Genturi/NewAlphaElectrical/README.md

# Alpha-Electrical
 Electronic hardware related files for the Alpha instrument
