Genturi/NewAlphaElectrical/NotesOnRev_1.docx

1. The package chosen for U1 on the layout is incorrect
2. The silkscreen for D1 is backward
