Genturi/NewAlphaElectrical/Notes/Jukka2_Notes.docx

Power supply: Mean Well: PSC-100B-C; Digi-key: 1866-3902-ND ($44.11)

This will set the
