Genturi/NewAlphaElectrical/EmppuInterface(Moondance 30-0006)/NotesOnRev_1.docx

Notes on Rev 1 of 30-0006

J4 uses the wrong pinout! Harwin connectors are pinned out sequentially on each side. The layout has them pinned out with odd numbers on one side and even numbers on the other side.
