Genturi/NewAlphaElectrical/SystemDesign/AlphaSubSystemEmppu_R1p2p0_101819.pdf

https://thestepperboardstore.com/products/ar-bc6d25eu-series-usb-six-motor-0-15-to-2-5-amp-current-regulating-stepper-motor-controllerhttps://thestepperboardstore.co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

https://www.digikey.com/product-detail/en/amphenol-icc-fci/LD09P13A4GX00LF/609-5183-ND/4997285https://www.digikey.com/product-detail/en/amphenol-icc-fci/LD09P13A4GX0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

https://www.digikey.com/product-detail/en/mean-well-usa-inc/IRM-60-24/1866-3067-ND/7704690

https://www.digikey.com/product-detail/en/mean-well-usa-inc/IRM-60-24/1866-3067-ND/7704690https://www.digikey.com/product-detail/en/mean-well-usa-inc/IRM-60-24/1866-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

https://www.digikey.com/product-detail/en/amphenol-icc-fci/LD09S13A4GX00LF/609-5189-ND/4997291

https://www.digikey.com/product-detail/en/amphenol-icc-fci/LD09S13A4GX00LF/609-5189-ND/4997291https://www.digikey.com/product-detail/en/amphenol-icc-fci/LD09S13A4GX0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

https://www.digikey.com/product-detail/en/amphenol-icc-fci/D15S33E4GX00LF/609-1499-ND/1001813https://www.digikey.com/product-detail/en/amphenol-icc-fci/D15S33E4GX00L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

https://www.digikey.com/product-detail/en/te-connectivity-amp-connectors/5-103635-4/A33864-ND/1122428https://www.digikey.com/product-detail/en/te-connectivity-amp-co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 8
https://www.digikey.com/product-detail/en/te-connectivity-amp-connectors/5-103635-4/A33864-ND/1122428https://www.digikey.com/product-detail/en/te-connectivity-amp-co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

https://www.mccdaq.com/usb-data-acquisition/USB-DIO24-Series.aspxhttps://www.mccdaq.com/usb-data-acquisition/USB-DIO24-Series.aspxhttps://www.mccdaq.com/usb-data-acq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

https://www.digikey.com/product-detail/en/sensata-crydom/DC60S3/CC1126-ND/221844https://www.digikey.com/product-detail/en/sensata-crydom/DC60S3/CC1126-ND/221844https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

http://www.l-com.com/usb-flanged-panel-mounted-usb-20-coupler-shielded-type-b-a-connectorshttp://www.l-com.com/usb-flanged-panel-mounted-usb-20-coupler-shielded-type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

http://www.l-com.com/usb-flanged-panel-mounted-usb-20-coupler-shielded-type-b-a-connectorshttps://www.digikey.com/product-detail/en/orion-fans/OA60EC-UR-1WB/1053-180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

https://www.digikey.com/product-detail/en/te-connectivity-amp-connectors/5-1814400-1/A97593-ND/1755981 81
https://www.digikey.com/product-detail/en/te-connectivity-amp-connectors/5-1814400-1/A97593-ND/1755981https://www.digikey.com/product-detail/en/te-connectivity-amp-c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

https://www.digikey.com/product-detail/en/amphenol-icc-fci/ICD15S13E4GX00LF/609-5181-ND/1536501https://www.digikey.com/product-detail/en/amphenol-icc-fci/ICD15S13E4G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

# Roll

# Pitch

# Yaw

X

Y

# Home

# Home

# Home

# Home

# Home

# 6 Axis Motor Controller Board

BC6D25 (https://thestepperboardstore.com/products/ar-bc6d25eu-series-usb-six-motor-0-15-to-2-5-amp-current-regulating-stepper-motor-controller)

Power Supply (https://www.digikey.com/product-detail/en/tdk-lambda-americas-inc/LS150-15/285-1812-ND/1918823)

# +15VDC @ 10A

D9 (https://www.digikey.com/product-detail/en/amphenol-icc-fci/LD09P13A4GX00LF/609-5183-ND/4997285)

# Conn

AC

# Power Input Module (https://www.digikey.com/products/en?keywords=708-2406-ND)

Power Supply (https://www.digikey.com/product-detail/en/mean-well-usa-inc/IRM-60-24/1866-3067-ND/7704690)

# +24 VDC @ 2A

USB-B (http://www.l-com.com/usb-flanged-panel-mounted-usb-20-coupler-shielded-type-b-a-connectors)

D-9 (https://www.digikey.com/product-detail/en/amphenol-icc-fci/LD09S13A4GX00LF/609-5189-ND/4997291)
RS-232

Nano-Positioning (https://www.digikey.com/product-detail/en/amphenol-icc-fci/LD09P13A4GX00LF/609-5183-ND/4997285)
Stage (DOF-5) (https://dovermotion.com/products/linear-stages/microscope-stages/objective-focusing-stage-dof-5/)

# Solenoid valve for cover lifter

# Cover Limit 1

# Cover Limit 2

# Cartridge Present

D15 (https://www.digikey.com/product-detail/en/amphenol-icc-fci/D15S33E4GX00LF/609-1499-ND/1001813)

# Conn

Power Supply (https://www.digikey.com/product-detail/en/mean-well-usa-inc/IRM-05-5/1866-3027-ND/7704652)

# +5 VDC @ 1A

# Ampmodu

MTE (https://www.digikey.com/product-detail/en/te-connectivity-amp-connectors/5-103635-4/A33864-ND/1122428) | Polygon Index (https://www.digikey.com/product-detail/en/te-connectivity-amp-connectors/5-103635-4/A33864-ND/1122428)

# USB-DIO24 (https://www.mccdaq.com/usb-data-acquisition/USB-DIO24-Series.aspx) Digital I/O

# Temperature Controller CN8DPt-224 (https://www.omega.com/en-us/search/?text=CN8DPT-224-C24-DC)

Power Supply (https://www.digikey.com/product-detail/en/tdk-lambda-americas-inc/LS50-24/285-1820-ND/1918831)

# 24 VDC

@ 2A

# Solid-State Relay (https://www.digikey.com/product-detail/en/sensata-crydom/DC60S3/CC1126-ND/221844)

# Panel mount Connector

# Panel mount Connector

USB-B (http://www.l-com.com/usb-flanged-panel-mounted-usb-20-coupler-shielded-type-b-a-connectors)

# Genturi Scanner Alpha

# Subsystem Emppu

# Rev 1.2.0

# Eric J. Schultz 10/18/2019

# Cartridge Heater

# Thermistor

Fan (https://www.digikey.com/product-detail/en/orion-fans/OA60EC-UR-1WB/1053-1809-ND/9380228)

SMA (https://www.digikey.com/product-detail/en/te-connectivity-amp-connectors/5-1814400-1/A97593-ND/1755981)

# Conn Polygon Index

D15m (https://www.digikey.com/product-detail/en/amphenol-icc-fci/ICD15S13E4GX00LF/609-5181-ND/1536501)

# Conn Ctrl Status

# To Troy

# 3-Stage Line

Filter (https://www.digikey.com/product-detail/en/schurter-inc/5500.2048/486-6367-ND/642780)

D-50 (https://www.digikey.com/product-detail/en/amphenol-icc-commercial-products/L77SDD50SC309/L77SDD50SC309-ND/4888745)
Connector (https://thestepperboardstore.com/products/ar-bc6d25eu-series-usb-six-motor-0-15-to-2-5-amp-current-regulating-stepper-motor-controller)

Motor (https://www.digikey.com/product-detail/en/amphenol-icc-commercial-products/L77SDD50SC309/L77SDD50SC309-ND/4888745)

# Interface Board

# Precision High-speed Comparator

# Drive & Interface
