Genturi/NewAlphaElectrical/SystemDesign/AlphaSubSystemEmppu_R1p5p0_110119.pdf

https://thestepperboardstore.com/products/ar-bc6d25eu-series-usb-six-motor-0-15-to-2-5-amp-current-regulating-stepper-motor-controllerhttps://thestepperboardstore.co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

https://www.digikey.com/products/en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

https://www.digikey.com/product-detail/en/mean-well-usa-inc/IRM-60-24/1866-3067-ND/7704690https://www.digikey.com/product-detail/en/mean-well-usa-inc/IRM-60-24/1866-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

https://www.digikey.com/product-detail/en/amphenol-icc-fci/D15S33E4GX00LF/609-1499-ND/1001813https://www.digikey.com/product-detail/en/amphenol-icc-fci/D15S33E4GX00L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

https://www.digikey.com/product-detail/en/te-connectivity-amp-connectors/5-103635-4/A33864-ND/1122428https://www.digikey.com/product-detail/en/te-connectivity-amp-co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

https://www.digikey.com/product-detail/en/sensata-crydom/DC60S3/CC1126-ND/221844https://www.digikey.com/product-detail/en/sensata-crydom/DC60S3/CC1126-ND/221844https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

https://www.digikey.com/product-detail/en/norcomp-inc/171-009-203L001/209FE-ND/858108https://www.digikey.com/product-detail/en/norcomp-inc/171-009-203L001/209FE-ND/8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

https://www.digikey.com/product-detail/en/te-connectivity-amp-connectors/5-1814400-1/A97593-ND/1755981https://www.digikey.com/product-detail/en/te-connectivity-amp-c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

https://www.digikey.com/product-detail/en/amphenol-icc-fci/ICD15S13E4GX00LF/609-5181-ND/1536501https://www.digikey.com/product-detail/en/amphenol-icc-fci/ICD15S13E4G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

https://www.digikey.com/product-detail/en/b-b-smartworx-inc/BB-USBHUB4OEM/1165-1059-ND/3045945https://www.digikey.com/product-detail/en/b-b-smartworx-inc/BB-USBHUB4O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

https://www.digikey.com/products/en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

https://www.digikey.com/products/en?keywords=DB9-USB-D5-F (https://www.digikey.com/product-detail/en/mean-well-usa-inc/IRM-05-5/1866-3027-ND/7704652) https://www.digikey.com/products/en?keywords=DB9-USB-D5-F (https://www.digikey.com/product-detail/en/mean-well-usa-inc/IRM-05-5/1866-3027-ND/7704652) https://www.digikey.com/products/en?keywords=DB9-USB-D5-F (https://www.digikey.com/product-detail/en/mean-well-usa-inc/IRM-05-5/1866-3027-ND/7704652) https://www.digikey.com/products/en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 (https://www.digikey.com/product-detail/en/mean-well-usa-inc/IRM-05-5/1866-3027-ND/7704652) https://www.digikey.com/products/en?keywords=DB9-USB-D5-F (https://www.digikey.com/product-detail/en/mean-well-usa-inc/IRM-05-5/1866-3027-ND/7704652) https://www.digikey.com/products/en?keywords=DB9-USB-D5-F (https://www.digikey.com/product-detail/en/mean-well-usa-inc/IRM-05-5/1866-3027-ND/7704652) https://www.digikey.com/products/en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

https://www.digikey.com/product-detail/en/norcomp-inc/173-E50-213R141/173-150FEA-ND/955555https://www.digikey.com/product-detail/en/norcomp-inc/173-E50-213R141/173-1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

# Roll

# Pitch

# Yaw

X

Y

# Home

# Home

# Home

# Home

# Home

# 6 Axis Motor Controller Board

BC6D25 (https://thestepperboardstore.com/products/ar-bc6d25eu-series-usb-six-motor-0-15-to-2-5-amp-current-regulating-stepper-motor-controller)

Power Supply (https://www.digikey.com/product-detail/en/tdk-lambda-americas-inc/LS150-15/285-1812-ND/1918823)

# +15VDC @ 10A

# 16pin (https://www.digikey.com/products/en?keywords=G125-MH11605L7P) Conn

AC

# Power Input Module (https://www.digikey.com/products/en?keywords=708-2406-ND)

Power Supply (https://www.digikey.com/product-detail/en/mean-well-usa-inc/IRM-60-24/1866-3067-ND/7704690)

# +24 VDC @ 2A

# Nano-Positioning (https://www.digikey.com/products/en?keywords=G125-MH11605L7P)

Stage (DOF-5) (https://dovermotion.com/products/linear-stages/microscope-stages/objective-focusing-stage-dof-5/) | Solenoid
valve | for

# cover lifter

Cylinder (https://www.digikey.com/product-detail/en/amphenol-icc-fci/D15S33E4GX00LF/609-1499-ND/1001813) Limit 1

# Cylinder Limit 2

# Cartridge Present

D15 (https://www.digikey.com/product-detail/en/amphenol-icc-fci/D15S33E4GX00LF/609-1499-ND/1001813)

# Conn

Power Supply (https://www.digikey.com/product-detail/en/mean-well-usa-inc/IRM-05-5/1866-3027-ND/7704652)

# +5 VDC @ 1A

# Ampmodu

MTE (https://www.digikey.com/product-detail/en/te-connectivity-amp-connectors/5-103635-4/A33864-ND/1122428) | Polygon Index (https://www.digikey.com/product-detail/en/te-connectivity-amp-connectors/5-103635-4/A33864-ND/1122428)

# USB-DIO24 (https://www.mccdaq.com/usb-data-acquisition/USB-DIO24-Series.aspx) Digital I/O

# Temperature Controller CN8DPt-224 (https://www.omega.com/en-us/search/?text=CN8DPT-224-C24-DC)

Power Supply (https://www.digikey.com/product-detail/en/tdk-lambda-americas-inc/LS50-24/285-1820-ND/1918831)

# 24 VDC

@ 2A

# Solid-State Relay (https://www.digikey.com/product-detail/en/sensata-crydom/DC60S3/CC1126-ND/221844)

D-9 (https://www.digikey.com/product-detail/en/norcomp-inc/171-009-203L001/209FE-ND/858108)

# Connector

J2

Genturi | Scanner | Alpha

# Subsystem Emppu

| Rev 1.5.0
Eric J. Schultz | 11/01/2019

# Thermistor

Fan (https://www.digikey.com/product-detail/en/orion-fans/OA60EC-UR-1WB/1053-1809-ND/9380228)

SMA (https://www.digikey.com/product-detail/en/te-connectivity-amp-connectors/5-1814400-1/A97593-ND/1755981)

# Conn Polygon Index

D15m (https://www.digikey.com/product-detail/en/amphenol-icc-fci/ICD15S13E4GX00LF/609-5181-ND/1536501)

# Conn Ctrl Status

# To Troy

# 3-Stage Line

Filter (https://www.digikey.com/product-detail/en/schurter-inc/5500.2048/486-6367-ND/642780)

D-37 (https://www.digikey.com/product-detail/en/norcomp-inc/171-037-203L001/237FE-ND/858162)

# Connector

J1

# Motor Interface Board

# Precision High-speed Comparator

# Drive & Interface

# USB Bulkhead

Hub (https://www.digikey.com/product-detail/en/b-b-smartworx-inc/BB-USBHUB4OEM/1165-1059-ND/3045945)

# USB to RS-232 (https://www.digikey.com/products/en?keywords=DB9-USB-D5-F)

# Cartridge Heater Assy

# Heater

# Air Cylinder Limit Sensors

# Solenoid drive

# Cartridge Present Sensor

D-50
Connector (https://www.digikey.com/product-detail/en/norcomp-inc/173-E50-213R141/173-150FEA-ND/955555)

USB-B (http://www.l-com.com/usb-flanged-panel-mounted-usb-20-coupler-shielded-type-b-a-connectors)
