Genturi/NewAlphaElectrical/SystemDesign/AlphaSubsystemJukka_R1p0p0_092719.pdf

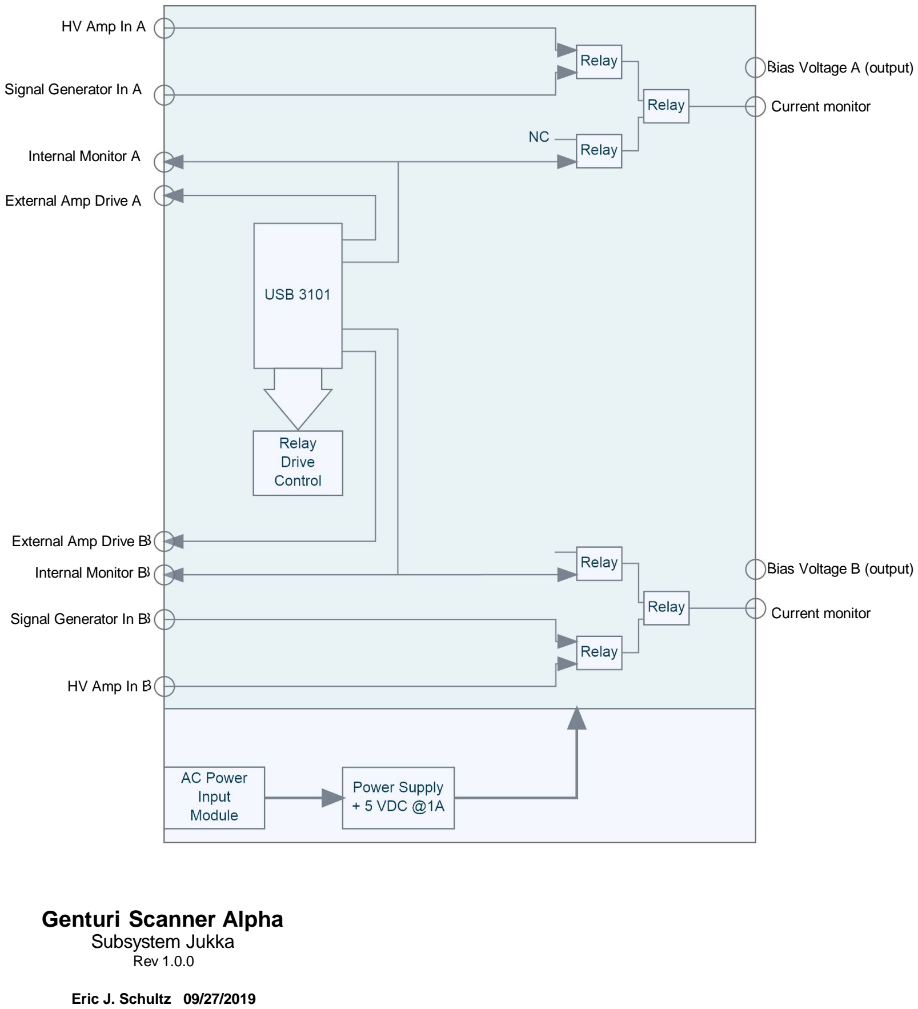
[picture p2: page 1]

USB 3101

Relay

Relay

Relay

Current monitor

Bias Voltage A (output)

Relay

Relay

Relay

Current monitor

Bias Voltage B (output)

Relay
Drive
Control

Power Supply
+ 5 VDC @1A

AC Power
Input
Module

External Amp Drive A

Internal Monitor A

Signal Generator In A

HV Amp In A

NC

External Amp Drive B

Internal Monitor B

Signal Generator In B

HV Amp In B

## Genturi Scanner Alpha

### Subsystem Jukka

Rev 1.0.0

Eric J. Schultz 09/27/2019
