Genturi/NewAlphaElectrical/SystemDesign/AlphaSubsystemJukka_R1p2p0_192219.pdf

https://www.mccdaq.com/usb-data-acquisition/USB-3100-Series.aspxhttps://www.mccdaq.com/usb-data-acquisition/USB-3100-Series.aspxhttps://www.mccdaq.com/usb-data-acqui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 5979 5979 5979 5979 5979 5979 5979 5979 5979 5979 5979 5979 5979 5979 5979 5979 5979 5979 5979 5979 5979 5979 5979 5979 5979 5979 5979 5979 5979 5979 5979 5979 5979 5979 5979 5979 5979 5979 5979 5979 5979 5979

https://www.digikey.com/product-detail/en/omron-electronics-inc-emc-div/G6E-134P-US-DC5/Z3668-ND/181 5979 5979 5979 5979 5979 5979 5979 5979 5979 5979 5979 5979 5979 5979 5979 5979 5979 5979 5979 5979 5979 5979 5979 5979 5979 5979 5979 5979 5979 5979 5979 5979 5979 5979 5979 5979 5979 5979 5979 5979 5979 5979 https://www.digikey.com/product-detail/en/omron-electronics-inc-emc-div/G6E-134P-US-DC5/Z3668-ND/181 5979 5979 5979 5979 5979 5979 5979 5979 5979 5979 5979 5979 5979 5979 5979 5979 5979 5979 5979 5979 5979 5979 5979 5979 5979 5979 5979 5979 5979 5979 5979 5979 5979 5979 5979 5979 5979 5979 5979 5979 5979 5979

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

https://www.digikey.com/product-detail/en/omron-electronics-inc-emc-div/G6E-134P-US-DC5/Z3668-ND/181 5979 5979 5979 5979 5979 5979 5979 5979 5979 5979 5979 5979 5979 5979 5979 5979 5979 5979 5979 5979 5979 5979 5979 5979 5979 5979 5979 5979 5979 5979 5979 5979 5979 5979 5979 5979 5979 5979 5979 5979 5979 5979

https://www.digikey.com/product-detail/en/omron-electronics-inc-emc-div/G6E-134P-US-DC5/Z3668-ND/181 5979 5979 5979 5979 5979 5979 5979 5979 5979 5979 5979 5979 5979 5979 5979 5979 5979 5979 5979 5979 5979 5979 5979 5979 5979 5979 5979 5979 5979 5979 5979 5979 5979 5979 5979 5979 5979 5979 5979 5979 5979 5979 https://www.digikey.com/product-detail/en/omron-electronics-inc-emc-div/G6E-134P-US-DC5/Z3668-ND/181 5979 5979 5979 5979 5979 5979 5979 5979 5979 5979 5979 5979 5979 5979 5979 5979 5979 5979 5979 5979 5979 5979 5979 5979 5979 5979 5979 5979 5979 5979 5979 5979 5979 5979 5979 5979 5979 5979 5979 5979 5979 5979

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

https://www.digikey.com/product-detail/en/cui-inc/PSK-S5B-5-T/102-5182-ND/9817114https://www.digikey.com/product-detail/en/cui-inc/PSK-S5B-5-T/102-5182-ND/9817114htt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

# USB 3101 (https://www.mccdaq.com/usb-data-acquisition/USB-3100-Series.aspx)

# Relay

# Relay

Relay (https://www.digikey.com/product-detail/en/omron-electronics-inc-emc-div/G6E-134P-US-DC5/Z3668-ND/1815979)

# Current monitor

Bias Voltage A (output) (https://www.digikey.com/product-detail/en/te-connectivity-amp-connectors/5-1814400-1/A97593-ND/1755981)

# Relay

# Relay

Relay (https://www.digikey.com/product-detail/en/omron-electronics-inc-emc-div/G6E-134P-US-DC5/Z3668-ND/1815979)

# Current monitor

Bias Voltage B (output) (https://www.digikey.com/product-detail/en/te-connectivity-amp-connectors/5-1814400-1/A97593-ND/1755981)

# Relay Drive Control

# Power Supply + 5 VDC @1A

# AC Power Input Module

# External Amp Drive A

# Internal Monitor A

# Signal Generator In A

# HV Amp In A

NC

# External Amp Drive B

# Internal Monitor B

# Signal Generator In B

# HV Amp In B

# Genturi Scanner Alpha

# Subsystem Jukka

# Rev 1.2.0

# Eric J. Schultz 10/22/2019

# USB Conn
