Genturi/NewAlphaElectrical/SystemDesign/AlphaSubsystemJukka_R1p4p0_112019.pdf

https://www.mccdaq.com/usb-data-acquisition/USB-3100-Series.aspxhttps://www.mccdaq.com/usb-data-acquisition/USB-3100-Series.aspxhttps://www.mccdaq.com/usb-data-acqui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 5979 5979 5979 5979 5979 5979 5979 5979 5979 5979 5979 5979 5979 5979 5979 5979 5979 5979 5979 5979 5979 5979 5979 5979 5979 5979 5979 5979 5979 5979 5979 5979 5979 5979 5979 5979 5979 5979 5979 5979 5979 5979

https://www.digikey.com/product-detail/en/omron-electronics-inc-emc-div/G6E-134P-US-DC5/Z3668-ND/181 5979 5979 5979 5979 5979 5979 5979 5979 5979 5979 5979 5979 5979 5979 5979 5979 5979 5979 5979 5979 5979 5979 5979 5979 5979 5979 5979 5979 5979 5979 5979 5979 5979 5979 5979 5979 5979 5979 5979 5979 5979 5979 Relay

| https://www.digikey.com/product-detail/en/omron-electronics-inc-emc-div/G6E-134P-US-DC5/Z3668-ND/181 5979 5979 5979 5979 5979 5979 5979 5979 5979 5979 5979 5979 5979 5979 5979 5979 5979 5979 5979 5979 5979 5979 5979 5979 5979 5979 5979 5979 5979 5979 5979 5979 5979 5979 5979 5979 5979 5979 5979 5979 5979 5979 Relay (https://www.digikey.com/product-detail/en/omron-electronics-inc-emc-div/G6E-134P-US-DC5/Z3668-ND/1815979)

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
| h t t p s : / / w w w . d i g i k | e | y | . | c | o | m / | p | r o d u c t - d e t a i l / e n / | m o | l | e | x | / | 0 | 0 | 2 2 0 5 3 0 4 1 / W M 4 3 0 2 - N | D | / | 2 | 6 | 6 | 9 | 3
| h t t p s : / / w w w . d i g i k | e | y | . | c | o | m / | p | r o d u c t - d e t a i l / e n / | m o | l | e | x | / | 0 | 0 | 2 2 0 5 3 0 4 1 / W M 4 3 0 2 - N | D | / | 2 | 6 | 6 | 9 | 3
| h t t p s : / / w w w . d i g i k | e | y | . | c | o | m / | p | r o d u c t - d e t a i l / e n / | m o | l | e | x | / | 0 | 0 | 2 2 0 5 3 0 4 1 / W M 4 3 0 2 - N | D | / | 2 | 6 | 6 | 9 | 3
| h t t p s : / / w w w . d i g i k | e | y | . | c | o | m / | p | r o d u c t - d e t a i l / e n / | m o | l | e | x | / | 0 | 0 | 2 2 0 5 3 0 4 1 / W M 4 3 0 2 - N | D | / | 2 | 6 | 6 | 9 | 3
| h t t p s : / / w w w . d i g i k | e | y | . | c | o | m / | p | r o d u c t - d e t a i l / e n / | m o | l | e | x | / | 0 | 0 | 2 2 0 5 3 0 4 1 / W M 4 3 0 2 - N | D | / | 2 | 6 | 6 | 9 | 3
| h t t p s : / / w w w . d i g i k | e | y | . | c | o | m / | p | r o d u c t - d e t a i l / e n / | m o | l | e | x | / | 0 | 0 | 2 2 0 5 3 0 4 1 / W M 4 3 0 2 - N | D | / | 2 | 6 | 6 | 9 | 3
| h t t p s : / / w w w . d i g i k | e | y | . | c | o | m / | p | r o d u c t - d e t a i l / e n / | m o | l | e | x | / | 0 | 0 | 2 2 0 5 3 0 4 1 / W M 4 3 0 2 - N | D | / | 2 | 6 | 6 | 9 | 3
| h t t p s : / / w w w . d i g i k | e | y | . | c | o | m / | p | r o d u c t - d e t a i l / e n / | m o | l | e | x | / | 0 | 0 | 2 2 0 5 3 0 4 1 / W M 4 3 0 2 - N | D | / | 2 | 6 | 6 | 9 | 3
| h t t p s : / / w w w . d i g i k | e | y | . | c | o | m / | p | r o d u c t - d e t a i l / e n / | m o | l | e | x | / | 0 | 0 | 2 2 0 5 3 0 4 1 / W M 4 3 0 2 - N | D | / | 2 | 6 | 6 | 9 | 3

# USB 3101 (https://www.mccdaq.com/usb-data-acquisition/USB-3100-Series.aspx)

# Relay

Relay (https://www.digikey.com/product-detail/en/omron-electronics-inc-emc-div/G6E-134P-US-DC5/Z3668-ND/1815979)

# Current monitor

Bias Voltage A (output) (https://www.digikey.com/product-detail/en/te-connectivity-amp-connectors/5-1814400-1/A97593-ND/1755981)

# Relay Current monitor

Bias Voltage B (output) (https://www.digikey.com/product-detail/en/te-connectivity-amp-connectors/5-1814400-1/A97593-ND/1755981)

# Relay Drive Control

# Power Supply + 5 VDC @1A

# AC Power Input Module

# External Amp Drive A

# Internal Monitor A

# Signal Generator In A

# HV Amp In A

NC

# External Amp Drive B

# Internal Monitor B

# Signal Generator In B

# HV Amp In B

Genturi | Scanner Alpha
Subsystem | Jukka

# Rev 1.4.0

# Eric J. Schultz 11/20/2019

# USB Conn

Micro-fit 3.0 | 4-Pos KK
