Genturi/NewAlphaElectrical/SystemDesign/AlphaSubsystemMarco_R1p1p0_102119.pdf

https://www.mccdaq.com/usb-data-acquisition/USB-3100-Series.aspx

https://www.mccdaq.com/usb-data-acquisition/USB-3100-Series.aspxhttps://www.mccdaq.com/usb-data-acquisition/USB-3100-Series.aspxhttps://www.mccdaq.com/usb-data-acqui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

https://www.digikey.com/product-detail/en/sl-power-electronics-manufacture-of-condor-ault-brands/HBB15-1.5-A-G/271-2280-ND/1035138https://www.digikey.com/product-det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 15-1.5 (https://www.digikey.com/product-detail/en/sl-power-electronics-manufacture-of-condor-ault-brands/HBB15-1.5-A-G/271-2280-ND/1035138)-A-G/271-2280-ND/1035138 https://www.digikey.com/product-detail/en/sl-power-electronics-manufacture-of-condor-ault-brands/HBB15-1.5-A-G/271-2280-ND/1035138https://www.digikey.com/product-det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

https://www.digikey.com/products/en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

https://www.digikey.com/products/en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

https://www.digikey.com/products/en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

https://www.digikey.com/products/en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

https://www.digikey.com/product-detail/en/amphenol-icc-fci/LD09S33E4GX00LF/609-5193-ND/4997295

https://www.digikey.com/product-detail/en/amphenol-icc-fci/LD09S33E4GX00LF/609-5193-ND/4997295https://www.digikey.com/product-detail/en/amphenol-icc-fci/LD09S33E4GX0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

https://www.digikey.com/product-detail/en/amphenol-icc-fci/LD09S33E4GX00LF/609-5193-ND/4997295https://www.digikey.com/product-detail/en/amphenol-icc-fci/LD09S33E4GX0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

https://www.digikey.com/product-detail/en/amphenol-icc-fci/LD09S33E4GX00LF/609-5193-ND/4997295

https://www.digikey.com/product-detail/en/amphenol-icc-fci/LD09S33E4GX00LF/609-5193-ND/4997295https://www.digikey.com/product-detail/en/amphenol-icc-fci/LD09S33E4GX0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

https://www.digikey.com/product-detail/en/amphenol-icc-fci/LD09S33E4GX00LF/609-5193-ND/4997295https://www.digikey.com/product-detail/en/amphenol-icc-fci/LD09S33E4GX0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 https://www.digikey.com/product-detail/en/amphenol-rf-division/132170/ACX1244-ND/1011921https://www.digikey.com/product-detail/en/amphenol-rf-division/132170/ACX1244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

https://www.digikey.com/product-detail/en/amphenol-rf-division/132170/ACX1244-ND/1011921
https://www.digikey.com/product-detail/en/amphenol-rf-division/132170/ACX1244-ND/1011921
https://www.digikey.com/product-detail/en/amphenol-rf-division/132170/ACX1244-ND/1011921

https://www.femto.de/en/products/current-amplifiers/fixed-gain-up-to-400-mhz-hca.html

https://www.femto.de/en/products/current-amplifiers/fixed-gain-up-to-400-mhz-hca.htmlhttps://www.femto.de/en/products/current-amplifiers/fixed-gain-up-to-400-mhz-hca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

https://www.femto.de/en/products/current-amplifiers/fixed-gain-up-to-400-mhz-hca.htmlhttps://www.femto.de/en/products/current-amplifiers/fixed-gain-up-to-400-mhz-hca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

https://www.femto.de/en/products/current-amplifiers/fixed-gain-up-to-400-mhz-hca.htmlhttps://www.femto.de/en/products/current-amplifiers/fixed-gain-up-to-400-mhz-hca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

https://www.digikey.com/product-detail/en/amphenol-rf-division/132170/ACX1244-ND/1011921https://www.digikey.com/product-detail/en/amphenol-rf-division/132170/ACX1244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 https://www.digikey.com/product-detail/en/amphenol-rf-division/132170/ACX1244-ND/1011921https://www.digikey.com/product-detail/en/amphenol-rf-division/132170/ACX1244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
https://www.digikey.com/product-detail/en/amphenol-rf-division/132170/ACX1244-ND/1011921

https://www.digikey.com/product-detail/en/amphenol-rf-division/132170/ACX1244-ND/1011921
https://www.digikey.com/product-detail/en/amphenol-rf-division/132170/ACX1244-ND/1011921

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

https://www.femto.de/en/products/current-amplifiers/fixed-gain-up-to-400-mhz-hca.htmlhttps://www.femto.de/en/products/current-amplifiers/fixed-gain-up-to-400-mhz-hca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

https://www.digikey.com/product-detail/en/amphenol-rf-division/132170/ACX1244-ND/1011921https://www.digikey.com/product-detail/en/amphenol-rf-division/132170/ACX1244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

http://krfilters.com/filter-docs/3070-SMA.pdfhttps://www.digikey.com/product-detail/en/amphenol-rf-division/132170/ACX1244-ND/1011921https://www.digikey.com/product-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

https://www.femto.de/en/products/current-amplifiers/fixed-gain-up-to-400-mhz-hca.htmlhttps://www.digikey.com/product-detail/en/amphenol-rf-division/132170/ACX1244-ND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

https://www.digikey.com/product-detail/en/amphenol-icc-fci/ICD15S13E4GX00LF/609-5181-ND/1536501https://www.digikey.com/product-detail/en/amphenol-icc-fci/ICD15S13E4G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 tf4lob%252Bxoo8%3D
https://www.mouser.com/ProductDetail/Hirose-Connector/ST60-24P30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

https://www.digikey.com/product-detail/en/te-connectivity-amp-connectors/5-1814400-1/A97593-ND/1755981https://www.digikey.com/product-detail/en/te-connectivity-amp-c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 81
https://www.digikey.com/product-detail/en/te-connectivity-amp-connectors/5-1814400-1/A97593-ND/1755981

https://www.digikey.com/products/en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

https://www.digikey.com/products/en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

http://www.l-com.com/usb-flanged-panel-mounted-usb-20-coupler-shielded-type-b-a-connectorshttp://www.l-com.com/usb-flanged-panel-mounted-usb-20-coupler-shielded-type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

https://www.digikey.com/product-detail/en/schurter-inc/5500.2048/486-6367-ND/642780https://www.digikey.com/product-detail/en/schurter-inc/5500.2048/486-6367-ND/64278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

https://www.digikey.com/product-detail/en/schurter-inc/5500.2048/486-6367-ND/642780https://www.digikey.com/product-detail/en/schurter-inc/5500.2048/486-6367-ND/64278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

# USB-3101 (https://www.mccdaq.com/usb-data-acquisition/USB-3100-Series.aspx) Analog & Digital I/O

# Linear Power Supply 15 VDC @ 1.5A Condor

HBB15-1.5-A+ (https://www.digikey.com/product-detail/en/sl-power-electronics-manufacture-of-condor-ault-brands/HBB15-1.5-A-G/271-2280-ND/1035138)G (https://www.digikey.com/product-detail/en/sl-power-electronics-manufacture-of-condor-ault-brands/HBB15-1.5-A-G/271-2280-ND/1035138)

# Linear Power Supply +5 VDC @ 3A Condor

HB5-3- (https://www.digikey.com/products/en?keywords=HB5-3-OV-A%2BG)O (https://www.digikey.com/products/en?keywords=HB5-3-OV-A%2BG)V-A+ (https://www.digikey.com/products/en?keywords=HB5-3-OV-A%2BG)G (https://www.digikey.com/products/en?keywords=HB5-3-OV-A%2BG)

# 400 MHz Amplifier Femto

H (https://www.femto.de/en/products/current-amplifiers/fixed-gain-up-to-400-mhz-hca.html)C (https://www.femto.de/en/products/current-amplifiers/fixed-gain-up-to-400-mhz-hca.html)A-400M-5K- (https://www.femto.de/en/products/current-amplifiers/fixed-gain-up-to-400-mhz-hca.html)C (https://www.femto.de/en/products/current-amplifiers/fixed-gain-up-to-400-mhz-hca.html)

D9 (https://www.digikey.com/product-detail/en/amphenol-icc-fci/LD09S33E4GX00LF/609-5193-ND/4997295)

# Conn

+5 VD (https://www.digikey.com/product-detail/en/amphenol-icc-fci/LD09S33E4GX00LF/609-5193-ND/4997295)C (https://www.digikey.com/product-detail/en/amphenol-icc-fci/LD09S33E4GX00LF/609-5193-ND/4997295)

# PMT Ctrl

D9 (https://www.digikey.com/product-detail/en/amphenol-icc-fci/LD09S33E4GX00LF/609-5193-ND/4997295)

# Conn

+5 VD (https://www.digikey.com/product-detail/en/amphenol-icc-fci/LD09S33E4GX00LF/609-5193-ND/4997295)C (https://www.digikey.com/product-detail/en/amphenol-icc-fci/LD09S33E4GX00LF/609-5193-ND/4997295)

# PMT Ctrl

D9 (https://www.digikey.com/product-detail/en/amphenol-icc-fci/LD09S33E4GX00LF/609-5193-ND/4997295)

# Conn

+5 VDC (https://www.digikey.com/product-detail/en/amphenol-icc-fci/LD09S33E4GX00LF/609-5193-ND/4997295)

# PMT Ctrl

D9 (https://www.digikey.com/product-detail/en/amphenol-icc-fci/LD09S33E4GX00LF/609-5193-ND/4997295)

# Conn

+5 VD (https://www.digikey.com/product-detail/en/amphenol-icc-fci/LD09S33E4GX00LF/609-5193-ND/4997295)C (https://www.digikey.com/product-detail/en/amphenol-icc-fci/LD09S33E4GX00LF/609-5193-ND/4997295)

# PMT Ctrl

# SMA

Bulkhead (https://www.digikey.com/product-detail/en/amphenol-rf-division/132170/ACX1244-ND/1011921)

# to RG174

SMA to BNC | RG174 to BNC

# 200 MHz (http://krfilters.com/filter-docs/3070-SMA.pdf) Filter

# SMA

Bulkhead (https://www.digikey.com/product-detail/en/amphenol-rf-division/132170/ACX1244-ND/1011921)

# to RG174

SMA to RG174 (https://www.digikey.com/product-detail/en/amphenol-rf-division/132170/ACX1244-ND/1011921) | PMT Ch A (https://www.digikey.com/product-detail/en/amphenol-rf-division/132170/ACX1244-ND/1011921)

# 15 VDC

# 400 MHz Amplifier Femto

H (https://www.femto.de/en/products/current-amplifiers/fixed-gain-up-to-400-mhz-hca.html)C (https://www.femto.de/en/products/current-amplifiers/fixed-gain-up-to-400-mhz-hca.html)A-400M-5K- (https://www.femto.de/en/products/current-amplifiers/fixed-gain-up-to-400-mhz-hca.html)C (https://www.femto.de/en/products/current-amplifiers/fixed-gain-up-to-400-mhz-hca.html)

# SMA

Bulkhead (https://www.digikey.com/product-detail/en/amphenol-rf-division/132170/ACX1244-ND/1011921)

# to RG174

SMA to BNC | RG174 to BNC

# 200 MHz (http://krfilters.com/filter-docs/3070-SMA.pdf) Filter

# SMA

Bulkhead (https://www.digikey.com/product-detail/en/amphenol-rf-division/132170/ACX1244-ND/1011921)

# to RG174

SMA to RG174 (https://www.digikey.com/product-detail/en/amphenol-rf-division/132170/ACX1244-ND/1011921) | PMT Ch B (https://www.digikey.com/product-detail/en/amphenol-rf-division/132170/ACX1244-ND/1011921)

# 15 VDC

# 400 MHz Amplifier Femto

HCA-400M-5K-C (https://www.femto.de/en/products/current-amplifiers/fixed-gain-up-to-400-mhz-hca.html)

# SMA

Bulkhead (https://www.digikey.com/product-detail/en/amphenol-rf-division/132170/ACX1244-ND/1011921)

# to RG174

SMA to BNC | RG174 to BNC

# 200 MHz (http://krfilters.com/filter-docs/3070-SMA.pdf) Filter

# SMA

Bulkhead (https://www.digikey.com/product-detail/en/amphenol-rf-division/132170/ACX1244-ND/1011921)

# to RG174

S (https://www.digikey.com/product-detail/en/amphenol-rf-division/132170/ACX1244-ND/1011921)MA to RG174 (https://www.digikey.com/product-detail/en/amphenol-rf-division/132170/ACX1244-ND/1011921) | PMT Ch C (https://www.digikey.com/product-detail/en/amphenol-rf-division/132170/ACX1244-ND/1011921)

# 15 VDC

# 400 MHz Amplifier Femto

H (https://www.femto.de/en/products/current-amplifiers/fixed-gain-up-to-400-mhz-hca.html)C (https://www.femto.de/en/products/current-amplifiers/fixed-gain-up-to-400-mhz-hca.html)A-400M-5K- (https://www.femto.de/en/products/current-amplifiers/fixed-gain-up-to-400-mhz-hca.html)C (https://www.femto.de/en/products/current-amplifiers/fixed-gain-up-to-400-mhz-hca.html)

# SMA

Bulkhead (https://www.digikey.com/product-detail/en/amphenol-rf-division/132170/ACX1244-ND/1011921)

# to RG174

SMA to BNC | RG174 to BNC 200 MHz

# Filter

# SMA

Bulkhead (https://www.digikey.com/product-detail/en/amphenol-rf-division/132170/ACX1244-ND/1011921)

# to RG174

SMA to RG174 (https://www.digikey.com/product-detail/en/amphenol-rf-division/132170/ACX1244-ND/1011921) | PMT Ch D (https://www.digikey.com/product-detail/en/amphenol-rf-division/132170/ACX1244-ND/1011921)

# 15 VDC

# Hybrid Bulkhead Conn

# 200 MHz

Filter? | SOS

# Hybrid Bulkhead Conn

# 200 MHz

Filter? | Ronchi Rule

D15 (https://www.digikey.com/product-detail/en/amphenol-icc-fci/ICD15S13E4GX00LF/609-5181-ND/1536501)

# Con

# HiRose

S (https://www.mouser.com/ProductDetail/Hirose-Connector/ST60-24P30)T-60-24 (https://www.mouser.com/ProductDetail/Hirose-Connector/ST60-24P30)

# Polygon Clock

# FPGA Trigger

# SOS

# Ronchi Rule

# Precision high-speed comparators

Level (https://www.digikey.com/product-detail/en/amphenol-icc-fci/ICD15S13E4GX00LF/609-5181-ND/1536501)

# shifter & Driver

# Polygon Index

Scanner Sync.

S (https://www.digikey.com/product-detail/en/te-connectivity-amp-connectors/5-1814400-1/A97593-ND/1755981)MA (https://www.digikey.com/product-detail/en/te-connectivity-amp-connectors/5-1814400-1/A97593-ND/1755981)

# Con Polygon Index

AC

# Power Input Module

# USB-B

# Voltage limit

&

# filter

# Filtering

# 15 VDC Amp Power

# Genturi Scanner Alpha

# Subsystem Marco

# Rev 1.1.0

# Eric J. Schultz 10/21/2019

2.5V

# Power

# 3-Stage Line Filter
