Genturi/NewAlphaElectrical/SystemDesign/AlphaSubsystemMarco_R1p3p0_112119.pdf

https://www.mccdaq.com/usb-data-acquisition/USB-3100-Series.aspxhttps://www.mccdaq.com/usb-data-acquisition/USB-3100-Series.aspxhttps://www.mccdaq.com/usb-data-acqui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

https://www.digikey.com/product-detail/en/amphenol-icc-fci/LD09S33E4GX00LF/609-5193-ND/4997295https://www.digikey.com/product-detail/en/amphenol-icc-fci/LD09S33E4GX0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

https://www.digikey.com/product-detail/en/amphenol-icc-fci/LD09S33E4GX00LF/609-5193-ND/4997295https://www.digikey.com/product-detail/en/amphenol-icc-fci/LD09S33E4GX0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

https://www.digikey.com/product-detail/en/amphenol-icc-fci/LD09S33E4GX00LF/609-5193-ND/4997295https://www.digikey.com/product-detail/en/amphenol-icc-fci/LD09S33E4GX0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

https://www.femto.de/en/products/current-amplifiers/fixed-gain-up-to-400-mhz-hca.htmlhttps://www.femto.de/en/products/current-amplifiers/fixed-gain-up-to-400-mhz-hca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
https://www.digikey.com/product-detail/en/amphenol-rf-division/132170/ACX1244-ND/1011921 | http://krfilters.com/filter-docs/3070-SMA.pdf
https://www.digikey.com/product-detail/en/amphenol-rf-division/132170/ACX1244-ND/1011921https://www.digikey.com/product-detail/en/amphenol-rf-division/132170/ACX1244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

https://www.digikey.com/products/en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

https://www.digikey.com/products/en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

https://www.digikey.com/product-detail/en/te-connectivity-amp-connectors/5-1814400-1/A97593-ND/1755981https://www.digikey.com/product-detail/en/te-connectivity-amp-c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

https://www.digikey.com/products/en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

# USB-3101 (https://www.mccdaq.com/usb-data-acquisition/USB-3100-Series.aspx) Analog & Digital I/O

# Linear

Power | Supply
15 VDC | @ 1.5A

# Condor

HBB15-1.5-A+G (https://www.digikey.com/product-detail/en/sl-power-electronics-manufacture-of-condor-ault-brands/HBB15-1.5-A-G/271-2280-ND/1035138)

# Linear

Power | Supply
+5 | VDC | @ 3A

# Condor HB5-3-OV-A+G (https://www.digikey.com/products/en?keywords=HB5-3-OV-A%2BG)

# 400 MHz Amplifier Femto

HCA-400M-5K-C (https://www.femto.de/en/products/current-amplifiers/fixed-gain-up-to-400-mhz-hca.html)

D9 (https://www.digikey.com/product-detail/en/amphenol-icc-fci/LD09S33E4GX00LF/609-5193-ND/4997295)

# Conn

+5 VDC (https://www.digikey.com/product-detail/en/amphenol-icc-fci/LD09S33E4GX00LF/609-5193-ND/4997295)

# PMT Ctrl

D9 (https://www.digikey.com/product-detail/en/amphenol-icc-fci/LD09S33E4GX00LF/609-5193-ND/4997295)

# Conn

+5 VDC (https://www.digikey.com/product-detail/en/amphenol-icc-fci/LD09S33E4GX00LF/609-5193-ND/4997295)

# PMT Ctrl

D9 (https://www.digikey.com/product-detail/en/amphenol-icc-fci/LD09S33E4GX00LF/609-5193-ND/4997295)

# Conn

+5 VDC (https://www.digikey.com/product-detail/en/amphenol-icc-fci/LD09S33E4GX00LF/609-5193-ND/4997295)

# PMT Ctrl

D9 (https://www.digikey.com/product-detail/en/amphenol-icc-fci/LD09S33E4GX00LF/609-5193-ND/4997295)

# Conn

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

# PMT Ctrl

# SMA

Bulkhead (https://www.digikey.com/product-detail/en/amphenol-rf-division/132170/ACX1244-ND/1011921)

# to RG174

SMA to | BNC | RG174 | to BNC
200 | MHz (http://krfilters.com/filter-docs/3070-SMA.pdf)

# Filter

# SMA

Bulkhead (https://www.digikey.com/product-detail/en/amphenol-rf-division/132170/ACX1244-ND/1011921)

# to RG174

SMA to | RG174 (https://www.digikey.com/product-detail/en/amphenol-rf-division/132170/ACX1244-ND/1011921) | PMT Ch A (https://www.digikey.com/product-detail/en/amphenol-rf-division/132170/ACX1244-ND/1011921)

# 15 VDC

# 400 MHz Amplifier Femto

HCA-400M-5K-C (https://www.femto.de/en/products/current-amplifiers/fixed-gain-up-to-400-mhz-hca.html)

# SMA

Bulkhead (https://www.digikey.com/product-detail/en/amphenol-rf-division/132170/ACX1244-ND/1011921)

# to RG174

SMA to | BNC | RG174 | to BNC
200 | MHz (http://krfilters.com/filter-docs/3070-SMA.pdf)

# Filter

# SMA

Bulkhead (https://www.digikey.com/product-detail/en/amphenol-rf-division/132170/ACX1244-ND/1011921)
to | RG174
SMA to | RG174 (https://www.digikey.com/product-detail/en/amphenol-rf-division/132170/ACX1244-ND/1011921) | PMT Ch B (https://www.digikey.com/product-detail/en/amphenol-rf-division/132170/ACX1244-ND/1011921)

# 15 VDC

# 400 MHz Amplifier Femto

HCA-400M-5K-C (https://www.femto.de/en/products/current-amplifiers/fixed-gain-up-to-400-mhz-hca.html)

# SMA

Bulkhead (https://www.digikey.com/product-detail/en/amphenol-rf-division/132170/ACX1244-ND/1011921)
to | RG174
SMA to | BNC | RG174 | to BNC
200 | MHz (http://krfilters.com/filter-docs/3070-SMA.pdf)

# Filter

# SMA

Bulkhead (https://www.digikey.com/product-detail/en/amphenol-rf-division/132170/ACX1244-ND/1011921)

# to RG174

SMA to | RG174 (https://www.digikey.com/product-detail/en/amphenol-rf-division/132170/ACX1244-ND/1011921) | PMT Ch C (https://www.digikey.com/product-detail/en/amphenol-rf-division/132170/ACX1244-ND/1011921)

# 15 VDC

# 400 MHz Amplifier Femto

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

# SMA

Bulkhead (https://www.digikey.com/product-detail/en/amphenol-rf-division/132170/ACX1244-ND/1011921)
to | RG174
SMA to | BNC | RG174 | to BNC 200 | MHz

# Filter

# SMA

Bulkhead (https://www.digikey.com/product-detail/en/amphenol-rf-division/132170/ACX1244-ND/1011921)

# to RG174

SMA to | RG174 (https://www.digikey.com/product-detail/en/amphenol-rf-division/132170/ACX1244-ND/1011921) | PMT Ch D (https://www.digikey.com/product-detail/en/amphenol-rf-division/132170/ACX1244-ND/1011921)

# 15 VDC

# USB Micro B (https://www.digikey.com/products/en?keywords=609-4613-1-ND) Female

# SOS (https://www.digikey.com/products/en?keywords=609-4613-1-ND)

# USB Micro B (https://www.digikey.com/products/en?keywords=609-4613-1-ND) Female

# Ronchi (https://www.digikey.com/products/en?keywords=609-4613-1-ND) Rule

D15 (https://www.digikey.com/product-detail/en/amphenol-icc-fci/ICD15S13E4GX00LF/609-5181-ND/1536501)

# Con

# HiRose ST-60-24 (https://www.mouser.com/ProductDetail/Hirose-Connector/ST60-24P30)

# Polygon Clock

# FPGA Trigger

# SOS

# Ronchi Rule

Level (https://www.digikey.com/product-detail/en/amphenol-icc-fci/ICD15S13E4GX00LF/609-5181-ND/1536501)

# shifter & Driver

# Polygon Index

Scanner Sync.

SMA (https://www.digikey.com/product-detail/en/te-connectivity-amp-connectors/5-1814400-1/A97593-ND/1755981)

# Con Polygon Index

AC

# Power Input Module (https://www.digikey.com/products/en?keywords=701W-X2%2F02)

USB-B (http://www.l-com.com/usb-flanged-panel-mounted-usb-20-coupler-shielded-type-b-a-connectors)

# Voltage limit

&

# filter

# Filtering

15 VDC | Amp Power
Genturi | Scanner | Alpha

# Subsystem Marco

# Rev 1.3.0

Eric | J. | Schultz | 11/21/2019

Micro-fit 3.0 (https://www.digikey.com/product-detail/en/molex/0430450800/WM1816-ND/252529)
2x4

Mini-fit jr (https://www.digikey.com/product-detail/en/molex/0026013115/WM13112-ND/4119889)
2x2
