Genturi/NewAlphaElectrical/SystemDesign/AlphaSubsystemTarja_R1p0p0_092719.pdf

https://www.coherent.com/lasers/laser/obis-single-laser-remotehttps://www.coherent.com/lasers/laser/obis-single-laser-remotehttps://www.coherent.com/lasers/laser/obi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

https://www.coherent.com/lasers/main/cw-solid-state-lasers/obis-lasers https://www.coherent.com/lasers/main/cw-solid-state-lasers/obis-lasers https://www.coherent.com/lasers/main/cw-solid-state-lasers/obis-lasers https://www.coherent.com/lasers/main/cw-solid-state-lasers/obis-lasers https://www.coherent.com/lasers/main/cw-solid-state-lasers/obis-lasers https://www.coherent.com/lasers/main/cw-solid-state-lasers/obis-lasers https://www.coherent.com/lasers/main/cw-solid-state-lasers/obis-lasers https://www.coherent.com/lasers/main/cw-solid-state-lasers/obis-lasers https://www.coherent.com/lasers/main/cw-solid-state-lasers/obis-lasers https://www.coherent.com/lasers/main/cw-solid-state-lasers/obis-lasers

https://www.digikey.com/product-detail/en/tdk-lambda-americas-inc/ZPSA6012/285-1841-ND/1963689https://www.digikey.com/product-detail/en/tdk-lambda-americas-inc/ZPSA6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
h t t p s : / / w w w . | d | i | g | i | k | e | y . c o m / p r o d u c t - d e t a | i | l | / | e | n | / | o | r i o n - f a n s / O A 6 0 E C - U | R | - | 1 | W B | / | 1 | 0 5 3 - 1 8 0 9 - N D / 9 3 8 0 2 2 | 8
h t t p s : / / w w w . | d | i | g | i | k | e | y . c o m / p r o d u c t - d e t a | i | l | / | e | n | / | o | r i o n - f a n s / O A 6 0 E C - U | R | - | 1 | W B | / | 1 | 0 5 3 - 1 8 0 9 - N D / 9 3 8 0 2 2 | 8
h t t p s : / / w w w . | d | i | g | i | k | e | y . c o m / p r o d u c t - d e t a | i | l | / | e | n | / | o | r i o n - f a n s / O A 6 0 E C - U | R | - | 1 | W B | / | 1 | 0 5 3 - 1 8 0 9 - N D / 9 3 8 0 2 2 | 8
h t t p s : / / w w w . | d | i | g | i | k | e | y . c o m / p r o d u c t - d e t a | i | l | / | e | n | / | o | r i o n - f a n s / O A 6 0 E C - U | R | - | 1 | W B | / | 1 | 0 5 3 - 1 8 0 9 - N D / 9 3 8 0 2 2 | 8 (https://www.digikey.com/product-detail/en/orion-fans/OA60EC-UR-1WB/1053-1809-ND/9380228)

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

# OBIS LX/LS Laser Remote (https://www.coherent.com/lasers/laser/obis-single-laser-remote)

# OBIS LX/LS (https://www.coherent.com/lasers/main/cw-solid-state-lasers/obis-lasers) Laser

Power Supply (https://www.digikey.com/product-detail/en/tdk-lambda-americas-inc/ZPSA6012/285-1841-ND/1963689)

# + 12 VDC @ 5A

# OBIS LX/LS (https://www.coherent.com/lasers/main/cw-solid-state-lasers/obis-lasers) Laser

# Power Entry Switch Module (https://www.digikey.com/products/en?keywords=708-2406-ND)

# 3-Stage

Line Filter (https://www.digikey.com/product-detail/en/schurter-inc/5500.2048/486-6367-ND/642780)

# Fan

Fan (https://www.digikey.com/product-detail/en/orion-fans/OA60EC-UR-1WB/1053-1809-ND/9380228)

# OBIS LX/LS Laser Remote (https://www.coherent.com/lasers/laser/obis-single-laser-remote)

# USB-B

Bulkhead (http://www.l-com.com/usb-flanged-panel-mounted-usb-20-coupler-shielded-type-b-a-connectors)

# Interface

# USB-B

Bulkhead (http://www.l-com.com/usb-flanged-panel-mounted-usb-20-coupler-shielded-type-b-a-connectors)

# Interface

# Inter-Lock Bulkhead Interface

# AC Line

# USB

# USB

# Interlock

# Fiber Optic

# Fiber Optic

# Genturi Scanner Alpha

# Subsystem Tarja

# Rev 1.0.0

# Eric J. Schultz 10/16/2019
