Genturi/NewAlphaElectrical/SystemDesign/MarcoRoughLayout.pdf

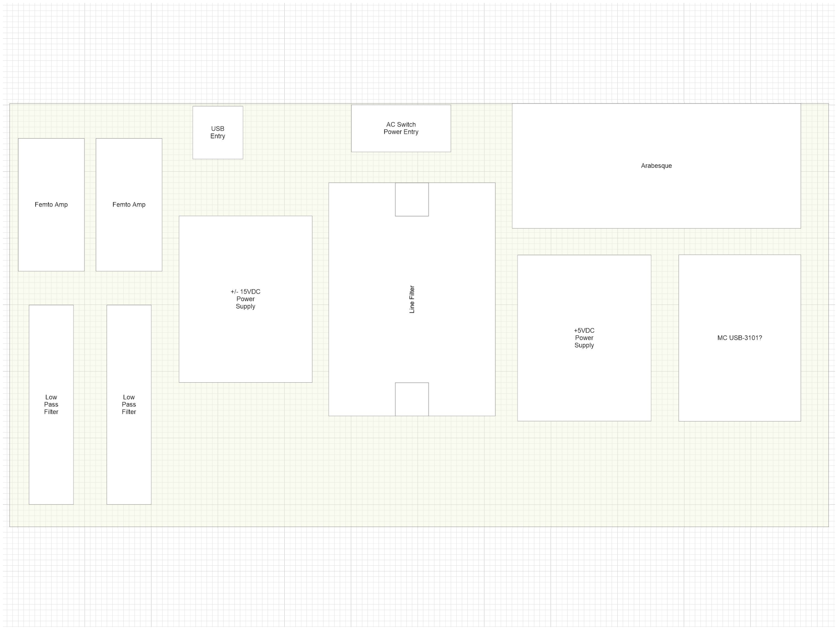
[picture p3: page 1]

Femto Amp

AC Switch
Power Entry USB
Entry

MC USB-3101?

+/- 15VDC
Power
Supply

+5VDC
Power
Supply

Arabesque

Femto Amp

Low
Pass
Filter

Low
Pass
Filter
