Genturi/NewAlphaElectrical/EmppuInterface(Moondance 30-0006)/MoondanceLayout(VeryCloseTo_1to1).docx

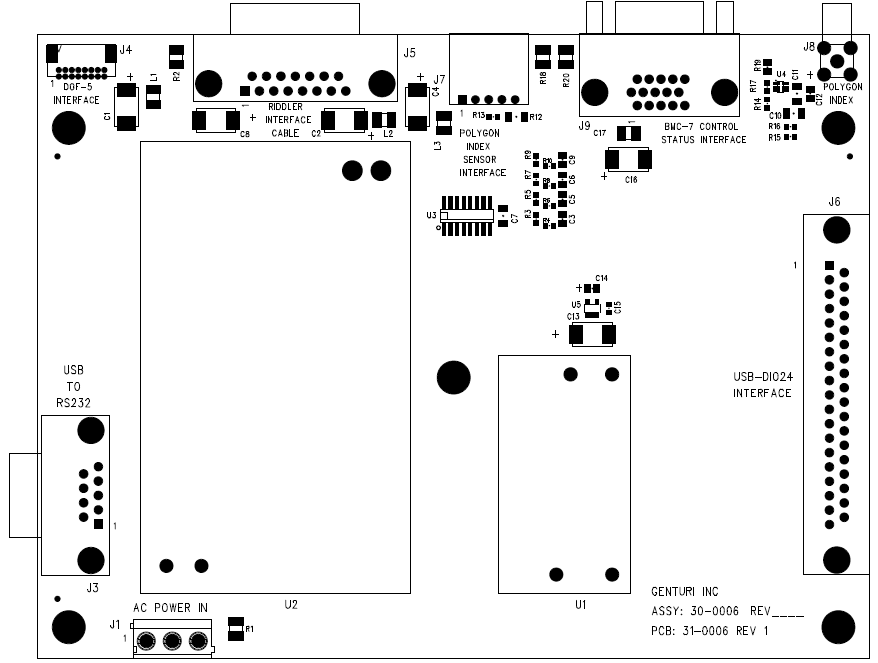
[picture p4: figure]
