Genturi/NewAlphaElectrical/SystemDesign/AlphaSubSystemTroy_R1p0p0_101619.pdf

https://www.digikey.com/products/en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

https://www.digikey.com/product-detail/en/te-connectivity-corcom-filters/10VN1/CCM1649-ND/361444 | https://www.digikey.com/products/en/power-supplies-external-internal-off-board/ac-dc-converters/133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

https://www.ti.com/store/ti/en/p/product/?p=ISO7761QDBQQ1 https://www.ti.com/store/ti/en/p/product/?p=ISO7761QDBQQ1 https://www.ti.com/store/ti/en/p/product/?p=ISO7761QDBQQ1 https://www.ti.com/store/ti/en/p/product/?p=ISO7761QDBQQ1 https://www.ti.com/store/ti/en/p/product/?p=ISO7761QDBQQ1 https://www.ti.com/store/ti/en/p/product/?p=ISO7761QDBQQ1 https://www.ti.com/store/ti/en/p/product/?p=ISO7761QDBQQ1

# https://www.ti.com/store/ti/en/p/product/?p=ISO7761QDBQQ1

https://www.digikey.com/product-detail/en/amphenol-icc-commercial-products/L717HDE15PD1CH4R/L717HDE15PD1CH4R-ND/4886540 https://www.digikey.com/product-detail/en/amphenol-icc-commercial-products/L717HDE15PD1CH4R/L717HDE15PD1CH4R-ND/4886540 https://www.digikey.com/product-detail/en/amphenol-icc-commercial-products/L717HDE15PD1CH4R/L717HDE15PD1CH4R-ND/4886540 https://www.digikey.com/product-detail/en/amphenol-icc-commercial-products/L717HDE15PD1CH4R/L717HDE15PD1CH4R-ND/4886540 https://www.digikey.com/product-detail/en/amphenol-icc-commercial-products/L717HDE15PD1CH4R/L717HDE15PD1CH4R-ND/4886540 https://www.digikey.com/product-detail/en/amphenol-icc-commercial-products/L717HDE15PD1CH4R/L717HDE15PD1CH4R-ND/4886540 https://www.digikey.com/product-detail/en/amphenol-icc-commercial-products/L717HDE15PD1CH4R/L717HDE15PD1CH4R-ND/4886540 https://www.digikey.com/product-detail/en/amphenol-icc-commercial-products/L717HDE15PD1CH4R/L717HDE15PD1CH4R-ND/4886540 https://www.digikey.com/product-detail/en/amphenol-icc-commercial-products/L717HDE15PD1CH4R/L717HDE15PD1CH4R-ND/4886540 https://www.digikey.com/product-detail/en/amphenol-icc-commercial-products/L717HDE15PD1CH4R/L717HDE15PD1CH4R-ND/4886540 https://www.digikey.com/product-detail/en/amphenol-icc-commercial-products/L717HDE15PD1CH4R/L717HDE15PD1CH4R-ND/4886540 https://www.digikey.com/product-detail/en/amphenol-icc-commercial-products/L717HDE15PD1CH4R/L717HDE15PD1CH4R-ND/4886540 https://www.digikey.com/product-detail/en/amphenol-icc-commercial-products/L717HDE15PD1CH4R/L717HDE15PD1CH4R-ND/4886540 https://www.digikey.com/product-detail/en/amphenol-icc-commercial-products/L717HDE15PD1CH4R/L717HDE15PD1CH4R-ND/4886540 https://www.digikey.com/product-detail/en/amphenol-icc-commercial-products/L717HDE15PD1CH4R/L717HDE15PD1CH4R-ND/4886540 https://www.digikey.com/product-detail/en/amphenol-icc-commercial-products/L717HDE15PD1CH4R/L717HDE15PD1CH4R-ND/4886540 https://www.digikey.com/product-detail/en/amphenol-icc-commercial-products/L717HDE15PD1CH4R/L717HDE15PD1CH4R-ND/4886540 https://www.digikey.com/product-detail/en/amphenol-icc-commercial-products/L717HDE15PD1CH4R/L717HDE15PD1CH4R-ND/4886540 https://www.digikey.com/product-detail/en/amphenol-icc-commercial-products/L717HDE15PD1CH4R/L717HDE15PD1CH4R-ND/4886540 https://www.digikey.com/product-detail/en/amphenol-icc-commercial-products/L717HDE15PD1CH4R/L717HDE15PD1CH4R-ND/4886540 https://www.digikey.com/product-detail/en/amphenol-icc-commercial-products/L717HDE15PD1CH4R/L717HDE15PD1CH4R-ND/4886540

h t t p s : / / w w w . d i g i k e y . c o m / p r o d u c t - d e t a i l / e n / a m p h e n o l - i c c - f c i / I C D 1 5 S 1 3 E 4 G X 0 0 L F / 6 0 9 - 5 1 8 1 - N D / 1 5 3 6 5 0 1 h t t p s : / / w w w . d i g i k e y . c o m / p r o d u c t - d e t a i l / e n / a m p h e n o l - i c c - f c i / I C D 1 5 S 1 3 E 4 G X 0 0 L F / 6 0 9 - 5 1 8 1 - N D / 1 5 3 6 5 0 1 h t t p s : / / w w w . d i g i k e y . c o m / p r o d u c t - d e t a i l / e n / a m p h e n o l - i c c - f c i / I C D 1 5 S 1 3 E 4 G X 0 0 L F / 6 0 9 - 5 1 8 1 - N D / 1 5 3 6 5 0 1 h t t p s : / / w w w . d i g i k e y . c o m / p r o d u c t - d e t a i l / e n / a m p h e n o l - i c c - f c i / I C D 1 5 S 1 3 E 4 G X 0 0 L F / 6 0 9 - 5 1 8 1 - N D / 1 5 3 6 5 0 1 h t t p s : / / w w w . d i g i k e y . c o m / p r o d u c t - d e t a i l / e n / a m p h e n o l - i c c - f c i / I C D 1 5 S 1 3 E 4 G X 0 0 L F / 6 0 9 - 5 1 8 1 - N D / 1 5 3 6 5 0 1 h t t p s : / / w w w . d i g i k e y . c o m / p r o d u c t - d e t a i l / e n / a m p h e n o l - i c c - f c i / I C D 1 5 S 1 3 E 4 G X 0 0 L F / 6 0 9 - 5 1 8 1 - N D / 1 5 3 6 5 0 1 h t t p s : / / w w w . d i g i k e y . c o m / p r o d u c t - d e t a i l / e n / a m p h e n o l - i c c - f c i / I C D 1 5 S 1 3 E 4 G X 0 0 L F / 6 0 9 - 5 1 8 1 - N D / 1 5 3 6 5 0 1 h t t p s : / / w w w . d i g i k e y . c o m / p r o d u c t - d e t a i l / e n / a m p h e n o l - i c c - f c i / I C D 1 5 S 1 3 E 4 G X 0 0 L F / 6 0 9 - 5 1 8 1 - N D / 1 5 3 6 5 0 1 h t t p s : / / w w w . d i g i k e y . c o m / p r o d u c t - d e t a i l / e n / a m p h e n o l - i c c - f c i / I C D 1 5 S 1 3 E 4 G X 0 0 L F / 6 0 9 - 5 1 8 1 - N D / 1 5 3 6 5 0 1 h t t p s : / / w w w . d i g i k e y . c o m / p r o d u c t - d e t a i l / e n / a m p h e n o l - i c c - f c i / I C D 1 5 S 1 3 E 4 G X 0 0 L F / 6 0 9 - 5 1 8 1 - N D / 1 5 3 6 5 0 1 h t t p s : / / w w w . d i g i k e y . c o m / p r o d u c t - d e t a i l / e n / a m p h e n o l - i c c - f c i / I C D 1 5 S 1 3 E 4 G X 0 0 L F / 6 0 9 - 5 1 8 1 - N D / 1 5 3 6 5 0 1 h t t p s : / / w w w . d i g i k e y . c o m / p r o d u c t - d e t a i l / e n / a m p h e n o l - i c c - f c i / I C D 1 5 S 1 3 E 4 G X 0 0 L F / 6 0 9 - 5 1 8 1 - N D / 1 5 3 6 5 0 1 h t t p s : / / w w w . d i g i k e y . c o m / p r o d u c t - d e t a i l / e n / a m p h e n o l - i c c - f c i / I C D 1 5 S 1 3 E 4 G X 0 0 L F / 6 0 9 - 5 1 8 1 - N D / 1 5 3 6 5 0 1 h t t p s : / / w w w . d i g i k e y . c o m / p r o d u c t - d e t a i l / e n / a m p h e n o l - i c c - f c i / I C D 1 5 S 1 3 E 4 G X 0 0 L F / 6 0 9 - 5 1 8 1 - N D / 1 5 3 6 5 0 1 (https://www.digikey.com/product-detail/en/amphenol-icc-fci/ICD15S13E4GX00LF/609-5181-ND/1536501)

# Power Entry Module (https://www.digikey.com/products/en?keywords=708-2406-ND)

# 3 Stage Line

Filter (https://www.digikey.com/product-detail/en/te-connectivity-corcom-filters/10VN1/CCM1649-ND/361444)

# 57 VDC Switching

Power Supply (https://www.digikey.com/products/en/power-supplies-external-internal-off-board/ac-dc-converters/133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)

# Polygon Drive & Control

# Digital Isolator (https://www.ti.com/store/ti/en/p/product/?p=ISO7761QDBQQ1)

# J5 (Sts/Ctrl)

# (+5V & Gnd)

# #Enable

# Mode

# Line in 1 Line in 2

2 X 5
Mini-fit Jr.

# Digital Isolator (https://www.ti.com/store/ti/en/p/product/?p=ISO7761QDBQQ1)

# (+5V & Gnd)

# Reference Clock

# AC In

# To Emppu

# To Marco

# Genturi Scanner Alpha

# Subsystem Troy

# Rev 1.0.0

# Eric J. Schultz 10/16/2019
