Genturi/NewAlphaElectrical/AlphaOrder.xlsx

Order Item | Description | Genturi P/N | Manufacturer | Mfg P/N | Vendor | Vendor P/N | Emppu | Marco | Jukka | Tarja | Troy | Misc | Total for 1 | Total for 4 | DK | Mouser | L-Com
1 | Fan Tubeaxial 95 ~ 264VAC Square - 60mm L x 60mm H Ball 19.5 CFM (0.546m³/min) 2 Wire Leads | 74-0010 | Orion Fans | OA60EC-UR-1WB | Digi-Key | 1053-1809-ND (https://www.digikey.com/product-detail/en/orion-fans/OA60EC-UR-1WB/1053-1809-ND/9380228) | 1 |  |  | 2 | 2 |  | 5 | 20
2 | Power Entry Connector Receptacle, Male Blades - Module IEC 320-C14 Panel Mount, Snap-In | 06-0025 | Bulgin | BZH01/Z0000/11 | Digi-Key | 708-2406-ND (https://www.digikey.com/products/en?keywords=708-2406-ND) | 1 |  |  | 1 | 1 |  | 3 | 12
3 | Single Phase EMC/EMI Line Filter 4A 125V, 250VAC 50/60Hz Three Stage Terminal Block | 06-0026 | Schurter Inc. | 5500.2048 | Digi-Key | 486-6367-ND (https://www.digikey.com/product-detail/en/schurter-inc/5500.2048/486-6367-ND/642780) | 1 |  |  | 1 |  |  | 2 | 8 | 2 | 3
4 | Enclosed AC DC Converter 1 Output 15V 10A 88 ~ 264 VAC Input | 06-0034 | TDK-Lambda Americas Inc. | LS150-15 | Digi-Key | 285-1812-ND (https://www.digikey.com/product-detail/en/tdk-lambda-americas-inc/LS150-15/285-1812-ND/1918823) | 1 |  |  |  |  |  | 1 | 4
5 | Enclosed AC DC Converter 1 Output 24V 2.2A 88 ~ 264 VAC Input | 06-0035 | TDK-Lambda Americas Inc. | LS50-24 | Digi-Key | 285-1820-ND (https://www.digikey.com/product-detail/en/tdk-lambda-americas-inc/LS50-24/285-1820-ND/1918831) | 1 |  |  |  |  |  | 1 | 4
6 | BC6D25 Current Regulating Six Motor Controller | 06-0022 | Peter Norberg Consulting | BC6D25 (https://www.stepperboard.com/prod-bc6d25.htm) | Peter Norberg Consulting |  |  |  |  |  |  |  | 0 | 250
7 | 37 Position D-Sub Receptacle, Female Sockets Connector | 05-0005 | NorComp Inc. | 171-037-203L001 | Digi-Key | 237FE-ND (https://www.digikey.com/product-detail/en/norcomp-inc/171-037-203L001/237FE-ND/858162) | 1 |  | 1 |  |  |  | 2 | 15
8 | Solid State SPST-NO (1 Form A) Hockey Puck | 06-0037 | Sensata-Crydom | DC60S3 | Digi-Key | CC1126-ND (https://www.digikey.com/product-detail/en/sensata-crydom/DC60S3/CC1126-ND/221844) | 1 |  |  |  |  |  | 1 | 4
9 | Network Hub, USB Ports | 06-0023 | B&B SmartWorx, Inc. | BB-USBHUB4OEM | Digi-Key | 1165-1059-ND (https://www.digikey.com/product-detail/en/b-b-smartworx-inc/BB-USBHUB4OEM/1165-1059-ND/3045945) |  |  |  | 1 |  |  | 1 | 4
10 | 24-Channel Digital I/O USB Device | 06-0018 | Measurement Computing | USB-DIO24/37 (https://www.mccdaq.com/usb-data-acquisition/USB-DIO24-Series.aspx) | Measurement Computing |  |  |  |  |  |  |  | 0 | 0
11 | 25 Position D-Sub Receptacle, Female Sockets Connector | 06-0039 | NorComp Inc. | 171-025-203L001 | Digi-Key | 225FE-ND (https://www.digikey.com/product-detail/en/norcomp-inc/171-025-203L001/225FE-ND/858144) | 1 |  |  |  |  |  | 1 | 4
12 | Premium USB Cable Type A - B Cable, 0.5m | 60-0005 | L-Com | CSMUAB-05M (http://www.l-com.com/usb-premium-usb-cable-type-a-b-cable-05m) | L-Com | CSMUAB-05M (http://www.l-com.com/usb-premium-usb-cable-type-a-b-cable-05m) | 2 | 1 |  |  |  |  | 3 | 12 | 0 |  | 12
13 | USB A to USB micro B cable, 0.5m | 60-0006 | L-Com | CSMUSMICB-05M (http://www.l-com.com/usb-premium-usb-cable-type-a-micro-b-5-position-05m) | L-Com | CSMUSMICB-05M (http://www.l-com.com/usb-premium-usb-cable-type-a-micro-b-5-position-05m) | 1 |  |  |  |  |  | 1 | 4 | 0 |  | 4
14 | USB A to USB mini B cable, 0.5m | 60-0007 | L-Com | CSMUAMB5-05M (http://www.l-com.com/usb-premium-usb-cable-type-a-mini-b-5-position-05m) | L-Com | CSMUAMB5-05M (http://www.l-com.com/usb-premium-usb-cable-type-a-mini-b-5-position-05m) | 1 |  |  | 2 |  |  | 3 | 12 | 0 |  | 12
15 | 6 Position Rectangular Housing Connector Receptacle White 0.100" (2.54mm) | 05-0006 | Molex | 22013067 | Digi-Key | WM2004-ND (https://www.digikey.com/products/en?keywords=WM2004-ND) | 2 |  |  |  |  |  | 2 | 8
16 | 9 Position Rectangular Housing Connector Receptacle White 0.100" (2.54mm) | 05-0007 | Molex | 22013097 | Digi-Key | WM2007-ND (https://www.digikey.com/products/en?keywords=wm2007-nd) | 3 |  |  |  |  |  | 3 | 12
17 | 4 Position Rectangular Housing Connector Receptacle White 0.100" (2.54mm) | 05-0008 | Molex | 22013047 | Digi-Key | WM2002-ND (https://www.digikey.com/products/en?keywords=wm2002-nd) | 5 |  |  |  |  |  | 5 | 20
18 | Non-Gendered Contact Tin 22-30 AWG Crimp | 05-0009 | Molex | 0008500032 | Digi-Key | WM2623-ND (https://www.digikey.com/products/en?keywords=08-50-0032) | Lots |  |  |  |  |  | 0 | 250
19 | Power Entry Connector Receptacle, Male Blades IEC 320-C14 Panel Mount, Snap-In | 06-0040 | Qualtek | 701W-X2/02 | Digi-Key | Q207-ND (https://www.digikey.com/products/en?keywords=701W-X2%2F02) |  | 1 | 1 |  |  |  | 2 | 8
20 | Enclosed AC DC Converter 1 Output 5V 1A 85 ~ 264 VAC, 100 ~ 370 VDC Input | 06-0042 | CUI Inc. | PSK-S5B-5-T | Digi-Key | 102-5182-ND (https://www.digikey.com/product-detail/en/cui-inc/PSK-S5B-5-T/102-5182-ND/9817114) |  |  | 1 |  |  |  | 1 | 4
21 | Flanged Panel Mounted USB 2.0 Coupler - Shielded, Type B/A Connectors | 06-0041 | L-Com | ECF504-BA (http://www.l-com.com/usb-flanged-panel-mounted-usb-20-coupler-shielded-type-b-a-connectors) | L-Com | ECF504-BA (http://www.l-com.com/usb-flanged-panel-mounted-usb-20-coupler-shielded-type-b-a-connectors) |  | 1 | 1 |  |  |  | 2 | 8 | 0 |  | 8
22 | USB-based 4-channel, 16-bit analog voltage output device, 8 digital I/O, with one counter | 06-0019 | Measurement Computing | USB-3101 (https://www.mccdaq.com/usb-data-acquisition/USB-3100-Series.aspx) | Measurement Computing | USB-3101 (https://www.mccdaq.com/usb-data-acquisition/USB-3100-Series.aspx) |  | 1 | 1 |  |  |  | 2 | 8
23 | 20 Position Rectangular Housing Connector Receptacle Black 0.118" (3.00mm) | 05-0020 | Molex | 0430252000 | Digi-Key | WM2492-ND (https://www.digikey.com/product-detail/en/molex/0430252000/WM2492-ND/531408) |  |  | 1 |  |  |  | 1 | 4
24 | Socket Contact Tin 20-24 AWG Crimp Power | 05-0012 | Molex | 0430300007 | Digi-Key | WM1837-ND (https://www.digikey.com/products/en?keywords=wm1837-nd) |  |  | Lots |  |  |  | 0 | 250
25 | Linear AC DC Converter 2 Output 15V -15V 1.5A, 1.5A 100 ~ 240 VAC Input | 06-0027 | SL Power Electronics Manufacture of Condor/Ault Brands | HBB15-1.5-A+G | Digi-Key | 271-2280-ND (https://www.digikey.com/product-detail/en/sl-power-electronics-manufacture-of-condor-ault-brands/HBB15-1.5-A-G/271-2280-ND/1035138) |  | 1 |  |  |  |  | 1 | 4
26 | Linear AC DC Converter 1 Output 5V 3A 100 ~ 240 VAC Input | 06-0028 | SL Power Electronics Manufacture of Condor/Ault Brands | HB5-3-OV-A+G | Digi-Key | 271-2253-ND |  | 1 |  |  |  |  | 1 | 4
27 | Adapter Coaxial Connector SMA Jack, Female Socket To SMA Jack, Female Socket 50Ohm | 06-0029 | Amphenol RF Division | 132170 | Digi-Key | ACX1244-ND (https://www.digikey.com/product-detail/en/amphenol-rf-division/132170/ACX1244-ND/1011921) |  | 8 |  |  |  |  | 8 | 32
28 | 3 Position Circular Connector Plug, Female Sockets and Male Pins Solder Cup | 05-0010 | LEMO | FFA.1S.303.CLAC52 | Digi-Key | FFA.1S.303.CLAC52-ND (https://www.digikey.com/product-detail/en/lemo/FFA.1S.303.CLAC52/FFA.1S.303.CLAC52-ND/3688991) |  | 1 |  |  |  |  | 1 | 4 | 0 | 4
29 | 8 Position Rectangular Housing Connector Receptacle Black 0.118" (3.00mm) | 05-0011 | Molex | 0430250800 | Digi-Key | WM1786-ND (https://www.digikey.com/products/en?keywords=0430250800) |  |  | 1 |  |  |  | 1 | 4
30 | 4 Position Rectangular Housing Connector Receptacle Natural 0.165" (4.20mm) | 05-0013 | Molex | 0039012040 | Digi-Key | WM3701-ND (https://www.digikey.com/products/en?keywords=WM3701-ND) |  |  | 1 |  |  |  | 1 | 4
31 | Socket Contact Tin 18-24 AWG Crimp Power | 05-0014 | Molex | 39000039 | Digi-Key | WM2501-ND (https://www.digikey.com/products/en?keywords=WM2501-ND) |  |  | Lots |  |  |  | 0 | 250
32 | Open Frame AC DC Converter 1 Output 12V 5A 90 ~ 264 VAC Input | 06-0024 | TDK-Lambda Americas Inc. | ZPSA6012 | Digi-Key | 285-1841-ND (https://www.digikey.com/product-detail/en/tdk-lambda-americas-inc/ZPSA6012/285-1841-ND/1963689) |  |  |  | 1 |  |  | 1 | 4
33 | 9 Position D-Sub Receptacle, Female Sockets Connector | 05-0004 | NorComp Inc. | 171-009-203L001 | Digi-Key | 209FE-ND (https://www.digikey.com/product-detail/en/norcomp-inc/171-009-203L001/209FE-ND/858108) |  |  |  | 1 |  |  | 1 | 4
34 | Power Entry Connector Receptacle, Female Sockets IEC 320-2-2/F (C14 Variant) Panel Mount, Snap-In | 05-0015 | Qualtek | 742W-15/04 | Digi-Key | Q848-ND (https://www.digikey.com/product-detail/en/qualtek/742W-15-04/Q848-ND/1466709) |  |  |  | 1 |  |  | 1 | 4
35 | Single Phase EMC/EMI Line Filter 10A 250VAC 50/60Hz Three Stage Quick Connect | 06-0031 | TE Connectivity Corcom Filters | 10VN1 | Digi-Key | CCM1649-ND (https://www.digikey.com/product-detail/en/te-connectivity-corcom-filters/10VN1/CCM1649-ND/361444) |  |  |  | 1 |  |  | 1 | 4
36 | Enclosed AC DC Converter 1 Output 57V 10.6A 85 ~ 265 VAC Input | 06-0030 | TDK-Lambda Americas Inc. | EVS57-10R6 | Digi-Key | 285-2551-ND (https://www.digikey.com/product-detail/en/tdk-lambda-americas-inc/EVS57-10R6/285-2551-ND/6052047) |  |  |  | 1 |  |  | 1 | 4 | 1 | 3
37 | 10 Position Rectangular Housing Connector Receptacle Black 0.100" (2.54mm) | 05-0019 | TE Connectivity AMP Connectors | 104257-9 | Digi-Key | A28425-ND (https://www.digikey.com/products/en?keywords=A28425-ND) |  |  |  | 2 |  |  | 2 | 8
38 | 8 Position Rectangular Housing Connector Receptacle Black 0.100" (2.54mm) | 05-0018 | TE Connectivity AMP Connectors | 102241-6 | Digi-Key | A26987-ND (https://www.digikey.com/products/en?keywords=A26987-ND) |  |  |  | 2 |  |  | 2 | 8
39 | Socket Contact Gold 22-26 AWG Crimp | 05-0017 | TE Connectivity AMP Connectors | 1-104480-6 | Digi-Key | A32513-ND (https://www.digikey.com/products/en?keywords=A32513-ND) |  |  |  | Lots |  |  | 0 | 0
40 |  |  |  |  |  |  |  |  |  |  |  |  | 0 | 0
41 | CONNECTOR, RECTANGULAR, 1.25MM, 2X8, FEMALE | 05-0029 | Harwin | G125-FV21605L0P | Digi-Key | 952-2777-ND (https://www.digikey.com/products/en?keywords=G125-FV21605L0P) | 2 |  |  |  |  |  | 2 | 8
42 | CONNECTOR, D-SUB-HD, 15-PIN, FEMALE, PANEL MNT | 05-0030 | NorComp Inc. | 180-015-203L001 | Digi-Key | T815FE-ND (https://www.digikey.com/product-detail/en/amphenol-icc-commercial-products/17EHD-015-S-AA-0-00/17EHD-015-S-AA-0-00-ND/1242555) | 2 |  |  |  |  |  | 2 | 8
43 | CONNECTOR, D-SUB-HD, 15-PIN, MALE, PANEL MNT | 05-0031 | NorComp Inc. | 180-015-103L001 | Digi-Key | T815ME-ND (https://www.digikey.com/product-detail/en/norcomp-inc/180-015-103L001/T815ME-ND/858220) | 1 | 2 |  |  |  |  | 3 | 20
44 | CONNECTOR SHELL, D-SUB-HD, 15-PIN | 05-0032 | NorComp Inc. | 970-009-030R121 | Digi-Key | 970-09NE-ND (https://www.digikey.com/product-detail/en/norcomp-inc/970-009-030R121/970-09NE-ND/858447) | 2 | 2 |  |  |  |  | 4 | 16
45 | CONNECTOR, HOUSING, 5-PIN, WIRE-TO-BRD, SINGLE ROW, AMPMODU MTE | 05-0033 | TE Connectivity AMP Connectors | 104257-4 | Digi-Key | A28405-ND (https://www.digikey.com/product-detail/en/te-connectivity-amp-connectors/104257-4/A28405-ND/289305) | 1 |  |  |  |  |  | 1 | 4
46 | CORD, LINE, 16-AWG, NEMA 5-15P TO IEC 320-C13, 8' | 60-0062 | Tripp Lite | P006-008-13A | Digi-Key | TL870-ND (https://www.digikey.com/products/en/cable-assemblies/power-line-cables-and-extension-cords/452?k=LINE+CORD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) | 1 |  |  |  |  |  | 1 | 4
47 | CABLE, USB A TO USB B, 2M | 60-0061 | L-Com | CSMUAB-2M (http://www.l-com.com/usb-premium-usb-cable-type-a-b-cable-20m) | L-Com | CSMUAB-2M (http://www.l-com.com/usb-premium-usb-cable-type-a-b-cable-20m) | 1 |  | 1 |  |  |  | 2 | 8 |  |  | 8
48 | CORD, LINE, 16-AWG, IEC 320-C14 TO IEC 320-C13, 4' | 60-0060 | Tripp Lite | P004-004-13A | Digi-Key | TL858-ND (https://www.digikey.com/products/en?keywords=TL858-ND) |  | 1 | 1 |  |  |  | 2 | 8
49 | CORD, LINE, 16-AWG, IEC 320-C14 TO IEC 320-C13, 5' | 60-0059 | Tripp Lite | P004-005-13A | Digi-Key | TL860-ND (https://www.digikey.com/products/en?keywords=TL860-ND) |  | 1 | 1 |  |  |  | 2 | 8
50 | CORD, LINE, 16-AWG, IEC 320-C14 TO IEC 320-C13, 3' | 60-0058 | Tripp Lite | P004-003-13A | Digi-Key | TL856-ND (https://www.digikey.com/products/en?keywords=TL856-ND) |  | 1 | 1 |  |  |  | 2 | 8
51 | CORD, LINE, 16-AWG, IEC 320-C14 TO IEC 320-C13, 2' | 60-0057 | Tripp Lite | P004-002-13A | Digi-Key | TL853-ND (https://www.digikey.com/products/en?keywords=TL853-ND) |  | 1 | 1 |  |  |  | 2 | 8
52 | CABLE, USB A TO USB B MICRO, 0.5M | 60-0075 | Assmann WSW Components | AK67401-0.5 | Digi-Key | AE10422-ND (https://www.digikey.com/products/en?keywords=AE10422-ND) |  | 1 |  |  |  |  | 1 | 4
53 | CABLE, USB A TO USB B MICRO, 1M | 60-0074 | Assmann WSW Components | AK67401-1 | Digi-Key | AE10423-ND (https://www.digikey.com/products/en?keywords=AE10423-ND) |  | 1 |  |  |  |  | 1 | 4
54 | CABLE, USB A TO USB B MICRO, 2M | 60-0073 | Assmann WSW Components | AK67401-2 | Digi-Key | AE10348-ND (https://www.digikey.com/products/en?keywords=AE10348-ND) |  | 1 |  |  |  |  | 1 | 4
55 | CABLE, COAXIAL, RG174, SMA-MALE, SMA-MALE, 12" | 60-0011 | L-Com | CC174S-1 | L-Com | CC174S-1 (http://www.l-com.com/coaxial-rg174-coaxial-cable-sma-male-male-10ft) |  | 1 |  |  |  |  | 1 | 4 |  |  | 4
56 | CABLE, COAXIAL, RG174, SMA-MALE, SMA-MALE, 18" | 60-0012 | L-Com | CC174S-1.5 | L-Com | CC174S-1.5 |  | 1 |  |  |  |  | 1 | 4 |  |  | 4
57 | CABLE, COAXIAL, RG174, SMA-MALE, SMA-MALE, 24" | 60-0072 | L-Com | CC174S-2 (http://www.l-com.com/coaxial-rg174-coaxial-cable-sma-male-male-20-ft) | L-Com | CC174S-2 (http://www.l-com.com/coaxial-rg174-coaxial-cable-sma-male-male-20-ft) |  | 1 |  |  |  |  | 1 | 4 |  |  | 4
58 | CABLE, COAXIAL, RG174, SMA-MALE, SMA-MALE, 30" | 60-0071 | L-Com | CC174S-2.5 (http://www.l-com.com/coaxial-rg174-coaxial-cable-sma-male-male-25-ft) | L-Com | CC174S-2.5 (http://www.l-com.com/coaxial-rg174-coaxial-cable-sma-male-male-25-ft) |  | 1 |  |  |  |  | 1 | 4 |  |  | 4
59 | CABLE, COAXIAL, RG174, SMA-MALE, SMA-MALE, 36" | 60-0070 | L-Com | CC174S-3 (http://www.l-com.com/coaxial-rg174-coaxial-cable-sma-male-male-30-ft) | L-Com | CC174S-3 (http://www.l-com.com/coaxial-rg174-coaxial-cable-sma-male-male-30-ft) |  | 1 |  |  |  |  | 1 | 4 |  |  | 4
60 | CABLE, COAXIAL, RG174, SMA-MALE, SMA-MALE, 48" | 60-0069 | L-Com | CC174S-4 (http://www.l-com.com/coaxial-rg174-coaxial-cable-sma-male-male-40ft) | L-Com | CC174S-4 (http://www.l-com.com/coaxial-rg174-coaxial-cable-sma-male-male-40ft) |  | 1 |  |  |  |  | 1 | 4 |  |  | 4
61 | CABLE, COAXIAL, RG174, SMA-MALE, SMA-MALE, 60" | 60-0068 | L-Com | CC174S-5 (http://www.l-com.com/coaxial-rg174-coaxial-cable-sma-male-male-50-ft) | L-Com | CC174S-5 (http://www.l-com.com/coaxial-rg174-coaxial-cable-sma-male-male-50-ft) |  | 1 |  |  |  |  | 1 | 4 |  |  | 4
62 | CABLE, COAXIAL, RG174, SMA-MALE, SMA-MALE, 78" | 60-0067 | L-Com | CC174S-7.5 (http://www.l-com.com/coaxial-rg174-coaxial-cable-sma-male-male-75-ft) | L-Com | CC174S-7.5 (http://www.l-com.com/coaxial-rg174-coaxial-cable-sma-male-male-75-ft) |  | 1 |  |  |  |  | 1 | 4 |  |  | 4
63 | CORD, LINE, 14-AWG, NEMA 5-15P TO IEC 320-C13, 8' | 60-0066 | Assmann WSW Components | A-PC2302-030026-1 | Digi-Key | AE10727-ND |  |  |  |  | 1 |  | 1 | 4
64 | CONNECTOR, COAX, SMA, MALE, TERNINATION KIT | 05-0034 | Amphenol RF | 132114 | Digi-Key | ACX1202-ND (https://www.digikey.com/product-detail/en/amphenol-rf/132114/ACX1202-ND/1011879) |  |  |  |  |  | 2 | 2 | 8
65 | CONNECTOR, D-SUB, 9-PIN, MALE, PANEL MNT | 05-0035 | NorComp Inc. | 171-009-103L001 | Digi-Key | 209ME-ND (https://www.digikey.com/products/en?keywords=171-009-103L001) |  |  |  |  |  | 2 | 2 | 8
66 | CONNECTOR SHELL, D-SUB, 9-PIN | 05-0036 | NorComp Inc. | 970-009-030R121 | Digi-Key | 970-09NE-ND (https://www.digikey.com/products/en?keywords=970-09NE-ND) |  |  |  |  |  | 2 | 2 | 8
67 | CABLE, USB A TO USB B, 0.5M |  | L-Com | ECUSBAB-05M |  |  |  | 1 |  |  |  |  |  | 4 |  |  | 4
