Genturi/NewAlphaElectrical/PartsRequest112219.xlsx

Description | Genturi Description | Genturi P/N Prefix | Manufacturer | Mfg P/N | Digi-Key P/N | Cost
37 Position D-Sub Receptacle, Female Sockets Connector | CONNECTOR, D-SUB, 37-PIN, FEMALE, PANEL MOUNT | 06 | NorComp Inc. | 171-037-203L001 | 237FE-ND (https://www.digikey.com/product-detail/en/norcomp-inc/171-037-203L001/237FE-ND/858162) | $2.63
USB A to USB micro B cable, 0.5m | CABLE, USB A TO USB B MICRO, 0.5M | 60 | L-Com | CSMUSMICB-05M (http://www.l-com.com/usb-premium-usb-cable-type-a-micro-b-5-position-05m) |  | $9.53
USB A to USB mini B cable, 0.5m | CABLE, USB A TO USB B MINI, 0.5M | 60 | L-Com | CSMUAMB5-05M (http://www.l-com.com/usb-premium-usb-cable-type-a-mini-b-5-position-05m) |  | $9.47
6 Position Rectangular Housing Connector Receptacle White 0.100" (2.54mm) | CONNECTOR, HOUSING, 8-PIN, WIRE-TO-BOARD, 0.1", SINGLE-ROW, KK2695 | 06 | Molex | 22013067 | WM2004-ND (https://www.digikey.com/products/en?keywords=WM2004-ND) | $0.29
9 Position Rectangular Housing Connector Receptacle White 0.100" (2.54mm) | CONNECTOR, HOUSING, 9-PIN, WIRE-TO-BOARD, 0.1", SINGLE-ROW, KK2695 | 06 | Molex | 22013097 | WM2007-ND (https://www.digikey.com/products/en?keywords=wm2007-nd) | $0.43
4 Position Rectangular Housing Connector Receptacle White 0.100" (2.54mm) | CONNECTOR, HOUSING, 4-PIN, WIRE-TO-BOARD, 0.1", SINGLE-ROW, KK2695 | 06 | Molex | 22013047 | WM2002-ND (https://www.digikey.com/products/en?keywords=wm2002-nd) | $0.20
Non-Gendered Contact Tin 22-30 AWG Crimp | CONTACT, CONNECTOR, KK2695 | 06 | Molex | 0008500032 | WM2623-ND (https://www.digikey.com/products/en?keywords=08-50-0032) | $0.09
Adapter Coaxial Connector BNC Plug, Male Pin To SMA Plug, Male Pin 50Ohm | ADAPTER, COAXIAL, SMA-MALE, BNC-MALE | 60 | Molex | 0733860013 | WM15609-ND (https://www.digikey.com/products/en?keywords=WM15609-ND) | 11.19
RG174 Coaxial Cable, SMA Male / BNC Male, 0.5 ft | CABLE, COAXIAL, RG174, SMA-MALE, BNC-MALE, 6" | 60 | L-Com | CC174SB-05 (http://www.l-com.com/coaxial-rg174-coaxial-cable-sma-male-bnc-male-05-ft) |  | 18.2
RG174 Coaxial Cable, SMA Male / BNC Male, 1.0 ft | CABLE, COAXIAL, RG174, SMA-MALE, BNC-MALE, 12" | 60 | L-Com | CC174SB-1 (http://www.l-com.com/coaxial-rg174-coaxial-cable-sma-male-bnc-male-10-ft) |  | 18.37
RG174 Coaxial Cable, SMA Male / Male, 1.0ft | CABLE, COAXIAL, RG174, SMA-MALE, SMA-MALE, 12" | 60 | L-Com | CC174S-1 (http://www.l-com.com/coaxial-rg174-coaxial-cable-sma-male-male-10ft) |  | 23.15
RG174 Coaxial Cable, SMA Male / Male, 1.5 ft | CABLE, COAXIAL, RG174, SMA-MALE, SMA-MALE, 18" | 60 | L-Com | CC174S-1.5 (http://www.l-com.com/coaxial-rg174-coaxial-cable-sma-male-male-15-ft) |  | 23.55
3 Position Circular Connector Plug, Female Sockets and Male Pins Solder Cup | PLUG, CIRCULAR, LEMO, 3-PIN, SOLDER-CUP, 10A | 06 | LEMO | FFA.1S.303.CLAC52 | FFA.1S.303.CLAC52-ND (https://www.digikey.com/product-detail/en/lemo/FFA.1S.303.CLAC52/FFA.1S.303.CLAC52-ND/3688991) | $39.42
8 Position Rectangular Housing Connector Receptacle Black 0.118" (3.00mm) | CONNECTOR, HOUSING, 8-PIN, WIRE-TO-BOARD, 3MM, DUAL-ROW, MICRO-FIT3.0 | 06 | Molex | 0430250800 | WM1786-ND (https://www.digikey.com/product-detail/en/molex/0430250800/WM1786-ND/252499) | $0.51
Socket Contact Tin 20-24 AWG Crimp Power | CONTACT, CONNECTOR, FEMALE, MICRO-FIT3.0 | 06 | Molex | 0430300007 | WM1837-ND (https://www.digikey.com/products/en?keywords=wm1837-nd) | $0.19
4 Position Rectangular Housing Connector Receptacle Natural 0.165" (4.20mm) | CONNECTOR, HOUSING, 4-PIN, WIRE-TO-BOARD, 4.2MM, DUAL-ROW, MINI-FIT-JR | 06 | Molex | 0039012040 | WM3701-ND (https://www.digikey.com/products/en?keywords=WM3701-ND) | $0.31
Socket Contact Tin 18-24 AWG Crimp Power | CONTACT, CONNECTOR, FEMALE, MINI-FIT-JR | 06 | Molex | 39000039 | WM2501-ND (https://www.digikey.com/products/en?keywords=WM2501-ND) | $0.18
OBIS Laser Cable (0.3 meter) | CABLE, OBIS-LASER, 0.3M | 60 | Coherent | 1197523 (https://www.coherent.com/lasers/laser/obis-laser-cable-0-3-meter)
Power Entry Connector Receptacle, Female Sockets IEC 320-2-2/F (C14 Variant) Panel Mount, Snap-In | CONNECTOR, POWER-ENTRY, RECEPTICAL, DUAL, C14 | 06 | Qualtek | 742W-15/04 | Q848-ND (https://www.digikey.com/product-detail/en/qualtek/742W-15-04/Q848-ND/1466709) | $2.05
2 Position Rectangular Housing Connector Receptacle Black 0.118" (3.00mm) | CONNECTOR, HOUSING, 2-PIN, WIRE-TO-BOARD, 3MM, SINGLE-ROW, MICRO-FIT3.0 | 06 | Molex | 0430250200 | WM1783-ND (https://www.digikey.com/products/en?keywords=WM1783-ND) | $0.32
Emppu | ASSY, MOTOR I/O ELECTRONICS BOX | 50 | Genturi
Jukka | ASSY, CARTRIDGE BIAS ELECTRONICS BOX | 50 | Genturi
Marco | ASSY, ELECTRO-OPTICS CONTROL BOX | 50 | Genturi
Tarja | ASSY, LASER ELECTRONICS BOX | 50 | Genturi
Troy | ASSY, POLYGON ELECTRONICS BOX | 50 | Genturi
16 AWG Hook-Up Wire 26/30 Green 600V 100.0' (30.5m) | WIRE, HOOK-UP, GREEN, 16GA, 600V, PVC, 26-STRAND, 100' | 60 | Alpha Wire | 3077 GR005 | A2104G-100-ND (https://www.digikey.com/products/en?keywords=A2104G-100-ND) | $100.04
16 AWG Hook-Up Wire 26/30 Black 600V 100.0' (30.5m) | WIRE, HOOK-UP, BLACK, 16GA, 600V, PVC, 26-STRAND, 100' | 60 | Alpha Wire | 3077 BK005 | A2104B-100-ND (https://www.digikey.com/products/en?keywords=A2104B-100-ND) | $100.04
16 AWG Hook-Up Wire 26/30 White 600V 100.0' (30.5m) | WIRE, HOOK-UP, WHITE, 16GA, 600V, PVC, 26-STRAND, 100' | 60 | Alpha Wire | 3077 WH005 | A2104W-100-ND (https://www.digikey.com/products/en?keywords=A2104W-100-ND) | $100.04
HOOK-UP STRND 22AWG RED 100' | WIRE, HOOK-UP, RED, 22GA, 300V, PVC, 17-STRAND, 100' | 60 | CNC Tech | 1569-22-1-0500-004-1-TS | CN531R-100-ND (https://www.digikey.com/products/en?keywords=CN531R-100-ND) | $16.93
HOOK-UP STRND 22AWG BLACK 100' | WIRE, HOOK-UP, BLACK, 22GA, 300V, PVC, 17-STRAND, 100' | 60 | CNC Tech | 1569-22-1-0500-001-1-TS | CN528B-100-ND (https://www.digikey.com/products/en?keywords=CN528B-100-ND) | $16.93
HOOK-UP STRND 22AWG ORANGE 100' | WIRE, HOOK-UP, ORANGE, 22GA, 300V, PVC, 17-STRAND, 100' | 60 | CNC Tech | 1569-22-1-0500-008-1-TS | CN535A-100-ND (https://www.digikey.com/products/en?keywords=CN535A-100-ND) | $16.93
HOOK-UP STRND 22AWG WHITE 100' | WIRE, HOOK-UP, WHITE, 22GA, 300V, PVC, 17-STRAND, 100' | 60 | CNC Tech | 1569-22-1-0500-002-1-TS | CN529W-100-ND (https://www.digikey.com/products/en?keywords=CN529W-100-ND) | $16.93
HOOK-UP STRND 22AWG GREEN 100' | WIRE, HOOK-UP, GREEN, 22GA, 300V, PVC, 17-STRAND, 100' | 60 | CNC Tech | 1569-22-1-0500-007-1-TS | CN534G-100-ND (https://www.digikey.com/products/en?keywords=CN534G-100-ND) | $16.93
HOOK-UP STRND 22AWG BLUE 100' | WIRE, HOOK-UP, BLUE, 22GA, 300V, PVC, 17-STRAND, 100' | 60 | CNC Tech | 1569-22-1-0500-005-1-TS | CN532L-100-ND (https://www.digikey.com/products/en?keywords=CN532L-100-ND) | $16.93
HOOK-UP STRND 22AWG YELLOW 100' | WIRE, HOOK-UP, YELLOW, 22GA, 300V, PVC, 17-STRAND, 100' | 60 | CNC Tech | 1569-22-1-0500-003-1-TS | CN530Y-100-ND (https://www.digikey.com/products/en?keywords=CN530Y-100-ND) | $16.93
HOOK-UP STRND 22AWG VIOLET 100' | WIRE, HOOK-UP, VIOLET, 22GA, 300V, PVC, 17-STRAND, 100' | 60 | CNC Tech | 1569-22-1-0500-010-1-TS | CN536V-100-ND (https://www.digikey.com/products/en?keywords=CN536V-100-ND) | $16.93
HOOK-UP STRND 22AWG BROWN 100' | WIRE, HOOK-UP, BROWN, 22GA, 300V, PVC, 17-STRAND, 100' | 60 | CNC Tech | 1569-22-1-0500-006-1-TS | CN533N-100-ND (https://www.digikey.com/products/en?keywords=CN533N-100-ND) | $16.93
HOOK-UP STRND 24AWG BLUE 100' | WIRE, HOOK-UP, BLUE, 24GA, 300V, PVC, 11-STRAND, 100' | 60 | CNC Tech | 1569-24-1-0500-005-1-TS | CN522L-100-ND (https://www.digikey.com/products/en?keywords=CN522L-100-ND) | $18.45
HOOK-UP STRND 24AWG BROWN 100' | WIRE, HOOK-UP, BROWN, 24GA, 300V, PVC, 11-STRAND, 100' | 60 | CNC Tech | 1569-24-1-0500-006-1-TS | CN523N-100-ND (https://www.digikey.com/products/en?keywords=CN523N-100-ND) | $18.45
HOOK-UP STRND 24AWG GREEN 100' | WIRE, HOOK-UP, GREEN, 24GA, 300V, PVC, 11-STRAND, 100' | 60 | CNC Tech | 1569-24-1-0500-007-1-TS | CN524G-100-ND (https://www.digikey.com/products/en?keywords=CN524G-100-ND) | $18.45
HOOK-UP STRND 24AWG ORANGE 100' | WIRE, HOOK-UP, ORANGE, 24GA, 300V, PVC, 11-STRAND, 100' | 60 | CNC Tech | 1569-24-1-0500-008-1-TS | CN525A-100-ND (https://www.digikey.com/products/en?keywords=CN525A-100-ND) | $18.45
HOOK-UP STRND 24AWG YELLOW 100' | WIRE, HOOK-UP, YELLOW, 24GA, 300V, PVC, 11-STRAND, 100' | 60 | CNC Tech | 1569-24-1-0500-003-1-TS | CN520Y-100-ND (https://www.digikey.com/products/en?keywords=CN520Y-100-ND) | $18.45
HOOK-UP STRND 24AWG VIOLET 100' | WIRE, HOOK-UP, VIOLET, 24GA, 300V, PVC, 11-STRAND, 100' | 60 | CNC Tech | 1569-24-1-0500-010-1-TS | CN526V-100-ND (https://www.digikey.com/products/en?keywords=CN526V-100-ND) | $18.45
HOOK-UP STRND 24AWG WHITE 100' | WIRE, HOOK-UP, WHITE, 24GA, 300V, PVC, 11-STRAND, 100' | 60 | CNC Tech | 1569-24-1-0500-002-1-TS | CN519W-100-ND (https://www.digikey.com/products/en?keywords=CN519W-100-ND) | $18.45
HOOK-UP STRND 24AWG RED 100' | WIRE, HOOK-UP, RED, 24GA, 300V, PVC, 11-STRAND, 100' | 60 | CNC Tech | 1569-24-1-0500-004-1-TS | CN521R-100-ND (https://www.digikey.com/products/en?keywords=CN521R-100-ND) | $18.45
HOOK-UP STRND 24AWG BLACK 100' | WIRE, HOOK-UP, BLACK, 24GA, 300V, PVC, 11-STRAND, 100' | 60 | CNC Tech | 1569-24-1-0500-001-1-TS | CN518B-100-ND (https://www.digikey.com/products/en?keywords=CN518B-100-ND) | $18.45
 | ASSY, HARNESS, POWER-INPUT, IO ELECTRONICS BOX | 50 | GENTURI
 | ASSY, HARNESS, LINE-FILTER TO POWER SUPPLIES, IO ELECTRONICS BOX | 50 | GENTURI
 | ASSY, HARNESS, PS TO MTR CTRL, IO ELECTRONICS BOX | 50 | GENTURI
 | ASSY, HARNESS, PS TO TEMP CTRL, IO ELECTRIONICS BOX | 50 | GENTURI
 | ASSY, HARNESS, MTR CTRL TO D37, IO ELECTRONICS BOX | 50 | GENTURI
 | ASSY, HARNESS, DAQ TO PCB, CARTRIDGE BIAS ELECTRONICS BOX | 60 | Genturi
 | ASSY, HARNESS, PS TO PCB, CARTRIDGE BIAS ELECTRONICS BOX | 60 | Genturi
 | ASSY, HARNESS, PS TO AMPLIFIERS, ELECTRO-OPTICS CTRL BOX | 60 | Genturi
 | ASSY, HARNESS, DAQ TO PCB, ELECTRO-OPTICS CTRL BOX | 60 | Genturi
 | ASSY, HARNESS, PS TO PCB, ELECTRO-OPTICS CTRL BOX | 60 | Genturi
 | ASSY, HARNESS, POWER-INPUT TO LINE FILTER, LASER ELECTRONICS BOX | 60 | Genturi
 | ASSY, HARNESS, LINE-FILTER TO POWER SUPPLY, LASER ELECTRONICS BOX | 60 | Genturi
 | ASSY, HARNESS, POWER-SUPPLY TO LASER CONTROL, LASER ELECTRONICS BOX | 60 | Genturi
 | ASSY, HARNES, POWER-INPUT TO POWER SUPPLY, POLYGON ELECTRONICS BOX | 60 | Genturi
 | ASSY, HARNESS, LINE-FILTER TO POWER SUPPLY, POLYGON ELECTRONICS BOX | 60 | Genturi
 | ASSY, POLYGON CTRL BRD TO INTERFACE PCB, POLYGON ELECTRONICS BOX | 60 | Genturi
 | CONNECTOR, HOUSING, 20-PIN, WIRE-TO-BOARD, 3MM, DUAL-ROW, MICRO-FIT3.0 | 05 | Molex | 0430252000 | WM2492-ND (https://www.digikey.com/product-detail/en/molex/0430252000/WM2492-ND/531408) | $1.09
 | CONNECTOR, HOUSING, 10 PIN, WIRE TO BOARD, 0.1", SINGLE ROW, AMPMODU MTE | 05 | TE Connectivity AMP Connectors | 104257-9 | A28425-ND (https://www.digikey.com/products/en?keywords=A28425-ND) | $1.32
 | CONNECTOR, HOUSING, 8 PIN, WIRE TO BOARD, 0.1", SINGLE ROW, AMPMODU MTE | 05 | TE Connectivity AMP Connectors | 102241-6 | A26987-ND (https://www.digikey.com/products/en?keywords=A26987-ND) | $0.81
 | CONTACT, CONNECTOR, AMPMODU, 22-26GA | 05 | TE Connectivity AMP Connectors | 1-104480-6 | A32513-ND (https://www.digikey.com/products/en?keywords=A32513-ND) | $0.24
