Genturi/NewAlphaElectrical/PartsRequests_121019.xlsx

Genturi P/N | Genturi Description | General Description | Manufacturer | Manufacturer P/N | Vendor | Vendor P/N | Unit Cost
05-0067 | CONNECTOR, HOUSING, 4-PIN, WIRE-TO-BOARD, 3MM, DUAL-ROW | 4 Position Rectangular Housing Connector Receptacle Black 0.118" (3.00mm) | Molex | 430250400 | Digi-Key | WM1784-ND (https://www.digikey.com/products/en?keywords=430250400) | 0.42
05-0066 | CONNECTOR, HOUSING, 3-PIN, WIRE-TO-BOARD, 3MM, SINGLE-ROW | 3 Position Rectangular Housing Connector Receptacle Black 0.118" (3.00mm) | Molex | 436450300 | Digi-Key | WM1846-ND (https://www.digikey.com/product-detail/en/molex/0436450300/WM1846-ND/268975) | 0.38
60-0118 | CABLE, SHIELDED, 6 COND, #28 AWG | 6 Conductor Multi-Conductor Cable Slate 28 AWG Foil, Braid 100.0' (30.5m) | Alpha Wire | M2406 SL005 | Digi-Key | M2406SL005-ND (https://www.digikey.com/product-detail/en/alpha-wire/M2406-SL005/M2406SL005-ND/3839696) | 144.66
60-0117 | CABLE, SHIELDED, 5 COND, #28 AWG | 5 Conductor Multi-Conductor Cable Slate 28 AWG Foil, Braid 100.0' (30.5m) | Alpha Wire | M2405 SL005 | Digi-Key | M2405 SL005 (https://www.digikey.com/product-detail/en/alpha-wire/M2405-SL005/M2405SL005-ND/3839692) | 139.95
60-0116 | CABLE, SHIELDED, 20 COND, #22 AWG | 20 Conductor Multi-Conductor Cable Slate 22 AWG Foil, Braid 100.0' (30.5m) | Alpha Wire | M5344 SL005 | Digi-Key | M5344SL005-ND (https://www.digikey.com/product-detail/en/alpha-wire/M5344-SL005/M5344SL005-ND/3842350) | 182.09
60-0115 | CABLE, SHIELDED 10 COND, #24 AWG | 10 Conductor Multi-Conductor Cable Slate 24 AWG Foil 100.0' (30.5m) | Alpha Wire | M4608 SL005 | Digi-Key | M4608SL005-ND (https://www.digikey.com/product-detail/en/alpha-wire/M4608-SL005/M4608SL005-ND/3841946) | 187.47
60-0114 | CABLE, SHIELDED, 3 COND, #28 AWG | 3 Conductor Multi-Conductor Cable Slate 28 AWG Foil, Braid 100.0' (30.5m) | Alpha Wire | M2403 SL005 | Digi-Key | M2403SL005-ND (https://www.digikey.com/product-detail/en/alpha-wire/M2403-SL005/M2403SL005-ND/3839684) | 113.91
60-0113 | CABLE, SHIELDED, 7 COND, #28 AWG | 7 Conductor Multi-Conductor Cable Slate 28 AWG Foil, Braid 100.0' (30.5m) | Alpha Wire | 86007CY SL005 | Digi-Key | 86007CYSL005-ND (https://www.digikey.com/product-detail/en/alpha-wire/86007CY-SL005/86007CYSL005-ND/3716829) | 315.79
60-0112 | CABLE, SHIELDED, 2 COND, #24 AWG | 2 (1 Pair Twisted) Conductor Multi-Conductor Cable Chrome 24 AWG Foil 100.0' (30.5m) | Belden Inc. | 9501 060100 | Digi-Key | BEL1387-100-ND (https://www.digikey.com/products/en?keywords=BEL1387-100-ND) | 61.92
60-0111 | CABLE, SHIELDED, 4 COND, #22 AWG | 4 Conductor Multi-Conductor Cable Slate 22 AWG Foil 100.0' (30.5m) | Alpha Wire | M4635 SL005 | Digi-Key | M4635SL005-ND (https://www.digikey.com/product-detail/en/alpha-wire/M4635-SL005/M4635SL005-ND/3841982) | 101.51
 | Drain wire confirmed
 |  | 8 (4 Pair Twisted) Conductor Multi-Pair, Cat5e Cable Gray 26 AWG Foil 1000.0' (304.8m) | IO Audio Technologies | IO-E4261S-5ECMR-1000B | Digi-Key | 1937-1042-ND (https://www.digikey.com/products/en/cables-wires/multiple-conductor-cables/473?k=wire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) | 209.47
