Genturi/NewAlphaElectrical/(30-0002)_GhostRiver_BOM.xlsx

Ref Des | Description | Manufacturer | Value | Mfg. P/N | Digi-Key P/N | Cost | Package | Qty | Ext Cost
C1,C4 | CAP CER 0.22UF 25V C0G/NP0 1210 | KEMET | .22uF | C1210X224J3GACAUTO | 399-20368-1-ND (https://www.digikey.com/product-detail/en/kemet/C1210X224J3GACAUTO/399-20368-1-ND/9925810) | 2.1 | 1210i-3225m | 2 | $4.20
C2,C3 | CAP TANT 220UF 10% 10V 2917 | AVX Corporation | 220uF | TPSD227K010R0040 | 478-9181-1-ND (https://www.digikey.com/product-detail/en/avx-corporation/TPSD227K010R0040/478-9181-1-ND/4562046) | 2.66 | 2917i-7343m | 2 | $5.32
C5 | Place holder cap |  | ? 2pF ? |  |  | 0 | 0402i-1005m | 1 | $0.00
C6,C9,C10,C12 | CAP TANT POLY 1UF 63V 1411 | KEMET | 1uF | T521B105M063ATE200 | 399-14249-1-ND (https://www.digikey.com/product-detail/en/kemet/T521B105M063ATE200/399-14249-1-ND/6826934) | 1.47 | 1411i-3528m | 4 | $5.88
C7,C8,C11,C13 | CAP CER 0.1UF 50V C0G 1206 | TDK Corporation | 0.1uF | C3216C0G1H104J160AA | 445-7694-1-ND (https://www.digikey.com/products/en?keywords=445-7694-1-ND) | 0.67 | 1206i-3216m | 4 | $2.68
D1 | Photodiode | Hamamatsu |  | S1336-18BK | N/A | 10.8 | TO-18 | 1 | $10.80
J1 | CONN RCPT USB2.0 MICRO B SMD R/A | Amphenol ICC (FCI) |  | 10118192-0001LF | 609-4613-1-ND (https://www.digikey.com/products/en?keywords=609-4613-1-ND) | 0.43 | AMPHENOL_10118192-0001LF | 1 | $0.43
L1 | FIXED IND 100UH 340MA 1.82 OHM | Taiyo Yuden | 100uH | CBC3225T101MR | 587-1628-6-ND (https://www.digikey.com/products/en?keywords=587-1628-6-ND) | 0.26 | 1210i-3225m | 1 | $0.26
R1,R2 | RES SMD 0 OHM JUMPER 1/2W 1210 | Vishay Dale | 0 Ohm | CRCW12100000Z0EA | 541-0.0VCT-ND (https://www.digikey.com/product-detail/en/vishay-dale/CRCW12100000Z0EA/541-0.0VCT-ND/1182217) | 0.24 | 1210i-3225m | 2 | $0.48
R3 | RES SMD 49.9K OHM 1% 1/10W 0402 | Panasonic Electronic Components | 49.9K | ERJ-2RKF4992X | P49.9KLCT-ND (https://www.digikey.com/product-detail/en/panasonic-electronic-components/ERJ-2RKF4992X/P49.9KLCT-ND/194427) | 0.1 | 0402i-1005m | 1 | $0.10
R4 | RES SMD 165K OHM 1% 1/10W 0603 | Panasonic Electronic Components | 165K | ERJ-3EKF1653V | P165KHCT-ND (https://www.digikey.com/product-detail/en/panasonic-electronic-components/ERJ-3EKF1653V/P165KHCT-ND/198192) | 0.1 | 0603i-1608m | 1 | $0.10
R5 | RES SMD 71.5K OHM 1% 1/10W 0603 | Panasonic Electronic Components | 71.5K | ERJ-3EKF7152V | P71.5KHCT-ND (https://www.digikey.com/product-detail/en/panasonic-electronic-components/ERJ-3EKF7152V/P71.5KHCT-ND/198494) | 0.1 | 0603i-1608m | 1 | $0.10
R6,R7 | RES SMD 10K OHM 1% 1/10W 0603 | Panasonic Electronic Components | 10.0K | ERJ-3EKF1002V | P10.0KHCT-ND (https://www.digikey.com/product-detail/en/panasonic-electronic-components/ERJ-3EKF1002V/P10.0KHCT-ND/198102) | 0.1 | 0603i-1608m | 2 | $0.20
R8 | RES SMD 261K OHM 1% 1/10W 0603 | Panasonic Electronic Components | 261K | ERJ-3EKF2613V | P261KHCT-ND (https://www.digikey.com/product-detail/en/panasonic-electronic-components/ERJ-3EKF2613V/P261KHCT-ND/198286) | 0.1 | 0603i-1608m | 1 | $0.10
R9 | RES SMD 17.4K OHM 1% 1/10W 0603 | Panasonic Electronic Components | 17.4K | ERJ-3EKF1742V | P17.4KHCT-ND (https://www.digikey.com/product-detail/en/panasonic-electronic-components/ERJ-3EKF1742V/P17.4KHCT-ND/198196) | 0.1 | 0603i-1608m | 1 | $0.10
R10 | RES SMD 75 OHM 1% 1/10W 0603 | Panasonic Electronic Components | 75 Ohm | ERJ-3EKF75R0V | P75.0HCT-ND (https://www.digikey.com/product-detail/en/panasonic-electronic-components/ERJ-3EKF75R0V/P75.0HCT-ND/198502) | 0.1 | 0603i-1608m | 1 | $0.10
U1 | IC OPAMP GP 1 CIRCUIT 8WSON | Texas Instruments |  | OPA855IDSGR | 296-53158-1-ND (https://www.digikey.com/products/en?keywords=296-53158-1-ND) | 6.61 | WSON-8 | 1 | $6.61
U2 | IC COMP 4.5NS R-R HS SOT23-6 | Texas Instruments |  | TLV3501AIDBVR | 296-35977-1-ND (https://www.digikey.com/products/en?keywords=296-35977-1-ND) | 2.78 | SOT23-6 | 1 | $2.78
 |  |  |  |  |  |  |  |  | $40.24 | Total
