Genturi/NewAlphaElectrical/SubSystems/AdditionalParts&CableAssys(120619).xlsx

Sheet: New Parts
Description | Genturi P/N | Manufacturer | Mfg P/N | Vendor | Vendor P/N | Price
0.250" (6.35mm) Quick Connect Female 14-16 AWG Crimp Connector Fully Insulated | 05-???? | TE Connectivity AMP Connectors | 3-350820-2 | Digi-Key | A27824-ND (https://www.digikey.com/products/en?keywords=A27824-ND) | 0.35
0.250" (6.35mm) Quick Connect Female 10-12 AWG Crimp Connector Fully Insulated | 05-???? | TE Connectivity AMP Connectors | 4-520448-2 | Digi-Key | A27831-ND (https://www.digikey.com/products/en?keywords=A27831-ND) | 0.37
Terminal Butt Splice, Inline, Individual Openings Connector Crimp 18-22 AWG Red | 05-???? | Molex | 191640013 | Digi-Key | WM18425-ND (https://www.digikey.com/products/en?keywords=WM18425-ND) | 0.89
Wire Pin Terminal Connector 8 AWG Solistrand Crimp | 05-???? | TE Connectivity AMP Connectors | 180599 | Digi-Key | A124400-ND (https://www.digikey.com/products/en?keywords=A124400-ND) | 1.6
Wire Pin Terminal Connector 10-12 AWG Plasti-Grip Crimp | 05-???? | TE Connectivity AMP Connectors | 165085 | Digi-Key | A99255-ND (https://www.digikey.com/products/en?keywords=A99255-ND) | 0.45
Wire Pin Terminal Connector 14-16 AWG Plasti-Grip Crimp | 05-???? | TE Connectivity AMP Connectors | 165171 | Digi-Key | A145081-ND (https://www.digikey.com/products/en?keywords=A145081-ND) | 0.46
Terminal Butt Splice, Closed End, Single Opening Connector Crimp 14-16 AWG Blue | 05-???? | TE Connectivity AMP Connectors | 328308 | Digi-Key | A27482-ND (https://www.digikey.com/products/en?keywords=A27482-ND) | 0.71
Terminal Butt Splice, Closed End, Single Opening Connector Crimp 10-12 AWG Yellow | 05-???? | TE Connectivity AMP Connectors | 328309 | Digi-Key | A27483-ND (https://www.digikey.com/product-detail/en/328309/A27483-ND/297958/?itemSeq=311418615) | 0.78
Terminal Butt Splice, Inline, Individual Openings Connector Crimp 10-12 AWG Yellow | 05-???? | TE Connectivity AMP Connectors | 34945 | Digi-Key | A27467-ND (https://www.digikey.com/product-detail/en/34945/A27467-ND/292948/?itemSeq=311420018) | 0.65
Terminal Butt Splice, Inline, Individual Openings Connector Crimp 14-16 AWG Blue | 05-???? | TE Connectivity AMP Connectors | 34071 | Digi-Key | A0998-ND (https://www.digikey.com/product-detail/en/34071/A0998-ND/172748/?itemSeq=311420264) | 0.24
Wire Pin Terminal Connector 18-22 AWG Avikrimp Crimp | 05-???? | Molex | 0192130009 | Digi-Key | WM18380-ND (https://www.digikey.com/product-detail/en/0192130009/WM18380-ND/279181/?itemSeq=311494906) | 0.51
Wire Pin Terminal Connector 22-26 AWG (0.1~0.4mm²) PIDG Crimp | 05-???? | TE Connectivity AMP Connectors | 165514-1 | Digi-Key | 165514-1-ND (https://www.digikey.com/product-detail/en/165514-1/165514-1-ND/1136542/?itemSeq=311538633) | 0.88
3 Position Rectangular Housing Connector Receptacle Natural 0.156" (3.96mm) | 05-???? | Molex | 9503031 | Digi-Key | WM2101-ND (https://www.digikey.com/product-detail/en/0009503031/WM2101-ND/26455/?itemSeq=311556126) | 0.19
4 Position Rectangular Housing Connector Receptacle Natural 0.156" (3.96mm) | 05-???? | Molex | 9503041 | Digi-Key | WM2102-ND (https://www.digikey.com/product-detail/en/0009503041/WM2102-ND/26457/?itemSeq=311556295) | 0.22
6.3A 250V AC DC Fuse Cartridge, Glass Holder 5mm x 20mm | 05-???? | Littelfuse Inc. | 021806.3HXP | Digi-Key | F2428-ND (https://www.digikey.com/product-detail/en/021806.3HXP/F2428-ND/777144/?itemSeq=311632756) | 1.02
8A 250V AC DC Fuse Cartridge, Glass Holder 5mm x 20mm | 05-???? | Littelfuse Inc. | 0218008.HXP | Digi-Key | F2423-ND (https://www.digikey.com/product-detail/en/0218008.HXP/F2423-ND/777139/?itemSeq=311632827) | 1.59
5A 250V AC DC Fuse Cartridge, Glass Holder 5mm x 20mm | 05-???? | Littelfuse Inc. | 0218005.HXP | Digi-Key | F2422-ND (https://www.digikey.com/product-detail/en/0218005.HXP/F2422-ND/777138/?itemSeq=311632678) | 1.02
10A 250V AC DC Fuse Cartridge, Glass Holder 5mm x 20mm | 05-???? | Littelfuse Inc. | 0218010.HXP | Digi-Key | F2425-ND (https://www.digikey.com/product-detail/en/0218010.HXP/F2425-ND/777141/?itemSeq=311632937) | 1.59
5 Position Rectangular Housing Connector Receptacle Natural 0.165" (4.20mm) | 05-???? | Molex | 39014051 | Digi-Key | WM23610-ND (https://www.digikey.com/product-detail/en/0039014051/WM23610-ND/930292/?itemSeq=311646884) | 0.61
Ring Terminal Connector 6 Stud Circular 18-22 AWG Crimp | 05-???? | Molex | 190730038 | Digi-Key | WM18295-ND (https://www.digikey.com/product-detail/en/molex/0190730038/WM18295-ND/279096) | 0.38
Ring Terminal Connector 6 Stud Circular 14-16 AWG Crimp | 05-???? | Molex | 190730067 | Digi-Key | WM18302-ND (https://www.digikey.com/product-detail/en/molex/0190730067/WM18302-ND/279103) | 0.42
Ring Terminal Connector 6 Stud Circular 10-12 AWG Crimp | 05-???? | Molex | 190730216 | Digi-Key | WM18308-ND (https://www.digikey.com/product-detail/en/molex/0190730216/WM18308-ND/279109) | 0.6
Ring Terminal Connector 8 Stud Circular 18-22 AWG Crimp | 05-???? | Molex | 190730013 | Digi-Key | WM18296-ND (https://www.digikey.com/product-detail/en/molex/0190730013/WM18296-ND/279097) | 0.4
Ring Terminal Connector 8 Stud Circular 14-16 AWG Crimp | 05-???? | Molex | 190730085 | Digi-Key | 23-0190730085-ND (https://www.digikey.com/product-detail/en/molex/0190730085/23-0190730085-ND/279104) | 0.35
Ring Terminal Connector 8 Stud Circular 10-12 AWG Crimp | 05-???? | Molex | 190730165 | Digi-Key | 23-0190730165-ND (https://www.digikey.com/product-detail/en/molex/0190730165/23-0190730165-ND/1952764) | 0.48
Ring Terminal Connector 10 Stud Circular 18-22 AWG Crimp | 05-???? | Molex | 190730017 | Digi-Key | WM18297-ND (https://www.digikey.com/product-detail/en/molex/0190730017/WM18297-ND/279098) | 0.4
Ring Terminal Connector 10 Stud Circular 14-16 AWG Crimp | 05-???? | Molex | 190730087 | Digi-Key | WM18304-ND (https://www.digikey.com/product-detail/en/molex/0190730087/WM18304-ND/279105) | 0.42
Ring Terminal Connector 10 Stud Circular 10-12 AWG Crimp | 05-???? | Molex | 190730170 | Digi-Key | WM18310-ND (https://www.digikey.com/product-detail/en/molex/0190730170/WM18310-ND/279111) | 0.58
18 AWG Hook-Up Wire 34/0.0071" Black 300V 100.0' (30.5m) | 60-???? | CNC Tech | 1569-18-1-0500-001-1-TS | Digi-Key | CN548B-100-ND (https://www.digikey.com/product-detail/en/cnc-tech/1569-18-1-0500-001-1-TS/CN548B-100-ND/7065766)
18 AWG Hook-Up Wire 34/0.0071" White 300V 100.0' (30.5m) | 60-???? | CNC Tech | 1569-18-1-0500-002-1-TS | Digi-Key | CN549W-100-ND (https://www.digikey.com/product-detail/en/cnc-tech/1569-18-1-0500-002-1-TS/CN549W-100-ND/7065767)
12 AWG Hook-Up Wire 65/30 Green 600V 100.0' (30.5m) | 60-???? | Alpha Wire | 3080 GR005 | Digi-Key | A3080G-100-ND (https://www.digikey.com/product-detail/en/alpha-wire/3080-GR005/A3080G-100-ND/281628)
HOOK-UP STRND 28AWG GREEN 100' | 60-???? | Alpha Wire | 3048 GR005 | Digi-Key | A3048G-100-ND (https://www.digikey.com/product-detail/en/alpha-wire/3048-GR005/A3048G-100-ND/266564)
HOOK-UP STRND 28AWG BLACK 100' | 60-???? | Alpha Wire | 3048 BK005 | Digi-Key | A3048B-100-ND (https://www.digikey.com/products/en?keywords=A3048B-100-ND)
HOOK-UP STRND 28AWG ORANGE 100' | 60-???? | Alpha Wire | 3048 OR005 | Digi-Key | A3048A-100-ND (https://www.digikey.com/products/en?keywords=A3048A-100-ND)
HOOK-UP STRND 28AWG YELLOW 100' | 60-???? | Alpha Wire | 3048 YL005 | Digi-Key | A3048Y-100-ND (https://www.digikey.com/products/en?keywords=A3048Y-100-ND)
HOOK-UP STRND 28AWG BLUE 100' | 60-???? | Alpha Wire | 3048 BL005 | Digi-Key | A3048L-100-ND (https://www.digikey.com/product-detail/en/alpha-wire/3048-BL005/A3048L-100-ND/266566)
HOOK-UP STRND 28AWG RED 100' | 60-???? | Alpha Wire | 3048 RD005 | Digi-Key | A3048R-100-ND (https://www.digikey.com/products/en?keywords=A3048R-100-ND)
HOOK-UP STRND 28AWG WHITE 100' | 60-???? | Alpha Wire | 3048 WH005 | Digi-Key | A3048W-100-ND (https://www.digikey.com/product-detail/en/alpha-wire/3048-WH005/A3048W-100-ND/266575)
HOOK-UP STRND 28AWG SLATE 100' | 60-???? | Alpha Wire | 3048 SL005 | Digi-Key | A3048S-100-ND (https://www.digikey.com/product-detail/en/alpha-wire/3048-SL005/A3048S-100-ND/266571)
HOOK-UP STRND 28AWG VIOLET 100' | 60-???? | Alpha Wire | 3048 VI005 | Digi-Key | A3048V-100-ND (https://www.digikey.com/product-detail/en/alpha-wire/3048-VI005/A3048V-100-ND/266573)
HOOK-UP STRND 28AWG BROWN 100' | 60-???? | Alpha Wire | 3048 BR005 | Digi-Key | A3048N-100-ND (https://www.digikey.com/products/en?keywords=A3048N-100-ND)
Non-Gendered Contact Tin 18-24 AWG Crimp | 05-???? | Molex | 8500106 | Digi-Key | WM2300-ND (https://www.digikey.com/products/en?keywords=08-50-0106) | 0.14
18 AWG Hook-Up Wire 16/30 White 600V 100.0' (30.5m) | 60-???? | Alpha Wire | 3075 WH005 | Digi-Key | A2103W-100-ND (https://www.digikey.com/products/en?keywords=A2103W-100-ND)
18 AWG Hook-Up Wire 16/30 Black 600V 100.0' (30.5m) | 60-???? | Alpha Wire | 3075 BK005 | Digi-Key | A2103B-100-ND (https://www.digikey.com/product-detail/en/alpha-wire/3075-BK005/A2103B-100-ND/204492)
22 AWG Hook-Up Wire 7/30 Black 600V 100.0' (30.5m) | 60-???? | Alpha Wire | 3071 BK005 | Digi-Key | A2101B-100-ND (https://www.digikey.com/product-detail/en/alpha-wire/3071-BK005/A2101B-100-ND/204452)
22 AWG Hook-Up Wire 7/30 White 600V 100.0' (30.5m) | 60-???? | Alpha Wire | 3071 WH005 | Digi-Key | A2101W-100-ND (https://www.digikey.com/product-detail/en/alpha-wire/3071-WH005/A2101W-100-ND/204453)
HOOK-UP STRND 26AWG BLACK 100' | 60-???? | Alpha Wire | 172619 BK005 | Digi-Key | A172619B-100-ND (https://www.digikey.com/products/en?keywords=A172619B-100-ND)
HOOK-UP STRND 26AWG YELLOW 100' | 60-???? | Alpha Wire | 172619 YL005 | Digi-Key | A172619Y-100-ND (https://www.digikey.com/products/en?keywords=A172619Y-100-ND)
HOOK-UP STRND 26AWG BLUE 100' | 60-???? | Alpha Wire | 172619 BL005 | Digi-Key | A172619L-100-ND (https://www.digikey.com/products/en?keywords=A172619L-100-ND)
HOOK-UP STRND 26AWG RED 100' | 60-???? | Alpha Wire | 172619 RD005 | Digi-Key | A172619R-100-ND (https://www.digikey.com/products/en?keywords=A172619R-100-ND)
HOOK-UP STRND 26AWG GREEN 100' | 60-???? | Alpha Wire | 172619 GR005 | Digi-Key | A172619G-100-ND (https://www.digikey.com/products/en?keywords=A172619G-100-ND)
HOOK-UP STRND 26AWG BROWN 100' | 60-???? | Alpha Wire | 172619 BR005 | Digi-Key | A172619N-100-ND (https://www.digikey.com/products/en?keywords=A172619N-100-ND)
HOOK-UP STRND 26AWG ORANGE 100' | 60-???? | Alpha Wire | 172619 OR005 | Digi-Key | A172619A-100-ND (https://www.digikey.com/products/en?keywords=A172619A-100-ND)
HOOK-UP STRND 26AWG WHITE 100' | 60-???? | Alpha Wire | 172619 WH005 | Digi-Key | A172619W-100-ND (https://www.digikey.com/products/en?keywords=A172619W-100-ND)
HOOK-UP STRND 26AWG VIOLET 100' | 60-???? | Alpha Wire | 172619 VI005 | Digi-Key | A172619V-100-ND (https://www.digikey.com/products/en?keywords=A172619V-100-ND)

Sheet: New Assemblies
Description | Genturi P/N | Where Used
ASSY, HARNESS, AC PWR INPUT, MOTOR I/O ELECTRONICS BOX | 60-???? | 50-0038
ASSY, HARNESS, AC PWR INPUT, ELECTRO-OPTICS CONTROL BOX | 60-???? | 50-0040
