Genturi/NewAlphaElectrical/TroyInterface(Scaretale 30-0007)/TroyInterfaceBoardBOM(Scaretale)30-0007.xlsx

Item # | Designation | Description | Manufacturer | Mfg P/N | Digi-Key P/N | Digi-Key Cost | Mouser P/N | Mouser Cost | Quantity | Extended Cost | Genturi P/N | Comment | Footprint
1 | J1 | CONN HEADER VERT 10POS 2.54MM | TE Connectivity AMP Connectors | 5-103639-9 | A33945-ND (https://www.digikey.com/products/en?keywords=5-103639-9) | $1.80 |  |  | 1 | $1.80 |  |  | TE_Conn_5-103639-9
2 | J2 | 15 Position D-Sub, High Density Receptacle, Female Sockets Connector | Würth Elektronik | 618015325223 | 732-618015325223-ND (https://www.digikey.com/products/en?keywords=618015325223) | $3.82 |  |  | 1 | $3.82 |  |  | Wurth_618015325223
3 | J3 | 15 Position D-Sub, High Density Plug, Male Pins Connector | Amphenol ICC (Commercial Products) | L717HDE15PD1CH4R | L717HDE15PD1CH4R-ND (https://www.digikey.com/product-detail/en/amphenol-icc-commercial-products/L717HDE15PD1CH4R/L717HDE15PD1CH4R-ND/4886540) | $1.81 |  |  | 1 | $1.81 |  |  | Amphenol_L717HDE15PD1CH4R
4 | J4 | Connector Header Through Hole 8 position 0.100" (2.54mm) | TE Connectivity AMP Connectors | 5-103669-7 | A33904-ND (https://www.digikey.com/products/en?keywords=5-103669-7) | $1.59 |  |  | 1 | $1.59 |  |  | TE_Conn_5-103669-7
5 | C1,C2,C3 | 100µF 16V Aluminum Polymer Capacitor Radial, Can - SMD 20mOhm 2000 Hrs @ 105°C | Würth Elektronik | 875105344010 | 732-6425-1-ND (https://www.digikey.com/products/en?keywords=732-6425-1-ND) | $0.63 |  |  | 3 | $1.89 |  |  | Wurth_875105344010
6 | R1,R2,R3,R4 | RES SMD 0 OHM JUMPER 1/2W 1210 | Vishay Dale | CRCW12100000Z0EA | 541-0.0VCT-ND (https://www.digikey.com/product-detail/en/vishay-dale/CRCW12100000Z0EA/541-0.0VCT-ND/1182217) | $0.24 |  |  | 4 | $0.96 |  |  | 1210i-3225m
7 | R5,R6 | RES SMD 100 OHM 1% 1/10W 0603 | Panasonic Electronic Components | ERJ-3EKF1000V | P100HCT-ND (https://www.digikey.com/product-detail/en/panasonic-electronic-components/ERJ-3EKF1000V/P100HCT-ND/198109) | $0.10 |  |  | 2 | $0.20 |  |  | 0603i-1608m
8 | C4,C5,C6,C7,C8 | CAP CER 0.1UF 50V C0G 1206 | TDK Corporation | C3216C0G1H104J160AA | 445-7694-1-ND (https://www.digikey.com/products/en?keywords=445-7694-1-ND) | $0.67 |  |  | 5 | $3.35 |  |  | 1206i-3216m
9 | U1,U2 | 6 channel digital isolator | Texas Instruments | ISO7761QDBQQ1 | 296-ISO7761QDBQQ1-ND (https://www.digikey.com/products/en?keywords=ISO7761QDBQQ1) | $3.92 |  |  | 2 | $7.84 |  |  | SSOP-16
