Genturi/NewAlphaElectrical/MotorInterface(Riddler 30-0004)/MotorInterfaceBoardBOM(Riddler).xlsx

Item # | Designation | Description | Manufacturer | Mfg P/N | Digi-Key P/N | Digi-Key Cost | Mouser P/N | Mouser Cost | Quantity | Extended Cost | Genturi P/N | Comment | Package
1 | J12 | CONN HEADER VERT 2POS 2.54MM | TE Connectivity AMP Connectors | 5-103669-1 | A33893-ND (https://www.digikey.com/product-detail/en/te-connectivity-amp-connectors/5-103669-1/A33893-ND/1000909) | $0.79 |  |  | 1 | $0.79 |  | Output | TE-Con_5-103669-1
2 | J3,J5,J7,J9,J11 | CONN HEADER VERT 3POS 2.54MM | TE Connectivity AMP Connectors | 5-103669-2 | A33895-ND (https://www.digikey.com/product-detail/en/te-connectivity-amp-connectors/5-103669-2/A33895-ND/1122458) | $1.15 |  |  | 5 | $5.75 |  | Output | TE-Con_5-103669-2
3 | J2,J4,J6, J8,J10 | CONN HEADER VERT 4POS 2.54MM | TE Connectivity AMP Connectors | 5-103669-3 | A33897-ND (https://www.digikey.com/product-detail/en/te-connectivity-amp-connectors/5-103669-3/A33897-ND/1122460) | $0.91 |  |  | 5 | $4.55 |  | Output | TE-Con_5-103669-3
4 | J13 | CONN HEADER VERT 5POS 2.54MM | TE Connectivity AMP Connectors | 5-103669-4 | A33899-ND (https://www.digikey.com/product-detail/en/te-connectivity-amp-connectors/5-103669-4/A33899-ND/1122462) | $1.30 |  |  | 1 | $1.30 |  | Output | TE-Con_5-103669-4
5 | J14 | CONN HEADER VERT 6POS 2.54MM | TE Connectivity AMP Connectors | 5-103669-5 | A35016-ND (https://www.digikey.com/product-detail/en/te-connectivity-amp-connectors/5-103669-5/A35016-ND/1165260) | $1.42 |  |  | 1 | $1.42 |  | Output | TE-Con_5-103669-5
6 | J1 | CONN D-SUB RCPT 50POS R/A SOLDER | NorComp Inc. | 173-E50-213R141 | 173-150FEA-ND (https://www.digikey.com/product-detail/en/norcomp-inc/173-E50-213R141/173-150FEA-ND/955555) | $21.24 |  |  | 1 | $21.24 |  | Input | NorComp_173-E50-213R141
7 | J15,J16 | CONN HEADER VERT 3POS 3MM | Molex | 0436500315 | WM1918-ND (https://www.digikey.com/product-detail/en/molex/0436500315/WM1918-ND/283462) | $1.03 |  |  | 2 | $2.06 |  | 1 In; 1 Out | Molex_0436500315
8 | J17,J18 | CONN HEADER VERT 4POS 3MM | Molex | 0430450412 | WM1790-ND (https://www.digikey.com/product-detail/en/molex/0430450412/WM1790-ND/252503) | $1.10 |  |  | 2 | $2.20 |  | 1 In; 1 Out | Molex_0430450412
9 | J19,J20,J21,J22 | CONN SMA JACK R/A 50 OHM PCB | TE Connectivity AMP Connectors | 5-1814400-1 | A97593-ND (https://www.digikey.com/product-detail/en/te-connectivity-amp-connectors/5-1814400-1/A97593-ND/1755981) | $2.61 |  |  | 4 | $10.44 |  | 2 In; 2 Out | TE-Con_5-1814400-1
10 | C1,C2,C3,C4,C5,C7 | CAP TANT 10UF 10% 16V 1411 | AVX Corporation | TPSB106K016R0500 | 478-5230-1-ND (https://www.digikey.com/product-detail/en/avx-corporation/TPSB106K016R0500/478-5230-1-ND/1913300) | $0.62 |  |  | 5 | $3.10 |  |  | 1411i-3528m
11 | C6 | CAP CHIP POLY 10UF 35V 2917 | AVX Corporation | TCQD106M035R0070 | 478-13149-1-ND (https://www.digikey.com/product-detail/en/avx-corporation/TCQD106M035R0070/478-13149-1-ND/9948664) | $1.80 |  |  | 1 | $1.80 |  |  | 2917i-7343m
