Genturi/NewAlphaElectrical/MarcoInterface(Arabesque 30-0003)/MarcoInterfaceBoardBOM(Arabesque).xlsx

Item # | Designation | Description | Manufacturer | Mfg P/N | Digi-Key P/N | Digi-Key Cost | Mouser P/N | Mouser Cost | Quantity | Extended Cost | Genturi P/N | Comment | Package
1 | J11 | CONN SMA JACK R/A 50 OHM PCB | TE Connectivity AMP Connectors | 5-1814400-1 | A97593-ND (https://www.digikey.com/product-detail/en/te-connectivity-amp-connectors/5-1814400-1/A97593-ND/1755981) | $2.61 |  |  | 1 | $2.61 |  |  | TE-Con_5-1814400-1
2 | J3,J12 | CONN RCPT USB2.0 MICRO B SMD R/A | Amphenol ICC (FCI) | 10118192-0001LF | 609-4613-1-ND (https://www.digikey.com/products/en?keywords=609-4613-1-ND) | 0.43 |  |  | 2 | $0.86 |  |  | Amphenol_10118192-0001LF
3 | J5,J6,J7,J8 | WR-DSUB FEMALE ANGLED PCB CONNEC | Würth Elektronik | 618009233821 | 732-618009233821-ND (https://www.digikey.com/products/en?keywords=618009233821) | $0.91 |  |  | 4 | $3.64 |  |  | Wurth_618009233821
4 | J1 | CONN HEADER R/A 4POS 4.2MM | Molex | 0026013115 | WM13112-ND (https://www.digikey.com/product-detail/en/molex/0026013115/WM13112-ND/4119889) | $1.12 |  |  | 1 | $1.12 |  |  | Molex_0026013115
5 | J2 | CONN HEADER R/A 8POS 3MM | Molex | 0430450800 | WM1816-ND (https://www.digikey.com/product-detail/en/molex/0430450800/WM1816-ND/252529) | $1.91 |  |  | 1 | $1.91 |  |  | Molex_0430450800
6 | J10 | WR-DSUB FEMALE HIGH DENSITY ANGL | Würth Elektronik | 618015325223 | 732-618015325223-ND (https://www.digikey.com/products/en?keywords=618015325223) | $4.02 |  |  | 1 | $4.02 |  |  | Wurth_618015325223
7 | J9 | I/O Connectors 24P SMT RECPT RA | Hirose Connector | ST60-24P(30) | H125266CT-ND (https://www.digikey.com/product-detail/en/hirose-electric-co-ltd/ST60-24P-30/H125266CT-ND/5994752) | $2.23 | 798-ST60-24P30 (https://www.mouser.com/ProductDetail/Hirose-Connector/ST60-24P30) | 2.02 | 1 | $2.02 |  |  | Hirose_ST60-24P30
8 | L1 | FIXED IND 330UH 1.7A 340 MOHM | Pulse Electronics Power | PA4320.334NLT | 553-3685-1-ND (https://www.digikey.com/product-detail/en/pulse-electronics-power/PA4320.334NLT/553-3685-1-ND/6555212) | $2.95 |  |  | 1 | $2.95 |  |  | Pulse_PA4320
9 | C1,C2,C6,C12,C16,C19,C20,C22,C30,C33 | CAP CER 0.22UF 25V C0G/NP0 1210 | KEMET | C1210X224J3GACAUTO | 399-20368-1-ND (https://www.digikey.com/product-detail/en/kemet/C1210X224J3GACAUTO/399-20368-1-ND/9925810) | $2.10 |  |  | 10 | $21.00 |  |  | 1210i-3225m
10 | C3,C4 | CAP TANT 220UF 10% 10V 2917 | AVX Corporation | TPSD227K010R0040 | 478-9181-1-ND (https://www.digikey.com/product-detail/en/avx-corporation/TPSD227K010R0040/478-9181-1-ND/4562046) | $2.66 |  |  | 2 | $5.32 |  |  | 2917i-7343m
11 | R1,R2,R3,R6,R7,R9,R10,R12,R13,R14,R15,R16,R17,R18,R19,R20,R21,R22 | RES SMD 0 OHM JUMPER 1/2W 1210 | Vishay Dale | CRCW12100000Z0EA | 541-0.0VCT-ND (https://www.digikey.com/product-detail/en/vishay-dale/CRCW12100000Z0EA/541-0.0VCT-ND/1182217) | $0.24 |  |  | 18 | $4.32 |  |  | 1210i-3225m
12 | U1,U2,U3,U4 | IC VREF SHUNT 1.225V SOT23 | Texas Instruments | LM4041C12IDBZR | 296-20916-1-ND (https://www.digikey.com/product-detail/en/texas-instruments/LM4041C12IDBZR/296-20916-1-ND/1216888) | $0.92 |  |  | 4 | $3.68 |  |  | SOT-23-3
13 | D1,D2,D3,D4 | DIODE SCHOTTKY 30V 200MA SOT23-3 | ON Semiconductor | BAT54LT1G | BAT54LT1GOSCT-ND (https://www.digikey.com/product-detail/en/on-semiconductor/BAT54LT1G/BAT54LT1GOSCT-ND/917810) | $0.15 |  |  | 4 | $0.60 |  |  | SOT-23-3
14 | C7,C13,C17,C21,C23,C31,C34 | CAP TANTALUM 47UF 35V 2917 | KEMET | T521X476M035ATE030 | 399-5937-1-ND (https://www.digikey.com/product-detail/en/kemet/T521X476M035ATE030/399-5937-1-ND/2640607) | $4.63 |  |  | 7 | $32.41 |  |  | 2917i-7343m
15 | C8,C10,C14,C18,C25 | CAP TANT POLY 1UF 25V 0805 | AVX Corporation | TCJP105M025R0500 | 478-8995-1-ND (https://www.digikey.com/product-detail/en/avx-corporation/TCJP105M025R0500/478-8995-1-ND/4561861) | $1.13 |  |  | 5 | $5.65 |  |  | 0805i-2012m
16 | R4,R5,R8,R11 | RES SMD 1K OHM 1% 1/10W 0603 | Panasonic Electronic Components | ERJ-3EKF1001V | P1.00KHCT-ND (https://www.digikey.com/product-detail/en/panasonic-electronic-components/ERJ-3EKF1001V/P1.00KHCT-ND/198071) | $0.10 |  |  | 4 | $0.40 |  |  | 0603i-1608m
17 | C9,C11,C15,C19,C27,C28,C29,C32, C35 | CAP CER 0.1UF 50V C0G 1206 | TDK Corporation | C3216C0G1H104J160AA | 445-7694-1-ND (https://www.digikey.com/products/en?keywords=445-7694-1-ND) | $0.67 |  |  | 9 | $6.03 |  |  | 1206i-3216m
18 | U6,U7,U8,U9 | IC BUF NON-INVERT 5.5V SOT23-5 | Texas Instruments | SN74LVC1G17DBVR | 296-11933-1-ND (https://www.digikey.com/product-detail/en/texas-instruments/SN74LVC1G17DBVR/296-11933-1-ND/389050) | $0.33 |  |  | 4 | $1.32 |  |  | SOT-23-5
19 | U5 | IC REG LINEAR 3.3V 100MA SOT23-5 | Microchip Technology | TC1015-3.3VCT713 | TC1015-3.3VCT713CT-ND (https://www.digikey.com/product-detail/en/microchip-technology/TC1015-3.3VCT713/TC1015-3.3VCT713CT-ND/1979796) | $0.36 |  |  | 1 | $0.36 |  |  | SOT-23-5
20 | C26 | CAP CER 470PF 50V C0G/NP0 0603 | AVX Corporation | 06035A471JAT2A | 478-1183-1-ND (https://www.digikey.com/product-detail/en/avx-corporation/06035A471JAT2A/478-1183-1-ND/564215) | $0.13 |  |  | 1 | $0.13 |  |  | 0603i-1608m
21 | C24 | CAP TANT 10UF 10% 16V 1411 | AVX Corporation | TPSB106K016R0500 | 478-5230-1-ND (https://www.digikey.com/product-detail/en/avx-corporation/TPSB106K016R0500/478-5230-1-ND/1913300) | $0.62 |  |  | 1 | $0.62 |  |  | 1411i-3528m
22 | J13 | CONN HEADER VERT 10POS 2.54MM | TE Connectivity AMP Connectors | 5-103908-9 | A33907-ND (https://www.digikey.com/product-detail/en/te-connectivity-amp-connectors/5-103908-9/A33907-ND/1122470) | $2.34 |  |  | 1 | $2.34 |  |  | TE-Con_5-103908-9
23 | R24 | RES SMD 100 OHM 1% 1/8W 0805 | Panasonic Electronic Components | ERJ-6ENF1000V | P100CCT-ND (https://www.digikey.com/product-detail/en/panasonic-electronic-components/ERJ-6ENF1000V/P100CCT-ND/118668) | $0.10 |  |  | 1 | $0.10 |  |  | 0805i-2012m
24 | R23 | RES SMD 49.9 OHM 1% 1/8W 0805 | Panasonic Electronic Components | ERJ-6ENF49R9V | P49.9CCT-ND (https://www.digikey.com/products/en/resistors/chip-resistor-surface-mount/52?k=resistor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) | $0.10 |  |  | 1 | $0.10 |  |  | 0805i-2012m
 |  |  |  |  |  |  |  |  | Total | $103.51
missing | J4
