Genturi/NewAlphaElectrical/Notes/MajorComponents.xlsx

Sheet: PCB Major Components
Designation | Description | Manufacture | Mfg P/N | Quantity | Purpose
J1 | Connector Header Through Hole 3 position 0.100" (2.54mm) | TE Connectivity AMP Connectors | 5-103669-2 | 1 | Power input from internal supply (Mean Well: PSC-100B-C)
J2 | Connector Header Through Hole 16 position 0.100" (2.54mm) | TE Connectivity AMP Connectors | 5103308-3 | 1 | Input from internal DAQ (Measurement Computing: USB-3101)
J3 | Connector Header Through Hole 16 position 0.100" (2.54mm) | TE Connectivity AMP Connectors | 5103308-3 | 1 | Input from internal DAQ (Measurement Computing: USB-1808)
J4 | 37 Position D-Sub Receptacle, Female Sockets Connector | Amphenol ICC (Commercial Products) | L77SDC37SOL2 | 1 | Input from internal DAQ (Measurement Computing: USB-DIO24/37)
J5 | 9 Position D-Sub Receptacle, Female Sockets Connector | Würth Elektronik | 618009233821 | 1 | External interface to bias the cartridge
J6 | 25 Position D-Sub Receptacle, Female Sockets Connector | Amphenol ICC (FCI) | D25S13A4GL00LF | 1 | External interface to expansion instrumentation
J7 | 15 Position D-Sub, High Density Receptacle, Female Sockets Connector | Würth Elektronik | 618015325223 | 1 | External interface for I/O expansion
K1-K24 | General Purpose Relay SPDT (1 Form C) Through Hole | TE Connectivity Potter & Brumfield Relays | V23026A1002B201 | 24 | Internal switching

Sheet: Jukka 2 Major Components
Item Number | PartNo | Revision | Description | Qty | MFR | MFRPN | Vendor | VendorNo
 | TBD |  | CARTRIDGE BIAS ELECTRONICS BOX BASE | 1 |  |  | Genturi
 | TBD |  | CARTRIDGE BIAS ELECTRONICS BOX COVER | 1 |  |  | Genturi
 | TBD |  | CONVERTER, AC/DC, 2 OUTPUT, +27.6V/2.4A & -27.2V/1.4A | 1 | MEAN WELL USA Inc. | PSC-100B-C | Digi-Key | 1866-3902-ND
 | 30-0008 | 1 | PCB ASSEMBLY, CARTRIDGE EMF BIAS (Amaranth) | 1 |  |  | Genturi
 | 06-TBD |  | DAQ MODULE, 8 CHANNEL DAC, 8 DIGITAL I/O, USB | 1 | MEASUREMENT COMPUTING | USB-3103 | MEASUREMENT COMPUTING | USB-3103
 | 06-TBD |  | DAQ MODULE, 8 CHANNEL ADC, 2 CHANNEL DAC, 4 GPIO | 1 | MEASUREMENT COMPUTING | USB-1808 | MEASUREMENT COMPUTING | USB-1808
 | 06-0018 |  | INTERFACE MODULE, 24 DIGITAL I/O, USB | 1 | MEASUREMENT COMPUTING | USB-DIO24/37 | MEASUREMENT COMPUTING | USB-DIO24/37
 | 06-TBD |  | 7 port powered USB hub | 1 | Anker | A7505112 | Amazon
 | 06-0025 |  | Power Entry Connector Receptacle, Male Blades - Module IEC 320-C14 Panel Mount, Snap-In | 1 | Bulgin | BZH01/Z0000/11 | DIGI-KEY | 708-2406-ND
 | 60-TBD |  | ASSY, HARNESS, USB-3103 TO PCB, CARTRIDGE BIAS ELECTROINICS BOX | 1 |  |  | Genturi
 | 60-TBD |  | ASSY, HARNESS, USB-1808 TO PCB, CARTRIDGE BIAS ELECTROINICS BOX | 1 |  |  | Genturi
 | 60-TBD |  | ASSY, HARNESS, POWER SUPPLY TO PCB, CARTRIDGE BIAS ELECTRONICS BOX | 1 |  |  | Genturi
 | 60-TBD |  | ASSY, HARNESS, AC INPUT TO POWER SUPPLY, CARTRDIGE BIAS ELECTRONICS BOX | 1 |  |  | Genturi
