Genturi/NewAlphaElectrical/Schematic/Amaranth_BOM_020620_0645.xlsx

Item | Quantity | Reference | Part | Manufacturer | Mfg P/N | Digi-Key P/N | Cost | Extended Cost | Spec Sheet | Gentrui Footprint
1 | 4 | C1,C2,C3,C4 | 220uF/50V | Panasonic Electronic Components | EEH-ZS1H221P | P124104CT-ND (https://www.digikey.com/product-detail/en/panasonic-electronic-components/EEH-ZS1H221P/P124104CT-ND/9696300) | $2.65 | $10.60 | Y | Panasonic_EEH-ZS1H221P
2 | 14 | C5,C9,C10,C12,C13,C15, | 10uF/50V | AVX Corporation | 12105C106K4Z2A | 478-12496-1-ND (https://www.digikey.com/product-detail/en/avx-corporation/12105C106K4Z2A/478-12496-1-ND/9748463) | $1.08 | $15.12 | Y | 1210i-3225m
 |  | C16,C18,C19,C77,C82,C87,
 |  | C88,C89
3 | 24 | C6,C7,C21,C22,C35,C36, | 1uF/50V | KEMET | C1206C105K5RACAUTO | 399-7011-1-ND (https://www.digikey.com/product-detail/en/kemet/C1206C105K5RACAUTO/399-7011-1-ND/3314519) | $0.36 | $8.64 | Y | 1206i-3216m
 |  | C37,C38,C39,C40,C65,C66,
 |  | C68,C70,C73,C74,C75,C76,
 |  | C78,C79,C83,C84,C85,C86
4 | 2 | C8,C80 | 22uF/20V | KEMET | T520V226M020ATE040 | 399-4740-1-ND (https://www.digikey.com/product-detail/en/kemet/T520V226M020ATE040/399-4740-1-ND/1001111) | $3.39 | $6.78 | Y | 2917i-7343m
5 | 1 | C11 | 0.018uF/200V | KEMET | C1206C183J2GACAUTO | 399-11575-1-ND (https://www.digikey.com/product-detail/en/kemet/C1206C183J2GACAUTO/399-11575-1-ND/4860194) | $0.56 | $0.56 | Y | 1206i-3216m
6 | 21 | C14,C23,C24,C25,C26,C32, | 0.1uF/50V | TDK Corporation | C3216C0G1H104J160AA | 445-7694-1-ND (https://www.digikey.com/products/en?keywords=445-7694-1-ND) | $0.67 | $14.07 | Y | 1206i-3216m
 |  | C34,C42,C44,C46,C48,C50,
 |  | C52,C54,C56,C58,C60,C62,
 |  | C64,C69,C72
7 | 1 | C17 | 0.068uF/50V | TDK Corporation | CGA5L2C0G1H683J160AA | 445-6983-1-ND (https://www.digikey.com/product-detail/en/tdk-corporation/CGA5L2C0G1H683J160AA/445-6983-1-ND/2673001) | $0.63 | $0.63 | Y | 1206i-3216m
8 | 1 | C20 | 0.39uF/16V | KEMET | C0603X394K4RACAUTO | 399-20487-1-ND (https://www.digikey.com/product-detail/en/kemet/C0603X394K4RACAUTO/399-20487-1-ND/9925091) | $0.61 | $0.61 | Y | 0603i-1608m
9 | 20 | C27,C28,C29,C30,C31,C33, | 10uF/35V | AVX Corporation | TCQD106M035R0070 | 478-13149-1-ND (https://www.digikey.com/product-detail/en/avx-corporation/TCQD106M035R0070/478-13149-1-ND/9948664) | $1.80 | $36.00 | Y | 2917i-7343m
 |  | C41,C43,C45,C47,C49,C51,
 |  | C53,C55,C57,C59,C61,C63,
 |  | C67,C71
10 | 1 | J1 | 5-103669-2 | TE Connectivity AMP Connectors | 5-103669-2 | A33895-ND (https://www.digikey.com/products/en?keywords=5-103669-2) | $1.18 | $1.18 | Y | TE-Con_5-103669-2
11 | 2 | J2,J3 | 5103308-3 | TE Connectivity AMP Connectors | 5103308-3 | A33163-ND (https://www.digikey.com/product-detail/en/te-connectivity-amp-connectors/5103308-3/A33163-ND/1114901) | $1.95 | $3.90 | Y | TE_Conn_5103308-3
12 | 1 | J4 | L77SDC37SOL2 | Amphenol ICC (Commercial Products) | L77SDC37SOL2 | L77SDC37SOL2-ND (https://www.digikey.com/product-detail/en/amphenol-icc-commercial-products/L77SDC37SOL2/L77SDC37SOL2-ND/4888704) | $2.43 | $2.43 | Y | Amphenol_L77SDC37SOL2
13 | 1 | J5 | 618009233821 | Würth Elektronik | 618009233821 | 732-618009233821-ND (https://www.digikey.com/products/en?keywords=618009233821) | $3.82 | $3.82 | Y | Wurth_618009233821
14 | 1 | J6 | D25S13A4GL00LF | Amphenol ICC (FCI) | D25S13A4GL00LF | 609-1506-ND (https://www.digikey.com/product-detail/en/amphenol-icc-fci/D25S13A4GL00LF/609-1506-ND/1001820) | $3.30 | $3.30 | Y | Amphenol_D25S13A4GL00LF
15 | 1 | J7 | 618015325223 | Würth Elektronik | 618015325223 | 732-618015325223-ND (https://www.digikey.com/products/en?keywords=618015325223) | $3.82 | $3.82 | Y | Wurth_618015325223
16 | 1 | J8 | TSW-105-14-L-D-LL | Samtec Inc. | TSW-105-14-L-D-LL | SAM15946-ND (https://www.digikey.com/product-detail/en/samtec-inc/TSW-105-14-L-D-LL/SAM15946-ND/2685922) | $1.05 | $1.05 | Y | Samtec_TSW-105-14-L-D-LL
17 | 24 | K1,K2,K3,K4,K5,K6,K7,K8, | V23026A1002B201 | TE Connectivity Potter & Brumfield Relays | V23026A1002B201 | PB283-ND (https://www.digikey.com/product-detail/en/te-connectivity-potter-brumfield-relays/V23026A1002B201/PB283-ND/254500) | $7.08 | $169.92 | Y | TE_Conn_V23026A1002B201
 |  | K9,K10,K11,K12,K13,K14,
 |  | K15,K16,K17,K18,K19,K20,
 |  | K21,K22,K23,K24
18 | 2 | L1,L2 | 330uH | Pulse Electronics Power | PA4320.334NLT | 553-3685-1-ND (https://www.digikey.com/product-detail/en/pulse-electronics-power/PA4320.334NLT/553-3685-1-ND/6555212) | $2.95 | $5.90 | Y | Pulse_PA4320
19 | 1 | R1 | 2.61Meg/1% | Vishay Dale | CRCW06032M61FKEA | 541-2.61MHCT-ND (https://www.digikey.com/products/en/resistors/chip-resistor-surface-mount/52?k=res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) | $0.10 | $0.10 | Y | 0603i-1608m
20 | 1 | R2 | 523K/1% | Panasonic Electronic Components | ERJ-3EKF5233V | P523KHCT-ND (https://www.digikey.com/product-detail/en/panasonic-electronic-components/ERJ-3EKF5233V/P523KHCT-ND/198430) | $0.10 | $0.10 | Y | 0603i-1608m
21 | 8 | R3,R14,R27,R34,R41,R48, | 1.4K/1% | Panasonic Electronic Components | ERJ-3EKF1401V | P1.40KHCT-ND (https://www.digikey.com/product-detail/en/panasonic-electronic-components/ERJ-3EKF1401V/P1.40KHCT-ND/198085) | $0.10 | $0.80 | Y | 0603i-1608m
 |  | R55,R62
22 | 8 | R4,R15,R28,R35,R42,R49, | 1.96K/1% | Panasonic Electronic Components | ERJ-3EKF1961V | P1.96KHCT-ND (https://www.digikey.com/product-detail/en/panasonic-electronic-components/ERJ-3EKF1961V/P1.96KHCT-ND/198099) | $0.10 | $0.80 | Y | 0603i-1608m
 |  | R56,R63
23 | 8 | R5,R18,R31,R38,R45,R52, | 10K/1% | Panasonic Electronic Components | ERJ-3EKF1002V | P10.0KHCT-ND (https://www.digikey.com/product-detail/en/panasonic-electronic-components/ERJ-3EKF1002V/P10.0KHCT-ND/198102) | $0.10 | $0.80 | Y | 0603i-1608m
 |  | R59,R66
24 | 16 | R6,R7,R17,R19,R30,R32, | 1K/1% | Panasonic Electronic Components | ERJ-3EKF1001V | P1.00KHCT-ND (https://www.digikey.com/product-detail/en/panasonic-electronic-components/ERJ-3EKF1001V/P1.00KHCT-ND/198071) | $0.10 | $1.60 | Y | 0603i-1608m
 |  | R37,R39,R44,R46,R51,R53,
 |  | R58,R60,R65,R67
25 | 16 | R8,R9,R16,R20,R29,R33, | 4.99K/1% | Panasonic Electronic Components | ERJ-3EKF4991V | P4.99KHCT-ND (https://www.digikey.com/product-detail/en/panasonic-electronic-components/ERJ-3EKF4991V/P4.99KHCT-ND/198373) | $0.10 | $1.60 | Y | 0603i-1608m
 |  | R36,R40,R43,R47,R50,R54,
 |  | R57,R61,R64,R68
26 | 1 | R10 | 133K/1% | Panasonic Electronic Components | ERJ-3EKF1333V | P133KHCT-ND (https://www.digikey.com/product-detail/en/panasonic-electronic-components/ERJ-3EKF1333V/P133KHCT-ND/198156) | $0.10 | $0.10 | Y | 0603i-1608m
27 | 1 | R11 | 665K/1% | Panasonic Electronic Components | ERJ-3EKF6653V | P665KHCT-ND (https://www.digikey.com/product-detail/en/panasonic-electronic-components/ERJ-3EKF6653V/P665KHCT-ND/198479) | $0.10 | $0.10 | Y | 0603i-1608m
28 | 16 | R12,R13,R21,R22,R23,R24, | 15.8K/1% | Panasonic Electronic Components | ERJ-3EKF1582V | P15.8KHCT-ND (https://www.digikey.com/product-detail/en/panasonic-electronic-components/ERJ-3EKF1582V/P15.8KHCT-ND/198176) | $0.10 | $1.60 | Y | 0603i-1608m
 |  | R25,R26,R69,R70,R71,R72,
 |  | R73,R74,R75,R76
29 | 1 | R77 | 0 Ohm | Vishay Dale | CRCW12100000Z0EA | 541-0.0VCT-ND (https://www.digikey.com/product-detail/en/vishay-dale/CRCW12100000Z0EA/541-0.0VCT-ND/1182217) | $0.24 | $0.24 | Y | 1210i-3225m
30 | 1 | U1 | P78E05-1000 | CUI Inc. | P78E05-1000 | 102-5018-ND (https://www.digikey.com/products/en?keywords=P78E05-1000) | $2.96 | $2.96 | Y | CUI_P78E05-1000
31 | 2 | U2,U5 | LT3080-1 | Linear Technology/Analog Devices | LT3080EDD-1#PBF | LT3080EDD-1#PBF-ND (https://www.digikey.com/product-detail/en/linear-technology-analog-devices/LT3080EDD-1-PBF/LT3080EDD-1-PBF-ND/1931064) | $4.56 | $9.12 | Y | 8-DFN
32 | 2 | U3,U6 | LT3090EDD | Linear Technology/Analog Devices | LT3090EDD#PBF | LT3090EDD#PBF-ND (https://www.digikey.com/products/en?keywords=LT3090EDD%23PBF-ND) | $5.20 | $10.40 | Y | 10-DFN
33 | 8 | U4,U8,U9,U10,U11,U12,U13, | ADA4522-4 | Linear Technology/Analog Devices | ADA4522-4ARZ | ADA4522-4ARZ-ND (https://www.digikey.com/product-detail/en/analog-devices-inc/ADA4522-4ARZ/ADA4522-4ARZ-ND/5583069) | $8.45 | $67.60 | Y | SOIC-14
 |  | U14
34 | 2 | U7,U15 | ADA4177-4 | Linear Technology/Analog Devices | ADA4177-4ARZ-R7 | ADA4177-4ARZ-R7CT-ND (https://www.digikey.com/products/en/integrated-circuits-ics/linear-amplifiers-instrumentation-op-amps-buffer-amps/687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) | $8.80 | $17.60 | Y | SOIC-14
35 | 4 | U16,U22,U23,U24 | TPL7407LA | Texas Instruments | TPL7407LADR | 296-51862-1-ND (https://www.digikey.com/product-detail/en/texas-instruments/TPL7407LADR/296-51862-1-ND/9746225) | $0.64 | $2.56 | Y | SOIC-16
36 | 1 | U17 | V7812-500 | CUI Inc. | V7812-500 | 102-1712-ND (https://www.digikey.com/product-detail/en/cui-inc/V7812-500/102-1712-ND/1828605) | $6.49 | $6.49 | Y | CUI_V7812-500
37 | 2 | U19,U20 | MC74HC08A | ON Semiconductor | MC74HC08ADR2G | MC74HC08ADR2GOSCT-ND (https://www.digikey.com/product-detail/en/on-semiconductor/MC74HC08ADR2G/MC74HC08ADR2GOSCT-ND/1139713) | $0.45 | $0.90 | Y | SOIC-14
38 | 2 | U25,U26 | MC74HC32 | ON Semiconductor | MC74HC32ADR2G | MC74HC32ADR2GOSCT-ND (https://www.digikey.com/product-detail/en/on-semiconductor/MC74HC32ADR2G/MC74HC32ADR2GOSCT-ND/1139723) | $0.44 | $0.88 | Y | SOIC-14
Total | 223 |  |  |  |  |  |  | $414.68
