Genturi/NewAlphaElectrical/JukkaInterface(Alpenglow 30-0005)/JukkaInterfaceBoardBOM(Alpenglow).xlsx

Item # | Designation | Description | Manufacturer | Mfg P/N | Digi-Key P/N | Digi-Key Cost | Mouser P/N | Mouser Cost | Quantity | Extended Cost | Genturi P/N | Comment | Foot print
1 | J3,J4,J5,J6,J7,J8,J9,J10,J11,J12,J13,J14 | CONN SMA JACK R/A 50 OHM PCB | TE Connectivity AMP Connectors | 5-1814400-1 | A97593-ND (https://www.digikey.com/product-detail/en/te-connectivity-amp-connectors/5-1814400-1/A97593-ND/1755981) | $2.61 |  |  | 12 | $31.32 |  |  | TE-Con_5-1814400-1
2 | K1,K2,K3,K4,K5,K6,K7,K8 | RELAY GEN PURPOSE SPDT 2A 5VDC | Omron Electronics Inc-EMC Div | G6E-134P-US DC5 | Z3668-ND (https://www.digikey.com/product-detail/en/omron-electronics-inc-emc-div/G6E-134P-US-DC5/Z3668-ND/1815979) | $4.73 |  |  | 6 | $28.38 |  |  | Omron_G6E-134P-US DC5
3 | U1,U2 | Power Switch/Driver 1:1 N-Channel 500mA 16-SOIC | Texas Instruments | TPL7407LADR | 296-51862-1-ND (https://www.digikey.com/product-detail/en/texas-instruments/TPL7407LADR/296-51862-1-ND/9746225) | $0.64 |  |  | 2 | $1.28 |  |  | SOIC-16
4 | J2 | CONN HEADER R/A 20POS 3MM | Molex | 0430452021 | WM20137-ND (https://www.digikey.com/product-detail/en/molex/0430452021/WM20137-ND/3310286) | $5.68 |  |  | 1 | $5.68 |  |  | Molex_430452021
5 | J1 | CONN HEADER R/A 4POS 2.54MM | Molex | 0022053041 | WM4302-ND (https://www.digikey.com/product-detail/en/molex/0022053041/WM4302-ND/26693) | $0.51 |  |  | 1 | $0.51 |  |  | Molex_022053041
6 | R1 | RES SMD 0 OHM JUMPER 1/2W 1210 | Vishay Dale | CRCW12100000Z0EA | 541-0.0VCT-ND (https://www.digikey.com/product-detail/en/vishay-dale/CRCW12100000Z0EA/541-0.0VCT-ND/1182217) | $0.24 |  |  | 1 | $0.24 |  |  | 1210i-3225m
7 | C1 | 100µF 16V Aluminum Polymer Capacitor Radial, Can - SMD 20mOhm 2000 Hrs @ 105°C | Würth Elektronik | 875105344010 | 732-6425-1-ND | $0.63 |  |  |  |  |  |  | Wurth_875105344010
8 | C2,C4 | CAP TANT POLY 1UF 25V 0805 | AVX Corporation | TCJP105M025R0500 | 478-8995-1-ND (https://www.digikey.com/product-detail/en/avx-corporation/TCJP105M025R0500/478-8995-1-ND/4561861) | $1.13 |  |  | 2 | $2.26 |  |  | 0805i-2012m
9 | C3,C5,C6,C7,C8 | CAP CER 0.1UF 50V C0G 1206 | TDK Corporation | C3216C0G1H104J160AA | 445-7694-1-ND (https://www.digikey.com/products/en?keywords=445-7694-1-ND) | $0.67 |  |  | 5 | $3.35 |  |  | 1206i-3216m
10 | U3 | IC GATE AND 4CH 2-INP 14SOIC | Texas Instruments | SN74HC08DRG4 | 296-31777-1-ND (https://www.digikey.com/product-detail/en/texas-instruments/SN74HC08DRG4/296-31777-1-ND/3506030) | $0.48 |  |  | 1 | $0.48 |  |  | SOIC-14
11 | U5 | XOR (Exclusive OR) IC 2 Channel SM8 (SSOP) | Texas Instruments | SN74LVC2G86DCTR | 296-13274-1-ND (https://www.digikey.com/products/en/integrated-circuits-ics/logic-gates-and-inverters/705?k=logic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) | $0.67 |  |  | 1 | $0.67 |  |  | SM08
12 | U4 | IC INVERTER 2CH 2-INP SOT23-6 | Texas Instruments | SN74LVC2G04DBVR | 296-13261-1-ND (https://www.digikey.com/product-detail/en/texas-instruments/SN74LVC2G04DBVR/296-13261-1-ND/484564) | $0.55 |  |  | 1 | $0.55 |  |  | SOT-23-6
13 | J15 | Connector Header Through Hole 10 position 0.100" (2.54mm) | Samtec Inc. | TSW-105-14-L-D-LL | SAM15946-ND | $1.05 |  |  | 1 | $1.05 |  |  | Samtec_TSW-105-14-L-D-LL
