Genturi/NewAlphaElectrical/SubSystems/Emppu/50-0038_FullBOM_(Emppu).xlsx

Item # | PartNo | Revision | Description | Qty | MFR | MFRPN | Vendor | VendorNo | Material | Finish | File Name
1 | 30-0006 |  | PCB ASSEMBLY, MULTI I/O | 1 | Genturi | 30-0006 |  |  |  |  | 30-0006.SLDASM
2 | 10-0157 | 1 | MOTOR I/O ELECTRONICS BOX PCB BRACKET | 1 | Genturi |  |  |  | AL 5052-H32 | CLEAR IRRIDITE | 10-0157.SLDASM
3 | 06-0035 |  | CONVERTER, AC/DC, 1 OUTPUT, 24V 2.2A | 1 | TDK LAMBDA | LS50-24 | DIGI-KEY | 285-1820-ND |  |  | 06-0035.SLDPRT
4 | 06-0039 |  | CONNECTOR, D-SUB, 25 POSITION, FEMALE SOCKET | 1 | NORCOMP INC. | 171-025-203L001 | DIGI-KEY | 225FE-ND |  |  | 06-0039.SLDPRT
5 | 06-0022 |  | CONTROLLER, SIX MOTOR | 1 | PETER NORBERG CONSULTING INC | BC6D25 |  |  |  |  | 06-0022.SLDPRT
6 | 10-0158 | 1 | MOTOR I/O ELECTRONICS BOX COVER | 1 | Genturi |  |  |  | AL 5052-H32 | CLEAR IRRIDITE | 10-0158.SLDPRT
7 | 06-0026 |  | LINE FILTER, 125/250VAC,4A, 50/60HZ, 3 STAGE | 1 | SCHURTER INC | 5500.2048 | DIGI-KEY | 486-6367-ND |  |  | 06-0026.SLDPRT
8 | 06-0036 |  | CONNECTOR, D-SUB, 50 POSITION, FEMALE SOCKET | 1 | AMPHENOL | L77SDD50SC309 |  |  |  |  | 06-0036.SLDPRT
9 | 06-0018 |  | INTERFACE MODULE, 24 DIGITAL I/O, USB | 1 | MEASUREMENT COMPUTING | USB-DIO24/37 |  |  |  |  | 06-0018.SLDPRT
10 | 06-0023 |  | HUB, USB, 4 PORT, NETWORK | 1 | B&B SMARTWORKS INC | BB-USBHUB4OEM | DIGI-KEY | 1165-1059-ND | N/A | N/A | 06-0023.SLDPRT
11 | 74-0010 | 1 | FAN, 60mm SQ X 25mm THK,95/264VAC, 19.5 CFM, 3950RPM. BALL | 1 | Orion Fans | OA60EC-UR-1WB | DIGI-KEY | 1053-1809-ND | N/A | N/A | 74-0010.SLDPRT
12 | 10-0159 | 1 | MOTOR I/O ELECTRONICS BOX BASE | 1 | Genturi |  |  |  | AL 5052-H32 | CLEAR IRRIDITE | 10-0159.SLDASM
13 | 06-0034 |  | CONVERTER, AC/DC, 1 OUTPUT, 15V 10 A | 1 | TDK LAMBDA | LS150-15 | DIGI-KEY | 285-1812-ND |  |  | 06-0034.SLDPRT
14 | 06-0037 |  | RELAY, SOLID STATE, SPST-NO | 1 | SENSATA-CRYDOM | DC60S3 | DIGI_KEY | CC1126-ND |  |  | 06-0037.SLDPRT
15 | 06-0021 |  | PID CONTROLLER, TEMPERATURE-PROCESS-STRAIN, 20 SAMPLES PER SECOND, 1/16 DIN,USB | 1 | OMEGA ENGINEERING | CN16DPT-144 |  |  |  |  | 06-0021.SLDPRT
16 | 06-0025 |  | Power Entry Connector Receptacle, Male Blades - Module IEC 320-C14 Panel Mount, Snap-In | 1 | Bulgin | BZH01/Z0000/11 | DIGI-KEY | 708-2406-ND
17 | 05-0005 |  | 37 Position D-Sub Receptacle, Female Sockets Connector | 1 | NorComp Inc. | 171-037-203L001 | DIGI-KEY | 237FE-ND
18 | 60-0005 |  | Premium USB Cable Type A - B Cable, 0.5m | 2 | L-Com | CSMUAB-05M (http://www.l-com.com/usb-premium-usb-cable-type-a-b-cable-05m)
19 | 60-0006 |  | USB A to USB micro B cable, 0.5m | 1 | L-Com | CSMUSMICB-05M (http://www.l-com.com/usb-premium-usb-cable-type-a-micro-b-5-position-05m)
20 | 60-0007 |  | USB A to USB mini B cable, 0.5m | 1 | L-Com | CSMUAMB5-05M (http://www.l-com.com/usb-premium-usb-cable-type-a-mini-b-5-position-05m)
21 | 60-0035 | 1 | ASSY, HARNESS, POWER-INPUT, IO ELECTRONICS BOX | 1 | Genturi | 60-0035
22 | 60-0036 | 1 | ASSY, HARNESS, LINE-FILTER TO POWER SUPPLIES, IO ELECTRONICS BOX | 1 | Genturi | 60-0036
23 | 60-0037 | 1 | ASSY, HARNESS, PS TO MTR CTRL, IO ELECTRONICS BOX | 1 | Genturi | 60-0037
24 | 60-0038 | 1 | ASSY, HARNESS, PS TO TEMP CTRL, IO ELECTRIONICS BOX | 1 | Genturi | 60-0038
25 | 60-0039 | 1 | ASSY, HARNESS, MTR CTRL TO D37, IO ELECTRONICS BOX | 1 | Genturi | 60-0039
