Genturi/NewAlphaElectrical/SubSystems/Emppu/EmppuBOM.xlsx

Sheet: BOM (50-0038)
Item # | Designation | Description | Manufacturer | Mfg P/N | Digi-Key P/N | Digi-Key Cost | Mouser P/N | Mouser Cost | Quantity | Extended Cost | Genturi P/N | Comment
1 |  | Fan Tubeaxial 95 ~ 264VAC Square - 60mm L x 60mm H Ball 19.5 CFM (0.546m³/min) 2 Wire Leads | Orion Fans | OA60EC-UR-1WB | 1053-1809-ND (https://www.digikey.com/product-detail/en/orion-fans/OA60EC-UR-1WB/1053-1809-ND/9380228) | $28.60 |  |  | 1 | $28.60 | 74-0010
2 |  | Power Entry Connector Receptacle, Male Blades - Module IEC 320-C14 Panel Mount, Snap-In | Bulgin | BZH01/Z0000/11 | 708-2406-ND (https://www.digikey.com/products/en?keywords=708-2406-ND) | $12.91 |  |  | 1 | $12.91 | 06-0025
3 |  | Single Phase EMC/EMI Line Filter 4A 125V, 250VAC 50/60Hz Three Stage Terminal Block | Schurter Inc. | 5500.2048 | 486-6367-ND (https://www.digikey.com/product-detail/en/schurter-inc/5500.2048/486-6367-ND/642780) | $202.34 |  |  | 1 | $202.34 | 06-0026 | I think we can find a cheaper alternative
4 |  | Enclosed AC DC Converter 1 Output 15V 10A 88 ~ 264 VAC Input | TDK-Lambda Americas Inc. | LS150-15 | 285-1812-ND (https://www.digikey.com/product-detail/en/tdk-lambda-americas-inc/LS150-15/285-1812-ND/1918823) | $37.69 |  |  | 1 | $37.69 | 06-0034 | Power for motors
5 |  | Enclosed AC DC Converter 1 Output 24V 2.2A 88 ~ 264 VAC Input | TDK-Lambda Americas Inc. | LS50-24 | 285-1820-ND (https://www.digikey.com/product-detail/en/tdk-lambda-americas-inc/LS50-24/285-1820-ND/1918831) | $21.64 |  |  | 1 | $21.64 | 06-0035 | Power for heater
6 |  | BC6D25 Current Regulating Six Motor Controller | Peter Norberg Consulting | BC6D25 (https://www.stepperboard.com/prod-bc6d25.htm) |  |  |  |  | 1 | $375.00 | 06-0022 | Motor controller
7 | J1 | 37 Position D-Sub Receptacle, Female Sockets Connector | NorComp Inc. | 171-037-203L001 | 237FE-ND (https://www.digikey.com/product-detail/en/norcomp-inc/171-037-203L001/237FE-ND/858162) | $2.63 |  |  | 1 | $2.63 | 05-0005 | motor control connector
8 |  | Solid State SPST-NO (1 Form A) Hockey Puck | Sensata-Crydom | DC60S3 | CC1126-ND (https://www.digikey.com/product-detail/en/sensata-crydom/DC60S3/CC1126-ND/221844) | $20.70 |  |  | 1 | $20.70 | 06-0037 | SSR for heater
9 |  | Network Hub, USB Ports | B&B SmartWorx, Inc. | BB-USBHUB4OEM | 1165-1059-ND (https://www.digikey.com/product-detail/en/b-b-smartworx-inc/BB-USBHUB4OEM/1165-1059-ND/3045945) | $135.96 |  |  | 1 | $135.96 | 06-0023 | USB hub
10 |  | 24-Channel Digital I/O USB Device | Measurement Computing | USB-DIO24/37 (https://www.mccdaq.com/usb-data-acquisition/USB-DIO24-Series.aspx) |  |  |  |  | 1 | $99.00 | 06-0018 | Digital I/O
11 | J2 | 25 Position D-Sub Receptacle, Female Sockets Connector | NorComp Inc. | 171-025-203L001 | 225FE-ND (https://www.digikey.com/product-detail/en/norcomp-inc/171-025-203L001/225FE-ND/858144) | $1.57 |  |  | 1 | $1.57 | 06-0039 | Connector to cartridge heater
12 | N1 | PCB, Moondance | Genturi | 30-0006 | NA | N/A | N/A |  | 1 |  | 30-0006 | General Interface board
13 |  | Premium USB Cable Type A - B Cable, 0.5m | L-Com | CSMUAB-05M (http://www.l-com.com/usb-premium-usb-cable-type-a-b-cable-05m) | N/A |  |  |  | 2 | $8.28 | 60-0005 | USB-A to USB-B 0.5M
14 |  | USB A to USB micro B cable, 0.5m | L-Com | CSMUSMICB-05M (http://www.l-com.com/usb-premium-usb-cable-type-a-micro-b-5-position-05m) | N/A |  |  |  | 1 | $9.53 | 60-0006
15 |  | USB A to USB mini B cable, 0.5m | L-Com | CSMUAMB5-05M (http://www.l-com.com/usb-premium-usb-cable-type-a-mini-b-5-position-05m) | N/A |  |  |  | 1 | $9.47 | 60-0007
16 |  | ASSY, HARNESS, POWER-INPUT, IO ELECTRONICS BOX | Genturi | 60-0035 |  |  |  |  |  |  | 60-0035
17 |  | ASSY, HARNESS, LINE-FILTER TO POWER SUPPLIES, IO ELECTRONICS BOX | Genturi | 60-0036 |  |  |  |  |  |  | 60-0036
18 |  | ASSY, HARNESS, PS TO MTR CTRL, IO ELECTRONICS BOX | Genturi | 60-0037 |  |  |  |  |  |  | 60-0037
19 |  | ASSY, HARNESS, PS TO TEMP CTRL, IO ELECTRIONICS BOX | Genturi | 60-0038 |  |  |  |  |  |  | 60-0038
20 |  | ASSY, HARNESS, MTR CTRL TO D37, IO ELECTRONICS BOX | Genturi | 60-0039 |  |  |  |  |  |  | 60-0039
 |  | Not required--remove from BOM
 |  | This was changed and requires a Genturi P/N
 |  | New part--requires Genturi P/N
 |  | This part is incorrect in the master and needs to be changed
 |  | Remove from this BOM (is reflected in a cable BOM)

Sheet: Cable Assemblies
Item # | Designation | Description | Comment | Genturi P/N | Manufacturer | Mfg P/N | Digi-Key P/N | Digi-Key Cost | Mouser P/N | Mouser Cost
 |  | USB hub to Motor controller (USB A to USB B) {Length: ???} | Off-the-shelf | 60-0005 | L-Com | CSMUAB-05M (http://www.l-com.com/usb-premium-usb-cable-type-a-b-cable-05m)
 |  | USB hub to digital I/O module (USB A to USB B) {Length: ???} | Off-the-shelf | 60-0005 | L-Com | CSMUAB-05M (http://www.l-com.com/usb-premium-usb-cable-type-a-b-cable-05m)
 |  | USB hub to temperature controller (USB A to USB micro B) {Length: ???} | Off-the-shelf |  | L-Com | CSMUSMICB-05M (http://www.l-com.com/usb-premium-usb-cable-type-a-micro-b-5-position-05m)
 |  | USB hub to Moondance (USB A to USB mini B) {Length: ???} | Off-the-shelf |  | L-Com | CSMUAMB5-05M (http://www.l-com.com/usb-premium-usb-cable-type-a-mini-b-5-position-05m)
 |  | Ground Stud | Part of chassis?
 |  | Power entry to fan and line filter | Assembly
 |  | Line filter to +15V power supply | Assembly
 |  | Line filter to +24V power supply | Assembly
 |  | Line filter to Moondance | Assembly
 |  | +15V power supply to motor controller | Assembly
 |  | +24V power supply to SSR and Temp controller | Assembly
 |  | Motor controller to D-37 | Assembly
 |  | Digital I/O module to Moondance | Direct connect--No Cable
 |  | Proposed assembly--TBD--assemble at Genturi
 |  | Off-the shelf part that requires Genturi part number

Sheet: Part Numbers to request
Genturi P/N | Description | Manufacturer | Mfg P/N | Digi-key P/N | Mouser P/N | Cost
 | 37 Position D-Sub Receptacle, Female Sockets Connector | NorComp Inc. | 171-037-203L001 | 237FE-ND (https://www.digikey.com/product-detail/en/norcomp-inc/171-037-203L001/237FE-ND/858162) |  | $2.63
 | USB A to USB micro B cable, 0.5m | L-Com | CSMUSMICB-05M (http://www.l-com.com/usb-premium-usb-cable-type-a-micro-b-5-position-05m) |  |  | $9.53
 | USB A to USB mini B cable, 0.5m | L-Com | CSMUAMB5-05M (http://www.l-com.com/usb-premium-usb-cable-type-a-mini-b-5-position-05m) |  |  | $9.47
 | 6 Position Rectangular Housing Connector Receptacle White 0.100" (2.54mm) | Molex | 22013067 | WM2004-ND (https://www.digikey.com/products/en?keywords=WM2004-ND) |  | $0.29
 | 9 Position Rectangular Housing Connector Receptacle White 0.100" (2.54mm) | Molex | 22013097 | WM2007-ND (https://www.digikey.com/products/en?keywords=wm2007-nd) |  | $0.43
 | 4 Position Rectangular Housing Connector Receptacle White 0.100" (2.54mm) | Molex | 22013047 | WM2002-ND (https://www.digikey.com/products/en?keywords=wm2002-nd) |  | $0.20
 | Non-Gendered Contact Tin 22-30 AWG Crimp | Molex | 0008500032 | WM2623-ND (https://www.digikey.com/products/en?keywords=08-50-0032) |  | $0.09

Sheet: PowEntryToFan&LF(60-0035)
Item | Description | From/To | Genturi P/N | Mfg | Mfg P/N | Digi-key P/N | quantity | Comment
 | 0.250" (6.35mm) Quick Connect Female 14-16 AWG Crimp Connector Fully Insulated |  | 05-0064 | TE Connectivity AMP Connectors | 3-350820-2 |  | 4
 | #16 black wire |  | 60-0015 |  |  |  | ?
 | #16 white wire |  | 60-0016 |  |  |  | TBD
 | #12 Green wire |  | 60-0080 |  |  |  | TBD
 | 0.250" (6.35mm) Quick Connect Female 10-12 AWG Crimp Connector Fully Insulated |  | 05-0063 | TE Connectivity AMP Connectors | 4-520448-2 |  | 3
 | #22 black wire |  | 60-0018 |  |  |  | TBD
 | #22 white wire |  | 60-0020 |  |  |  | TBD
 | Wire Pin Terminal Connector 14-16 AWG Plasti-Grip Crimp |  | 05-0059 | TE Connectivity AMP Connectors | 165171 |  | 2
 | #10/12 X #10 Ring terminal |  | 05-0037 |  |  |  | 1
 | #18-22 Butt-splice |  | 05-0062 |  |  |  | 2

Sheet: LineFilterToPwrSply(60-0036)
Item | Description | From/To | Genturi P/N | Mfg | Mfg P/N | Digi-key P/N | quantity | Comment
 | Wire Pin Terminal Connector 10-12 AWG Plasti-Grip Crimp |  | 05-0060 | TE Connectivity AMP Connectors | 165085 |  | 3
 | Ring Terminal Connector 6 Stud Circular 14-16 AWG Crimp |  | 05-0044 | Molex | 190730067 |  | 6
 | #16 black wire |  | 60-0015 |  |  |  | ???
 | Wire Pin Terminal Connector 14-16 AWG Plasti-Grip Crimp |  | 05-0059 | TE Connectivity AMP Connectors | 165171 |  | 5
 | #16 green wire |  | 60-0014 |  |  |  | ???
 | #16 white wire |  | 60-0016 |  |  |  | ???

Sheet: +15V SupplyToMtrCont (60-0037)
Item | Description | Genturi P/N | Mfg | Mfg P/N | Digi-key P/N | Quantity | Cost | Extended Cost | Comment
 | 6 Position Rectangular Housing Connector Receptacle White 0.100" (2.54mm) | 05-0006 | Molex | 22013067 | WM2004-ND (https://www.digikey.com/products/en?keywords=WM2004-ND) | 1 | $0.29 | $0.29
 | #22 white wire | 60-0020 |  |  |  | TBD
 | #22 black wire | 60-0018 |  |  |  | TBD
 | Terminal pin, crimp, | 05-0009 |  |  |  | 4
 | Ring Terminal Connector 6 Stud Circular 14-16 AWG Crimp | 05-0044 | Molex | 190730067 |  | 4

Sheet: +24V SplyToTempCont (60-0038)
Item | Description | Genturi P/N | Mfg | Mfg P/N | Digi-key P/N | Quantity | Cost | Extended Cost | Comment
 | Ring Terminal Connector 6 Stud Circular 14-16 AWG Crimp | 05-0044 | Molex | 190730067 |  | 2
 | #18 white wire | 60-0078 | CNC Tech | 1569-18-1-0500-002-1-TS |  | TBD
 | Ring Terminal Connector #8 Stud Circular 18-22 AWG Crimp | 05-0042 | Molex | 190730017 |  | 4
 | Wire Pin Terminal Connector 18-22 AWG Avikrimp Crimp | 05-0054 | Molex | 192130009 |  | 4
 | #18 black wire | 60-0079 | CNC Tech | 1569-18-1-0500-001-1-TS |  | TBD
 | #22 black wire | 60-0018
 | #22 violet wire | 60-0024
 | #22 orange wire | 60-0019
 | #22 brown wire | 60-0025
 | 25 Position D-Sub Receptacle, Female Sockets Connector | 06-0039 | NorComp Inc. | 171-025-203L001 | 225FE-ND | 1

Sheet: MtrCntrlr to D-37 (60-0039)
Item | Description | Genturi P/N | Mfg | Mfg P/N | Digi-key P/N | Quantity | Cost | Extended Cost
 | 9 Position Rectangular Housing Connector Receptacle White 0.100" (2.54mm) | 05-0007 | Molex | 22013097 | WM2007-ND (https://www.digikey.com/products/en?keywords=wm2007-nd) | 3 | $0.43 | $1.29
 | 4 Position Rectangular Housing Connector Receptacle White 0.100" (2.54mm) | 05-0008 | Molex | 22013047 | WM2002-ND (https://www.digikey.com/products/en?keywords=wm2002-nd) | 5 | $0.20 | $1.00
 | Non-Gendered Contact Tin 22-30 AWG Crimp | 05-0009 | Molex | 0008500032 | WM2623-ND (https://www.digikey.com/products/en?keywords=08-50-0032) | 29 | $0.09 | $2.61
 | 37 Position D-Sub Receptacle, Female Sockets Connector | 05-0005 | NorComp Inc. | 171-037-203L001 | 237FE-ND | 1 | 2.63 | $2.63
 | #28 green wire | 60-0081 | Alpha Wire | 3048 GR005 | A3048G-100-ND | TBD
 | #28 blue wire | 60-0085 | Alpha Wire | 3048 BL005 | A3048L-100-ND | TBD
 | #28 violet wire | 60-0089 | Alpha Wire | 3048 VI005 | A3048V-100-ND | TBD
 | #28 slate wire | 60-0088 | Alpha Wire | 3048 SL005 | A3048S-100-ND | TBD
 | #28 white wire | 60-0087 | Alpha Wire | 3048 WH005 | A3048W-100-ND | TBD
 | #22 black wire | 60-0018 |  |  |  | TBD
 | #22 brown wire | 60-0025 |  |  |  | TBD
 | #22 red wire | 60-0017 |  |  |  | TBD
 | #22 orange wire | 60-0019 |  |  |  | TBD
 | #22 yellow wire | 60-0023 |  |  |  | TBD
