Genturi/NewAlphaElectrical/SubSystems/Jukka/50-0039_FullBOM_(Jukka).xlsx

Item Number | PartNo | Revision | Description | Qty | MFR | MFRPN | Vendor | VendorNo | Material | Finish | File Name
1 | 10-0155 |  | CARTRIDGE BIAS ELECTRONICS BOX BASE | 1 |  |  |  |  |  |  | 10-0155.SLDASM
2 | 06-0042 |  | CONVERTER, AC/DC, 1 OUTPUT, 5V 1A | 1 | CUI INC. | PSK-S5B-5-T | Digi-Key | 102-5182-ND |  |  | 06-0042.SLDPRT
3 | 30-0005 |  | PCB ASSEMBLY, CARTRIDGE EMF BIAS | 1 |  |  | Genturi |  |  |  | 30-0005.SLDASM
4 | 06-0040 |  | CONNECTOR, POWER, MALE BLADE, PANEL MOUNT | 1 | QUALTEK | 701W-X2/02 | Digi-Key | Q207-ND |  |  | 06-0040.SLDPRT
5 | 06-0019 |  | INTERFACE MODULE, 4 CHANNEL DATA ACQUISITION, 8 DIGITAL I/O, USB | 1 | MEASUREMENT COMPUTING | USB-3101 |  |  |  |  | 06-0019.SLDPRT
6 | 10-0154 |  | CARTRIDGE BIAS ELECTRONICS BOX COVER | 1 |  |  |  |  |  |  | 10-0154.SLDASM
7 | 06-0041 |  | COUPLER, USB 2.0 TYPE B/A FLANGED PANEL MOUNTED | 1 | L-COM | ECF504-BA |  |  |  |  | 06-0041.SLDPRT
8 | 06-0005 |  | Premium USB Cable Type A - B Cable, 0.5m | 1 | L-Com | CSMUAB-05M
9 | 60-0053 |  | ASSY, HARNESS, DAQ TO PCB, CARTRIDGE BIAS ELECTRONICS BOX | 1 | Genturi
10 | 60-0052 |  | ASSY, HARNESS, PS TO PCB, CARTRIDGE BIAS ELECTRONICS BOX | 1 | Genturi
