Genturi/NewAlphaElectrical/SubSystems/Jukka/Jukka_2_DigiKeyOrder_022520.xlsx

Index | Quantity | Part Number | Manufacturer Part Number | Description | Trex Description | Customer Reference | Available | Backorder | Unit Price | Extended Price USD
1 | 10 | HF10U-18-ND | 100R10-457B | CABLE FFC 10POS 1.00MM 18" | CABLE FFC 10POS 1.00MM 18" (HF10U-18-ND) |  | 0 | 10 | 5.569 | 55.69
2 | 20 | WM6762CT-ND | 0526101072 | CONN FPC VERT 10POS 1.00MM SMD | CONN FPC VERT 10POS 1.00MM SMD (WM6762CT-ND) |  | 20 | 0 | 0.858 | 17.16
3 | 20 | 732-618009233821-ND | 618009233821 | WR-DSUB FEMALE ANGLED PCB CONNEC | WR-DSUB FEMALE ANGLED PCB CONNEC (732-618009233821-ND) |  | 20 | 0 | 3.62 | 72.40
4 | 10 | A33945-ND | 5-103639-9 | CONN HEADER VERT 10POS 2.54MM | CONN HEADER VERT 10POS 2.54MM (A33945-ND) |  | 10 | 0 | 1.681 | 16.81
5 | 25 | P124104CT-ND | EEH-ZS1H221P | CAP ALUM POLY 220UF 20% 50V SMD | CAP ALUM POLY 220UF 20% 50V SMD (P124104CT-ND) |  | 25 | 0 | 2.147 | 53.68
6 | 15 | 399-T598D106M050ATE090CT-ND | T598D106M050ATE090 | TA POLY 7343 10UF 20% 50V 90MOHM | TA POLY 7343 10UF 20% 50V 90MOHM (399-T598D106M050ATE090CT-ND) |  | 15 | 0 | 2.286 | 34.29
7 | 160 | 399-7011-1-ND | C1206C105K5RACAUTO | CAP CER 1UF 50V X7R 1206 | CAP CER 1UF 50V X7R 1206 (399-7011-1-ND) |  | 160 | 0 | 0.1388 | 22.21
8 | 20 | 399-4740-1-ND | T520V226M020ATE040 | CAP TANT POLY 22UF 20V 2917 | CAP TANT POLY 22UF 20V 2917 (399-4740-1-ND) |  | 20 | 0 | 2.731 | 54.62
9 | 100 | 478-12496-1-ND | 12105C106K4Z2A | CAP CER 10UF 50V X7R 1210 | CAP CER 10UF 50V X7R 1210 (478-12496-1-ND) |  | 100 | 0 | 0.5896 | 58.96
10 | 15 | 399-11575-1-ND | C1206C183J2GACAUTO | CAP CER 0.018UF 200V NP0 1206 | CAP CER 0.018UF 200V NP0 1206 (399-11575-1-ND) |  | 15 | 0 | 0.396 | 5.94
11 | 150 | 445-7694-1-ND | C3216C0G1H104J160AA | CAP CER 0.1UF 50V C0G 1206 | CAP CER 0.1UF 50V C0G 1206 (445-7694-1-ND) |  | 150 | 0 | 0.3416 | 51.24
12 | 15 | 445-6983-1-ND | CGA5L2C0G1H683J160AA | CAP CER 0.068UF 50V C0G 1206 | CAP CER 0.068UF 50V C0G 1206 (445-6983-1-ND) |  | 15 | 0 | 0.486 | 7.29
13 | 15 | 399-20487-1-ND | C0603X394K4RACAUTO | CAP CER 0.39UF 16V X7R 0603 | CAP CER 0.39UF 16V X7R 0603 (399-20487-1-ND) |  | 15 | 0 | 0.433 | 6.50
14 | 150 | 478-13149-1-ND | TCQD106M035R0070 | CAP CHIP POLY 10UF 35V 2917 | CAP CHIP POLY 10UF 35V 2917 (478-13149-1-ND) |  | 150 | 0 | 1.0661 | 159.92
15 | 10 | A33895-ND | 5-103669-2 | CONN HEADER VERT 3POS 2.54MM | CONN HEADER VERT 3POS 2.54MM (A33895-ND) |  | 10 | 0 | 1.037 | 10.37
16 | 20 | A33163-ND | 5103308-3 | CONN HEADER VERT 16POS 2.54MM | CONN HEADER VERT 16POS 2.54MM (A33163-ND) |  | 20 | 0 | 1.772 | 35.44
17 | 10 | L77SDC37SOL2-ND | L77SDC37SOL2 | CONN D-SUB RCPT 37POS VERT SLDR | CONN D-SUB RCPT 37POS VERT SLDR (L77SDC37SOL2-ND) |  | 10 | 0 | 2.195 | 21.95
18 | 10 | 609-1506-ND | D25S13A4GL00LF | CONN D-SUB RCPT 25POS R/A SOLDER | CONN D-SUB RCPT 25POS R/A SOLDER (609-1506-ND) |  | 10 | 0 | 3.168 | 31.68
19 | 10 | 732-618015325223-ND | 618015325223 | WR-DSUB FEMALE HIGH DENSITY ANGL | WR-DSUB FEMALE HIGH DENSITY ANGL (732-618015325223-ND) |  | 10 | 0 | 3.81 | 38.10
20 | 15 | SAM15946-ND | TSW-105-14-L-D-LL | CONN HEADER VERT 10POS 2.54MM | CONN HEADER VERT 10POS 2.54MM (SAM15946-ND) |  | 15 | 0 | 0.923 | 13.85
21 | 150 | PB283-ND | V23026A1002B201 | RELAY GEN PURPOSE SPDT 1A 12VDC | RELAY GEN PURPOSE SPDT 1A 12VDC (PB283-ND) |  | 150 | 0 | 5.31 | 796.50
22 | 15 | 553-3685-1-ND | PA4320.334NLT | FIXED IND 330UH 1.7A 340 MOHM | FIXED IND 330UH 1.7A 340 MOHM (553-3685-1-ND) |  | 0 | 15 | 2.726 | 40.89
23 | 100 | 541-2.61MHCT-ND | CRCW06032M61FKEA | RES SMD 2.61M OHM 1% 1/10W 0603 | RES SMD 2.61M OHM 1% 1/10W 0603 (541-2.61MHCT-ND) |  | 100 | 0 | 0.0139 | 1.39
24 | 100 | P523KHCT-ND | ERJ-3EKF5233V | RES SMD 523K OHM 1% 1/10W 0603 | RES SMD 523K OHM 1% 1/10W 0603 (P523KHCT-ND) |  | 100 | 0 | 0.0234 | 2.34
25 | 100 | P1.40KHCT-ND | ERJ-3EKF1401V | RES SMD 1.4K OHM 1% 1/10W 0603 | RES SMD 1.4K OHM 1% 1/10W 0603 (P1.40KHCT-ND) |  | 100 | 0 | 0.0234 | 2.34
26 | 100 | P1.96KHCT-ND | ERJ-3EKF1961V | RES SMD 1.96K OHM 1% 1/10W 0603 | RES SMD 1.96K OHM 1% 1/10W 0603 (P1.96KHCT-ND) |  | 100 | 0 | 0.0234 | 2.34
27 | 100 | P10.0KHCT-ND | ERJ-3EKF1002V | RES SMD 10K OHM 1% 1/10W 0603 | RES SMD 10K OHM 1% 1/10W 0603 (P10.0KHCT-ND) |  | 100 | 0 | 0.0234 | 2.34
28 | 200 | P1.00KHCT-ND | ERJ-3EKF1001V | RES SMD 1K OHM 1% 1/10W 0603 | RES SMD 1K OHM 1% 1/10W 0603 (P1.00KHCT-ND) |  | 200 | 0 | 0.0234 | 4.68
29 | 200 | P4.99KHCT-ND | ERJ-3EKF4991V | RES SMD 4.99K OHM 1% 1/10W 0603 | RES SMD 4.99K OHM 1% 1/10W 0603 (P4.99KHCT-ND) |  | 200 | 0 | 0.0279 | 5.58
30 | 100 | P133KHCT-ND | ERJ-3EKF1333V | RES SMD 133K OHM 1% 1/10W 0603 | RES SMD 133K OHM 1% 1/10W 0603 (P133KHCT-ND) |  | 100 | 0 | 0.0234 | 2.34
31 | 100 | P665KHCT-ND | ERJ-3EKF6653V | RES SMD 665K OHM 1% 1/10W 0603 | RES SMD 665K OHM 1% 1/10W 0603 (P665KHCT-ND) |  | 100 | 0 | 0.0234 | 2.34
32 | 200 | P15.8KHCT-ND | ERJ-3EKF1582V | RES SMD 15.8K OHM 1% 1/10W 0603 | RES SMD 15.8K OHM 1% 1/10W 0603 (P15.8KHCT-ND) |  | 200 | 0 | 0.0234 | 4.68
33 | 100 | 541-0.0VCT-ND | CRCW12100000Z0EA | RES SMD 0 OHM JUMPER 1/2W 1210 | RES SMD 0 OHM JUMPER 1/2W 1210 (541-0.0VCT-ND) |  | 100 | 0 | 0.071 | 7.10
34 | 10 | 102-5018-ND | P78E05-1000 | DC-DC NON-ISOLATED, 1.0 A, 8 36 | DC-DC NON-ISOLATED, 1.0 A, 8 36 (102-5018-ND) |  | 0 | 10 | 2.873 | 28.73
35 | 25 | LT3080EDD-1#PBF-ND | LT3080EDD-1#PBF | IC REG LINEAR POS ADJ 1.1A 8DFN | IC REG LINEAR POS ADJ 1.1A 8DFN (LT3080EDD-1#PBF-ND) |  | 25 | 0 | 3.0308 | 75.77
36 | 25 | LT3090EDD#PBF-ND | LT3090EDD#PBF | IC REG LIN NEG ADJ 600MA 10DFN | IC REG LIN NEG ADJ 600MA 10DFN (LT3090EDD#PBF-ND) |  | 25 | 0 | 3.454 | 86.35
37 | 50 | ADA4522-4ARZ-ND | ADA4522-4ARZ | IC OPAMP ZERO-DRIFT 4CIRC 14SOIC | IC OPAMP ZERO-DRIFT 4CIRC 14SOIC (ADA4522-4ARZ-ND) |  | 50 | 0 | 7.2776 | 363.88
38 | 15 | ADA4177-4ARZ-R7CT-ND | ADA4177-4ARZ-R7 | IC OPAMP GP 4 CIRCUIT 14SOIC | IC OPAMP GP 4 CIRCUIT 14SOIC (ADA4177-4ARZ-R7CT-ND) |  | 15 | 0 | 7.95 | 119.25
39 | 30 | 296-51862-1-ND | TPL7407LADR | IC PWR DRIVER N-CHAN 1:1 16SOIC | IC PWR DRIVER N-CHAN 1:1 16SOIC (296-51862-1-ND) |  | 30 | 0 | 0.545 | 16.35
40 | 10 | 102-1712-ND | V7812-500 | DC DC CONVERTER 12V 6W | DC DC CONVERTER 12V 6W (102-1712-ND) |  | 10 | 0 | 6.306 | 63.06
41 | 25 | MC74HC08ADR2GOSCT-ND | MC74HC08ADR2G | IC GATE AND 4CH 2-INP 14SOIC | IC GATE AND 4CH 2-INP 14SOIC (MC74HC08ADR2GOSCT-ND) |  | 25 | 0 | 0.336 | 8.40
42 | 25 | MC74HC32ADR2GOSCT-ND | MC74HC32ADR2G | IC GATE OR 4CH 2-INP 14SOIC | IC GATE OR 4CH 2-INP 14SOIC (MC74HC32ADR2GOSCT-ND) |  | 25 | 0 | 0.2992 | 7.48
43 | 6 | 1866-3902-ND | PSC-100B-C | AC/DC CONVERTER 27.6V 27.6V 101W | AC/DC CONVERTER 27.6V 27.6V 101W (1866-3902-ND) |  | 6 | 0 | 44.11 | 264.66
44 | 6 | 708-2406-ND | BZH01/Z0000/11 | PWR ENT MOD RCPT IEC320-C14 PNL | PWR ENT MOD RCPT IEC320-C14 PNL (708-2406-ND) | 06-0025 | 6 | 0 | 13.6 | 81.60
45 | 15 | AKC16H-ND | 1658621-3 | CONN RCPT 16P IDC 26-28AWG GOLD | CONN RCPT 16P IDC 26-28AWG GOLD (AKC16H-ND) |  | 15 | 0 | 1.748 | 26.22
46 | 10 | A28397-ND | 104257-2 | CONN RECPT 3POS .1" POL UNLOAD | CONN RECPT 3POS .1" POL UNLOAD (A28397-ND) | 05-0072 | 10 | 0 | 0.506 | 5.06
47 | 1 | MC010M-100-ND | 3811/10 300 | CBL RIBN 10COND 0.050 MULTI 100' | CBL RIBN 10COND 0.050 MULTI 100' (MC010M-100-ND) |  | 1 | 0 | 53.39 | 53.39
 |  |  |  |  |  |  |  |  |  | 2843.16
