Genturi/NewAlphaElectrical/SubSystems/Jukka/JukkaBOM.xlsx

Sheet: BOM
Item # | Designation | Description | Manufacturer | Mfg P/N | Digi-Key P/N | Digi-Key Cost | Mouser P/N | Mouser Cost | Quantity | Extended Cost | Genturi P/N | Comment
1 |  | Power Entry Connector Receptacle, Male Blades IEC 320-C14 Panel Mount, Snap-In | Qualtek | 701W-X2/02 | Q207-ND (https://www.digikey.com/products/en?keywords=701W-X2%2F02) | $0.83 |  |  | 1 | $0.83 | 06-0040
2 |  | Enclosed AC DC Converter 1 Output 5V 1A 85 ~ 264 VAC, 100 ~ 370 VDC Input | CUI Inc. | PSK-S5B-5-T | 102-5182-ND (https://www.digikey.com/product-detail/en/cui-inc/PSK-S5B-5-T/102-5182-ND/9817114) | $16.99 |  |  | 1 | $16.99 | 06-0042
3 | J1 | Flanged Panel Mounted USB 2.0 Coupler - Shielded, Type B/A Connectors | L-Com | ECF504-BA (http://www.l-com.com/usb-flanged-panel-mounted-usb-20-coupler-shielded-type-b-a-connectors) | N/A |  |  |  | 1 | $12.44 | 06-0041
4 | N1 | USB-based 4-channel, 16-bit analog voltage output device, 8 digital I/O, with one counter | Measurement Computing | USB-3101 (https://www.mccdaq.com/usb-data-acquisition/USB-3100-Series.aspx) | N/A |  |  |  | 1 | $330.00 | 06-0019 | DAQ module
5 | V1 | Premium USB Cable Type A - B Cable, 0.5m | L-Com | CSMUAB-05M (http://www.l-com.com/usb-premium-usb-cable-type-a-b-cable-05m) | N/A |  |  |  | 1 | $8.28 | 06-0005 | USB-A to USB-B 0.5M
6 | N1 | PCB, Alpenglow | Genturi | 30-0005 | NA | N/A | N/A |  | 1 | ???? | 30-0005 | General Interface board
7 |  | ASSY, HARNESS, DAQ TO PCB, CARTRIDGE BIAS ELECTRONICS BOX | Genturi | 60-0053 | NA | N/A | N/A |  | 1 | ???? | 60-0053
8 |  | ASSY, HARNESS, PS TO PCB, CARTRIDGE BIAS ELECTRONICS BOX | Genturi | 60-0052 | NA | N/A | N/A |  | 1 | ???? | 60-0052
9 |  | ASSY, HARNESS, AC PWR INPUT, MOTOR I/O ELECTRONICS BOX | Genturi | TBD |  |  |  |  | 1 | ???? | TBD

Sheet: Cable Assemblies
Item # | Designation | Description | Comment | Genturi P/N | Manufacturer | Mfg P/N | Digi-Key P/N | Digi-Key Cost | Mouser P/N | Mouser Cost | Cost
 |  | Premium USB Cable Type A - B Cable, 0.5m |  | 06-0005 | L-Com | CSMUAB-05M (http://www.l-com.com/usb-premium-usb-cable-type-a-b-cable-05m) |  |  |  |  | $8.28
 |  | Power entry to +5V Power supply |  | TBD | Genturi
 |  | +5V Power supply to Alpenglow |  | 60-0052 | Genturi | 60-0052
 |  | USB-3101 to Alpenglow |  | 60-0053 | Genturi | 60-0053

Sheet: AC Input (60-0104)
Item | Description | Genturi P/N | Mfg | Mfg P/N | Digi-key P/N | Quantity | Cost | Extended Cost
 | Wire Pin Terminal Connector 14-16 AWG Plasti-Grip Crimp | 05-0059 | TE Connectivity AMP Connectors | 165171 | A145081-ND | 2
 | #16 black wire | 60-0015 |  |  |  | TBD
 | #16 white wire | 60-0016 |  |  |  | TBD
 | Ring Terminal Connector 10 Stud Circular 10-12 AWG Crimp | 05-0037 | Molex | 190730170 | WM18310-ND | 1

Sheet: USB-3101 to Alpenglow(60-0053)
Item | Description | Genturi P/N | Mfg | Mfg P/N | Digi-key P/N | Quantity | Cost | Extended Cost
 | 20 Position Rectangular Housing Connector Receptacle Black 0.118" (3.00mm) | 05-0020 | Molex | 0430252000 | WM2492-ND (https://www.digikey.com/product-detail/en/molex/0430252000/WM2492-ND/531408) | 1 | $1.09 | $1.09
 | Socket Contact Tin 20-24 AWG Crimp Power | 05-0012 | Molex | 0430300007 | WM1837-ND (https://www.digikey.com/products/en?keywords=wm1837-nd) | 18 | $0.19 | $3.42
 | Wire Pin Terminal Connector 22-26 AWG (0.1~0.4mm²) PIDG Crimp | 05-0053 | TE Connectivity AMP Connectors | 165514-1 | 165514-1-ND (https://www.digikey.com/product-detail/en/165514-1/165514-1-ND/1136542/?itemSeq=311538633) | 18
 | #24 black wire | 60-0034 |  |  |  | TBD
 | #24 brown wire | 60-0027 |  |  |  | TBD
 | #24 red wire | 60-0033 |  |  |  | TBD
 | #24 orange wire | 60-0029 |  |  |  | TBD
 | #24 yellow wire | 60-0030 |  |  |  | TBD
 | #24 green wire | 60-0028 |  |  |  | TBD
 | #24 blue wire | 60-0026 |  |  |  | TBD
 | #24 violet wire | 60-0031 |  |  |  | TBD
 | #24 white wire | 60-0032 |  |  |  | TBD

Sheet: +5V Pwr sply to Alpglw(60-0052)
Item | Description | Genturi P/N | Mfg | Mfg P/N | Digi-key P/N | Quantity | Cost | Extended Cost
 | Wire Pin Terminal Connector 18-22 AWG Avikrimp Crimp | 05-0054 | Molex | 192130009 | WM18380-ND (https://www.digikey.com/product-detail/en/0192130009/WM18380-ND/279181/?itemSeq=311494906) | 2
 | 4 Position Rectangular Housing Connector Receptacle White 0.100" (2.54mm) | 05-0008 | Molex | 22013047 | WM2002-ND (https://www.digikey.com/products/en?keywords=wm2002-nd) | 1 | $0.20 | $0.20
 | Non-Gendered Contact Tin 22-30 AWG Crimp | 05-0009 | Molex | 0008500032 | WM2623-ND (https://www.digikey.com/products/en?keywords=08-50-0032) | 4 | $0.09 | $0.36
 | #22 red wire | 60-0017
 | #22 black wire | 60-0018
