Genturi/NewAlphaElectrical/SubSystems/Marco/50-0040 Marko BOM.xlsx

 | 50-0040 |  | ASSY, ELECTRO-OPTICS CONTROL BOX
ITEM NO. | PART NO. | REVISION | DESCRIPTION | QTY. | MFR. | MFR P/N | VENDOR | VENDOR NO
1 | 10-0150 | 1 | HOUSING, BOTTOM ELECTRO-OPTICS CONTROL BOX | 1
2 | 30-0003 | 1 | ASSY, PCB, PMT CONTROL | 1
 | 31-0003 | 1 | PCB, PMT CONTROL | 1
3 | 01-0069 | 1 | STANDOFF, 4-40 X 3/16LG X 3/16HEX, M/F | 10 | dbradbury |  | McMASTER-CARR | 91299A110
4 | 06-0028 | 1 | CONVERTOR, AC/DC, 1 OUTPUT, 5V, 3A | 1 | SL POWER | HB5-3-OV-A+G
5 | 06-0027 | 1 | CONVERTOR, AC/DC, 1 OUTPUT, 15V,1.5A | 1 | SL POWER | HBB15-1.5-A+G | DIGI-KEY | 271-2280-ND
6 | 06-0019 | 1 | INTERFACE MODULE, 4 CHANNEL DATA ACQUISITION, 8 DIGITAL I/O, USB | 1 | MEASUREMENT COMPUTING | USB-3101 | DIGI-KEY | 271-2253-ND
7 | 06-0041 | 1 | COUPLER, USB 2.0 TYPE B/A FLANGED PANEL MOUNTED | 1 | L-COM | ECF504-BA
8 | 06-0011 | 1 | TRANSIMPEDANCE AMPLIFIER, 5000V/A, 400 MHz, BNC | 4 | FEMTO MESSTECHNIK GMBH | HCA-400M-5K-C
9 | 06-0005 | 1 | FILTER, LOW PASS, 200MHz BW, GROUP DELAY EQUALIZED, 9TH ORDER, 50 OHM, SMA | 4 | KR ELECTRONICS, INC. | 3070-SMA
10 | 06-0029 | 1 | CONNECTOR, COAX SMA JACK, FEMALE SOCKET 50 OHM | 8 | AMPHENOL | 132170 | DIGI-KEY | ACX1244-ND
11 | 06-0040 | 1 | CONNECTOR, POWER, MALE BLADE, PANEL MOUNT | 1 | QUALTEK | 701W-X2/02 | DIGI-KEY | Q207-ND
12 | 10-0153 | 1 | BRACKET, LOW PASS FILTER | 2
13 | 01-0070 |  | STANDOFF, M3 X 30mmLG, M/F | 8 |  |  | McMASTER-CARR | 93655A223
14 | 10-0152 | 1 | BRACKET, PMT CONTROL INTERFACE PCB | 1
15 | 10-0151 | 1 | COVER, ELECTRO-OPTICS CONTROL BOX | 1
16 | 60-0077 | 1 | CABLE, USB A TO USB B, 0.5M | 1 | L-COM | ECUSBAB-05M
17 | 60-0008 | 1 | ADAPTER, COAXIAL, SMA-MALE, BNC-MALE | 4 | Molex | 0733860013 | DIGI-KEY | WM15609-ND
18 | 60-0009 | 1 | CABLE, COAXIAL, RG174, SMA-MALE, BNC-MALE, 6" | 2 | L-COM | CC174SB-05
19 | 60-0010 | 1 | CABLE, COAXIAL, RG174, SMA-MALE, BNC-MALE, 12" | 2 | L-COM | CC174SB-1
20 | 60-0011 | 1 | CABLE, COAXIAL, RG174, SMA-MALE, SMA-MALE, 12" | 2 | L-COM | CC174S-1
21 | 60-0012 | 1 | CABLE, COAXIAL, RG174, SMA-MALE, SMA-MALE, 18" | 2 | L-COM | CC174S-1
22 | 60-0051 | 1 | ASSY, HARNESS, PS TO AMPLIFIERS, ELECTRO-OPTICS CTRL BOX | 1 | GENTURI
23 | 60-0050 | 1 | ASSY, HARNESS, DAQ TO PCB, ELECTRO-OPTICS CTRL BOX | 1 | GENTURI
24 | 60-0049 | 1 | ASSY, HARNESS, PS TO PCB, ELECTRO-OPTICS CTRL BOX | 1 | GENTURI
