Genturi/NewAlphaElectrical/SubSystems/Marco/MarcoBOM.xlsx

Sheet: BOM
Item # | Designation | Description | Manufacturer | Mfg P/N | Digi-Key P/N | Digi-Key Cost | Mouser P/N | Mouser Cost | Quantity | Extended Cost | Genturi P/N | Comment
1 |  | Power Entry Connector Receptacle, Male Blades IEC 320-C14 Panel Mount, Snap-In | Qualtek | 701W-X2/02 | Q207-ND (https://www.digikey.com/products/en?keywords=701W-X2%2F02) | $0.83 |  |  | 1 | $0.83 | 06-0040
2 | J1 | Flanged Panel Mounted USB 2.0 Coupler - Shielded, Type B/A Connectors | L-Com | ECF504-BA (http://www.l-com.com/usb-flanged-panel-mounted-usb-20-coupler-shielded-type-b-a-connectors) | N/A |  |  |  | 1 | $12.44 | 06-0041
3 | N1 | USB-based 4-channel, 16-bit analog voltage output device, 8 digital I/O, with one counter | Measurement Computing | USB-3101 (https://www.mccdaq.com/usb-data-acquisition/USB-3100-Series.aspx) | N/A |  |  |  | 1 | $330.00 | 06-0019 | DAQ module
4 | V1 | CABLE, USB A TO USB B, 0.5M | L-Com | ECUSBAB-05M (http://www.l-com.com/usb-deluxe-usb-cable-type-a-b-cable-05m) | N/A |  |  |  | 1 | $5.75 |  | USB-A to USB-B 0.5M
5 |  | Linear AC DC Converter 2 Output 15V -15V 1.5A, 1.5A 100 ~ 240 VAC Input | SL Power Electronics Manufacture of Condor/Ault Brands | HBB15-1.5-A+G | 271-2280-ND (https://www.digikey.com/product-detail/en/sl-power-electronics-manufacture-of-condor-ault-brands/HBB15-1.5-A-G/271-2280-ND/1035138) | $131.62 |  |  | 1 | $131.62 | 06-0027
6 |  | Linear AC DC Converter 1 Output 5V 3A 100 ~ 240 VAC Input | SL Power Electronics Manufacture of Condor/Ault Brands | HB5-3-OV-A+G | 271-2253-ND (https://www.digikey.com/products/en?keywords=271-2253-ND) | $80.90 |  |  | 1 | $80.90 | 06-0028
7 | J2-J9 | Adapter Coaxial Connector SMA Jack, Female Socket To SMA Jack, Female Socket 50Ohm | Amphenol RF Division | 132170 | ACX1244-ND (https://www.digikey.com/product-detail/en/amphenol-rf-division/132170/ACX1244-ND/1011921) | $8.09 |  |  | 8 | $64.72 | 06-0029
8 | N2-N5 | 200 MHz Lowpass Filter | KR Electronics, Inc. | 3070-SMA (http://krfilters.com/filter-docs/3070-SMA.pdf) |  |  |  |  | 4 | $676.00 | 06-0005
9 | N6-N9 | 400 MHZ, G=5000, 400MHz Amp | Femto Messtechnik GmbH | HCA-400M-5K-C (https://www.femto.de/en/products/current-amplifiers/fixed-gain-up-to-400-mhz-hca.html) |  |  |  |  | 4 | $6800.00 | 06-0011
10 | N1 | PCB, Arabesque | Genturi | 30-0003 | NA | N/A | N/A |  | 1 |  | 30-0003 | General Interface board
11 |  | Adapter Coaxial Connector BNC Plug, Male Pin To SMA Plug, Male Pin 50Ohm | Molex | 0733860013 | WM15609-ND (https://www.digikey.com/products/en?keywords=73386-0013%20) | $11.19 |  |  | 4 | $44.76 | 60-0008
12 |  | RG174 Coaxial Cable, SMA Male / BNC Male, 0.5 ft | L-Com | CC174SB-05 (http://www.l-com.com/coaxial-rg174-coaxial-cable-sma-male-bnc-male-05-ft) |  | $18.20 |  |  | 2 | $36.40 | 60-0009
13 |  | RG174 Coaxial Cable, SMA Male / BNC Male, 1.0 ft | L-Com | CC174SB-1 (http://www.l-com.com/coaxial-rg174-coaxial-cable-sma-male-bnc-male-10-ft) |  | $18.37 |  |  | 2 | $36.74 | 60-0010
14 |  | RG174 Coaxial Cable, SMA Male / Male, 1.0ft | L-Com | CC174S-1 (http://www.l-com.com/coaxial-rg174-coaxial-cable-sma-male-male-10ft) |  | $23.15 |  |  | 2 | $46.30 | 60-0011
15 |  | RG174 Coaxial Cable, SMA Male / Male, 1.5 ft | L-Com | CC174S-1.5 (http://www.l-com.com/coaxial-rg174-coaxial-cable-sma-male-male-15-ft) |  | $23.55 |  |  | 2 | $47.10 | 60-0012
16 |  | ASSY, HARNESS, PS TO AMPLIFIERS, ELECTRO-OPTICS CTRL BOX | Genturi | 60-0051 | N/A | N/A |  |  | 1 |  | 60-0051
17 |  | ASSY, HARNESS, DAQ TO PCB, ELECTRO-OPTICS CTRL BOX | Genturi | 60-0050 | N/A | N/A |  |  | 1 |  | 60-0050
18 |  | ASSY, HARNESS, PS TO PCB, ELECTRO-OPTICS CTRL BOX | Genturi | 60-0049 | N/A | N/A |  |  | 1 |  | 60-0049
19 |  | ASSY, HARNESS, AC PWR INPUT, ELECTRO-OPTICS CONTROL BOX | Genturi | TBD
 |  | Not required--remove from BOM
 |  | This was changed and requires a Genturi P/N
 |  | New part--requires Genturi P/N
 |  | This part is incorrect in the master and needs to be changed

Sheet: Cable Assemblies
Item # | Designation | Description | Comment | Genturi P/N | Manufacturer | Mfg P/N | Digi-Key P/N | Digi-Key Cost | Mouser P/N | Mouser Cost | Cost
 |  | PMT to amplifier (SMA male to BNC female) | Off-the-shelf
 |  | 200MHz filter to output (SMA male to SMA male) | Off-the-shelf
 |  | +/-15V PS to 400MHz amplifer | In-house
 |  | Premium USB Cable Type A - B Cable, 0.5m | Off-the-shelf | 06-0005 | L-Com | CSMUAB-05M (http://www.l-com.com/usb-premium-usb-cable-type-a-b-cable-05m) | N/A |  |  |  | $8.28
 |  | USB-3101 to Arabesque | In-house
 |  | +5V Power supply to Arabesque | In-house
 |  | AC Pwr entry |  | TBD

Sheet: AC Pwr entry(60-0105)
Item | Description | Genturi P/N | Mfg | Mfg P/N | Digi-key P/N | Quantity | Cost | Extended Cost
 | # 16 black wire | 60-0015 |  |  |  | TBD
 | #16 white wire | 60-0016 |  |  |  | TBD
 | #12 green wire | 60-0080 |  |  |  | TBD
 | #10/12 X #10 Ring terminal | 05-0037

Sheet: 15V PS to 400MHz amp(60-0051)
Item | Description | Genturi P/N | Mfg | Mfg P/N | Digi-key P/N | Quantity | Cost | Extended Cost
 | 3 Position Circular Connector Plug, Female Sockets and Male Pins Solder Cup | 05-0010 | LEMO | FFA.1S.303.CLAC52 | FFA.1S.303.CLAC52-ND (https://www.digikey.com/product-detail/en/lemo/FFA.1S.303.CLAC52/FFA.1S.303.CLAC52-ND/3688991) | 4 | $39.42 | $157.68
 | #22 white wire | 60-0020 |  |  |  | TBD
 | #22 black wire | 60-0018 |  |  |  | TBD
 | #22 Blue wire | 60-0022 |  |  |  | TBD

Sheet: USB-3101 to Arabesque(60-0050)
Item | Description | Genturi P/N | Mfg | Mfg P/N | Digi-key P/N | Quantity | Cost | Extended Cost
 | Wire Pin Terminal Connector 22-26 AWG (0.1~0.4mm²) PIDG Crimp | 05-0053 | TE Connectivity AMP Connectors | 165514-1 | 165514-1-ND (https://www.digikey.com/product-detail/en/165514-1/165514-1-ND/1136542/?itemSeq=311538633) | 8
 | 8 Position Rectangular Housing Connector Receptacle Black 0.118" (3.00mm) | 05-0011 | Molex | 0430250800 | WM1786-ND (https://www.digikey.com/product-detail/en/molex/0430250800/WM1786-ND/252499) | 1 | $0.51 | $0.51
 | Socket Contact Tin 20-24 AWG Crimp Power | 05-0012 | Molex | 0430300007 | WM1837-ND (https://www.digikey.com/products/en?keywords=wm1837-nd) | 8 | $0.19 | $1.52
 | #24 black wire | 60-0034 |  |  |  | TBD
 | #24 brown wire | 60-0027 |  |  |  | TBD
 | #24 red wire | 60-0033 |  |  |  | TBD
 | #24 orange wire | 60-0029 |  |  |  | TBD
 | #24 green wire | 60-0028 |  |  |  | TBD

Sheet: +5V Pwr sply to Arbsqu(60-0049)
Item | Description | Genturi P/N | Mfg | Mfg P/N | Digi-key P/N | Quantity | Cost | Extended Cost
 | 4 Position Rectangular Housing Connector Receptacle Natural 0.165" (4.20mm) | 05-0013 | Molex | 0039012040 | WM3701-ND (https://www.digikey.com/products/en?keywords=WM3701-ND) | 1 | 0.31 | 0.31
 | Socket Contact Tin 18-24 AWG Crimp Power | 05-0014 | Molex | 39000039 | WM2501-ND (https://www.digikey.com/products/en?keywords=WM2501-ND) | 4 | 0.18 | 0.72
 | #22 red wire | 60-0017 |  |  |  | TBD
 | #22 black wire | 60-0018 |  |  |  | TBD
