Genturi/NewAlphaElectrical/SubSystems/Tarja/50-0036 BOM Tarja.xlsx

 | 50-0036 |  | ASSY, LASER ELECTRONICS
ITEM NO. | PART NO. | REVISION | DESCRIPTION | QTY. | MFR. | MFR P/N | VENDOR | VENDOR NO
1 | 10-0146 | 1 | HOUSING, BOTTOM, TARJA, ISA | 1
2 | 78-0029 | 1 | LASER CONTROLLER | 1 | COHERENT | 1173961
3 | 78-0028 | 1 | LASER, OBIS, 488NM, 20MW, FIBER COUPLED, SOLID STATE | 2 | COHERENT
4 | 74-0010 | 1 | FAN, 60mm SQ X 25mm THK,95/264VAC, 19.5 CFM, 3950RPM. BALL | 2 | ORION FANS | OA60EC-UR-1WB | DIGI-KEY | 1053-1809-ND
5 | 06-0025 | 1 | POWER ENTRY MODULE, 250VAC, 10A, FUSED, HORIZONTAL | 1 | BULGIN | BZH01/Z0000/11 | DIGI-KEY | 708-2406-ND
6 | 06-0026 | 1 | LINE FILTER, 125/250VAC,4A, 50/60HZ, 3 STAGE | 1 | SCHURTER INC | 5500.2048 | DIGI-KEY | 486-6367-ND
7 | 06-0024 | 1 | AC/DC CONVERTER, 12V,5A, 60W, OPEN FRAME | 1 | TDK-LAMBDA | ZPSA6012 | DIGI-KEY | 285-1841-ND
8 | 06-0023 | 1 | HUB, USB, 4 PORT, NETWORK | 1 | B&B SMARTWORKS INC | BB-USBHUB4OEM | DIGI-KEY | 1165-1059-ND
9 | 05-0015 | 1 | CONNECTOR, POWER-ENTRY, RECEPTICAL, DUAL, C14 | 1 | QUALTEK | 742W-15/04 | DIGI-KEY | Q848-ND
10 | 10-0148 | 1 | LASER MOUNT, DOUBLE | 1
11 | 05-0004 | 1 | CONNECTOR, D-SUB, RECEPTACLE, 9 POS, PANEL MOUNT | 1 | NORCOMP | 171-009-203L001 | DIGI-KEY | 209FE-ND
12 | 01-0071 | 1 | FILTER, 60mm FAN, AL SCREEN | 2 | ORION | WMG60M | DIGI-KEY | 1053-1400-ND
13 | 10-0147 | 1 | HOUSING, TOP | 1
14 | 02-0035 | 1 | SCREW, M3 X 0.5 X 6, SS, SHCS, BO | 16 |  |  | MCMASTER CARR | 90348A004
15 | 02-0037 | 1 | SCREW, M6 X 1 X 8, STL, SHCS, BO | 8 |  |  | MCMASTER CARR | 91290A312
16 | 02-0036 | 1 | SCREW, M3 X 0.5 X 30, SS, SHCS, PASSIVATED | 8 |  |  | MCMASTER CARR | 91292A022
17 | 02-0034 | 1 | SCREW, M3 X 0.5 X 10mm LG, SHCS, 18-8 SS, BO | 2 |  |  | McMASTER-CARR | 90348A006
18 | 01-0069 | 1 | STANDOFF, 4-40 X 3/16 LG X 3/16 HEX | 2 |  |  | McMASTER-CARR | 91299A110
19 | 04-0005 | 1 | WASHER, LOCK, NO. 4, 18-8SS | 2 |  |  | MCMASTER CARR | 92146A530
20 | 03-0004 | 1 | NUT, 4-40, 3/16HEX, 18-8SS | 2 |  |  | McMASTER-CARR | 90730A005
21 | 60-0007 | 1 | CABLE, USB A TO USB B MINI, 0.5M | 2 | L-COM | CSMUAMB5-05M
22 | 60-0013 | 1 | CABLE, OBIS-LASER, 0.3M | 1 | COHERENT | 1197523
23 | 60-0048 | 1 | ASSY, HARNESS, POWER-INPUT TO LINE FILTER, LASER ELECTRONICS BOX | 1 | GENTURI
24 | 60-0047 | 1 | ASSY, HARNESS, LINE-FILTER TO POWER SUPPLY, LASER ELECTRONICS BOX | 1 | GENTURI
25 | 60-0046 | 1 | ASSY, HARNESS, POWER-SUPPLY TO LASER CONTROL, LASER ELECTRONICS BOX | 1 | GENTURI
