Genturi/NewAlphaElectrical/SubSystems/Tarja/TarjaBOM.xlsx

Sheet: BOM
Item # | Designation | Description | Manufacturer | Mfg P/N | Digi-Key P/N | Digi-Key Cost | Mouser P/N | Mouser Cost | Quantity | Extended Cost | Genturi P/N | Comment
1 |  | Fan Tubeaxial 95 ~ 264VAC Square - 60mm L x 60mm H Ball 19.5 CFM (0.546m³/min) 2 Wire Leads | Orion Fans | OA60EC-UR-1WB | 1053-1809-ND (https://www.digikey.com/product-detail/en/orion-fans/OA60EC-UR-1WB/1053-1809-ND/9380228) | $28.60 |  |  | 2 | $57.20 | 74-0010
2 |  | Power Entry Connector Receptacle, Male Blades - Module IEC 320-C14 Panel Mount, Snap-In | Bulgin | BZH01/Z0000/11 | 708-2406-ND (https://www.digikey.com/products/en?keywords=708-2406-ND) | $12.91 |  |  | 1 | $12.91 | 06-0025
3 |  | Single Phase EMC/EMI Line Filter 4A 125V, 250VAC 50/60Hz Three Stage Terminal Block | Schurter Inc. | 5500.2048 | 486-6367-ND (https://www.digikey.com/product-detail/en/schurter-inc/5500.2048/486-6367-ND/642780) | $202.34 |  |  | 1 | $202.34 | 06-0026 | I think we can find a cheaper alternative
4 |  | Network Hub, USB Ports | B&B SmartWorx, Inc. | BB-USBHUB4OEM | 1165-1059-ND (https://www.digikey.com/product-detail/en/b-b-smartworx-inc/BB-USBHUB4OEM/1165-1059-ND/3045945) | $135.96 |  |  | 1 | $135.96 | 06-0023 | USB hub
5 |  | Open Frame AC DC Converter 1 Output 12V 5A 90 ~ 264 VAC Input | TDK-Lambda Americas Inc. | ZPSA6012 | 285-1841-ND (https://www.digikey.com/product-detail/en/tdk-lambda-americas-inc/ZPSA6012/285-1841-ND/1963689) | $31.08 |  |  | 1 | $31.08 | 06-0024
6 |  | USB A to USB mini B cable, 0.5m | L-Com | CSMUAMB5-05M (http://www.l-com.com/usb-premium-usb-cable-type-a-mini-b-5-position-05m) | N/A |  |  |  | 2 | $9.47 | 60-0007
7 |  | OBIS LX/LS Single Laser Remote | Coherent | 1173961 (https://www.coherent.com/lasers/laser/obis-single-laser-remote) |  |  |  |  |  |  | 78-0029
8 |  | OBIS LX/LS FP (Fiber-Pigtailed) 488nM | Coherent |  |  |  |  |  |  |  | 78-0028
9 |  | OBIS Laser Cable (0.3 meter) | Coherent | 1197523 (https://www.coherent.com/lasers/laser/obis-laser-cable-0-3-meter) |  |  |  |  |  |  | 60-0013
13 |  | 9 Position D-Sub Receptacle, Female Sockets Connector | NorComp Inc. | 171-009-203L001 | 209FE-ND (https://www.digikey.com/product-detail/en/norcomp-inc/171-009-203L001/209FE-ND/858108) | $0.93 |  |  | 1 | $0.93 | 05-0004
14 |  | Power Entry Connector Receptacle, Female Sockets IEC 320-2-2/F (C14 Variant) Panel Mount, Snap-In | Qualtek | 742W-15/04 | Q848-ND (https://www.digikey.com/product-detail/en/qualtek/742W-15-04/Q848-ND/1466709) | $2.05 |  |  | 1 | $2.05 | 05-0015
15 |  | ASSY, HARNESS, POWER-INPUT TO LINE FILTER, LASER ELECTRONICS BOX | Genturi | 60-0048
16 |  | ASSY, HARNESS, LINE-FILTER TO POWER SUPPLY, LASER ELECTRONICS BOX | Genturi | 60-0047
17 |  | ASSY, HARNESS, POWER-SUPPLY TO LASER CONTROL, LASER ELECTRONICS BOX | Genturi | 60-0046
 |  | Not required--remove from BOM
 |  | This was changed and requires a Genturi P/N
 |  | New part--requires Genturi P/N
 |  | This part is incorrect in the master and needs to be changed

Sheet: Pwr swtch to Fans & LF(60-0048)
Item | Description | Genturi P/N | Mfg | Mfg P/N | Digi-key P/N | Quantity | Cost | Extended Cost
0.250" (6.35mm) Quick Connect Female 14-16 AWG Crimp Connector Fully Insulated |  | 05-0064 | TE Connectivity AMP Connectors | 3-350820-2 |  | 4
#16 black wire |  | 60-0015 |  |  |  | TBD
#16 white wire |  | 60-0016 |  |  |  | TBD
#12 Green wire |  | 60-0080 |  |  |  | TBD
0.250" (6.35mm) Quick Connect Female 10-12 AWG Crimp Connector Fully Insulated |  | 05-0063 | TE Connectivity AMP Connectors | 4-520448-2 |  | 3
#22 black wire |  | 60-0018 |  |  |  | TBD
#22 white wire |  | 60-0020 |  |  |  | TBD
Wire Pin Terminal Connector 14-16 AWG Plasti-Grip Crimp |  | 05-0059 | TE Connectivity AMP Connectors | 165171 |  | 2
#10/12 X #10 Ring terminal (05-0037) |  | 05-0037 |  |  |  | 1
#18-22 Butt-splice |  | 05-0062 |  |  |  | 2

Sheet: LF to PS & AC out(60-0047)
Item | Description | Genturi P/N | Mfg | Mfg P/N | Digi-key P/N | Quantity | Cost | Extended Cost
 | Wire Pin Terminal Connector 10-12 AWG Plasti-Grip Crimp | 05-0060 | TE Connectivity AMP Connectors | 165085 | A99255-ND (https://www.digikey.com/products/en?keywords=A99255-ND) | 3
 | 3 Position Rectangular Housing Connector Receptacle Natural 0.156" (3.96mm) | 05-0052 | Molex | 9503031 | WM2101-ND (https://www.digikey.com/product-detail/en/0009503031/WM2101-ND/26455/?itemSeq=311556126) | 1
 | Non-Gendered Contact Tin 18-24 AWG Crimp | 05-0065 | Molex | 8500106 | WM2300-ND (https://www.digikey.com/products/en?keywords=08-50-0106) | 2
 | 18 AWG Hook-Up Wire 16/30 White 600V 100.0' (30.5m) | 60-0091 | Alpha Wire | 3075 WH005 | A2103W-100-ND (https://www.digikey.com/products/en?keywords=A2103W-100-ND) | TBD
 | 18 AWG Hook-Up Wire 16/30 Black 600V 100.0' (30.5m) | 60-0092 | Alpha Wire | 3075 BK005 | A2103B-100-ND (https://www.digikey.com/product-detail/en/alpha-wire/3075-BK005/A2103B-100-ND/204492) | TBD
 | #16 black wire | 60-0015 |  |  |  | TBD
 | #16 white wire | 60-0016 |  |  |  | TBD
 | #12 green wire | 60-0080 | Alpha Wire | 3080 GR005 | A3080G-100-ND (https://www.digikey.com/product-detail/en/alpha-wire/3080-GR005/A3080G-100-ND/281628) | TBD

Sheet: Power supply to lasers(17)
Item | Description | Genturi P/N | Mfg | Mfg P/N | Digi-key P/N | Quantity | Cost | Extended Cost
 | 4 Position Rectangular Housing Connector Receptacle Natural 0.156" (3.96mm) | 05-0051 | Molex | 9503041 | WM2102-ND (https://www.digikey.com/product-detail/en/0009503041/WM2102-ND/26457/?itemSeq=311556295) | 1 | $0.22 | $0.22
 | Non-Gendered Contact Tin 18-24 AWG Crimp | 05-0065 | Molex | 8500106 | WM2300-ND (https://www.digikey.com/products/en?keywords=08-50-0106) | 4
 | 2 Position Rectangular Housing Connector Receptacle Black 0.118" (3.00mm) | 05-0016 | Molex | 0430250200 | WM1783-ND (https://www.digikey.com/products/en?keywords=WM1783-ND) | 2 | $0.32 | $0.64
 | Socket Contact Tin 20-24 AWG Crimp Power | 05-0012 | Molex | 0430300007 | WM1837-ND (https://www.digikey.com/products/en?keywords=wm1837-nd) | 4 | $0.19 | $0.76
 | #22 yellow wire | 60-0023 |  |  |  | TBD
 | #22 black wire | 60-0018 |  |  |  | TBD
