Genturi/NewAlphaElectrical/SubSystems/Troy/50-0041_FullBOM_(Troy).xlsx

Item # | PartNo | Revision | Description | Qty | MFR | MFRPN | Vendor | VendorNo | Material | Finish | File Name
1 | 10-0161 |  | POLYGON ELECTRONICS BOX MOUNTING PLATE | 1 | Genturi |  |  |  |  |  | 10-0161.SLDPRT
2 | 10-0163 |  | POLYGON ELECTRONICS BOX BASE | 1 | Genturi |  |  |  |  |  | 10-0163.SLDASM
3 | 06-0031 | 1 | FILTER, LINE, SINGLE PHASE EMC/EMI, 250VAC 10A 50/60HZ | 1 | TE CONNECTIVITY | 10VN1 | DIGI-KEY | CCM1649-ND |  |  | 06-0031.SLDPRT
4 | 74-0010 | 1 | FAN, 60mm SQ X 25mm THK,95/264VAC, 19.5 CFM, 3950RPM. BALL | 1 | Orion Fans | OA60EC-UR-1WB | DIGI-KEY | 1053-1809-ND | N/A | N/A | 74-0010.SLDPRT
5 | 10-0160 |  | POLYGON ELECTRONICS BOX PCB BRACKET | 1 | Genturi |  |  |  |  |  | 10-0160.SLDASM
6 | 06-0025 |  | POWER ENTRY MODULE, 250VAC, 10A, FUSED, HORIZONTAL | 1 | BULGIN | BZH01/Z0000/11 | DIGI-KEY | 708-2406-ND |  |  | 06-0025.SLDPRT
7 | 06-0032 |  | CONTROLLER, POLYGON SCANNER | 1 | NOVANTA | 1-2-3236-601-54 |  |  |  |  | 06-0032.SLDPRT
8 | 30-0007 |  | PCB ASSEMBLY, BMC-7 INTERFACE | 1 | Genturi |  |  |  |  |  | 30-0007.SLDASM
9 | 10-0162 |  | POLYGON ELECTRONICS BOX COVER | 1 | Genturi |  |  |  |  |  | 10-0162.SLDPRT
10 | 06-0030 |  | CONVERTER, AC/DC, 1 OUTPUT 57V 10.6A | 1 | TDK LAMBDA | EVS57-10R6 | DIGI-KEY | 285-2551-ND |  |  | 06-0030.SLDPRT
11 | 60-0045 |  | ASSY, HARNES, POWER-INPUT TO POWER SUPPLY, POLYGON ELECTRONICS BOX | 1 | Genturi
12 | 60-0044 |  | ASSY, HARNESS, LINE-FILTER TO POWER SUPPLY, POLYGON ELECTRONICS BOX | 1 | Genturi
13 | 60-0043 |  | ASSY, POLYGON CTRL BRD TO INTERFACE PCB, POLYGON ELECTRONICS BOX | 1 | Genturi
