Genturi/NewAlphaElectrical/SubSystems/Troy/TroyBOM.xlsx

Sheet: BOM
Item # | Designation | Description | Manufacturer | Mfg P/N | Digi-Key P/N | Digi-Key Cost | Mouser P/N | Mouser Cost | Quantity | Extended Cost | Genturi P/N | Comment
1 |  | Fan Tubeaxial 95 ~ 264VAC Square - 60mm L x 60mm H Ball 19.5 CFM (0.546m³/min) 2 Wire Leads | Orion Fans | OA60EC-UR-1WB | 1053-1809-ND (https://www.digikey.com/product-detail/en/orion-fans/OA60EC-UR-1WB/1053-1809-ND/9380228) | $28.60 |  |  | 2 | $57.20 | 74-0010
2 |  | Power Entry Connector Receptacle, Male Blades - Module IEC 320-C14 Panel Mount, Snap-In | Bulgin | BZH01/Z0000/11 | 708-2406-ND (https://www.digikey.com/products/en?keywords=708-2406-ND) | $12.91 |  |  | 1 | $12.91 | 06-0025
3 |  | Single Phase EMC/EMI Line Filter 10A 250VAC 50/60Hz Three Stage Quick Connect | TE Connectivity Corcom Filters | 10VN1 | CCM1649-ND (https://www.digikey.com/product-detail/en/te-connectivity-corcom-filters/10VN1/CCM1649-ND/361444) | $71.97 |  |  | 1 | $71.97 | 06-0031
4 |  | Enclosed AC DC Converter 1 Output 57V 10.6A 85 ~ 265 VAC Input | TDK-Lambda Americas Inc. | EVS57-10R6 | 285-2551-ND (https://www.digikey.com/product-detail/en/tdk-lambda-americas-inc/EVS57-10R6/285-2551-ND/6052047) | $304.00 |  |  | 1 | $304.00 | 06-0030
5 |  | Polygon Scanner Controller | Novanta | BMC-7 | N/A |  |  |  | 1 |  | 74-0000 | Part of polygon scanner
6 |  | PCB, Scaretale | Genturi | 30-0007 |  |  |  |  | 1 |  | 30-0007
7 |  | ASSY, HARNES, POWER-INPUT TO POWER SUPPLY, POLYGON ELECTRONICS BOX |  | 60-0045 |  |  |  |  | 1 |  | 60-0045
8 |  | ASSY, HARNESS, LINE-FILTER TO POWER SUPPLY, POLYGON ELECTRONICS BOX |  | 60-0044 |  |  |  |  | 1 |  | 60-0044
9 |  | ASSY, POLYGON CTRL BRD TO INTERFACE PCB, POLYGON ELECTRONICS BOX |  | 60-0043 |  |  |  |  | 1 |  | 60-0043

Sheet: Power entry to Ln Fltr(60-0045)
Item | Description | Comment | Mfg | Mfg P/N | Digi-key P/N | Genturi P/N | Quantity | Cost | Ext Cost
 | 0.250" (6.35mm) Quick Connect Female 14-16 AWG Crimp Connector Fully Insulated |  | TE Connectivity AMP Connectors | 3-350820-2 | A27824-ND (https://www.digikey.com/products/en?keywords=A27824-ND) | 05-0064 | 6
 | 0.250" (6.35mm) Quick Connect Female 10-12 AWG Crimp Connector Fully Insulated |  | TE Connectivity AMP Connectors | 4-520448-2 | A27831-ND (https://www.digikey.com/products/en?keywords=A27831-ND) | 05-0063 | 3
 | Ring Terminal Connector 10 Stud Circular 10-12 AWG Crimp |  | Molex | 190730170 | WM18310-ND (https://www.digikey.com/product-detail/en/molex/0190730170/WM18310-ND/279111) | 05-0037 | 1
 | Terminal Butt Splice, Inline, Individual Openings Connector Crimp 18-22 AWG Red |  | Molex | 191640013 | WM18425-ND (https://www.digikey.com/product-detail/en/0191640013/WM18425-ND/279226/?itemSeq=311660212) | 05-0062 | 2
 | #16 Black wire |  |  |  |  | 60-0015 | TBD
 | #16 white wire |  |  |  |  | 60-0016 | TBD
 | #22 white wire |  | Alpha Wire | 3071 WH005 | A2101W-100-ND (https://www.digikey.com/product-detail/en/alpha-wire/3071-WH005/A2101W-100-ND/204453) | 60-0094 | TBD
 | #22 black wire |  | Alpha Wire | 3071 BK005 | A2101B-100-ND (https://www.digikey.com/product-detail/en/alpha-wire/3071-BK005/A2101B-100-ND/204452) | 60-0095 | TBD
 | #16 green wire |  | Alpha Wire | 3080 GR005 | A3080G-100-ND (https://www.digikey.com/product-detail/en/alpha-wire/3080-GR005/A3080G-100-ND/281628) | 60-0080 | TBD

Sheet: Ln fltr to pwr supply(60-0044)
Item | Description | Comment | Genturi P/N | Mfg | Mfg P/N | Digi-key P/N | Quantity | Cost | Extended Cost
 | 16 AWG Hook-Up Wire 26/30 Green 600V 100.0' (30.5m) | Ground stud to +57V power supply | 60-0014 | Alpha Wire | 3077 GR005 | A2104G-100-ND | TBD
 | 16 AWG Hook-Up Wire 26/30 Black 600V 100.0' (30.5m) | Line from L/F to +57V power supply | 60-0015 | Alpha Wire | 3077 BK005 | A2104B-100-ND | TBD
 | 16 AWG Hook-Up Wire 26/30 White 600V 100.0' (30.5m) | Neutral from L/F to +57V power supply | 60-0016 | Alpha Wire | 3077 WH005 | A2104W-100-ND | TBD
 | 0.250" (6.35mm) Quick Connect Female 14-16 AWG Crimp Connector Fully Insulated |  | 05-0064 | TE Connectivity AMP Connectors | 3-350820-2 | A27824-ND (https://www.digikey.com/products/en?keywords=A27824-ND) | 2
 | Ring Terminal Connector 10 Stud Circular 14-16 AWG Crimp |  | 05-0038 | Molex | 190730087 | WM18304-ND (https://www.digikey.com/product-detail/en/molex/0190730087/WM18304-ND/279105) | 1
 | Ring Terminal Connector 6 Stud Circular 14-16 AWG Crimp |  | 05-0044 | Molex | 190730067 | WM18302-ND (https://www.digikey.com/product-detail/en/molex/0190730067/WM18302-ND/279103) | 3

Sheet: BMC-7 J3,J5 to Scretal(60-0043)
Item | Description | Genturi P/N | Mfg | Mfg P/N | Digi-key P/N | Quantity | Cost | Extended Cost
 | 10 Position Rectangular Housing Connector Receptacle Black 0.100" (2.54mm) | 05-0019 | TE Connectivity AMP Connectors | 104257-9 | A28425-ND (https://www.digikey.com/products/en?keywords=A28425-ND) | 2 | $1.32 | $2.64
 | 8 Position Rectangular Housing Connector Receptacle Black 0.100" (2.54mm) | 05-0018 | TE Connectivity AMP Connectors | 102241-6 | A26987-ND (https://www.digikey.com/products/en?keywords=A26987-ND) | 2 | $0.81 | $1.62
 | Socket Contact Gold 22-26 AWG Crimp | 05-0017 | TE Connectivity AMP Connectors | 1-104480-6 | A32513-ND (https://www.digikey.com/products/en?keywords=A32513-ND) | 20 | $0.24 | $4.80
 | #24 White wire | 60-0032 |  |  |  | TBD
 | #24 Black wire | 60-0034 |  |  |  | TBD
 | HOOK-UP STRND 26AWG BLACK 100' | 60-0095 | Alpha Wire | 172619 BK005 | A172619B-100-ND | TBD
 | HOOK-UP STRND 26AWG YELLOW 100' | 60-0096 | Alpha Wire | 172619 YL005 | A172619Y-100-ND | TBD
 | HOOK-UP STRND 26AWG BLUE 100' | 60-0097 | Alpha Wire | 172619 BL005 | A172619L-100-ND | TBD
 | HOOK-UP STRND 26AWG RED 100' | 60-0098 | Alpha Wire | 172619 RD005 | A172619R-100-ND | TBD
 | HOOK-UP STRND 26AWG GREEN 100' | 60-0099 | Alpha Wire | 172619 GR005 | A172619G-100-ND | TBD
 | HOOK-UP STRND 26AWG BROWN 100' | 60-0100 | Alpha Wire | 172619 BR005 | A172619N-100-ND | TBD
 | HOOK-UP STRND 26AWG ORANGE 100' | 60-0101 | Alpha Wire | 172619 OR005 | A172619A-100-ND | TBD

Sheet: Power supply to BMC-7
Item | Description | Genturi P/N | Mfg | Mfg P/N | Digi-key P/N | Quantity | Cost | Extended Cost
 | Ring Terminal Connector 10 Stud Circular 18-22 AWG Crimp | 05-0039 | Molex | 190730017 | WM18297-ND (https://www.digikey.com/product-detail/en/molex/0190730017/WM18297-ND/279098) | 3
 | Ring Terminal Connector 10 Stud Circular 14-16 AWG Crimp | 05-0038 | Molex | 190730087 | WM18304-ND (https://www.digikey.com/product-detail/en/molex/0190730087/WM18304-ND/279105) | 1
 | 5 Position Rectangular Housing Connector Receptacle Natural 0.165" (4.20mm) | 05-0046 | Molex | 39014051 | WM23610-ND (https://www.digikey.com/product-detail/en/0039014051/WM23610-ND/930292/?itemSeq=311646884) | 1
 | Contact, connector, female, mini-fit jr. | 05-0014 | Molex |  |  | 5
 | 18 AWG Hook-Up Wire 34/0.0071" Black 300V 100.0' (30.5m) | 60-0079 | CNC Tech | 1569-18-1-0500-001-1-TS | CN548B-100-ND (https://www.digikey.com/product-detail/en/cnc-tech/1569-18-1-0500-001-1-TS/CN548B-100-ND/7065766) | TBD
 | 18 AWG Hook-Up Wire 34/0.0071" White 300V 100.0' (30.5m) | 60-0078 | CNC Tech | 1569-18-1-0500-002-1-TS | CN549W-100-ND (https://www.digikey.com/product-detail/en/cnc-tech/1569-18-1-0500-002-1-TS/CN549W-100-ND/7065767) | TBD
