Genturi/NewAlphaElectrical/EmppuInterface(Moondance 30-0006)/Assembly/Moondance_ToOrder.xlsx

Item # | Description | Digi-Key P/N | Per Board Quantity | Order Quantity | Trx Order Description
1 | MOD USB UART EMBDED 5V FEMAL | 768-1108-ND (https://www.digikey.com/products/en?keywords=DB9-USB-D5-F) | 1 | 5 | MOD USB UART EMBDED 5V FEMAL (768-1108-ND)
2 | AC/DC CONVERTER 5V 5W | 1866-3027-ND (https://www.digikey.com/product-detail/en/mean-well-usa-inc/IRM-05-5/1866-3027-ND/7704652) | 1 | 5 | AC/DC CONVERTER 5V 5W (1866-3027-ND)
3 | AC/DC CONVERTER 24V 60W | 1866-3067-ND (https://www.digikey.com/product-detail/en/mean-well-usa-inc/IRM-60-24/1866-3067-ND/7704690) | 1 | 5 | AC/DC CONVERTER 24V 60W (1866-3067-ND)
4 | CONN HEADER R/A 16POS 1.25MM | 952-2722-ND (https://www.digikey.com/products/en?keywords=G125-MH11605L7P) | 1 | 5 | CONN HEADER R/A 16POS 1.25MM (952-2722-ND)
5 | CONN D-SUB RCPT 15POS R/A SOLDER | 732-618015211821-ND (https://www.digikey.com/product-detail/en/w-rth-elektronik/618015211821/732-618015211821-ND/10484632) | 1 | 10 | CONN D-SUB RCPT 15POS R/A SOLDER (732-618015211821-ND)
6 | CONN HEADER R/A 5POS 2.54MM | A33864-ND (https://www.digikey.com/product-detail/en/te-connectivity-amp-connectors/5-103635-4/A33864-ND/1122428) | 1 | 10 | CONN HEADER R/A 5POS 2.54MM (A33864-ND)
7 | DSUB FEMALE HIGH DENSITY ANGL | 732-618015325223-ND (https://www.digikey.com/products/en?keywords=618015325223) | 1 | 10 | DSUB FEMALE HIGH DENSITY ANGL (732-618015325223-ND)
8 | CONN SMA JACK R/A 50 OHM PCB | A97593-ND (https://www.digikey.com/product-detail/en/te-connectivity-amp-connectors/5-1814400-1/A97593-ND/1755981) | 1 | 10 | CONN SMA JACK R/A 50 OHM PCB (A97593-ND)
9 | TERM BLK 3POS SIDE ENTRY 5MM PCB | A97997-ND (https://www.digikey.com/product-detail/en/te-connectivity-amp-connectors/1776244-3/A97997-ND/1826860) | 1 | 10 | TERM BLK 3POS SIDE ENTRY 5MM PCB (A97997-ND)
10 | RES SMD 0 OHM JUMPER 1/2W 1210 | 541-0.0VCT-ND (https://www.digikey.com/product-detail/en/vishay-dale/CRCW12100000Z0EA/541-0.0VCT-ND/1182217) | 4 | 100 | RES SMD 0 OHM JUMPER 1/2W 1210 (541-0.0VCT-ND)
11 | FIXED IND 100UH 340MA 1.82 OHM | 587-1628-6-ND (https://www.digikey.com/products/en?keywords=587-1628-6-ND) | 3 | 20 | FIXED IND 100UH 340MA 1.82 OHM (587-1628-6-ND)
12 | CAP CHIP POLY 10UF 35V 2917 | 478-13149-1-ND (https://www.digikey.com/product-detail/en/avx-corporation/TCQD106M035R0070/478-13149-1-ND/9948664) | 6 | 30 | CAP CHIP POLY 10UF 35V 2917 (478-13149-1-ND)
13 | RES SMD 1K OHM 1% 1/10W 0603 | P1.00KHCT-ND (https://www.digikey.com/product-detail/en/panasonic-electronic-components/ERJ-3EKF1001V/P1.00KHCT-ND/198071) | 4 | 100 | RES SMD 1K OHM 1% 1/10W 0603 (P1.00KHCT-ND)
14 | RES SMD 4.7K OHM 1% 1/10W 0603 | P4.70KHCT-ND (https://www.digikey.com/product-detail/en/panasonic-electronic-components/ERJ-3EKF4701V/P4.70KHCT-ND/1746782) | 4 | 100 | RES SMD 4.7K OHM 1% 1/10W 0603 (P4.70KHCT-ND)
15 | CAP TANT POLY 1UF 25V 0805 | 478-8995-1-ND (https://www.digikey.com/product-detail/en/avx-corporation/TCJP105M025R0500/478-8995-1-ND/4561861) | 6 | 30 | CAP TANT POLY 1UF 25V 0805 (478-8995-1-ND)
16 | Power Switch/Driver 1:1 N-Channel 500mA 16-SOIC | 296-51862-1-ND (https://www.digikey.com/product-detail/en/texas-instruments/TPL7407LADR/296-51862-1-ND/9746225) | 1 | 10 | Power Switch/Driver 1:1 N-Channel 500mA 16-SOIC (296-51862-1-ND)
17 | CAP CER 0.1UF 50V C0G 1206 | 445-7694-1-ND (https://www.digikey.com/products/en?keywords=445-7694-1-ND) | 3 | 100 | CAP CER 0.1UF 50V C0G 1206 (445-7694-1-ND)
18 | CAP TANTALUM 47UF 35V 2917 | 399-5937-1-ND (https://www.digikey.com/product-detail/en/kemet/T521X476M035ATE030/399-5937-1-ND/2640607) | 1 | 20 | CAP TANTALUM 47UF 35V 2917 (399-5937-1-ND)
19 | 37 Position D-Sub Receptacle, Female Sockets Connector | L77SDC37SOL2-ND (https://www.digikey.com/product-detail/en/amphenol-icc-commercial-products/L77SDC37SOL2/L77SDC37SOL2-ND/4888704) | 1 | 10 | 37 Position D-Sub Receptacle, Female Sockets Connector (L77SDC37SOL2-ND)
20 | Comparator General Purpose CMOS SC-70-6 | LTC6752ISC6-4#TRMPBFCT-ND (https://www.digikey.com/product-detail/en/linear-technology-analog-devices/LTC6752ISC6-4-TRMPBF/LTC6752ISC6-4-TRMPBFCT-ND/5167574) | 1 | 10 | Comparator General Purpose CMOS SC-70-6 (LTC6752ISC6-4#TRMPBFCT-ND)
21 | RES SMD 75 OHM 1% 1/4W 1206 | P75.0FCT-ND (https://www.digikey.com/products/en/resistors/chip-resistor-surface-mount/52?k=75+Ohm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) | 1 | 100 | RES SMD 75 OHM 1% 1/4W 1206 (P75.0FCT-ND)
22 | RES SMD 2K OHM 1% 1/10W 0603 | P2.00KHCT-ND (https://www.digikey.com/product-detail/en/panasonic-electronic-components/ERJ-3EKF2001V/P2.00KHCT-ND/198219) | 1 | 100 | RES SMD 2K OHM 1% 1/10W 0603 (P2.00KHCT-ND)
23 | RES SMD 19.1K OHM 1% 1/10W 0603 | P19.1KHCT-ND (https://www.digikey.com/products/en/resistors/chip-resistor-surface-mount/52?k=resistor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) | 1 | 100 | RES SMD 19.1K OHM 1% 1/10W 0603 (P19.1KHCT-ND)
24 | RES SMD 10K OHM 1% 1/10W 0603 | P10.0KHCT-ND (https://www.digikey.com/product-detail/en/panasonic-electronic-components/ERJ-3EKF1002V/P10.0KHCT-ND/198102) | 1 | 100 | RES SMD 10K OHM 1% 1/10W 0603 (P10.0KHCT-ND)
25 | RES SMD 15K OHM 1% 1/10W 0603 | P15.0KHCT-ND (https://www.digikey.com/product-detail/en/panasonic-electronic-components/ERJ-3EKF1502V/P15.0KHCT-ND/198172) | 1 | 100 | RES SMD 15K OHM 1% 1/10W 0603 (P15.0KHCT-ND)
26 | RES SMD 107K OHM 1% 1/10W 0603 | P107KHCT-ND (https://www.digikey.com/products/en/resistors/chip-resistor-surface-mount/52?k=resistor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) | 1 | 100 | RES SMD 107K OHM 1% 1/10W 0603 (P107KHCT-ND)
27 | Linear Voltage Regulator IC Positive Fixed 1 Output 100mA SOT-23-5 | TC1015-3.3VCT713CT-ND (https://www.digikey.com/product-detail/en/microchip-technology/TC1015-3.3VCT713/TC1015-3.3VCT713CT-ND/1979796) | 1 | 10 | Linear Voltage Regulator IC Positive Fixed 1 Output 100mA SOT-23-5 (TC1015-3.3VCT713CT-ND)
28 | CAP CER 470PF 50V C0G/NP0 0603 | 478-1183-1-ND (https://www.digikey.com/product-detail/en/avx-corporation/06035A471JAT2A/478-1183-1-ND/564215) | 1 | 20 | CAP CER 470PF 50V C0G/NP0 0603 (478-1183-1-ND)
29 | RES SMD 49.9 OHM 1% 1/8W 0805 | P49.9CCT-ND (https://www.digikey.com/products/en/resistors/chip-resistor-surface-mount/52?k=resistor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) | 1 | 100 | RES SMD 49.9 OHM 1% 1/8W 0805 (P49.9CCT-ND)
30 | CAP CER 0.22UF 25V C0G/NP0 1210 | 399-20368-1-ND (https://www.digikey.com/products/en?keywords=399-20368-1-ND) | 1 | 20 | CAP CER 0.22UF 25V C0G/NP0 1210 (399-20368-1-ND)
