Genturi/NewAlphaElectrical/CartridgeInterface(Stargazers 30-0001)/Revision2/AssociatedParts/30-0001-R2_BOM_&_AssociatedParts.xlsx

Description | Manufacturer | Mfg. P/N | Digi-Key P/N | Digi-Key Unit Cost
10 Position FFC, FPC Cable 0.039" (1.00mm) 18.0" (457.2mm) | Parlex USA, LLC | 100R10-457B | HF10U-18-ND (https://www.digikey.com/products/en/cable-assemblies/flat-flex-ribbon-jumper-cables/457?k=FPC+cable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) | $6.68
