Genturi/NewAlphaElectrical/SystemDesign/SystemInterconnectCables.xlsx

Cable description | From | To | COTS or Custom | Quantity | Genturi P/N | Comment | From Connector | To Connector | NAME
USB A to USB B | Computer | Tarja | COTS | 1 | TBD | this will probably be a standard 2M cable | USB A | USB B
PMT signal to amplifier input | PMT | Marco | Custom | 4 |  | This cable is part of the PMT, but may require an extension. There are 4 of these coming from 2 different types of PMT. | N/A | SMA male
PMT control & Power | PMT | Marco | Custom | 4 |  | the leads exit the PMT directly, but the total length to Marco has yet to be determined. It may vary from PMT to PMT. | N/A | D-9
SOS interconnect | SOS | Marco | COTS or Custom | 1 | TBD | The length this cables need to be determined | USB B micro | USB B micro
Digitizer digital I/O cable | Computer | Marco | COTS | 1 |  | Purchased from Teledyne SP devices | Hirose ST-60-24 | Hirose ST-60-24
Scanner synch | Troy | Marco | Custom | 1 | TBD | The length this cables need to be determined | D-15HD male | D-15HD male | ASSY, HARNESS, POLYGON SCANNER INTERMODULE SYNCH.
Polygon Index | Emppu | Marco | COTS | 1 | TBD | The length this cables need to be determined | SMA male | Sma male
Polygon control | Emppu | Troy | Custom | 1 | TBD | The length this cables need to be determined | D-15HD male | D-15HD female | ASSY, HARNESS, POLYGON SCANNER INTERMODULE CONTROL
Polygon Drive & Control | Polygon | Troy | ? | 1 |  | The length this cables need to be determined. Cable provided by Lincoln Laser, but will need to be customized | N/A | Molex mini-fit Jr. 2x5 female
USB A to USB B | Computer | Jukka | COTS | 1 | TBD | this will probably be a standard 2M cable | USB A | USB B
Bias Voltage A & B | Riddler | Jukka | COTS | 2 | TBD | The length this cables need to be determined | SMA male | Sma male
Motor & Digital I/O | Riddler | Emppu | Custom | 1 | TBD | The length this cables need to be determined | D-50 male | D-37 male, D15 male | ASSY, HARNESS, MOTOR & DIGITAL IO INTERFACE
Heater Drive & Sense | Riddler | Emppu | Custom | 1 | TBD | The length this cables need to be determined | 2x2 micro-fit 3.0 female, 1x3 micro-fit 3.0 female | D-25 male | ASSY, HARNESS, HEATER DRIVE & TEMPERATURE SENSING INTERFACE
Polygon index control | Polygon | Emppu | Custom | 1 |  | The length this cables need to be determined. Cable provided by Lincoln Laser, but will need to be customized | N/A | 1x5 MTE female
