Genturi/NewAlphaElectrical/SubSystems/Emppu/EmppuCableAssemblies.xlsx

Sheet: 60-0035 Run List
Emppu, power entry to fan and line filter input
60-0035
 | From |  |  | To
Signal Name | Object | Pin | Termination | Object | Pin | Termination | Wire Color | Wire Gauge | Wire Length | Wire P/N
Line In | Power entry module (06-0025) | Line | ¼" Fast-on X #14/#16 (05-0064) | Power entry module (06-0025) | 1A | ¼" Fast-on X #14/#16 (05-0064) | Black | #16 | TBD | 60-0015
Neutral In | Power entry module (06-0025) | Neutral | ¼" Fast-on X #14/#16 (05-0064) | Power entry module (06-0025) | 4B | ¼" Fast-on X #14/#16 (05-0064) | White | #16 | TBD | 60-0016
Ground | Power entry module (06-0025) | Ground | ¼" Fast-on X #10/#12 (05-0063) | Ground Stud | --- | #10/12 X #10 Ring terminal (05-0037) | Green | #12 | TBD | 60-0080
Line Out | Power entry module (06-0025) | 2A | ¼" Fast-on X #10/#12 (05-0063) | Fan (74-0010) | Either | #18-22 Butt-splice (05-0062) | Black | #22 | TBD | 60-0018
Line Out | Power entry module (06-0025) | 2A |  | Line Filter (06-0026) | Line | #14-16 Terminal pin (05-0059) | Black | #16 | TBD | 60-0015
Neutral Out | Power entry module (06-0025) | 3B | ¼" Fast-on X #10/#12 (05-0063) | Fan (74-0010) | Either | #18-22 Butt-splice (05-0062) | White | #22 | TBD | 60-0020
Neutral Out | Power entry module (06-0025) | 3B |  | Line Filter (06-0026) | Line | #14-16 Terminal pin (05-0059) | White | #16 | TBD | 60-0016

Sheet: 60-0035 BOM
 | 60-0035
Item | Description | From/To | Genturi P/N | Mfg | Mfg P/N | Digi-key P/N | quantity | Comment
 | 0.250" (6.35mm) Quick Connect Female 14-16 AWG Crimp Connector Fully Insulated |  | 05-0064 | TE Connectivity AMP Connectors | 3-350820-2 |  | 4
 | #16 black wire |  | 60-0015 |  |  |  | ?
 | #16 white wire |  | 60-0016 |  |  |  | TBD
 | #12 Green wire |  | 60-0080 |  |  |  | TBD
 | 0.250" (6.35mm) Quick Connect Female 10-12 AWG Crimp Connector Fully Insulated |  | 05-0063 | TE Connectivity AMP Connectors | 4-520448-2 |  | 3
 | #22 black wire |  | 60-0018 |  |  |  | TBD
 | #22 white wire |  | 60-0020 |  |  |  | TBD
 | Wire Pin Terminal Connector 14-16 AWG Plasti-Grip Crimp |  | 05-0059 | TE Connectivity AMP Connectors | 165171 |  | 2
 | #10/12 X #10 Ring terminal |  | 05-0037 |  |  |  | 1
 | #18-22 Butt-splice |  | 05-0062 |  |  |  | 2

Sheet: 60-0036 Run List
Emppu, Line filter output to power supply inputs, temperature controller & Moondance (30-0006)
This cable run from line filter output to the +15VDC supply, the +24VDC supply, the temperature controller and the power input of Moondance
60-0036
 | From |  |  | To
Signal Name | Object | Pin | Termination | Object | Pin | Termination | Wire Color | Wire Gauge | Wire Length | Wire P/N
Line | Line filter (06-0026) | Line | #10-12 pin, crimp (05-0060) | +15V supply (06-0034) | Line | #14-16 x #6 ring terminal (05-0044) | Black | #16 | TBD | 60-0015
Line | Line filter (06-0026) |  |  | +24V supply (06-0035) | Line | #14-16 x #6 ring terminal (05-0044) | Black | #16 | TBD | 60-0015
Line | Line filter (06-0026) |  |  | Moondance J1 | 3 | #14-16 pin crimp (05-0059) | Black | #16 | TBD | 60-0015
Line | Line filter (06-0026) |  |  | Temp Controller (06-0021) {output/power} | 8 | #14-16 pin crimp (05-0059) | Black | #16 | TBD | 60-0015
Gnd | Line filter (06-0026) | Gnd | #10-12 pin, crimp (05-0060) | +15V supply (06-0034) | Gnd | #14-16 x #6 ring terminal (05-0044) | Green | #16 | TBD | 60-0014
Gnd | Line filter (06-0026) |  |  | +24V supply (06-0035) | Gnd | #14-16 x #6 ring terminal (05-0044) | Green | #16 | TBD | 60-0014
Gnd | Line filter (06-0026) |  |  | Moondance J1 | 2 | #14-16 pin crimp (05-0059) | Green | #16 | TBD | 60-0014
Neutral | Line filter (06-0026) | Neutral | #10-12 pin, crimp (05-0060) | +15V supply (06-0034) | Gnd | #14-16 x #6 ring terminal (05-0044) | White | #16 | TBD | 60-0016
Neutral | Line filter (06-0026) |  |  | +24V supply (06-0035) | Gnd | #14-16 x #6 ring terminal (05-0044) | White | #16 | TBD | 60-0016
Neutral | Line filter (06-0026) |  |  | Moondance J1 | 1 | #14-16 pin crimp (05-0059) | White | #16 | TBD | 60-0016
Neutral | Line filter (06-0026) |  |  | Temp Controller (06-0021) {output/power} | 7 | #14-16 pin crimp (05-0059) | White | #16 | TBD | 60-0016

Sheet: 60-0036 BOM
 | 60-0036
Item | Description | From/To | Genturi P/N | Mfg | Mfg P/N | Digi-key P/N | quantity | Comment
 | Wire Pin Terminal Connector 10-12 AWG Plasti-Grip Crimp |  | 05-0060 | TE Connectivity AMP Connectors | 165085 |  | 3
 | Ring Terminal Connector 6 Stud Circular 14-16 AWG Crimp |  | 05-0044 | Molex | 190730067 |  | 6
 | #16 black wire |  | 60-0015 |  |  |  | ???
 | Wire Pin Terminal Connector 14-16 AWG Plasti-Grip Crimp |  | 05-0059 | TE Connectivity AMP Connectors | 165171 |  | 5
 | #16 green wire |  | 60-0014 |  |  |  | ???
 | #16 white wire |  | 60-0016 |  |  |  | ???

Sheet: 60-0037 Run List
Emppu, +15V power supply to motor controller (06-0022)
60-0037
 | From |  |  | To
Signal Name | Object | Pin | Termination | Object | Pin | Termination | Wire Color | Wire Gauge | Wire Length | Wire P/N
+15V | 15V power supply (06-0034) | +V1 | #14-16 x #6 ring terminal (05-0044) | 6-pin KK 0.1" (05-0006) "PWR" | 1 | crimp pin (05-0009) | White | #22 | TBD | 60-0020
+15V | 15V power supply (06-0034) | +V2 | #14-16 x #6 ring terminal (05-0044) | 6-pin KK 0.1" (05-0006) "PWR" | 5 | crimp pin (05-0009) | White | #22 | TBD | 60-0020
Gnd | 15V power supply (06-0034) | -V1 | #14-16 x #6 ring terminal (05-0044) | 6-pin KK 0.1" (05-0006) "PWR" | 2 | crimp pin (05-0009) | Black | #22 | TBD | 60-0018
Gnd | 15V power supply (06-0034) | -V2 | #14-16 x #6 ring terminal (05-0044) | 6-pin KK 0.1" (05-0006) "PWR" | 6 | crimp pin (05-0009) | Black | #22 | TBD | 60-0018

Sheet: 60-0037 BOM
 | 60-0037
Item | Description | Genturi P/N | Mfg | Mfg P/N | Digi-key P/N | Quantity | Cost | Extended Cost | Comment
 | 6 Position Rectangular Housing Connector Receptacle White 0.100" (2.54mm) | 05-0006 | Molex | 22013067 | WM2004-ND (https://www.digikey.com/products/en?keywords=WM2004-ND) | 1 | $0.29 | $0.29
 | #22 white wire | 60-0020 |  |  |  | TBD
 | #22 black wire | 60-0018 |  |  |  | TBD
 | Terminal pin, crimp, | 05-0009 |  |  |  | 4
 | Ring Terminal Connector 6 Stud Circular 14-16 AWG Crimp | 05-0044 | Molex | 190730067 |  | 4

Sheet: 60-0038 Run List
Emppu, +24V power supply to temperature controller, solid-state relay & D25 Connector
60-0038
 | From |  |  | To
Signal Name | Object | Pin | Termination | Object | Pin | Termination | Wire Color | Wire Gauge | Wire Length | Wire P/N
+24V | +24V Power supply (06-0035) | +V | #14-16 x #6 ring terminal (05-0044) | SSR (06-0037) | 1 | #18-22 x #8 ring terminal (05-0042) | White | #18 |  | 60-0078
Gnd | +24V Power supply (06-0035) | -V | #14-16 x #6 ring terminal (05-0044) | Temp controller (06-0021) Output | 3 | #18-22 pin, crimp (05-0054) | Black | #22 |  | 60-0018
Gnd | +24V Power supply (06-0035) | -V |  | SSR (06-0037) | 4 | #18-22 x #8 ring terminal (05-0042) | Black | #18 |  | 60-0079
Gnd | +24V Power supply (06-0035) | -V |  | D-25 Conn (06-0039) | 1 | Solder | Black | #22 |  | 60-0018
Gnd | +24V Power supply (06-0035) | -V |  | D-25 Conn (06-0039) | 14 | Solder | Black | #22 |  | 60-0018
RelayControl | Temp controller (06-0021) Output | 4 | #18-22 pin, crimp (05-0054) | SSR (06-0037) | 3 | #18-22 x #8 ring terminal (05-0042) | Violet | #22 |  | 60-0024
HeaterDrive | SSR (06-0037) | 2 | #18-22 x #8 ring terminal (05-0042) | D-25 Conn (06-0039) | 3 | Solder | Orange | #22 |  | 60-0019
HeaterDrive | SSR (06-0037) | 2 |  | D-25 Conn (06-0039) | 16 | Solder | Orange | #22 |  | 60-0019
Thermistor 1 | Temp controller (06-0021) Input | 2 | #18-22 pin, crimp (05-0054) | D-25 Conn (06-0039) | 13 | Solder | Brown | #22 |  | 60-0025
Thermistor 2 | Temp controller (06-0021) Input | 3 | #18-22 pin, crimp (05-0054) | D-25 Conn (06-0039) | 25 | Solder | Brown | #22 |  | 60-0025

Sheet: 60-0038 BOM
 | 60-0038
Item | Description | Genturi P/N | Mfg | Mfg P/N | Digi-key P/N | Quantity | Cost | Extended Cost | Comment
 | Ring Terminal Connector 6 Stud Circular 14-16 AWG Crimp | 05-0044 | Molex | 190730067 |  | 2
 | #18 white wire | 60-0078 | CNC Tech | 1569-18-1-0500-002-1-TS |  | TBD
 | Ring Terminal Connector #8 Stud Circular 18-22 AWG Crimp | 05-0042 | Molex | 190730017 |  | 4
 | Wire Pin Terminal Connector 18-22 AWG Avikrimp Crimp | 05-0054 | Molex | 192130009 |  | 4
 | #18 black wire | 60-0079 | CNC Tech | 1569-18-1-0500-001-1-TS |  | TBD
 | #22 black wire | 60-0018
 | #22 violet wire | 60-0024
 | #22 orange wire | 60-0019
 | #22 brown wire | 60-0025
 | 25 Position D-Sub Receptacle, Female Sockets Connector | 06-0039 | NorComp Inc. | 171-025-203L001 | 225FE-ND | 1

Sheet: 60-0039 Run List
Emppu, Motor Controller (06-0022) to D-37 Connector (05-0005)
This cable runs from 8 connectors on the motor controller board to the D37 connector on the front panel
60-0039
 | From |  |  | To
Signal Name | Object | Pin | Termination | Object | Pin | Termination | Wire Color | Wire Gauge | Wire Length | Wire P/N
X_HOME | D-37 (05-0005) | 1 | Solder | 9-pin KK 0.1" (05-0007) "WX" | 2 | crimp pin (05-0009) | Green | #28 | TBD | 60-0081
Y_HOME |  | 20 | Solder | 9-pin KK 0.1" (05-0007) "YZ" | 8 | crimp pin (05-0009) | Blue | #28 | TBD | 60-0085
ROLL_HOME |  | 2 | Solder | 9-pin KK 0.1" (05-0007) "AB" | 2 | crimp pin (05-0009) | Violet | #28 | TBD | 60-0089
PITCH_HOME |  | 21 | Solder | 9-pin KK 0.1" (05-0007) "AB" | 8 | crimp pin (05-0009) | Gray | #28 | TBD | 60-0088
YAW_HOME |  | 3 | Solder | 9-pin KK 0.1" (05-0007) "WX" | 8 | crimp pin (05-0009) | White | #28 | TBD | 60-0087
X_MTR_A1 |  | 10 | Solder | 4-pin KK 0.1" (05-0008) "X" | 4 | crimp pin (05-0009) | Brown | #22 | TBD | 60-0025
X_MTR_A2 |  | 28 | Solder |  | 3 | crimp pin (05-0009) | Red | #22 | TBD | 60-0017
X_MTR_B1 |  | 11 | Solder |  | 2 | crimp pin (05-0009) | Orange | #22 | TBD | 60-0019
X_MTR_B2 |  | 29 | Solder |  | 1 | crimp pin (05-0009) | Yellow | #22 | TBD | 60-0023
Y_MTR_A1 |  | 12 | Solder | 4-pin KK 0.1" (05-0008) "Y" | 4 | crimp pin (05-0009) | Brown | #22 | TBD | 60-0025
Y_MTR_A2 |  | 30 | Solder |  | 3 | crimp pin (05-0009) | Red | #22 | TBD | 60-0017
Y_MTR_B1 |  | 13 | Solder |  | 2 | crimp pin (05-0009) | Orange | #22 | TBD | 60-0019
Y_MTR_B2 |  | 31 | Solder |  | 1 | crimp pin (05-0009) | Yellow | #22 | TBD | 60-0023
ROLL_MTR_A1 |  | 14 | Solder | 4-pin KK 0.1" (05-0008) "B" | 4 | crimp pin (05-0009) | Brown | #22 | TBD | 60-0025
ROLL_MTR_A2 |  | 32 | Solder |  | 3 | crimp pin (05-0009) | Red | #22 | TBD | 60-0017
ROLL_MTR_B1 |  | 15 | Solder |  | 2 | crimp pin (05-0009) | Orange | #22 | TBD | 60-0019
ROLL_MTR_B2 |  | 33 | Solder |  | 1 | crimp pin (05-0009) | Yellow | #22 | TBD | 60-0023
PITCH_MTR_A1 |  | 16 | Solder | 4-pin KK 0.1" (05-0008) "A" | 4 | crimp pin (05-0009) | Brown | #22 | TBD | 60-0025
PITCH_MTR_A2 |  | 34 | Solder |  | 3 | crimp pin (05-0009) | Red | #22 | TBD | 60-0017
PITCH_MTR_B1 |  | 17 | Solder |  | 2 | crimp pin (05-0009) | Orange | #22 | TBD | 60-0019
PITCH_MTR_B2 |  | 35 | Solder |  | 1 | crimp pin (05-0009) | Yellow | #22 | TBD | 60-0023
YAW_MTR_A1 |  | 18 | Solder | 4-pin KK 0.1" (05-0008) "W" | 4 | crimp pin (05-0009) | Brown | #22 | TBD | 60-0025
YAW_MTR_A2 |  | 36 | Solder |  | 3 | crimp pin (05-0009) | Red | #22 | TBD | 60-0017
YAW_MTR_B1 |  | 19 | Solder |  | 2 | crimp pin (05-0009) | Orange | #22 | TBD | 60-0019
YAW_MTR_B2 |  | 37 | Solder |  | 1 | crimp pin (05-0009) | Yellow | #22 | TBD | 60-0023
Gnd |  | 22 | Solder | 9-pin KK 0.1" (05-0007) "WX" | 9 | crimp pin (05-0009) | Black | #22 | TBD | 60-0018
Gnd |  | 4 | Solder | 9-pin KK 0.1" (05-0007) "YZ" | 9 | crimp pin (05-0009) | Black | #22 | TBD | 60-0018
Gnd |  | 23 | Solder | 9-pin KK 0.1" (05-0007) "AB" | 9 | crimp pin (05-0009) | Black | #22 | TBD | 60-0018

Sheet: 60-0039 BOM
 | 60-0039
Item | Description | Genturi P/N | Mfg | Mfg P/N | Digi-key P/N | Quantity | Cost | Extended Cost
 | 9 Position Rectangular Housing Connector Receptacle White 0.100" (2.54mm) | 05-0007 | Molex | 22013097 | WM2007-ND (https://www.digikey.com/products/en?keywords=wm2007-nd) | 3 | $0.43 | $1.29
 | 4 Position Rectangular Housing Connector Receptacle White 0.100" (2.54mm) | 05-0008 | Molex | 22013047 | WM2002-ND (https://www.digikey.com/products/en?keywords=wm2002-nd) | 5 | $0.20 | $1.00
 | Non-Gendered Contact Tin 22-30 AWG Crimp | 05-0009 | Molex | 0008500032 | WM2623-ND (https://www.digikey.com/products/en?keywords=08-50-0032) | 29 | $0.09 | $2.61
 | 37 Position D-Sub Receptacle, Female Sockets Connector | 05-0005 | NorComp Inc. | 171-037-203L001 | 237FE-ND | 1 | 2.63 | $2.63
 | #28 green wire | 60-0081 | Alpha Wire | 3048 GR005 | A3048G-100-ND | TBD
 | #28 blue wire | 60-0085 | Alpha Wire | 3048 BL005 | A3048L-100-ND | TBD
 | #28 violet wire | 60-0089 | Alpha Wire | 3048 VI005 | A3048V-100-ND | TBD
 | #28 slate wire | 60-0088 | Alpha Wire | 3048 SL005 | A3048S-100-ND | TBD
 | #28 white wire | 60-0087 | Alpha Wire | 3048 WH005 | A3048W-100-ND | TBD
 | #22 black wire | 60-0018 |  |  |  | TBD
 | #22 brown wire | 60-0025 |  |  |  | TBD
 | #22 red wire | 60-0017 |  |  |  | TBD
 | #22 orange wire | 60-0019 |  |  |  | TBD
 | #22 yellow wire | 60-0023 |  |  |  | TBD
