Genturi/NewAlphaElectrical/SubSystems/Emppu/SpecialHoochForJ4_of_Emppu(Rev1).xlsx

Wire Color | D-15HD | Signal | MD Convention | Harwin Convention |  | MD Convention | Signal | D-15HD | Wire Color | General Description | Manufacturer | Manufacturer P/N | Vendor | Vendor P/N
 |  | X | 1 | 1 | 9 | 2 | X |  |  | 8 (4 Pair Twisted) Conductor Multi-Pair, Cat5e Cable Gray 26 AWG Foil 1000.0' (304.8m) | IO Audio Technologies | IO-E4261S-5ECMR-1000B | Digi-Key | 1937-1042-ND (https://www.digikey.com/products/en/cables-wires/multiple-conductor-cables/473?k=wire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)
 |  | X | 3 | 2 | 10 | 4 | Tx | 10 | Orange
 |  | X | 5 | 3 | 11 | 6 | Rx | 11 | Red
White/Blue | 4 | Gnd | 7 | 4 | 12 | 8 | +24Raw | 12 | Green; White/Green
 |  | X | 9 | 5 | 13 | 10 | X
 |  | X | 11 | 6 | 14 | 12 | X
 |  | X | 13 | 7 | 15 | 14 | Gnd | 14 | White/Orange
White/Red | 8 | Gnd | 15 | 8 | 16 | 16 | 24Filtered | 15 | Blue
 | 12/11/19: A couple of problems arose with the assembly of Alpha Emppu modules (50-0038) using Moondance (30-0006) Rev 1 boards. Connector J4 was pinned out incorrectly. Mass Design used a conventional odd on one side and even on the other side pin out, but Harwin connectors are sequencial on each side. Secondly, the connectors specified by Dover Motion (Harwin) are difficult to come by as well as being expensive. To solve both problems, a hooch cable will be created. This cable will run directly from the connector holes of J4 to a female D-15HD connector. This will interface directly with the extension cable furnished by Dover Motion.
