Genturi/NewAlphaElectrical/SubSystems/Jukka/JukkaCableAssemblies.xlsx

Sheet: 60-0104 Run List
Jukka, AC input to +5V power supply (06-0042)
60-0104
 | From |  |  | To
Signal Name | Object | Pin | Termination | Object | Pin | Termination | Wire Color | Wire Gauge | Wire Length | Wire P/N
Line in | Power Entry (06-0040) | Line | Solder | +5V supply (06-0042) | Line | #14/16 pin, crimp (05-0059) | Black | #16 | TBD | 60-0015
Neutral in | Power Entry (06-0040) | Neutral | Solder | +5V supply (06-0042) | Neutral | #14/16 pin, crimp (05-0059) | White | #16 | TBD | 60-0016
Ground | Power Entry (06-0040) | Ground | Solder | #10 ground stud | --- | #10/12 X #10 Ring terminal (05-0037) | Green | #12 | TBD | 60-0080

Sheet: 60-0104 BOM
 | 60-0104
Item | Description | Genturi P/N | Mfg | Mfg P/N | Digi-key P/N | Quantity | Cost | Extended Cost
 | Wire Pin Terminal Connector 14-16 AWG Plasti-Grip Crimp | 05-0059 | TE Connectivity AMP Connectors | 165171 | A145081-ND | 2
 | #16 black wire | 60-0015 |  |  |  | TBD
 | #16 white wire | 60-0016 |  |  |  | TBD
 | Ring Terminal Connector 10 Stud Circular 10-12 AWG Crimp | 05-0037 | Molex | 190730170 | WM18310-ND | 1

Sheet: 60-0053 Run List
Jukka, DAQ (06-0019) to Alpenglow (30-0005)
60-0053
 | From |  |  | To
Signal Name | Object | Pin | Termination | Object | Pin | Termination | Wire Color | Wire Gauge | Wire Length | Wire P/N
DAC_0 | USB-3101 (06-0019) | VOUT0 | #22-26 pin, crimp (05-0053) | J2 (2X4 micro-fit 3.0 Recpt) 05-0020 | 3 | Pin/Crimp (05-0020) | Brown | #24 | TBD | 60-0027
Gnd | USB-3101 (06-0019) | AGND | #22-26 pin, crimp (05-0053) |  | 4 | Pin/Crimp (05-0020) | Black | #24 | TBD | 60-0034
DAC_1 | USB-3101 (06-0019) | VOUT1 | #22-26 pin, crimp (05-0053) |  | 5 | Pin/Crimp (05-0020) | Red | #24 | TBD | 60-0033
Gnd | USB-3101 (06-0019) | AGND | #22-26 pin, crimp (05-0053) |  | 6 | Pin/Crimp (05-0020) | Black | #24 | TBD | 60-0034
DAC_2 | USB-3101 (06-0019) | VOUT2 | #22-26 pin, crimp (05-0053) |  | 7 | Pin/Crimp (05-0020) | Orange | #24 | TBD | 60-0029
Gnd | USB-3101 (06-0019) | AGND | #22-26 pin, crimp (05-0053) |  | 8 | Pin/Crimp (05-0020) | Black | #24 | TBD | 60-0034
DAC_3 | USB-3101 (06-0019) | VOUT3 | #22-26 pin, crimp (05-0053) |  | 9 | Pin/Crimp (05-0020) | Green | #24 | TBD | 60-0028
Gnd | USB-3101 (06-0019) | AGND | #22-26 pin, crimp (05-0053) |  | 10 | Pin/Crimp (05-0020) | Black | #24 | TBD | 60-0034
DIO_0 | USB-3101 (06-0019) | DIO0 | #22-26 pin, crimp (05-0053) |  | 12 | Pin/Crimp (05-0020) | Brown | #24 | TBD | 60-0027
DIO_1 | USB-3101 (06-0019) | DIO1 | #22-26 pin, crimp (05-0053) |  | 13 | Pin/Crimp (05-0020) | Red | #24 | TBD | 60-0033
DIO_2 | USB-3101 (06-0019) | DIO2 | #22-26 pin, crimp (05-0053) |  | 14 | Pin/Crimp (05-0020) | Orange | #24 | TBD | 60-0029
DIO_3 | USB-3101 (06-0019) | DIO3 | #22-26 pin, crimp (05-0053) |  | 15 | Pin/Crimp (05-0020) | Yellow | #24 | TBD | 60-0030
DIO_4 | USB-3101 (06-0019) | DIO4 | #22-26 pin, crimp (05-0053) |  | 16 | Pin/Crimp (05-0020) | Green | #24 | TBD | 60-0028
DIO_5 | USB-3101 (06-0019) | DIO5 | #22-26 pin, crimp (05-0053) |  | 17 | Pin/Crimp (05-0020) | Blue | #24 | TBD | 60-0026
DIO_6 | USB-3101 (06-0019) | DIO6 | #22-26 pin, crimp (05-0053) |  | 18 | Pin/Crimp (05-0020) | Violet | #24 | TBD | 60-0031
DIO_7 | USB-3101 (06-0019) | DIO7 | #22-26 pin, crimp (05-0053) |  | 19 | Pin/Crimp (05-0020) | White | #24 | TBD | 60-0032
Gnd | USB-3101 (06-0019) | DGND | #22-26 pin, crimp (05-0053) |  | 20 | Pin/Crimp (05-0020) | Black | #24 | TBD | 60-0034

Sheet: 60-0053 BOM
 | 60-0053
Item | Description | Genturi P/N | Mfg | Mfg P/N | Digi-key P/N | Quantity | Cost | Extended Cost
 | 20 Position Rectangular Housing Connector Receptacle Black 0.118" (3.00mm) | 05-0020 | Molex | 0430252000 | WM2492-ND (https://www.digikey.com/product-detail/en/molex/0430252000/WM2492-ND/531408) | 1 | $1.09 | $1.09
 | Socket Contact Tin 20-24 AWG Crimp Power | 05-0012 | Molex | 0430300007 | WM1837-ND (https://www.digikey.com/products/en?keywords=wm1837-nd) | 18 | $0.19 | $3.42
 | Wire Pin Terminal Connector 22-26 AWG (0.1~0.4mm²) PIDG Crimp | 05-0053 | TE Connectivity AMP Connectors | 165514-1 | 165514-1-ND (https://www.digikey.com/product-detail/en/165514-1/165514-1-ND/1136542/?itemSeq=311538633) | 18
 | #24 black wire | 60-0034 |  |  |  | TBD
 | #24 brown wire | 60-0027 |  |  |  | TBD
 | #24 red wire | 60-0033 |  |  |  | TBD
 | #24 orange wire | 60-0029 |  |  |  | TBD
 | #24 yellow wire | 60-0030 |  |  |  | TBD
 | #24 green wire | 60-0028 |  |  |  | TBD
 | #24 blue wire | 60-0026 |  |  |  | TBD
 | #24 violet wire | 60-0031 |  |  |  | TBD
 | #24 white wire | 60-0032 |  |  |  | TBD

Sheet: 60-0052 Run List
Jukka, +5V power supply to Alpenglow (30-0005)
60-0052
 | From |  |  | To
Signal Name | Object | Pin | Termination | Object | Pin | Termination | Wire Color | Wire Gauge | Wire Length | Wire P/N
+5V | +5V Power supply (06-0042) | +Vo | #18 pin, crimp (05-0054) | J1 ()05-0008 | 1 | Pin crimp (05-0009) | Red | #22 | TBD | 60-0017
+5V | +5V Power supply (06-0042) | +Vo |  |  | 2 | Pin crimp (05-0009) | Red | #22 | TBD | 60-0017
Gnd | +5V Power supply (06-0042) | -Vo | #18 pin, crimp (05-0054) |  | 3 | Pin crimp (05-0009) | Black | #22 | TBD | 60-0018
Gnd | +5V Power supply (06-0042) | -Vo |  |  | 4 | Pin crimp (05-0009) | Black | #22 | TBD | 60-0018

Sheet: 60-0052 BOM
 | 60-0052
Item | Description | Genturi P/N | Mfg | Mfg P/N | Digi-key P/N | Quantity | Cost | Extended Cost
 | Wire Pin Terminal Connector 18-22 AWG Avikrimp Crimp | 05-0054 | Molex | 192130009 | WM18380-ND (https://www.digikey.com/product-detail/en/0192130009/WM18380-ND/279181/?itemSeq=311494906) | 2
 | 4 Position Rectangular Housing Connector Receptacle White 0.100" (2.54mm) | 05-0008 | Molex | 22013047 | WM2002-ND (https://www.digikey.com/products/en?keywords=wm2002-nd) | 1 | $0.20 | $0.20
 | Non-Gendered Contact Tin 22-30 AWG Crimp | 05-0009 | Molex | 0008500032 | WM2623-ND (https://www.digikey.com/products/en?keywords=08-50-0032) | 4 | $0.09 | $0.36
 | #22 red wire | 60-0017
 | #22 black wire | 60-0018
