Genturi/NewAlphaElectrical/SubSystems/Marco/MarcoCableAssemblies.xlsx

Sheet: 60-0105 Run List
Marco, AC power entry to +5V power supply (06-0028) & ±15V power supply (06-0027)
60-0105
 | From |  |  | To
Signal Name | Object | Pin | Termination | Object | Pin | Termination | Wire Color | Wire Gauge | Wire Length | Wire P/N
Line in | Power Entry (06-0040) | Line | Solder | +5V power supply (06-0028) | 1,3 | Bridge 1 to 3 and solder to bridge | Black | #16 | TBD | 60-0015
Line in | Power Entry (06-0040) |  |  | ±15V power supply (06-0027) | 1,3 | Bridge 1 to 3 and solder to bridge | Black | #16 | TBD | 60-0015
Neutral in | Power Entry (06-0040) | Neutral | Solder | +5V power supply (06-0028) | 2,4 | Bridge 2 to 4 and solder to bridge | White | #16 | TBD | 60-0016
Neutral in | Power Entry (06-0040) |  |  | ±15V power supply (06-0027) | 2,4 | Bridge 2 to 4 and solder to bridge | White | #16 | TBD | 60-0016
Ground | Power Entry (06-0040) | Ground | Solder | #10 ground stud | --- | #10/12 X #10 Ring terminal (05-0037) | Green | #12 | TBD | 60-0080

Sheet: 60-0105 BOM
 | 60-0105
Item | Description | Genturi P/N | Mfg | Mfg P/N | Digi-key P/N | Quantity | Cost | Extended Cost
 | # 16 black wire | 60-0015 |  |  |  | TBD
 | #16 white wire | 60-0016 |  |  |  | TBD
 | #12 green wire | 60-0080 |  |  |  | TBD
 | #10/12 X #10 Ring terminal | 05-0037

Sheet: 60-0051 Run List
Marco, +/- 15V power supply to Femto amplifiers
This cable runs from the +/- 15V power supply to the 4 Femto amplifiers
60-0051
 | From |  |  | To
Signal Name | Object | Pin | Termination | Object | Pin | Termination | Wire Color | Wire Gauge | Wire Length | Wire P/N
+15V | +/- 15V Power supply (06-0027) | +OUT (low) | Solder/Turret | J1 (3-pin Lemo) 05-0010 | 1 | Solder cup | White | #22 | TBD | 60-0020
+15V | +/- 15V Power supply (06-0027) | +OUT (high) | Solder/Turret | J2 (3-pin Lemo) 05-0010 | 1 | Solder cup | White | #22 | TBD | 60-0020
+15V | +/- 15V Power supply (06-0027) | +S (low) | Solder/Turret | J3 (3-pin Lemo) 05-0010 | 1 | Solder cup | White | #22 | TBD | 60-0020
+15V | +/- 15V Power supply (06-0027) | +S (high) | Solder/Turret | J4 (3-pin Lemo) 05-0010 | 1 | Solder cup | White | #22 | TBD | 60-0020
AGND | +/- 15V Power supply (06-0027) | -S RTN | Solder/Turret | J1 (3-pin Lemo) 05-0010 | 3 | Solder cup | Black | #22 | TBD | 60-0018
AGND | +/- 15V Power supply (06-0027) | COM (low) | Solder/Turret | J2 (3-pin Lemo) 05-0010 | 3 | Solder cup | Black | #22 | TBD | 60-0018
AGND | +/- 15V Power supply (06-0027) | COM (high) | Solder/Turret | J3 (3-pin Lemo) 05-0010 | 3 | Solder cup | Black | #22 | TBD | 60-0018
AGND | +/- 15V Power supply (06-0027) | +S RTN | Solder/Turret | J4 (3-pin Lemo) 05-0010 | 3 | Solder cup | Black | #22 | TBD | 60-0018
-15V | +/- 15V Power supply (06-0027) | -OUT (low) | Solder/Turret | J1 (3-pin Lemo) 05-0010 | 2 | Solder cup | Blue | #22 | TBD | 60-0022
-15V | +/- 15V Power supply (06-0027) | -OUT (high) | Solder/Turret | J2 (3-pin Lemo) 05-0010 | 2 | Solder cup | Blue | #22 | TBD | 60-0022
-15V | +/- 15V Power supply (06-0027) | -S (low) | Solder/Turret | J3 (3-pin Lemo) 05-0010 | 2 | Solder cup | Blue | #22 | TBD | 60-0022
-15V | +/- 15V Power supply (06-0027) | -S (high) | Solder/Turret | J4 (3-pin Lemo) 05-0010 | 2 | Solder cup | Blue | #22 | TBD | 60-0022

Sheet: 60-0051 BOM
 | 60-0051
Item | Description | Genturi P/N | Mfg | Mfg P/N | Digi-key P/N | Quantity | Cost | Extended Cost
1 | 3 Position Circular Connector Plug, Female Sockets and Male Pins Solder Cup | 05-0010 | LEMO | FFA.1S.303.CLAC52 | FFA.1S.303.CLAC52-ND (https://www.digikey.com/product-detail/en/lemo/FFA.1S.303.CLAC52/FFA.1S.303.CLAC52-ND/3688991) | 4 | $39.42 | $157.68
2 | #22 white wire | 60-0020 |  |  |  | TBD
3 | #22 black wire | 60-0018 |  |  |  | TBD
4 | #22 Blue wire | 60-0022 |  |  |  | TBD

Sheet: 60-0050 Run List
Marco, USB-3101 DAQ to Arabesque J2 (30-0003)
This cable runs from the DAQ module to Arabesque and carries the PMT control voltages
60-0050
 | From |  |  | To
Signal Name | Object | Pin | Termination | Object | Pin | Termination | Wire Color | Wire Gauge | Wire Length | Wire P/N
PMT Control 1 | USB-3101 (06-0019) | VOUT0 | #18-22 Pin/Crimp (05-0053) | J1 (2X4 micro-fit 3.0 Recpt) 05-0011 | 1 | Pin/Crimp (05-0012) | Brown | #24 | TBD | 60-0027
Analog Gnd | USB-3101 (06-0019) | AGND | #18-22 Pin/Crimp (05-0053) | J1 (2X4 micro-fit 3.0 Recpt) 05-0011 | 2 | Pin/Crimp (05-0012) | Black | #24 | TBD | 60-0034
PMT Control 2 | USB-3101 (06-0019) | VOUT1 | #18-22 Pin/Crimp (05-0053) | J1 (2X4 micro-fit 3.0 Recpt) 05-0011 | 3 | Pin/Crimp (05-0012) | Red | #24 | TBD | 60-0033
Analog Gnd | USB-3101 (06-0019) | AGND | #18-22 Pin/Crimp (05-0053) | J1 (2X4 micro-fit 3.0 Recpt) 05-0011 | 4 | Pin/Crimp (05-0012) | Black | #24 | TBD | 60-0034
PMT Control 3 | USB-3101 (06-0019) | VOUT2 | #18-22 Pin/Crimp (05-0053) | J1 (2X4 micro-fit 3.0 Recpt) 05-0011 | 5 | Pin/Crimp (05-0012) | Orange | #24 | TBD | 60-0029
Analog Gnd | USB-3101 (06-0019) | AGND | #18-22 Pin/Crimp (05-0053) | J1 (2X4 micro-fit 3.0 Recpt) 05-0011 | 6 | Pin/Crimp (05-0012) | Black | #24 | TBD | 60-0034
PMT Control 4 | USB-3101 (06-0019) | VOUT3 | #18-22 Pin/Crimp (05-0053) | J1 (2X4 micro-fit 3.0 Recpt) 05-0011 | 7 | Pin/Crimp (05-0012) | Green | #24 | TBD | 60-0028
Analog Gnd | USB-3101 (06-0019) | AGND | #18-22 Pin/Crimp (05-0053) | J1 (2X4 micro-fit 3.0 Recpt) 05-0011 | 8 | Pin/Crimp (05-0012) | Black | #24 | TBD | 60-0034

Sheet: 60-0050 BOM
 | 60-0050
Item | Description | Genturi P/N | Mfg | Mfg P/N | Digi-key P/N | Quantity | Cost | Extended Cost
 | Wire Pin Terminal Connector 22-26 AWG (0.1~0.4mm²) PIDG Crimp | 05-0053 | TE Connectivity AMP Connectors | 165514-1 | 165514-1-ND (https://www.digikey.com/product-detail/en/165514-1/165514-1-ND/1136542/?itemSeq=311538633) | 8
 | 8 Position Rectangular Housing Connector Receptacle Black 0.118" (3.00mm) | 05-0011 | Molex | 0430250800 | WM1786-ND (https://www.digikey.com/product-detail/en/molex/0430250800/WM1786-ND/252499) | 1 | $0.51 | $0.51
 | Socket Contact Tin 20-24 AWG Crimp Power | 05-0012 | Molex | 0430300007 | WM1837-ND (https://www.digikey.com/products/en?keywords=wm1837-nd) | 8 | $0.19 | $1.52
 | #24 black wire | 60-0034 |  |  |  | TBD
 | #24 brown wire | 60-0027 |  |  |  | TBD
 | #24 red wire | 60-0033 |  |  |  | TBD
 | #24 orange wire | 60-0029 |  |  |  | TBD
 | #24 green wire | 60-0028 |  |  |  | TBD

Sheet: 60-0049 Run List
Marco, +5V power supply to Arabesque (30-0003)
60-0049
 | From |  |  | To
Signal Name | Object | Pin | Termination | Object | Pin | Termination | Wire Color | Wire Gauge | Wire Length | Wire P/N
+5V | +5V Power supply (06-0028) | +OUT | Solder/Turret | J1 (2x2 mini-fit ) 05-0013 | 1 | Pin/Crimp (005-0014) | Red | #22 | TBD | 60-0017
+5V | +5V Power supply (06-0028) | +S | Solder/Turret | J1 (2x2 mini-fit ) 05-0013 | 2 | Pin/Crimp (005-0014) | Red | #22 | TBD | 60-0017
GND | +5V Power supply (06-0028) | -OUT | Solder/Turret | J1 (2x2 mini-fit ) 05-0013 | 3 | Pin/Crimp (005-0014) | Black | #22 | TBD | 60-0018
GND | +5V Power supply (06-0028) | -S | Solder/Turret | J1 (2x2 mini-fit ) 05-0013 | 4 | Pin/Crimp (005-0014) | Black | #22 | TBD | 60-0018

Sheet: 60-0049 BOM
 | 60-0049
Item |  |  | Mfg | Mfg P/N | Digi-key P/N | Quantity | Cost | Extended Cost
 | 4 Position Rectangular Housing Connector Receptacle Natural 0.165" (4.20mm) | 05-0013 | Molex | 0039012040 | WM3701-ND (https://www.digikey.com/products/en?keywords=WM3701-ND) | 1 | 0.31 | 0.31
 | Socket Contact Tin 18-24 AWG Crimp Power | 05-0014 | Molex | 39000039 | WM2501-ND (https://www.digikey.com/products/en?keywords=WM2501-ND) | 4 | 0.18 | 0.72
 | #22 red wire | 60-0017 |  |  |  | TBD
 | #22 black wire | 60-0018 |  |  |  | TBD
