Genturi/NewAlphaElectrical/SubSystems/Tarja/TarjaCableAssemblies.xlsx

Sheet: 60-0048 Run List
Tarja, AC power input to fans and line filter
60-0048
 | From |  |  | To
Signal Name | Object | Pin | Termination | Object | Pin | Termination | Wire Color | Wire Gauge | Wire Length | Wire P/N
Line In | Power entry module (06-0025) | Line | ¼" Fast-on X #14/#16 (05-0064) | Power entry module (06-0025) | 1A | ¼" Fast-on X #14/#16 (05-0064) | Black | #16 | TBD | 60-0015
Neutral In | Power entry module (06-0025) | Neutral | ¼" Fast-on X #14/#16 (05-0064) | Power entry module (06-0025) | 4B | ¼" Fast-on X #14/#16 (05-0064) | White | #16 | TBD | 60-0016
Ground | Power entry module (06-0025) | Ground | ¼" Fast-on X #10/#12 (05-0063) | Ground Stud | --- | #10/12 X #10 Ring terminal (05-0037) | Green | #12 | TBD | 60-0080
Line Out | Power entry module (06-0025) | 2A | ¼" Fast-on X #10/#12 (05-0063) | Fan 1&2 (74-0010) | Either | #18-22 Butt-splice (05-0062) | Black | #22 | TBD | 60-0018
Line Out | Power entry module (06-0025) | 2A |  | Line Filter (06-0026) | Line | #14-16 Terminal pin (05-0059) | Black | #16 | TBD | 60-0015
Neutral Out | Power entry module (06-0025) | 3B | ¼" Fast-on X #10/#12 (05-0063) | Fan 1&2 (74-0010) | Either | #18-22 Butt-splice (05-0062) | White | #22 | TBD | 60-0020
Neutral Out | Power entry module (06-0025) | 3B |  | Line Filter (06-0026) | Line | #14-16 Terminal pin (05-0059) | White | #16 | TBD | 60-0016

Sheet: 60-0048 BOM
60-0048
Item | Description | Genturi P/N | Mfg | Mfg P/N | Digi-key P/N | Quantity | Cost | Extended Cost
0.250" (6.35mm) Quick Connect Female 14-16 AWG Crimp Connector Fully Insulated |  | 05-0064 | TE Connectivity AMP Connectors | 3-350820-2 |  | 4
#16 black wire |  | 60-0015 |  |  |  | TBD
#16 white wire |  | 60-0016 |  |  |  | TBD
#12 Green wire |  | 60-0080 |  |  |  | TBD
0.250" (6.35mm) Quick Connect Female 10-12 AWG Crimp Connector Fully Insulated |  | 05-0063 | TE Connectivity AMP Connectors | 4-520448-2 |  | 3
#22 black wire |  | 60-0018 |  |  |  | TBD
#22 white wire |  | 60-0020 |  |  |  | TBD
Wire Pin Terminal Connector 14-16 AWG Plasti-Grip Crimp |  | 05-0059 | TE Connectivity AMP Connectors | 165171 |  | 2
#10/12 X #10 Ring terminal (05-0037) |  | 05-0037 |  |  |  | 1
#18-22 Butt-splice |  | 05-0062 |  |  |  | 2

Sheet: 60-0047 Run List
Tarja, line filter to +12V power supply and power exit module
60-0047
 | From |  |  | To
Signal Name | Object | Pin | Termination | Object | Pin | Termination | Wire Color | Wire Gauge | Wire Length | Wire P/N
Line | Line filter (06-0026) | Line Out | #10-12 pin, crimp (05-0060) | Power Entry (05-0015) | Line | Solder | Black | #16 | TBD | 60-0015
Line | Line filter (06-0026) |  |  | Power supply (06-0024) {05-0052} | ACL | crimp terminal (05-0065) | Black | #18 | TBD | 3075 BK005
Neutral | Line filter (06-0026) | Neutral Out | #10-12 pin, crimp (05-0060) | Power Entry (05-0015) | Neutral | Solder | White | #16 | TBD | 60-0016
Neutral | Line filter (06-0026) |  |  | Power supply (06-0024) {05-0052} | CAN | crimp terminal (05-0065) | White | #18 | TBD | 3075 WH005
Gnd | Line filter (06-0026) | Gnd Out | #10-12 pin, crimp (05-0060) | Power Entry (05-0015) | Ground | Solder | Green | #12 | TBD | 3080 GR005

Sheet: 60-0047 BOM
 | 60-0047
Item | Description | Genturi P/N | Mfg | Mfg P/N | Digi-key P/N | Quantity | Cost | Extended Cost
 | Wire Pin Terminal Connector 10-12 AWG Plasti-Grip Crimp | 05-0060 | TE Connectivity AMP Connectors | 165085 | A99255-ND (https://www.digikey.com/products/en?keywords=A99255-ND) | 3
 | 3 Position Rectangular Housing Connector Receptacle Natural 0.156" (3.96mm) | 05-0052 | Molex | 9503031 | WM2101-ND (https://www.digikey.com/product-detail/en/0009503031/WM2101-ND/26455/?itemSeq=311556126) | 1
 | Non-Gendered Contact Tin 18-24 AWG Crimp | 05-0065 | Molex | 8500106 | WM2300-ND (https://www.digikey.com/products/en?keywords=08-50-0106) | 2
 | 18 AWG Hook-Up Wire 16/30 White 600V 100.0' (30.5m) | 60-0091 | Alpha Wire | 3075 WH005 | A2103W-100-ND (https://www.digikey.com/products/en?keywords=A2103W-100-ND) | TBD
 | 18 AWG Hook-Up Wire 16/30 Black 600V 100.0' (30.5m) | 60-0092 | Alpha Wire | 3075 BK005 | A2103B-100-ND (https://www.digikey.com/product-detail/en/alpha-wire/3075-BK005/A2103B-100-ND/204492) | TBD
 | #16 black wire | 60-0015 |  |  |  | TBD
 | #16 white wire | 60-0016 |  |  |  | TBD
 | #12 green wire | 60-0080 | Alpha Wire | 3080 GR005 | A3080G-100-ND (https://www.digikey.com/product-detail/en/alpha-wire/3080-GR005/A3080G-100-ND/281628) | TBD

Sheet: 60-0046 Run List
Tarja, +12V power supply to laser control modules
This cable runs from the +12V power supply to the 2 laser control boxes
60-0046
 | From |  |  | To
Signal Name | Object | Pin | Termination | Object | Pin | Termination | Wire Color | Wire Gauge | Wire Length | Wire P/N
+12V | +12V Power supply(06-0024) (Connector 05-0051) | +Vo1 | crimp terminal (05-0065) | Laser controller 1 (78-0029) {05-0016} | + | crimp terminal (05-0012) | Yellow | #22 | TBD | 60-0023
+12V |  | +Vo2 | crimp terminal (05-0065) | Laser controller 2 (78-0029) {05-0016} | + | crimp terminal (05-0012) | Yellow | #22 | TBD | 60-0023
Gnd |  | -Vo1 | crimp terminal (05-0065) | Laser controller 1 (78-0029) {05-0016} | - | crimp terminal (05-0012) | Black | #22 | TBD | 60-0018
Gnd |  | -Vo2 | crimp terminal (05-0065) | Laser controller 2 (78-0029) {05-0016} | - | crimp terminal (05-0012) | Black | #22 | TBD | 60-0018

Sheet: 60-0046 BOM
 | 60-0046
Item | Description | Genturi P/N | Mfg | Mfg P/N | Digi-key P/N | Quantity | Cost | Extended Cost
1 | 4 Position Rectangular Housing Connector Receptacle Natural 0.156" (3.96mm) | 05-0051 | Molex | 9503041 | WM2102-ND (https://www.digikey.com/product-detail/en/0009503041/WM2102-ND/26457/?itemSeq=311556295) | 1 | $0.22 | $0.22
2 | Non-Gendered Contact Tin 18-24 AWG Crimp | 05-0065 | Molex | 8500106 | WM2300-ND (https://www.digikey.com/products/en?keywords=08-50-0106) | 4
3 | 2 Position Rectangular Housing Connector Receptacle Black 0.118" (3.00mm) | 05-0016 | Molex | 0430250200 | WM1783-ND (https://www.digikey.com/products/en?keywords=WM1783-ND) | 2 | $0.32 | $0.64
4 | Socket Contact Tin 20-24 AWG Crimp Power | 05-0012 | Molex | 0430300007 | WM1837-ND (https://www.digikey.com/products/en?keywords=wm1837-nd) | 4 | $0.19 | $0.76
5 | #22 yellow wire | 60-0023 |  |  |  | TBD
6 | #22 black wire | 60-0018 |  |  |  | TBD
