Genturi/NewAlphaElectrical/SubSystems/Troy/TroyCableAssemblies.xlsx

Sheet: 60-0045 Run List
Troy, power entry to line filter
60-0045
 | From |  |  | To
Signal Name | Object | Pin | Termination | Object | Pin | Termination | Wire Color | Wire Gauge | Wire Length | Wire P/N
Line In | Power entry module (06-0025) | Line | ¼" Fast-on X #14/#16 (05-0064) | Power entry module (06-0025) | 1A | ¼" Fast-on X #14/#16 (05-0064) | Black | #16 | TBD | 60-0015
Neutral In | Power entry module (06-0025) | Neutral | ¼" Fast-on X #14/#16 (05-0064) | Power entry module (06-0025) | 4B | ¼" Fast-on X #14/#16 (05-0064) | White | #16 | TBD | 60-0016
Ground | Power entry module (06-0025) | Ground | ¼" Fast-on X #10/#12 (05-0063) | Ground Stud | --- | #10/12 X #10 Ring terminal (05-0037) | Green | #12 | TBD | 60-0080
Line Out | Power entry module (06-0025) | 2A | ¼" Fast-on X #10/#12 (05-0063) | Fan (74-0010) | Either | #18-22 Butt-splice (05-0062) | Black | #22 | TBD | 60-0095
Line Out | Power entry module (06-0025) | 2A |  | Line Filter (06-0026) | Line | ¼" Fast-on X #14/#16 (05-0064) | Black | #16 | TBD | 60-0015
Neutral Out | Power entry module (06-0025) | 3B | ¼" Fast-on X #10/#12 (05-0063) | Fan (74-0010) | Either | #18-22 Butt-splice (05-0062) | White | #22 | TBD | 60-0094
Neutral Out | Power entry module (06-0025) | 3B |  | Line Filter (06-0026) | Line | ¼" Fast-on X #14/#16 (05-0064) | White | #16 | TBD | 60-0016

Sheet: 60-0045 BOM
 | 60-0045
Item |  | Mfg | Mfg P/N | Digi-key P/N | Genturi P/N | Quantity | Cost | Ext Cost
 | 0.250" (6.35mm) Quick Connect Female 14-16 AWG Crimp Connector Fully Insulated | TE Connectivity AMP Connectors | 3-350820-2 | A27824-ND (https://www.digikey.com/products/en?keywords=A27824-ND) | 05-0064 | 6
 | 0.250" (6.35mm) Quick Connect Female 10-12 AWG Crimp Connector Fully Insulated | TE Connectivity AMP Connectors | 4-520448-2 | A27831-ND (https://www.digikey.com/products/en?keywords=A27831-ND) | 05-0063 | 3
 | Ring Terminal Connector 10 Stud Circular 10-12 AWG Crimp | Molex | 190730170 | WM18310-ND (https://www.digikey.com/product-detail/en/molex/0190730170/WM18310-ND/279111) | 05-0037 | 1
 | Terminal Butt Splice, Inline, Individual Openings Connector Crimp 18-22 AWG Red | Molex | 191640013 | WM18425-ND (https://www.digikey.com/product-detail/en/0191640013/WM18425-ND/279226/?itemSeq=311660212) | 05-0062 | 2
 | #16 Black wire |  |  |  | 60-0015 | TBD
 | #16 white wire |  |  |  | 60-0016 | TBD
 | #22 white wire | Alpha Wire | 3071 WH005 | A2101W-100-ND (https://www.digikey.com/product-detail/en/alpha-wire/3071-WH005/A2101W-100-ND/204453) | 60-0094 | TBD
 | #22 black wire | Alpha Wire | 3071 BK005 | A2101B-100-ND (https://www.digikey.com/product-detail/en/alpha-wire/3071-BK005/A2101B-100-ND/204452) | 60-0095 | TBD
 | #16 green wire | Alpha Wire | 3080 GR005 | A3080G-100-ND (https://www.digikey.com/product-detail/en/alpha-wire/3080-GR005/A3080G-100-ND/281628) | 60-0080 | TBD

Sheet: 60-0044 Run List
Troy, line filter to power supply
60-0044
 | From |  |  | To
Signal Name | Object | Pin | Termination | Object | Pin | Termination | Wire Color | Wire Gauge | Wire Length | Wire P/N
Line | Line filter output (06-0031) | Line out | ¼" Fast-on X #14/#16 (05-0064) | 57V PS input (06-0030) | Line in | #14/16x#6 ring terminal (05-0044) | Black | #16 | TBD | 60-0015
Neutral | Line filter output (06-0031) | Neutral out | ¼" Fast-on X #14/#16 (05-0064) | 57V PS input (06-0030) | Neutral in | #14/16x#6 ring terminal (05-0044) | White | #16 | TBD | 60-0016
Ground | Ground stud | Ground stud | #16/14x#10 ring terminal (05-0038) | 57V PS input (06-0030) | Ground in | #14/16x#6 ring terminal (05-0044) | Green | #16 | TBD | 60-0014

Sheet: 60-0044 BOM
 | 60-0044
Item | Description | Comment | Genturi P/N | Mfg | Mfg P/N | Digi-key P/N | Quantity | Cost | Extended Cost
 | 16 AWG Hook-Up Wire 26/30 Green 600V 100.0' (30.5m) | Ground stud to +57V power supply | 60-0014 | Alpha Wire | 3077 GR005 | A2104G-100-ND | TBD
 | 16 AWG Hook-Up Wire 26/30 Black 600V 100.0' (30.5m) | Line from L/F to +57V power supply | 60-0015 | Alpha Wire | 3077 BK005 | A2104B-100-ND | TBD
 | 16 AWG Hook-Up Wire 26/30 White 600V 100.0' (30.5m) | Neutral from L/F to +57V power supply | 60-0016 | Alpha Wire | 3077 WH005 | A2104W-100-ND | TBD
 | 0.250" (6.35mm) Quick Connect Female 14-16 AWG Crimp Connector Fully Insulated |  | 05-0064 | TE Connectivity AMP Connectors | 3-350820-2 | A27824-ND (https://www.digikey.com/products/en?keywords=A27824-ND) | 2
 | Ring Terminal Connector 10 Stud Circular 14-16 AWG Crimp |  | 05-0038 | Molex | 190730087 | WM18304-ND (https://www.digikey.com/product-detail/en/molex/0190730087/WM18304-ND/279105) | 1
 | Ring Terminal Connector 6 Stud Circular 14-16 AWG Crimp |  | 05-0044 | Molex | 190730067 | WM18302-ND (https://www.digikey.com/product-detail/en/molex/0190730067/WM18302-ND/279103) | 3

Sheet: 60-0043 Run List
Troy, Scaretale to BMC-7
60-0043
 | From |  |  | To
Signal Name | Object | Pin | Termination | Object | Pin | Termination | Wire Color | Wire Gauge | Wire Length | Wire P/N
PolygonSynch | Scaretale J1 (30-0007) {05-0019} | 1 | Crimp pin (05-0017) | BMC-7 J5 (06-0032) {05-0019} | 1 | Crimp pin (05-0017) | Brown | #26 | TBD | 60-0100
Gnd | Scaretale J1 (30-0007) {05-0019} | 2 | Crimp pin (05-0017) | BMC-7 J5 (06-0032) {05-0019} | 2 | Crimp pin (05-0017) | Black | #26 | TBD | 60-0095
Mode | Scaretale J1 (30-0007) {05-0019} | 3 | Crimp pin (05-0017) | BMC-7 J5 (06-0032) {05-0019} | 3 | Crimp pin (05-0017) | Red | #26 | TBD | 60-0098
#Enable | Scaretale J1 (30-0007) {05-0019} | 4 | Crimp pin (05-0017) | BMC-7 J5 (06-0032) {05-0019} | 4 | Crimp pin (05-0017) | Orange | #26 | TBD | 60-0101
Line1 | Scaretale J1 (30-0007) {05-0019} | 5 | Crimp pin (05-0017) | BMC-7 J5 (06-0032) {05-0019} | 5 | Crimp pin (05-0017) | Yellow | #26 | TBD | 60-0096
Line2 | Scaretale J1 (30-0007) {05-0019} | 6 | Crimp pin (05-0017) | BMC-7 J5 (06-0032) {05-0019} | 6 | Crimp pin (05-0017) | Green | #26 | TBD | 60-0099
Gnd | Scaretale J1 (30-0007) {05-0019} | 7 | Crimp pin (05-0017) | BMC-7 J5 (06-0032) {05-0019} | 7 | Crimp pin (05-0017) | Black | #26 | TBD | 60-0095
#@Synch | Scaretale J1 (30-0007) {05-0019} | 8 | Crimp pin (05-0017) | BMC-7 J5 (06-0032) {05-0019} | 8 | Crimp pin (05-0017) | Blue | #26 | TBD | 60-0097
5V_BMC7 | Scaretale J4 (30-0007) {05-0018} | 1 | Crimp pin (05-0017) | BMC-7 J3 (06-0032) {05-0018} | 1 | Crimp pin (05-0017) | White | #24 | TBD | 60-0032
Gnd | Scaretale J4 (30-0007) {05-0018} | 2 | Crimp pin (05-0017) | BMC-7 J3 (06-0032) {05-0018} | 2 | Crimp pin (05-0017) | Black | #24 | TBD | 60-0034

Sheet: 60-0043 BOM
 | 60-0043
Item | Description | Genturi P/N | Mfg | Mfg P/N | Digi-key P/N | Quantity | Cost | Extended Cost
 | 10 Position Rectangular Housing Connector Receptacle Black 0.100" (2.54mm) | 05-0019 | TE Connectivity AMP Connectors | 104257-9 | A28425-ND (https://www.digikey.com/products/en?keywords=A28425-ND) | 2 | $1.32 | $2.64
 | 8 Position Rectangular Housing Connector Receptacle Black 0.100" (2.54mm) | 05-0018 | TE Connectivity AMP Connectors | 102241-6 | A26987-ND (https://www.digikey.com/products/en?keywords=A26987-ND) | 2 | $0.81 | $1.62
 | Socket Contact Gold 22-26 AWG Crimp | 05-0017 | TE Connectivity AMP Connectors | 1-104480-6 | A32513-ND (https://www.digikey.com/products/en?keywords=A32513-ND) | 20 | $0.24 | $4.80
 | #24 White wire | 60-0032 |  |  |  | TBD
 | #24 Black wire | 60-0034 |  |  |  | TBD
 | HOOK-UP STRND 26AWG BLACK 100' | 60-0095 | Alpha Wire | 172619 BK005 | A172619B-100-ND | TBD
 | HOOK-UP STRND 26AWG YELLOW 100' | 60-0096 | Alpha Wire | 172619 YL005 | A172619Y-100-ND | TBD
 | HOOK-UP STRND 26AWG BLUE 100' | 60-0097 | Alpha Wire | 172619 BL005 | A172619L-100-ND | TBD
 | HOOK-UP STRND 26AWG RED 100' | 60-0098 | Alpha Wire | 172619 RD005 | A172619R-100-ND | TBD
 | HOOK-UP STRND 26AWG GREEN 100' | 60-0099 | Alpha Wire | 172619 GR005 | A172619G-100-ND | TBD
 | HOOK-UP STRND 26AWG BROWN 100' | 60-0100 | Alpha Wire | 172619 BR005 | A172619N-100-ND | TBD
 | HOOK-UP STRND 26AWG ORANGE 100' | 60-0101 | Alpha Wire | 172619 OR005 | A172619A-100-ND | TBD

Sheet: 60-0110 Run List
Troy, power supply to BMC-7
60-0110
 | From |  |  | To
Signal Name | Object | Pin | Termination | Object | Pin | Termination | Wire Color | Wire Gauge | Wire Length | Wire P/N
+57V | +57V Power supply (06-0030) | +V1 | #18-22x#10 Ring terminal (05-0039) | BMC-7 (06-0032) {05-0014} | 5 | crimp terminal (05-0014) | White | #18 | TBD | 60-0078
+57V | +57V Power supply (06-0030) | +V2 | #18-22x#10 Ring terminal (05-0039) | BMC-7 (06-0032) {05-0014} | 4 | crimp terminal (05-0014) | White | #18 | TBD | 60-0078
Gnd | +57V Power supply (06-0030) | -V1 | #18-22x#10 Ring terminal (05-0039) | BMC-7 (06-0032) {05-0014} | 3 | crimp terminal (05-0014) | Black | #18 | TBD | 60-0079
Gnd | +57V Power supply (06-0030) | -V2 | #14-16x#10 Ring terminal (05-0038) | BMC-7 (06-0032) {05-0014} | 2 | crimp terminal (05-0014) | Black | #18 | TBD | 60-0079
Gnd | +57V Power supply (06-0030) |  |  | BMC-7 (06-0032) {05-0014} | 1 | crimp terminal (05-0014) | Black | #18 | TBD | 60-0079

Sheet: 60-0110 BOM
 | 60-0110
Item | Description | Genturi P/N | Mfg | Mfg P/N | Digi-key P/N | Quantity | Cost | Extended Cost
 | Ring Terminal Connector 10 Stud Circular 18-22 AWG Crimp | 05-0039 | Molex | 190730017 | WM18297-ND (https://www.digikey.com/product-detail/en/molex/0190730017/WM18297-ND/279098) | 3
 | Ring Terminal Connector 10 Stud Circular 14-16 AWG Crimp | 05-0038 | Molex | 190730087 | WM18304-ND (https://www.digikey.com/product-detail/en/molex/0190730087/WM18304-ND/279105) | 1
 | 5 Position Rectangular Housing Connector Receptacle Natural 0.165" (4.20mm) | 05-0046 | Molex | 39014051 | WM23610-ND (https://www.digikey.com/product-detail/en/0039014051/WM23610-ND/930292/?itemSeq=311646884) | 1
 | Contact, connector, female, mini-fit jr. | 05-0014 | Molex |  |  | 5
 | 18 AWG Hook-Up Wire 34/0.0071" Black 300V 100.0' (30.5m) | 60-0079 | CNC Tech | 1569-18-1-0500-001-1-TS | CN548B-100-ND (https://www.digikey.com/product-detail/en/cnc-tech/1569-18-1-0500-001-1-TS/CN548B-100-ND/7065766) | TBD
 | 18 AWG Hook-Up Wire 34/0.0071" White 300V 100.0' (30.5m) | 60-0078 | CNC Tech | 1569-18-1-0500-002-1-TS | CN549W-100-ND (https://www.digikey.com/product-detail/en/cnc-tech/1569-18-1-0500-002-1-TS/CN549W-100-ND/7065767) | TBD
