Genturi/NewAlphaElectrical/TroyInterface(Scaretale 30-0007)/Assembly/Trx_Scaretale(30-0007).xlsx

Index | Quantity | Part Number | Manufacturer Part Number | Description | Customer Reference | Available | Backorder | Unit Price | Extended Price USD
1 | 10 | 732-618015325223-ND | 618015325223 | WR-DSUB FEMALE HIGH DENSITY ANGL | 15 Position D-Sub, High Density Receptacle, Female Sockets Connector (732-618015325223-ND) | 10 | 0 | 3.81 | 38.10
2 | 10 | L717HDE15PD1CH4R-ND | L717HDE15PD1CH4R | CONN DSUB HD PLUG 15POS R/A SLDR | 15 Position D-Sub, High Density Plug, Male Pins Connector (L717HDE15PD1CH4R-ND) | 10 | 0 | 1.642 | 16.42
3 | 10 | A33904-ND | 5-103669-7 | CONN HEADER VERT 8POS 2.54MM | Connector Header Through Hole 8 position 0.100" (2.54mm) (A33904-ND) | 10 | 0 | 1.44 | 14.40
4 | 25 | 732-6425-1-ND | 875105344010 | CAP ALUM POLY 100UF 20% 16V SMD | 100µF 16V Aluminum Polymer Capacitor Radial, Can - SMD 20mOhm 2000 Hrs @ 105°C (732-6425-1-ND) | 25 | 0 | 0.63 | 15.75
5 | 100 | 541-0.0VCT-ND | CRCW12100000Z0EA | RES SMD 0 OHM JUMPER 1/2W 1210 | RES SMD 0 OHM JUMPER 1/2W 1210 (541-0.0VCT-ND) | 100 | 0 | 0.078 | 7.80
6 | 100 | P100HCT-ND | ERJ-3EKF1000V | RES SMD 100 OHM 1% 1/10W 0603 | RES SMD 100 OHM 1% 1/10W 0603 (P100HCT-ND) | 100 | 0 | 0.0264 | 2.64
7 | 100 | 445-7694-1-ND | C3216C0G1H104J160AA | CAP CER 0.1UF 50V C0G 1206 | CAP CER 0.1UF 50V C0G 1206 (445-7694-1-ND) | 100 | 0 | 0.3105 | 31.05
 |  |  |  | PO #:1000886-TXO
