Genturi/NewAlphaElectrical/MotorInterface(Riddler 30-0004)/Assembly/TrxPO_ForRiddler(30-0004).xlsx

Index | Quantity | Part Number | Manufacturer Part Number | Description | Customer Reference | Available | Backorder | Unit Price | Extended Price USD
1 | 10 | A33893-ND | 5-103669-1 | CONN HEADER VERT 2POS 2.54MM | CONN HEADER VERT 2POS 2.54MM (A33893-ND) | 10 | 0 | 0.737 | 7.37
2 | 25 | A33895-ND | 5-103669-2 | CONN HEADER VERT 3POS 2.54MM | CONN HEADER VERT 3POS 2.54MM (A33895-ND) | 25 | 0 | 1.007 | 25.18
3 | 25 | A33897-ND | 5-103669-3 | CONN HEADER VERT 4POS 2.54MM | CONN HEADER VERT 4POS 2.54MM (A33897-ND) | 25 | 0 | 0.802 | 20.05
4 | 10 | A33899-ND | 5-103669-4 | CONN HEADER VERT 5POS 2.54MM | CONN HEADER VERT 5POS 2.54MM (A33899-ND) | 10 | 0 | 1.144 | 11.44
5 | 10 | A35016-ND | 5-103669-5 | CONN HEADER VERT 6POS 2.54MM | CONN HEADER VERT 6POS 2.54MM (A35016-ND) | 10 | 0 | 1.291 | 12.91
6 | 10 | 173-150FEA-ND | 173-E50-213R141 | CONN D-SUB RCPT 50POS R/A SOLDER | CONN D-SUB RCPT 50POS R/A SOLDER (173-150FEA-ND) | 10 | 0 | 19.172 | 191.72
7 | 15 | WM1918-ND | 0436500315 | CONN HEADER VERT 3POS 3MM | CONN HEADER VERT 3POS 3MM (WM1918-ND) | 15 | 0 | 0.908 | 13.62
8 | 15 | WM1790-ND | 0430450412 | CONN HEADER VERT 4POS 3MM | CONN HEADER VERT 4POS 3MM (WM1790-ND) | 15 | 0 | 0.965 | 14.48
9 | 25 | A97593-ND | 5-1814400-1 | CONN SMA JACK R/A 50 OHM PCB | CONN SMA JACK R/A 50 OHM PCB (A97593-ND) | 25 | 0 | 2.2956 | 57.39
10 | 25 | 478-5230-1-ND | TPSB106K016R0500 | CAP TANT 10UF 10% 16V 1411 | CAP TANT 10UF 10% 16V 1411 (478-5230-1-ND) | 25 | 0 | 0.436 | 10.90
11 | 10 | 478-13149-1-ND | TCQD106M035R0070 | CAP CHIP POLY 10UF 35V 2917 | CAP CHIP POLY 10UF 35V 2917 (478-13149-1-ND) | 10 | 0 | 1.421 | 14.21
 |  |  |  | PO #:1000885-TXO
