Genturi/NewAlphaElectrical/SubSystems/Cart_Dec02_0235PM (Mouser).xls

SHOPPING CART
This is not an invoice
02-Dec-19 14:35:43
 | Mouser # | Mfr. # | Manufacturer | Customer # | Description | RoHS | Lifecycle | Order Qty. | Price (USD) | Ext.: (USD)
1 | 693-5500.2048 | 5500.2048 | Schurter |  | Power Line Filters 3-STAGE GP 4A FMW2 | RoHS Compliant |  | 3 | $181.09 | $543.27
2 | 736-FFA1S303CLAC52 | FFA.1S.303.CLAC52 | LEMO |  | Circular Push Pull Connectors STRAIGHT PLUG CABLE COLLET | RoHS Compliant |  | 4 | $41.20 | $164.80
3 | 967-EVS57-10R6 | EVS57-10R6 | TDK-Lambda |  | Switching Power Supplies 604W 57V 10.6A | RoHS Compliant |  | 3 | $304.00 | $912.00
By submitting your order you agree to these terms and conditions. (https://www.mouser.com/saleterms) |  |  |  |  |  |  |  |  | Merchandise Total: | $1620.07
Prices are reflected at the date and time shown. |  |  |  |  |  |  |  |  | Shipping Charge: | $24.46
