Genturi/NewAlphaElectrical/SubSystems/Harness&CableAssyList.xlsx

Sheet: ModToMod_Intercts
Cable description | From | To | COTS or Custom | Quantity | Genturi P/N | Comment | From Connector | To Connector | Genturi Title
Scanner synch | Troy | Marco | Custom | 1 | 60-0109 | The length this cables need to be determined | D-15HD male | D-15HD male | ASSY, HARNESS, POLYGON SCANNER INTERMODULE SYNCH.
Polygon control | Emppu | Troy | Custom | 1 | 60-0108 | The length this cables need to be determined | D-15HD male | D-15HD female | ASSY, HARNESS, POLYGON SCANNER INTERMODULE CONTROL
Motor & Digital I/O | Riddler | Emppu | Custom | 1 | 60-0107 | The length this cables need to be determined | D-50 male | D-37 male, D15 male | ASSY, HARNESS, MOTOR & DIGITAL IO INTERFACE
Heater Drive & Sense | Riddler | Emppu | Custom | 1 | 60-0106 | The length this cables need to be determined | 2x2 micro-fit 3.0 female, 1x3 micro-fit 3.0 female | D-25 male | ASSY, HARNESS, HEATER DRIVE & TEMPERATURE SENSING INTERFACE

Sheet: Periph_Intercts
Object | From | To | PCB connector | Mating connector | Genturi P/N | Digi-Key P/N | Comment
Riddler | J18 | cartridge heater element | 430450412 | 430250400 | 05-0067
Riddler | J15 | cartridge thermistor | 436500300 | 436450300 | 05-0066
Riddler | J10 | Pitch motor | 5-103669-3 | 104257-3 | TBD | A28401-ND
Riddler | J6 | Roll motor | 5-103669-3 | 104257-3 | TBD | A28401-ND
Riddler | J2 | X motor | 5-103669-3 | 104257-3 | TBD | A28401-ND
Riddler | J8 | Yaw motor | 5-103669-3 | 104257-3 | TBD | A28401-ND
Riddler | J4 | Y motor | 5-103669-3 | 104257-3 | TBD | A28401-ND
Riddler | J11 | Pitch home | 5-103669-2 | 104257-2 | TBD | A28397-ND
Riddler | J7 | Roll home | 5-103669-2 | 104257-2 | TBD | A28397-ND
Riddler | J3 | X home | 5-103669-2 | 104257-2 | TBD | A28397-ND
Riddler | J9 | Yaw home | 5-103669-2 | 104257-2 | TBD | A28397-ND
Riddler | J5 | Y home | 5-103669-2 | 104257-2 | TBD | A28397-ND
Riddler | J12 | Air cylinder drive | 5-103669-1 | 104257-1 | TBD | A28393-ND
Riddler | J13 | Cartridge present | 5-103669-4 | 104257-4 | 05-0033 | A28405-ND
Riddler | J14 | Air cylinder limits | 5-103669-5 | 104257-5 | TBD | A28409-ND
Moondance | J7 | Polygon index sensor | 5-103635-4 | 104257-4 | 05-0033 | A28405-ND

Sheet: Emppu (50-0038)
Description | Genturi P/N
Emppu, power entry to fan and line filter | 60-0035
Emppu, line filter output to power supply inputs, temperature controller and Moondance | 60-0036
Emppu, +15V power supply to motor controller | 60-0037
Emppu, +24V power supply to temperature controller, solid-state relay and D25 connector | 60-0038
Emppu, motor controller to D-37 connector | 60-0039

Sheet: Marco (50-0040)
Marco (50-0040)
Description | Genturi P/N
Marco, AC power entry to +5V power supply & ±15V power supply | 60-0105
Marco, ±15V power supply to Femto amplifiers | 60-0051
Marco, USB-3101 DAQ to Arabesque J2 | 60-0050
Marco, +5V power supply to Arabesque | 60-0049

Sheet: Troy (50-0041)
Troy (50-0041)
Description | Genturi P/N
Troy, power entry to line filter | 60-0045
Troy, line filter to power supply | 60-0044
Troy, Scaretale to BMC-7 | 60-0043
Troy, power supply to BMC-7 | 60-0110

Sheet: Tarja (50-0036)
Tarja (50-0036)
Description | Genturi P/N
Tarja, AC power input to fans and line filter | 60-0048
Tarja, line filter to +12V power supply and power exit module | 60-0047
Tarja, +12V power supply to laser control modules | 60-0046

Sheet: Jukka (50-0035)
Jukka (50-0035)
Description | Genturi P/N
Jukka, AC input to +5V power supply | 60-0104
Jukka, DAQ to Alpenglow | 60-0053
Jukka, +5V power supply to Alpenglow | 60-0052
