Genturi/NewAlphaElectrical/SubSystems/ModuleToModuleInterconnects.xlsx

Sheet: Assembly List
Cable description | From | To | COTS or Custom | Quantity | Genturi P/N | Comment | From Connector | To Connector | Genturi Title
Scanner synch | Troy | Marco | Custom | 1 | 60-0109 | The length this cables need to be determined | D-15HD male | D-15HD male | ASSY, HARNESS, POLYGON SCANNER INTERMODULE SYNCH.
Polygon control | Emppu | Troy | Custom | 1 | 60-0108 | The length this cables need to be determined | D-15HD male | D-15HD female | ASSY, HARNESS, POLYGON SCANNER INTERMODULE CONTROL
Motor & Digital I/O | Riddler | Emppu | Custom | 1 | 60-0107 | The length this cables need to be determined | D-50 male | D-37 male, D15 male | ASSY, HARNESS, MOTOR & DIGITAL IO INTERFACE
Heater Drive & Sense | Riddler | Emppu | Custom | 1 | 60-0106 | The length this cables need to be determined | 2x2 micro-fit 3.0 female, 1x3 micro-fit 3.0 female | D-25 male | ASSY, HARNESS, HEATER DRIVE & TEMPERATURE SENSING INTERFACE

Sheet: 60-0109 Run List
60-0109
 | From |  |  | To
Signal Name | Object | Pin | Termination | Object | Pin | Termination | Wire Color | Wire Gauge | Wire Length | Wire P/N
+5V | D-15HD male (05-0031) | 11 | Solder | D-15HD male (05-0031) | 11 | Solder | Red | 28 | TBD | 60-0114
Reference clock | D-15HD male (05-0031) | 13 | Solder | D-15HD male (05-0031) | 13 | Solder | White | 28
Gnd | D-15HD male (05-0031) | 15 | Solder | D-15HD male (05-0031) | 15 | Solder | Black | 28
Gnd | D-15HD male (05-0031) | 5 | Solder | D-15HD male (05-0031) | 5 | Solder | Drain/shield | 28

Sheet: 60-0109 BOM
Item | Description | Genturi P/N | Mfg | Mfg P/N | Digi-key P/N | Quantity | Cost | Extended Cost
1 | CONNECTOR, D-SUB-HD, 15PIN, MALE, PANEL MNT | 05-0031 |  |  |  | 2
2 | CONNECTOR SHELL, D-SUB-HD, 15-PIN | 05-0032 |  |  |  | 2
3 | CABLE, SHIELDED, 3 COND, #28 AWG | 60-0114 | Alpha Wire | M2403 SL005 | M2403SL005-ND (https://www.digikey.com/product-detail/en/alpha-wire/M2403-SL005/M2403SL005-ND/3839684) | TBD

Sheet: 60-0108 Run List
60-0108
 | From |  |  | To
Signal Name | Object | Pin | Termination | Object | Pin | Termination | Wire Color | Wire Gauge | Wire Length | Wire P/N
+5V | D-15HD Male (05-0031) | 6 | Solder | D-15HD Female (05-0030) | 6 | Solder | Red | #28 | TBD | 60-0113
Gnd | D-15HD Male (05-0031) | 11 | Solder | D-15HD Female (05-0030) | 11 | Solder | Black | #28
Mode | D-15HD Male (05-0031) | 2 | Solder | D-15HD Female (05-0030) | 2 | Solder | White | #28
Line1 | D-15HD Male (05-0031) | 8 | Solder | D-15HD Female (05-0030) | 8 | Solder | Green | #28
Line2 | D-15HD Male (05-0031) | 4 | Solder | D-15HD Female (05-0030) | 4 | Solder | Orange | #28
#Enable | D-15HD Male (05-0031) | 10 | Solder | D-15HD Female (05-0030) | 10 | Solder | Blue | #28
#AtSynch | D-15HD Male (05-0031) | 14 | Solder | D-15HD Female (05-0030) | 14 | Solder | Brown | #28
Gnd | D-15HD Male (05-0031) | 15 | Solder | D-15HD Female (05-0030) | 15 | Solder | Drain/shield | #26

Sheet: 60-0108 BOM
Item | Description | Genturi P/N | Mfg | Mfg P/N | Digi-key P/N | Quantity | Cost | Extended Cost
1 | CONNECTOR, D-SUB-HD, 15PIN, MALE, PANEL MNT | 05-0031 |  |  |  | 1
2 | CONNECTOR, D-SUB-HD, 15PIN, FEMALE, PANEL MNT | 05-0030 |  |  |  | 1
3 | CONNECTOR SHELL, D-SUB-HD, 15-PIN | 05-0032 |  |  |  | 2
4 | CABLE, SHIELDED, 7 COND, #28 AWG | 60-0113 |  |  |  | TBD

Sheet: 60-0107 Run List
60-0107
 | From |  |  | To
Signal Name | Object | Pin | Termination | Object | Pin | Termination | Wire Color | Wire Gauge | Wire Length | Wire P/N
X_MTR_B1 | D-50 Male (05-0022) | 44 | Solder | D-37 Male (05-0028) | 11 | Solder | Black | #20 | TBD | 60-0116
X_MTR_B2 |  | 27 |  |  | 29 |  | White/Black | #20
X_MTR_A1 |  | 28 |  |  | 10 |  | Brown | #20
X_MTR_A2 |  | 11 |  |  | 28 |  | White/Brown | #20
PITCH_MTR_B1 |  | 12 |  |  | 17 |  | Red | #20
PITCH_MTR_B2 |  | 45 |  |  | 35 |  | White/Red | #20
PITCH_MTR_A1 |  | 29 |  |  | 16 |  | Orange | #20
PITCH_MTR_A2 |  | 46 |  |  | 34 |  | White/Orange | #20
Y_MTR_B1 |  | 30 |  |  | 13 |  | Yellow | #20
Y_MTR_B2 |  | 13 |  |  | 31 |  | White/Yellow | #20
Y_MTR_A1 |  | 14 |  |  | 12 |  | Green | #20
Y_MTR_A2 |  | 47 |  |  | 30 |  | White/Green | #20
ROLL_MTR_B1 |  | 48 |  |  | 15 |  | Blue | #20
ROLL_MTR_B2 |  | 31 |  |  | 33 |  | White/Blue | #20
ROLL_MTR_A1 |  | 32 |  |  | 14 |  | Violet | #20
ROLL_MTR_A2 |  | 15 |  |  | 32 |  | White/Violet | #20
YAW_MTR_B1 |  | 16 |  |  | 19 |  | Slate | #20
YAW_MTR_B2 |  | 49 |  |  | 37 |  | White/Slate | #20
YAW_MTR_A1 |  | 17 |  |  | 18 |  | White | #20
YAW_MTR_A2 |  | 33 |  |  | 36 |  | White/Black/Brown | #20
Gnd/shield |  | 43 |  |  | 22 |  | Drain/shield | #22
X_HOME |  | 21 | Solder |  | 1 | Solder | Black | #28 | TBD | 60-0117
Y_HOME |  | 5 |  |  | 20 |  | Red | #28
ROLL_HOME |  | 22 |  |  | 2 |  | White | #28
PITCH_HOME |  | 38 |  |  | 21 |  | Green | #28
YAW_HOME |  | 39 |  |  | 3 |  | Orange | #28
Gnd/shield |  | 40 |  |  | 4 |  | Drain/shield | #28
+24V_PWR |  | 1 | Solder | D-15 Male (05-0024) | 1 | Solder | Black | #28 | TBD | 60-0117
+5V |  | 36 |  |  | 13 |  | Red | #28
CartPresent |  | 9 |  |  | 7 |  | White | #28
CylinLimit1 |  | 42 |  |  | 6 |  | Green | #28
CylinLimit2 |  | 25 |  |  | 5 |  | Orange | #28
Gnd/shield |  | 8 |  |  | 8 |  | Drain/shield | #26
+24V_PWR | Valve (74-0009) | + | Solder |  | 9 | Solder | Red | #24 | TBD | 60-0112
AirCylDrive |  | - |  |  | 11 | Solder | Black | #24

Sheet: 60-0107 BOM
Item | Description | Genturi P/N | Mfg | Mfg P/N | Digi-key P/N | Quantity | Cost | Extended Cost
1 | CONNECTOR, D-SUB, 50-PIN, MALE, PANEL MNT | 05-0022 |  |  |  | 1
2 | CONNECTOR SHELL, D-SUB, 50-PIN | 05-0021 |  |  |  | 1
3 | CONNECTOR, D-SUB, 37-PIN, MALE, PANEL MNT | 05-0028 |  |  |  | 1
4 | CONNECTOR SHELL, D-SUB, 37-PIN | 05-0027 |  |  |  | 1
5 | CONNECTOR, D-SUB, 15-PIN, MALE, PANEL MNT | 05-0024 |  |  |  | 1
6 | CONNECTOR SHELL, D-SUB, 15-PIN | 05-0023 |  |  |  | 1
7 | CABLE, SHIELDED, 20 COND, #22 AWG | 60-0116 |  |  |  | TBD
8 | CABLE, SHIELDED, 5 COND, #28 AWG | 60-0117 |  |  |  | TBD
9 | CABLE, SHIELDED, 2 COND, #24 AWG | 60-0112 |  |  |  | TBD

Sheet: 60-0106 Run List
60-0106
 | From |  |  | To
Signal Name | Object | Pin | Termination | Object | Pin | Termination | Wire Color | Wire Gauge | Wire Length | Wire P/N
HTR_Gnd | D-25 Male (05-0026) | 1 | Solder | 05-0067 | 1 | Crimp pin (05-0012) | Black | #22 | TBD | 60-0114
HTR_Gnd |  | 14 | Solder |  | 2 |  | Brown | #22
HeaterDrive |  | 3 | Solder |  | 3 |  | Red | #22
HeaterDrive |  | 16 | Solder |  | 4 |  | Orange | #22
Shield |  | Shield | shell |  | NC |  | Shield | #22
Thermistor1 |  | 13 | Solder | 05-0066 | 1 | Crimp pin (05-0012) | Red | #24 | TBD | 60-0112
Thermistor2 |  | 25 | Solder |  | 2 |  | Black | #24
Shield |  | Shield | shell |  | 3 |  | shield | #24

Sheet: 60-0106 BOM
Item | Description | Genturi P/N | Mfg | Mfg P/N | Digi-key P/N | Quantity | Cost | Extended Cost
1 | CONNECTOR, SHELL, D-SUB, D-25-PIN | 05-0025 |  |  |  | 1
2 | CONNECTOR, D-SUB, 25-PIN, MALE, PANEL MNT | 05-0026 |  |  |  | 1
3 | CONNECTOR, HOUSING, 4-PIN, WIRE-TO-BOARD, 3MM, DUAL-ROW | 05-0067 | Molex | 430250400 | WM1784-ND (https://www.digikey.com/products/en?keywords=430250400) | 1
4 | CONNECTOR, HOUSING, 3-PIN, WIRE-TO-BOARD, 3MM, SINGLE-ROW | 05-0066 | Molex | 436450300 | WM1846-ND (https://www.digikey.com/product-detail/en/molex/0436450300/WM1846-ND/268975) | 1
5 | CONTACT, CONNECTOR, FEMALE, MICRO-FIT 3.0 | 05-0012 |  |  |  | 7
6 | CABLE, SHIELDED, 4 COND, #22 AWG | 60-0111 | Alpha Wire | M4635 SL005 | M4635SL005-ND (https://www.digikey.com/product-detail/en/alpha-wire/M4635-SL005/M4635SL005-ND/3841982) | TBD
7 | CABLE, SHIELDED, 2 COND, #24 AWG | 60-0112 | Belden Inc. | 9501 060100 | BEL1387-100-ND (https://www.digikey.com/products/en?keywords=BEL1387-100-ND) | TBD

Sheet: MotorHooch
 |  |  |  | From |  |  | To
Other | Norberg connector | Pin Number | Signal Name | Object | Pin | Termination | Object | Pin | Termination | Wire Color | Wire Gauge | Wire Length | Wire P/N
 | X | 2 | X_MTR_B1 | D-50 Male (05-0022) | 44 | Solder | D-37 Male (05-0028) | 11 | Solder | Black | #20 | TBD | 60-0116
 | X | 1 | X_MTR_B2 |  | 27 |  |  | 29 |  | White/Black | #20
 | X | 4 | X_MTR_A1 |  | 28 |  |  | 10 |  | Brown | #20
 | X | 3 | X_MTR_A2 |  | 11 |  |  | 28 |  | White/Brown | #20
 | A | 2 | PITCH_MTR_B1 |  | 12 |  |  | 17 |  | Red | #20
 | A | 1 | PITCH_MTR_B2 |  | 45 |  |  | 35 |  | White/Red | #20
 | A | 4 | PITCH_MTR_A1 |  | 29 |  |  | 16 |  | Orange | #20
 | A | 3 | PITCH_MTR_A2 |  | 46 |  |  | 34 |  | White/Orange | #20
 | Y | 2 | Y_MTR_B1 |  | 30 |  |  | 13 |  | Yellow | #20
 | Y | 1 | Y_MTR_B2 |  | 13 |  |  | 31 |  | White/Yellow | #20
 | Y | 4 | Y_MTR_A1 |  | 14 |  |  | 12 |  | Green | #20
 | Y | 3 | Y_MTR_A2 |  | 47 |  |  | 30 |  | White/Green | #20
 | B | 2 | ROLL_MTR_B1 |  | 48 |  |  | 15 |  | Blue | #20
 | B | 1 | ROLL_MTR_B2 |  | 31 |  |  | 33 |  | White/Blue | #20
 | B | 4 | ROLL_MTR_A1 |  | 32 |  |  | 14 |  | Violet | #20
 | B | 3 | ROLL_MTR_A2 |  | 15 |  |  | 32 |  | White/Violet | #20
 | W | 2 | YAW_MTR_B1 |  | 16 |  |  | 19 |  | Slate | #20
 | W | 1 | YAW_MTR_B2 |  | 49 |  |  | 37 |  | White/Slate | #20
 | W | 4 | YAW_MTR_A1 |  | 17 |  |  | 18 |  | White | #20
 | W | 3 | YAW_MTR_A2 |  | 33 |  |  | 36 |  | White/Black/Brown | #20
 | WX | 9 | Gnd/shield |  | 43 |  |  | 22 |  | Drain/shield | #22
 | WX | 2 | X_HOME |  | 21 | Solder |  | 1 | Solder | Black | #28 | TBD | 60-0117
 | YZ | 8 | Y_HOME |  | 5 |  |  | 20 |  | Red | #28
 | AB | 2 | ROLL_HOME |  | 22 |  |  | 2 |  | White | #28
 | AB | 8 | PITCH_HOME |  | 38 |  |  | 21 |  | Green | #28
 | WX | 8 | YAW_HOME |  | 39 |  |  | 3 |  | Orange | #28
 | YZ | 9 | Gnd/shield |  | 40 |  |  | 4 |  | Drain/shield | #28
+24V |  |  | +24V_PWR |  | 1 | Solder | D-15 Male (05-0024) | 1 | Solder | Black | #28 | TBD | 60-0117
+5V |  |  | +5V |  | 36 |  |  | 13 |  | Red | #28
 |  |  | CartPresent |  | 9 |  |  | 7 |  | White | #28
 |  |  | CylinLimit1 |  | 42 |  |  | 6 |  | Green | #28
 |  |  | CylinLimit2 |  | 25 |  |  | 5 |  | Orange | #28
 |  | 9 | Gnd/shield |  | 8 |  |  | 8 |  | Drain/shield | #26
 |  |  | +24V_PWR | Valve (74-0009) | + | Solder |  | 9 | Solder | Red | #24 | TBD | 60-0112
 |  |  | AirCylDrive |  | - |  |  | 11 | Solder | Black | #24
