Genturi/NewAlphaElectrical/SubSystems/Peripherial_Interconnects.xlsx

Sheet: ListOfAssy
 |  |  | Peripherial Interconnects
 | Object | From | To | PCB connector | Mating connector | Genturi P/N | Digi-Key P/N | Comment
X | Riddler | J18 | cartridge heater element | 430450412 | 430250400 | 05-0067
X | Riddler | J15 | cartridge thermistor | 436500300 | 436450300 | 05-0066
X | Riddler | J10 | Pitch motor | 5-103669-3 | 104257-3 | TBD | A28401-ND
X | Riddler | J6 | Roll motor | 5-103669-3 | 104257-3 | TBD | A28401-ND
X | Riddler | J2 | X motor | 5-103669-3 | 104257-3 | TBD | A28401-ND
X | Riddler | J8 | Yaw motor | 5-103669-3 | 104257-3 | TBD | A28401-ND
X | Riddler | J4 | Y motor | 5-103669-3 | 104257-3 | TBD | A28401-ND
X | Riddler | J11 | Pitch home | 5-103669-2 | 104257-2 | TBD | A28397-ND
X | Riddler | J7 | Roll home | 5-103669-2 | 104257-2 | TBD | A28397-ND
X | Riddler | J3 | X home | 5-103669-2 | 104257-2 | TBD | A28397-ND
X | Riddler | J9 | Yaw home | 5-103669-2 | 104257-2 | TBD | A28397-ND
X | Riddler | J5 | Y home | 5-103669-2 | 104257-2 | TBD | A28397-ND
X | Riddler | J12 | Air cylinder drive | 5-103669-1 | 104257-1 | TBD | A28393-ND
X | Riddler | J13 | Cartridge present | 5-103669-4 | 104257-4 | 05-0033 | A28405-ND
 | Riddler | J14 | Air cylinder limits | 5-103669-5 | 104257-5 | TBD | A28409-ND
 | Moondance | J7 | Polygon index sensor | 5-103635-4 | 104257-4 | 05-0033 | A28405-ND

Sheet: Ptch Mtr Run List
 |  |  |  | Pitch Motor Run List
 | From |  |  | To
Signal Name | Object | Pin | Termination | Object | Wire Color | Wire Gauge | Wire Length | Wire P/N
PITCH_MTR_A1 | 4-pin MTE (05-0073) | 4 | 05-0017 | Pitch Motor Assy () | Red | #22 | TBD | 60-0017
PITCH_MTR_A2 |  | 3 | 05-0017 |  | White/Red stripe | #22 | TBD | 60-119
PITCH_MTR_B1 |  | 2 | 05-0017 |  | Green | #22 | TBD | 60-0021
PITCH_MTR_B2 |  | 1 | 05-0017 |  | White/Green stripe | #22 | TBD | 60-0120

Sheet: Pitch Mtr BOM
 | Pitch Motor BOM
Item | Description | Genturi P/N | Qty | Manufacturer | Mfg P/N
1 | Motor Assembly | ?????
2 | CONNECTOR, HOUSING, 4-PIN, WIRE-TO-BOARD, 0.1", SINGLE ROW | 05-0073 | 1 | TE Connectivity AMP Connectors | 104257-3
3 | CONTACT, CONNECTOR, AMPMODU, 22-26GA | 05-0017 | 4
4 | #22 Ga wire green | 60-0021 | TBD
5 | #22 Ga wire red | 60-0017 | TBD
6 | #22 Ga wire white with green stripe | 60-0120 | TBD | Alpha Wire | 1855/19 WG005
7 | #22 Ga wire white with red stripe | 60-0119 | TBD | Alpha Wire | 1855/19 WR005

Sheet: Roll Mtr Run List
 |  |  |  | Roll Motor Run List
 | From |  |  | To
Signal Name | Object | Pin | Termination | Object | Wire Color | Wire Gauge | Wire Length | Wire P/N
ROLL_MTR_A1 | 4-pin MTE (05-0073) | 4 | 05-0017 | Pitch Motor Assy () | Red | #22 | TBD | 60-0017
ROLL_MTR_A2 |  | 3 | 05-0017 |  | White/Red stripe | #22 | TBD | 60-119
ROLL_MTR_B1 |  | 2 | 05-0017 |  | Green | #22 | TBD | 60-0021
ROLL_MTR_B2 |  | 1 | 05-0017 |  | White/Green stripe | #22 | TBD | 60-0120

Sheet: Roll Motor BOM
 | Roll Motor Run List
Item | Description | Genturi P/N | Qty | Manufacturer | Mfg P/N
1 | Motor Assembly | ?????
2 | CONNECTOR, HOUSING, 4-PIN, WIRE-TO-BOARD, 0.1", SINGLE ROW | 05-0073 | 1 | TE Connectivity AMP Connectors | 104257-3
3 | CONTACT, CONNECTOR, AMPMODU, 22-26GA | 05-0017 | 4
4 | #22 Ga wire green | 60-0021 | TBD
5 | #22 Ga wire red | 60-0017 | TBD
6 | #22 Ga wire white with green stripe | 60-0120 | TBD | Alpha Wire | 1855/19 WG005
7 | #22 Ga wire white with red stripe | 60-0119 | TBD | Alpha Wire | 1855/19 WR005

Sheet: X Mtr Run List
 |  |  |  | X Motor Run List
 | From |  |  | To
Signal Name | Object | Pin | Termination | Object | Wire Color | Wire Gauge | Wire Length | Wire P/N
X_MTR_A1 | 4-pin MTE (05-0073) | 4 | 05-0017 | Pitch Motor Assy () | White/Red | #22 | TBD | 60-0119
X_MTR_A2 |  | 3 | 05-0017 |  | Red | #22 | TBD | 60-0017
X_MTR_B1 |  | 2 | 05-0017 |  | White/Green | #22 | TBD | 60-0120
X_MTR_B2 |  | 1 | 05-0017 |  | Green | #22 | TBD | 60-0021

Sheet: X Motor BOM
 | X Motor BOM
Item | Description | Genturi P/N | Qty | Manufacturer | Mfg P/N
1 | Motor Assembly | ?????
2 | CONNECTOR, HOUSING, 4-PIN, WIRE-TO-BOARD, 0.1", SINGLE ROW | 05-0073 | 1 | TE Connectivity AMP Connectors | 104257-3
3 | CONTACT, CONNECTOR, AMPMODU, 22-26GA | 05-0017 | 4
4 | #22 Ga wire green | 60-0021 | TBD
5 | #22 Ga wire red | 60-0017 | TBD
6 | #22 Ga wire white with green stripe | 60-0120 | TBD | Alpha Wire | 1855/19 WG005
7 | #22 Ga wire white with red stripe | 60-0119 | TBD | Alpha Wire | 1855/19 WR005

Sheet: Y Mtr Run List
 |  |  |  | Y Motor Run List
 | From |  |  | To
Signal Name | Object | Pin | Termination | Object | Wire Color | Wire Gauge | Wire Length | Wire P/N
Y_MTR_A1 | 4-pin MTE (05-0073) | 4 | 05-0017 | Pitch Motor Assy () | Green | #22 | TBD | 60-0021
Y_MTR_A2 |  | 3 | 05-0017 |  | White/Green | #22 | TBD | 60-0120
Y_MTR_B1 |  | 2 | 05-0017 |  | White/Red | #22 | TBD | 60-0119
Y_MTR_B2 |  | 1 | 05-0017 |  | Red | #22 | TBD | 60-0017

Sheet: Y Motor BOM
 | Y Motor BOM
Item | Description | Genturi P/N | Qty | Manufacturer | Mfg P/N
1 | Motor Assembly | ?????
2 | CONNECTOR, HOUSING, 4-PIN, WIRE-TO-BOARD, 0.1", SINGLE ROW | 05-0073 | 1 | TE Connectivity AMP Connectors | 104257-3
3 | CONTACT, CONNECTOR, AMPMODU, 22-26GA | 05-0017 | 4
4 | #22 Ga wire green | 60-0021 | TBD
5 | #22 Ga wire red | 60-0017 | TBD
6 | #22 Ga wire white with green stripe | 60-0120 | TBD | Alpha Wire | 1855/19 WG005
7 | #22 Ga wire white with red stripe | 60-0119 | TBD | Alpha Wire | 1855/19 WR005

Sheet: Yaw Mtr Run List
 |  |  |  | Yaw Motor Run List
 | From |  |  | To
Signal Name | Object | Pin | Termination | Object | Wire Color | Wire Gauge | Wire Length | Wire P/N
Y_MTR_A1 | 4-pin MTE (05-0073) | 4 | 05-0017 | Pitch Motor Assy () | Red | #22 | TBD | 60-0017
Y_MTR_A2 |  | 3 | 05-0017 |  | White/Red stripe | #22 | TBD | 60-119
Y_MTR_B1 |  | 2 | 05-0017 |  | Green | #22 | TBD | 60-0021
Y_MTR_B2 |  | 1 | 05-0017 |  | White/Green stripe | #22 | TBD | 60-0120
+5v | 3-pin MTE (05-0072) | 1 | 1-104481-3 |  | Red | #28 | TBD | 60-0086
YAW_HOME |  | 2 | 1-104481-3 |  | Yellow | #28 | TBD | 60-0084
Gnd |  | 3 | 1-104481-3 |  | Black | #28 | TBD | 60-0082

Sheet: Yaw Motor BOM
 | Yaw Motor BOM
Item | Description | Genturi P/N | Qty | Manufacturer | Mfg P/N
1 | Motor Assembly | ?????
2 | CONNECTOR, HOUSING, 4-PIN, WIRE-TO-BOARD, 0.1", SINGLE ROW | 05-0073 | 1 | TE Connectivity AMP Connectors | 104257-3
3 | CONTACT, CONNECTOR, AMPMODU, 22-26GA | 05-0017 | 4
4 | #22 Ga wire green | 60-0021 | TBD
5 | #22 Ga wire red | 60-0017 | TBD
6 | #22 Ga wire white with green stripe | 60-0120 | TBD | Alpha Wire | 1855/19 WG005
7 | #22 Ga wire white with red stripe | 60-0119 | TBD | Alpha Wire | 1855/19 WR005
8 | 3 Position Rectangular Housing Connector Receptacle Black 0.100" (2.54mm) | 05-0072 | 1 | TE Connectivity AMP Connectors | 104257-2
9 | Socket Contact Gold 28-32 AWG Crimp | 05-0074 | 3 | TE Connectivity AMP Connectors | 1-104481-3
10 | #28 Ga wire red | 60-0086 | TBD
11 | #28 Ga wire black | 60-0082 | TBD
12 | #28 Ga wire yellow | 60-0084 | TBD

Sheet: Ptch Mtr Home Run Lst
 |  |  |  | Pitch Motor Home Sensor Run List
 | From |  |  | To
Signal Name | Object | Pin | Termination | Object | Wire Color | Wire Gauge | Wire Length
PITCH_HOME | 3 Pin MTE (05-0072) | 2 | 05-0074 | Ball plunger switch | Blue | #30 | TBD
Gnd |  | 5 | 05-0074 |  | Brown | #30 | TBD

Sheet: Ptch Mtr Home BOM
 | Pitch Motor Home Sensor BOM
Item | Description | Genturi P/N | Qty | Manufacturer | Mfg P/N
1 | SWITCH, BALL PLUNGER | 05-0001 | 1
2 | 3 Position Rectangular Housing Connector Receptacle Black 0.100" (2.54mm) | 05-0072 | 1 | TE Connectivity AMP Connectors | 104257-2
3 | Socket Contact Gold 28-32 AWG Crimp | 05-0074 | 2 | TE Connectivity AMP Connectors | 1-104481-3
4 | #28 Ga wire brown | 60-0090 | TBD
5 | #28 Ga wire blue | 60-0085 | TBD

Sheet: Roll Mtr Home Run Lst
 |  |  |  | Roll Motor Home Sensor Run List
 | From |  |  | To
Signal Name | Object | Pin | Termination | Object | Wire Color | Wire Gauge | Wire Length
ROLL_HOME | 3 Pin MTE (05-0072) | 2 | 05-0074 | Ball plunger switch | Blue | #30 | TBD
Gnd |  | 5 | 05-0074 |  | Brown | #30 | TBD

Sheet: Roll Mtr Home BOM
 | Roll Motor Home Sensor BOM
Item | Description | Genturi P/N | Qty | Manufacturer | Mfg P/N
1 | SWITCH, BALL PLUNGER | 05-0001 | 1
2 | 3 Position Rectangular Housing Connector Receptacle Black 0.100" (2.54mm) | 05-0072 | 1 | TE Connectivity AMP Connectors | 104257-2
3 | Socket Contact Gold 28-32 AWG Crimp | 05-0074 | 2 | TE Connectivity AMP Connectors | 1-104481-3
4 | #28 Ga wire brown | 60-0090 | TBD
5 | #28 Ga wire blue | 60-0085 | TBD

Sheet: X Mtr Home Run Lst
 |  |  |  | X Motor Home Sensor Run List
 | From |  |  | To
Signal Name | Object | Pin | Termination | Object | Wire Color | Wire Gauge | Wire Length
X_HOME | 3 Pin MTE (05-0072) | 2 | 05-0074 | Ball plunger switch | Blue | #30 | TBD
Gnd |  | 5 | 05-0074 |  | Brown | #30 | TBD

Sheet: X Mtr Home BOM
 | X Motor Home Sensor BOM
Item | Description | Genturi P/N | Qty | Manufacturer | Mfg P/N
1 | SWITCH, BALL PLUNGER | 05-0001 | 1
2 | 3 Position Rectangular Housing Connector Receptacle Black 0.100" (2.54mm) | 05-0072 | 1 | TE Connectivity AMP Connectors | 104257-2
3 | Socket Contact Gold 28-32 AWG Crimp | 05-0074 | 2 | TE Connectivity AMP Connectors | 1-104481-3
4 | #28 Ga wire brown | 60-0090 | TBD
5 | #28 Ga wire blue | 60-0085 | TBD

Sheet: Y Mtr Home Run Lst
 |  |  |  | Y Motor Home Sensor Run List
 | From |  |  | To
Signal Name | Object | Pin | Termination | Object | Wire Color | Wire Gauge | Wire Length
Y_HOME | 3 Pin MTE (05-0072) | 2 | 05-0074 | Ball plunger switch | Blue | #30 | TBD
Gnd |  | 5 | 05-0074 |  | Brown | #30 | TBD

Sheet: Y Mtr Home BOM
 | Y Motor Home Sensor BOM
Item | Description | Genturi P/N | Qty | Manufacturer | Mfg P/N
1 | SWITCH, BALL PLUNGER | 05-0001 | 1
2 | 3 Position Rectangular Housing Connector Receptacle Black 0.100" (2.54mm) | 05-0072 | 1 | TE Connectivity AMP Connectors | 104257-2
3 | Socket Contact Gold 28-32 AWG Crimp | 05-0074 | 2 | TE Connectivity AMP Connectors | 1-104481-3
4 | #28 Ga wire brown | 60-0090 | TBD
5 | #28 Ga wire blue | 60-0085 | TBD

Sheet: Crtrdge Snsor Run Lst
 |  |  |  | Cartridge Presence Sensor Run List
 | From |  |  | To
Signal Name | Object | Pin | Termination | Object | Wire Color | Wire Gauge | Wire Length
+24V | 5 Pin MTE (05-0033) | 1 | 05-0074 | Opto-sensor (05-0000) | Brown | #28 | TBD
CART_PRESENT |  | 2 | 05-0074 |  | Black | #28
Gnd |  | 5 | 05-0074 |  | Blue | #28

Sheet: Cartridge Sensor BOM
 | Cartridge Presence Sensor BOM
Item | Description | Genturi P/N | Qty | Manufacturer | Mfg P/N
1 | Opto sensor | 05-0000 | 1
2 | 5 Position Rectangular Housing Connector Receptacle Black 0.100" (2.54mm) | 05-0033 | 1
3 | Socket Contact Gold 28-32 AWG Crimp | 05-0074 | 3 | TE Connectivity AMP Connectors | 1-104481-3

Sheet: Cartridge Heater Run Lst
 |  |  |  | Cartridge Heater Run List
 | From |  |  | To
Signal Name | Object | Pin | Termination | Object | Wire Color | Wire Gauge | Wire Length | Wire P/N
HTR_Gnd | 4-pin micro-fit 3.0 (05-0067) | 1 | Pin crimp (60-0078) | Heater element (05-0002) | White | #18 | TBD | 60-0078
HeaterDrive |  | 4 | Pin crimp (60-0078) |  | White | #18 | TBD | 60-0078

Sheet: Cartridge Heater BOM
 | Cartridge Heater BOM
Item | Description | Genturi P/N | Qty | Manufacturer | Mfg P/N
1 | Cartridge heater element | 05-0002 | 1
2 | CONNECTOR, HOUSING, 4-PIN, WIRE-TO-BOARD, 3MM, DUAL-ROW | 05-0067 | 1
3 | Socket Contact Tin 18 AWG Crimp Stamped | 05-0068 | 2 | Molex | 430300038
4 | #18 Ga, Wire, White | 60-0078 | TBD

Sheet: Cartridge Thermistor Run Lst
 | Cartridge Thermistor Run List
 | From |  |  | To
Signal Name | Object | Pin | Termination | Object | Wire Color | Wire Gauge | Wire Length | Wire P/N
Thermistor1 | 3 pin Micro-Fit (05-0066) | 1 | Crimp pin #26-30 (TBD) | Thermistor (05-0003) | Violet | #28 | TBD | 60-0089
Thermistor2 |  | 2 | Crimp pin #26-30 (TBD) |  | Violet | #28 | TBD | 60-0089
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
