Genturi/NewAlphaElectrical/SubSystems/SystemInterconnectCables1A.xlsx

Sheet: Emppu
Prefix | Genturi P/N | Name | From---To | Comment | Manufacturer | Manufacturer P/N | Digi-Key P/N | Cost (unit)
60 | 60-0054 | ASSY, HARNESS, IO ELECTRONICS BOX TO MTR INTERCONNECT BRD | Emppu to Riddler
05 | 05-0028 | CONNECTOR, D-SUB, 37-PIN, MALE, PANEL MNT |  | D-37 male (Emppu) | NorComp Inc. | 171-037-103L001 | 237ME-ND (https://www.digikey.com/product-detail/en/norcomp-inc/171-037-103L001/237ME-ND/858153) | $2.40
05 | 05-0027 | CONNECTOR SHELL, D-SUB, 37-PIN |  | D-37 shell | NorComp Inc. | 977-037-020R121 | 937GME-ND (https://www.digikey.com/product-detail/en/norcomp-inc/977-037-020R121/937GME-ND/858504) | $2.70
05 | 05-0026 | CONNECTOR, D-SUB, 25-PIN, MALE, PANEL MNT |  | D-25 male (Emppu) | NorComp Inc. | 171-025-103L001 | 225ME-ND (https://www.digikey.com/product-detail/en/norcomp-inc/171-025-103L001/225ME-ND/858135) | $1.42
05 | 05-0025 | CONNECTOR SHELL, D-SUB, 25-PIN |  | D-25 shell | NorComp Inc. | 979-025-020R121 | 979-25MPE-ND (https://www.digikey.com/product-detail/en/norcomp-inc/979-025-020R121/979-25MPE-ND/858522) | $2.43
05 | 05-0024 | CONNECTOR, D-SUB, 15-PIN, MALE, PANEL MNT |  | D-15 male (Emppu/Moondance) | NorComp Inc. | 171-015-103L001 | 215ME-ND (https://www.digikey.com/product-detail/en/norcomp-inc/171-015-103L001/215ME-ND/858117) | $1.22
05 | 05-0023 | CONNECTOR SHELL, D-SUB, 15-PIN |  | D-15 shell | NorComp Inc. | 979-015-020R121 | 979-15MPE-ND (https://www.digikey.com/product-detail/en/norcomp-inc/979-015-020R121/979-15MPE-ND/858519) | $2.19
05 | 05-0022 | CONNECTOR, D-SUB, 50-PIN, MALE, PANEL MNT |  | D-50 male (Riddler) | NorComp Inc. | 171-050-103L001 | 250ME-ND (https://www.digikey.com/product-detail/en/norcomp-inc/171-050-103L001/250ME-ND/858171) | $4.43
05 | 05-0021 | CONNECTOR SHELL, D-SUB, 50-PIN |  | D-50 shell | NorComp Inc. | 979-050-020R121 | 979-50MPE-ND (https://www.digikey.com/product-detail/en/norcomp-inc/979-050-020R121/979-50MPE-ND/858528) | $4.20
60 | 60-0064 | ASSY, HARNESS, IO ELECTRONICS BOX TO Z STAGE CTRL | Emppu to Z Stage (DOF-5)
05 | 05-0029 | CONNECTOR, RECTANGULAR, 1.25MM, 2X8, FEMALE |  | 16-pin female Gecko (Emppu) | Harwin | G125-FV21605L0P | 952-2777-ND (https://www.digikey.com/products/en?keywords=G125-FV21605L0P) | $13.84
05 | 05-0029 | CONNECTOR, RECTANGULAR, 1.25MM, 2X8, FEMALE |  | 16-pin female Gecko (DOF-5) | Harwin | G125-FV21605L0P | 952-2777-ND (https://www.digikey.com/products/en?keywords=G125-FV21605L0P) | $13.84
05 | 05-0030 | CONNECTOR, D-SUB-HD, 15-PIN, FEMALE, PANEL MNT |  | D-15HD female (Emppu) alternate | NorComp Inc. | 180-015-203L001 | T815FE-ND (https://www.digikey.com/product-detail/en/amphenol-icc-commercial-products/17EHD-015-S-AA-0-00/17EHD-015-S-AA-0-00-ND/1242555) | $2.65
60 | 60-0055 | ASSY, HARNESS, IO ELTRONX BOX TO POLYGON ELTRONX BOX | Emppu to Troy (poly control)
05 | 05-0031 | CONNECTOR, D-SUB-HD, 15-PIN, MALE, PANEL MNT |  | D-15HD male (Emppu) | NorComp Inc. | 180-015-103L001 | T815ME-ND (https://www.digikey.com/product-detail/en/norcomp-inc/180-015-103L001/T815ME-ND/858220) | $2.48
05 | 05-0032 | CONNECTOR SHELL, D-SUB-HD, 15-PIN |  | D-15HD shell | NorComp Inc. | 970-009-030R121 | 970-09NE-ND (https://www.digikey.com/product-detail/en/norcomp-inc/970-009-030R121/970-09NE-ND/858447) | $5.90
05 | 05-0030 | CONNECTOR, D-SUB-HD, 15-PIN, FEMALE, PANEL MNT |  | D-15HD female (Troy) | NorComp Inc. | 180-015-203L001 | T815FE-ND (https://www.digikey.com/product-detail/en/norcomp-inc/180-015-203L001/T815FE-ND/858232) | $2.65
05 | 05-0032 | CONNECTOR SHELL, D-SUB-HD, 15-PIN |  | D-15HD shell | NorComp Inc. | 970-009-030R121 | 970-09NE-ND (https://www.digikey.com/product-detail/en/norcomp-inc/970-009-030R121/970-09NE-ND/858447) | $5.90
60 | 60-0056 | ASSY, HARNESS, IO ELTRONX BOX TO POLYGON INDEX | Emppu to Polygon Index
05 | 05-0033 | CONNECTOR, HOUSING, 5-PIN, WIRE-TO-BRD, SINGLE ROW, AMPMODU MTE |  | 5-pin, receptacle, AMPMODU MTE | TE Connectivity AMP Connectors | 104257-4 | A28405-ND (https://www.digikey.com/product-detail/en/te-connectivity-amp-connectors/104257-4/A28405-ND/289305) | $0.61
60 | 60-0063 | CABLE, COAXIAL, SMA MALE TO SMA MALE, IO ELTRONX BOX TO EO CTRL BOX | Emppu to Marco (poly index) | SMA(m) to SMA(m)
60 | 60-0062 | CORD, LINE, 16-AWG, NEMA 5-15P TO IEC 320-C13, 8' | AC line cord |  | Tripp Lite | P006-008-13A | TL870-ND (https://www.digikey.com/products/en/cable-assemblies/power-line-cables-and-extension-cords/452?k=LINE+CORD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) | $10.28
60 | 60-0061 | CABLE, USB A TO USB B, 2M | USB A to USB B 2 Meter |  | L-Com | CSMUAB-2M (http://www.l-com.com/usb-premium-usb-cable-type-a-b-cable-20m) | N/A | $10.06

Sheet: Jukka
Prefix | Genturi P/N | Name | From---To | Comment | Manufacturer | Manufacturer P/N | Digi-Key P/N | Cost (unit)
60 | 60-0060 | CORD, LINE, 16-AWG, IEC 320-C14 TO IEC 320-C13, 4' | AC line cord | CORD 16AWG IEC320C14 - 320C13 4' | Tripp Lite | P004-004-13A | TL858-ND (https://www.digikey.com/products/en?keywords=TL858-ND) | $10.33
60 | 60-0059 | CORD, LINE, 16-AWG, IEC 320-C14 TO IEC 320-C13, 5' | AC line cord | CORD 16AWG IEC320C14 - 320C13 5' | Tripp Lite | P004-005-13A | TL860-ND (https://www.digikey.com/products/en?keywords=TL860-ND) | $10.99
60 | 60-0058 | CORD, LINE, 16-AWG, IEC 320-C14 TO IEC 320-C13, 3' | AC line cord | CORD 16AWG IEC320C14 - 320C13 3' | Tripp Lite | P004-003-13A | TL856-ND (https://www.digikey.com/products/en?keywords=TL856-ND) | $8.51
60 | 60-0057 | CORD, LINE, 16-AWG, IEC 320-C14 TO IEC 320-C13, 2' | AC line cord | CORD 16AWG IEC320C14 - 320C13 2' | Tripp Lite | P004-002-13A | TL853-ND (https://www.digikey.com/products/en?keywords=TL853-ND) | $8.23
60 | 60-0061 | CABLE, USB A TO USB B, 2M | USB A to USB B 2 Meter | Covered in Emppu | L-Com | CSMUAB-2M | N/A | $10.06

Sheet: Marco
Prefix | Genturi P/N | Name | From---To | Comment | Manufacturer | Manufacturer P/N | Digi-Key P/N | Cost (unit)
 |  |  | PMT signal (Marco) | See Misc | Genturi
 |  |  | SOS/Ronch
60 | 60-0075 | CABLE, USB A TO USB B MICRO, 0.5M |  | CABLE MICRO USB-B M-M 0.5M | Assmann WSW Components | AK67401-0.5 | AE10422-ND (https://www.digikey.com/products/en?keywords=AE10422-ND) | $5.08
60 | 60-0074 | CABLE, USB A TO USB B MICRO, 1M |  | CABLE MICRO USB-B M-M 1M | Assmann WSW Components | AK67401-1 | AE10423-ND (https://www.digikey.com/products/en?keywords=AE10423-ND) | $6.00
60 | 60-0073 | CABLE, USB A TO USB B MICRO, 2M |  | CABLE MICRO USB-B M-M 2M | Assmann WSW Components | AK67401-2 | AE10348-ND (https://www.digikey.com/products/en?keywords=AE10348-ND) | $6.31
 |  |  | PMT supply & control | This is part of the PMT, but requires terminations
 |  |  | Amp out
 | 60-0011 | CABLE, COAXIAL, RG174, SMA-MALE, SMA-MALE, 12" |  | Amplifier out to digitizer input | L-Com
 | 60-0012 | CABLE, COAXIAL, RG174, SMA-MALE, SMA-MALE, 18" |  | Amplifier out to digitizer input | L-Com
60 | 60-0072 | CABLE, COAXIAL, RG174, SMA-MALE, SMA-MALE, 24" |  | Amplifier out to digitizer input | L-Com | CC174S-2 (http://www.l-com.com/coaxial-rg174-coaxial-cable-sma-male-male-20-ft) |  | $23.73
60 | 60-0071 | CABLE, COAXIAL, RG174, SMA-MALE, SMA-MALE, 30" |  | Amplifier out to digitizer input | L-Com | CC174S-2.5 (http://www.l-com.com/coaxial-rg174-coaxial-cable-sma-male-male-25-ft) |  | $24.14
60 | 60-0070 | CABLE, COAXIAL, RG174, SMA-MALE, SMA-MALE, 36" |  | Amplifier out to digitizer input | L-Com | CC174S-3 (http://www.l-com.com/coaxial-rg174-coaxial-cable-sma-male-male-30-ft) |  | $24.09
60 | 60-0069 | CABLE, COAXIAL, RG174, SMA-MALE, SMA-MALE, 48" |  | Amplifier out to digitizer input | L-Com | CC174S-4 (http://www.l-com.com/coaxial-rg174-coaxial-cable-sma-male-male-40ft) |  | $24.50
60 | 60-0068 | CABLE, COAXIAL, RG174, SMA-MALE, SMA-MALE, 60" |  | Amplifier out to digitizer input | L-Com | CC174S-5 (http://www.l-com.com/coaxial-rg174-coaxial-cable-sma-male-male-50-ft) |  | $25.09
60 | 60-0067 | CABLE, COAXIAL, RG174, SMA-MALE, SMA-MALE, 78" |  | Amplifier out to digitizer input | L-Com | CC174S-7.5 (http://www.l-com.com/coaxial-rg174-coaxial-cable-sma-male-male-75-ft) |  | $26.12
 |  |  | Emppu to Marco (poly index)
 |  |  |  | SMA(m) to SMA(m) | Genturi
60 |  | ASSY, HARNESS, EO ELTRNX BOX TO POLY CTRL BOX, SCAN SYNCH | Macro to Troy (scan synch)
 | 05-0031 | CONNECTOR, D-SUB-HD, 15-PIN, MALE, PANEL MNT |  | Covered in Emppu | NorComp Inc. | 180-015-103L001 | T815ME-ND (https://www.digikey.com/product-detail/en/norcomp-inc/180-015-103L001/T815ME-ND/858220) | $2.48
 | 05-0032 | CONNECTOR SHELL, D-SUB-HD, 15-PIN |  | Covered in Emppu | NorComp Inc. | 970-009-030R121 | 970-09NE-ND (https://www.digikey.com/product-detail/en/norcomp-inc/970-009-030R121/970-09NE-ND/858447) | $5.90
 | 05-0031 | CONNECTOR, D-SUB-HD, 15-PIN, MALE, PANEL MNT |  | Covered in Emppu | NorComp Inc. | 180-015-103L001 | T815ME-ND (https://www.digikey.com/product-detail/en/norcomp-inc/180-015-103L001/T815ME-ND/858220) | $2.48
 | 05-0032 | CONNECTOR SHELL, D-SUB-HD, 15-PIN |  | Covered in Emppu | NorComp Inc. | 970-009-030R121 | 970-09NE-ND (https://www.digikey.com/product-detail/en/norcomp-inc/970-009-030R121/970-09NE-ND/858447) | $5.90
 |  |  | AC line cord | Covered in Jukka
 |  |  | USB A to USB B 2 Meter | Covered in Emppu

Sheet: Tarja
Prefix | Genturi P/N | Name | From---To |  | Manufacturer | Manufacturer P/N | Digi-Key P/N | Cost (unit)
 |  |  | AC line cord | Covered in Jukka
 |  |  | USB A to USB B 2 Meter | Covered in Emppu | L-Com | CSMUAB-2M | N/A | $10.06

Sheet: Troy
Prefix | Genturi P/N | Name | From---To | Comment | Manufacturer | Manufacturer P/N | Digi-Key P/N | Cost (unit)
60 | 60-0066 | CORD, LINE, 14-AWG, NEMA 5-15P TO IEC 320-C13, 8' | AC line cord |  | Assmann WSW Components | A-PC2302-030026-1 | AE10727-ND | $11.38
 |  |  | Emppu to Troy (poly control) | Covered in Emppu
 |  |  | Macro to Troy (scan synch) | Covered in Marco

Sheet: Misc
Prefix | Genturi P/N | Name | From---To | Comment | Manufacturer | Manufacturer P/N | Digi-Key P/N | Cost (unit)
50 | 50-0042 | ASSY, PMT, HIGH-GAIN |  | PMT assembly (older)
05 | 05-0034 | CONNECTOR, COAX, SMA, MALE, TERNINATION KIT |  |  | Amphenol RF | 132114 | ACX1202-ND (https://www.digikey.com/product-detail/en/amphenol-rf/132114/ACX1202-ND/1011879) | $6.03
05 | 05-0035 | CONNECTOR, D-SUB, 9-PIN, MALE, PANEL MNT |  | D-9 male | NorComp Inc. | 171-009-103L001 | 209ME-ND (https://www.digikey.com/products/en?keywords=171-009-103L001) | $0.84
05 | 05-0036 | CONNECTOR SHELL, D-SUB, 9-PIN |  | shell | NorComp Inc. | 970-009-030R121 | 970-09NE-ND (https://www.digikey.com/products/en?keywords=970-09NE-ND) | $5.90
50 | 50-0043 | ASSY, PMT, HIGH-BANDWIDTH |  | PMT assembly (newer)
 | 05-0034 | CONNECTOR, COAX, SMA, MALE, TERNINATION KIT |  |  | Amphenol RF | 132114 | ACX1202-ND (https://www.digikey.com/product-detail/en/amphenol-rf/132114/ACX1202-ND/1011879) | $6.03
 | 05-0035 | CONNECTOR, D-SUB, 9-PIN, MALE, PANEL MNT |  | D-9 male | NorComp Inc. | 171-009-103L001 | 209ME-ND (https://www.digikey.com/products/en?keywords=171-009-103L001) | $0.84
 | 05-0036 | CONNECTOR SHELL, D-SUB, 9-PIN |  | shell | NorComp Inc. | 970-009-030R121 | 970-09NE-ND (https://www.digikey.com/products/en?keywords=970-09NE-ND) | $5.90
60 | 60-0065 | CABLE, GPIO EXPANSION, ADQ14 |  | Digitizer to Marco digital I/O cable | Teledyne SP Devices | 106-004-003 | N/A | $115.00
