Genturi/NewAlphaElectrical/FabQuoteTimeComparison(Stargazers&Nightquest).xlsx

PCB | Fab Time | Quantity | Unit Cost | Total cost | % Reduction
31-0001 | 7 Days | 15 | 69.28 | 1039.2 | N/A
31-0001 | 10 Day | 15 | 60.96 | 914.4 | 12.0%
31-0001 | 10 Day | 10 | 91.44 | 914.4
31-0001 | 15 Day | 15 | 55.42 | 831.3 | 20.0%
31-0001 | 15 Day | 10 | 83.13 | 831.3
31-0009 | 7 Days | 10 | 103.91 | 1039.1 | N/A
31-0009 | 10 Day | 10 | 91.44 | 914.4 | 12.0%
31-0009 | 10 Day | 7 | 130.64 | 914.48
31-0009 | 15 Day | 10 | 83.13 | 831.3 | 20.0%
31-0009 | 15 Day | 7 | 118.76 | 831.32
