Genturi/NewAlphaElectrical/CartridgeInterface(Stargazers 30-0001)/Revision2/CartridgeNomenclature/CartridgeSketchBaseline.jpg

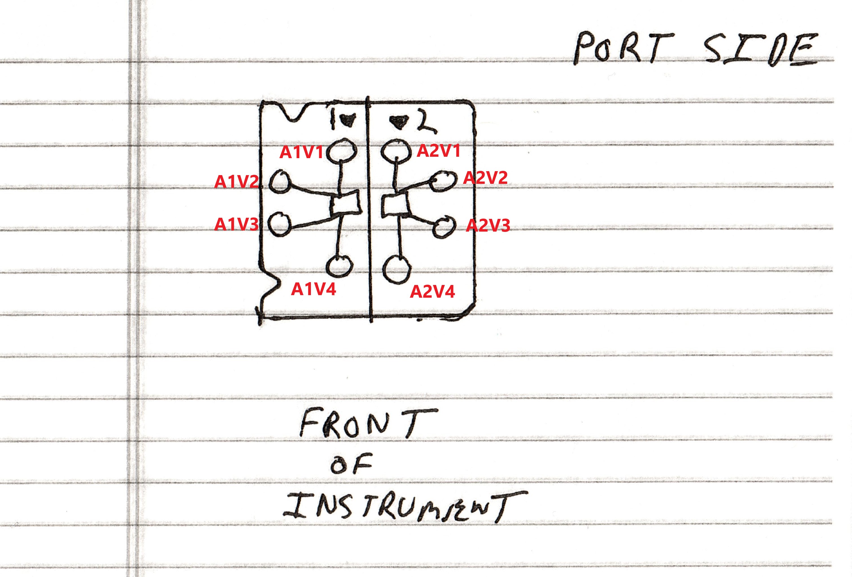
CartridgeInterface(Stargazers 30-0001)/Revision2/CartridgeNomenclature/CartridgeSketchBaseline.jpg
