Genturi/NewAlphaElectrical/CartridgeInterface(Stargazers 30-0001)/Revision2/CartridgeNomenclature/CartridgeSketchScan.jpg

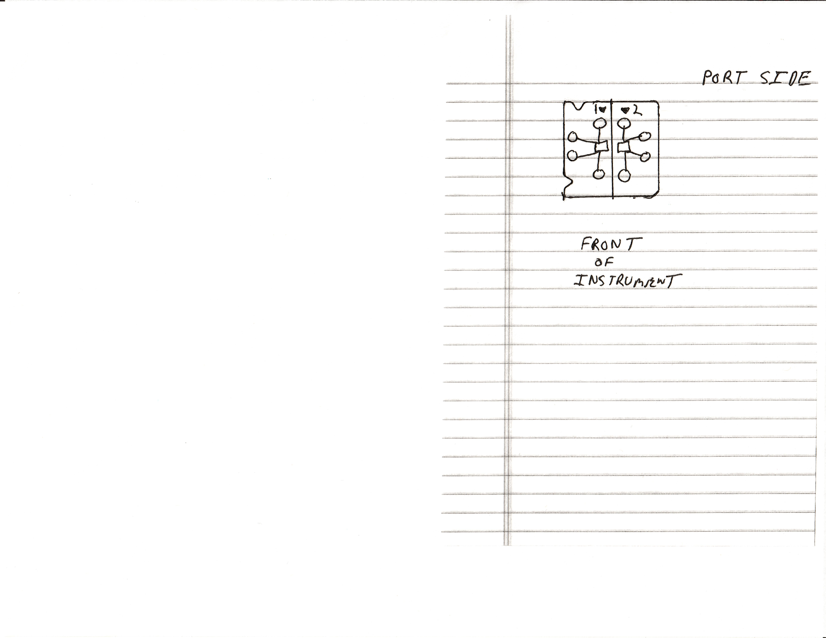
CartridgeInterface(Stargazers 30-0001)/Revision2/CartridgeNomenclature/CartridgeSketchScan.jpg
