Genturi/NewAlphaElectrical/CartridgeInterface(Stargazers 30-0001)/Revision2/CartridgeNomenclature/CartSketchRachelAnote1.jpg

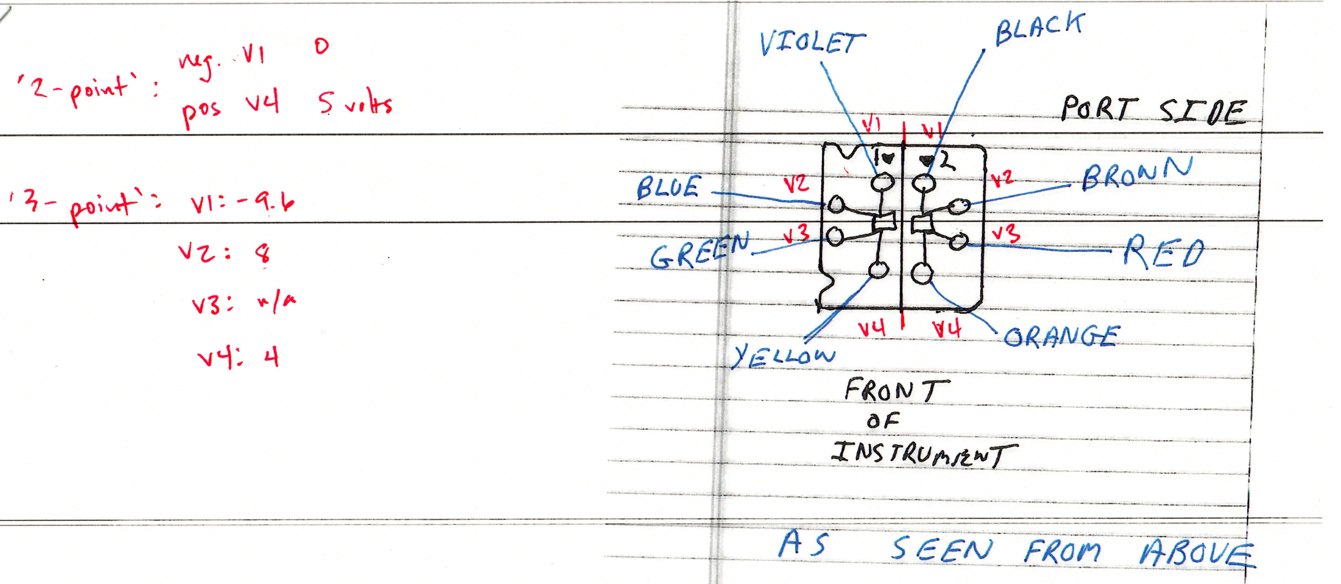
CartridgeInterface(Stargazers 30-0001)/Revision2/CartridgeNomenclature/CartSketchRachelAnote1.jpg
