Genturi/NewAlphaElectrical/MotorInterface(Riddler 30-0004)/PCB/FirstPlacement(112219)/31-0004 Rev 1_placement/31-0004 Rev 1_AssemblyDrawing.dxf

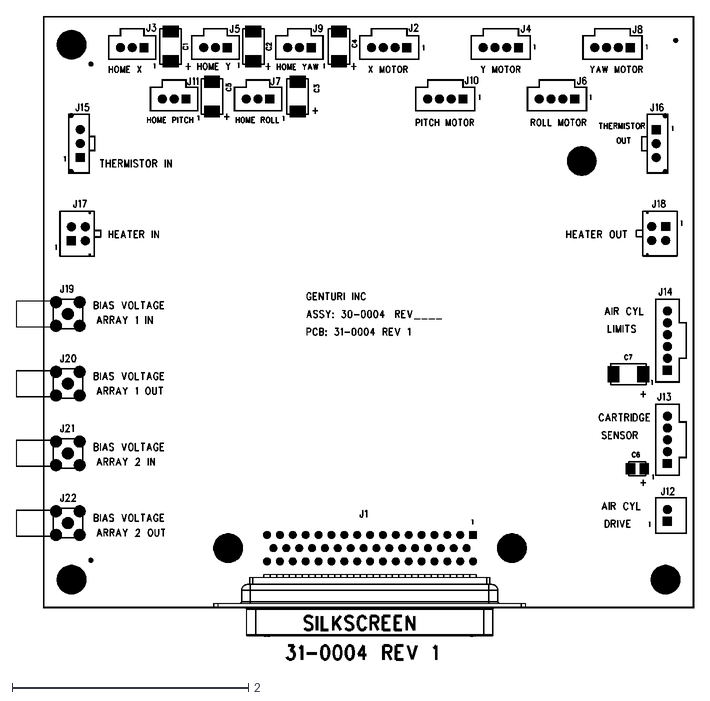
[picture p10: CAD file, 2020-03-02]
MotorInterface(Riddler 30-0004)/PCB/FirstPlacement(112219)/31-0004 Rev 1_placement/31-0004 Rev 1_AssemblyDrawing.dxf
5.74 x 5.46
