Genturi/NewAlphaElectrical/PCB/FirstPlacement/31-0002 Rev 1_placement/31-0002 Rev 1_TopAssemblyDrawing.dxf

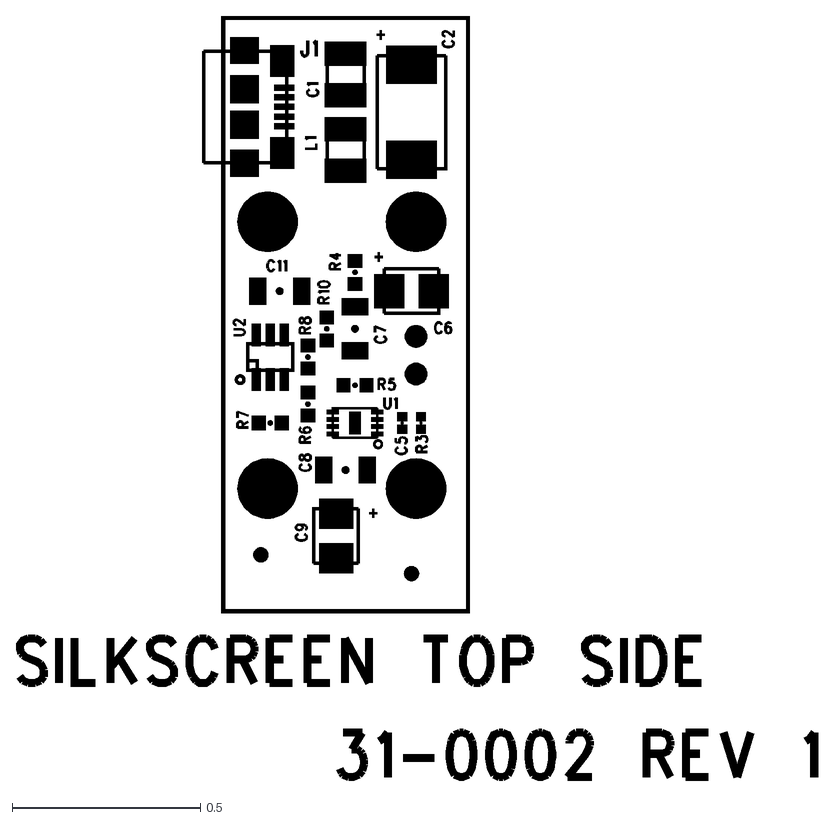
[picture p11: CAD file, 2020-03-02]
PCB/FirstPlacement/31-0002 Rev 1_placement/31-0002 Rev 1_TopAssemblyDrawing.dxf
2.13 x 2.03
