Genturi/NewAlphaElectrical/EmppuInterface(Moondance 30-0006)/PCB/FinalFiles/31-0006 Rev 1_fab/31-0006 Rev 1_AssemblyDrawing.dxf

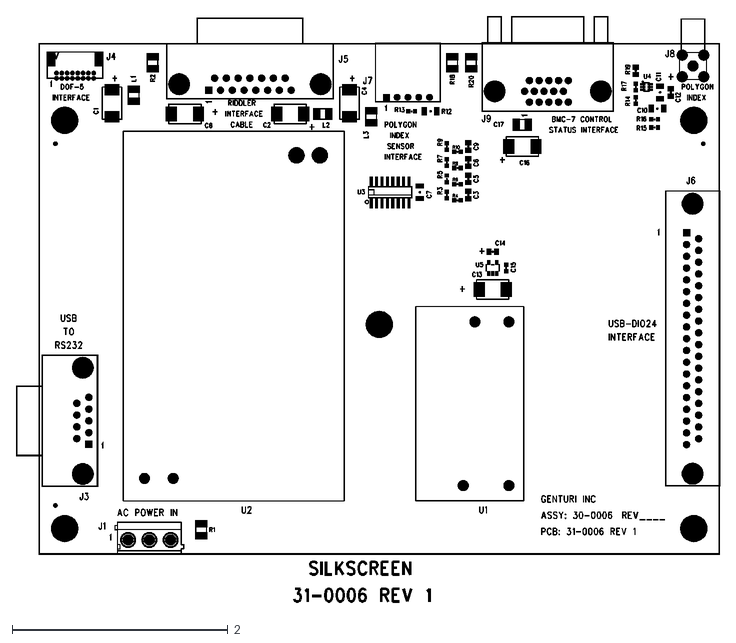
[picture p12: CAD file, 2020-03-02]
EmppuInterface(Moondance 30-0006)/PCB/FinalFiles/31-0006 Rev 1_fab/31-0006 Rev 1_AssemblyDrawing.dxf
6.52 x 5.43
