Genturi/NewAlphaElectrical/JukkaInterface(Alpenglow 30-0005)/PCB/FinalFiles/31-0005 Rev 1_fab/31-0005 Rev 1_AssemblyDrawing.dxf

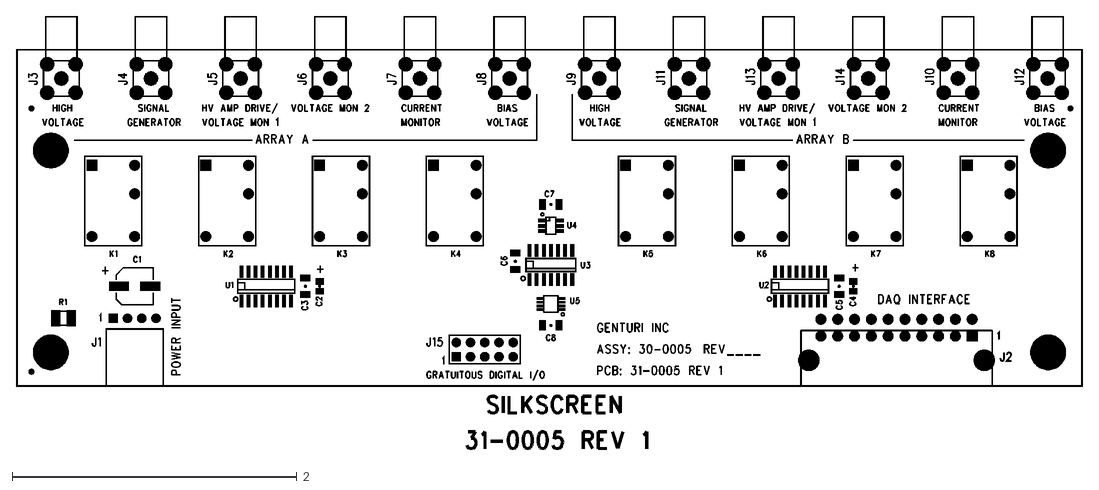
[picture p13: CAD file, 2020-03-02]
JukkaInterface(Alpenglow 30-0005)/PCB/FinalFiles/31-0005 Rev 1_fab/31-0005 Rev 1_AssemblyDrawing.dxf
7.49 x 3.05
