Genturi/NewAlphaElectrical/MarcoInterface(Arabesque 30-0003)/PCB/1stPlacement(112219)/31-0003 Rev 1_placement/31-0003 Rev 1_AssemblyDrawing.dxf

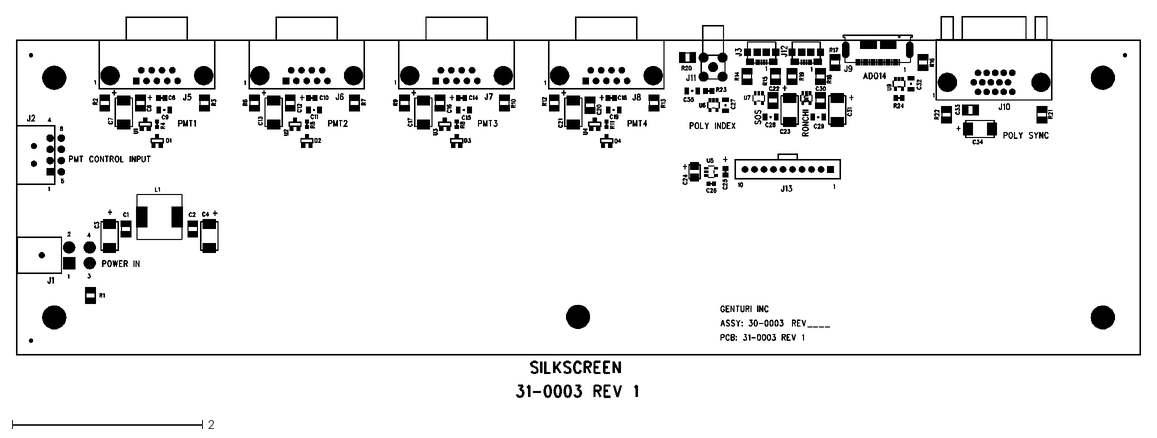
[picture p14: CAD file, 2020-03-02]
MarcoInterface(Arabesque 30-0003)/PCB/1stPlacement(112219)/31-0003 Rev 1_placement/31-0003 Rev 1_AssemblyDrawing.dxf
11.8 x 4.01
