Genturi/NewAlphaElectrical/MotorInterface(Riddler 30-0004)/PCB/FinalFiles/31-0004 Rev 1_fab/31-0004 Rev 1_AssemblyDrawing.dxf

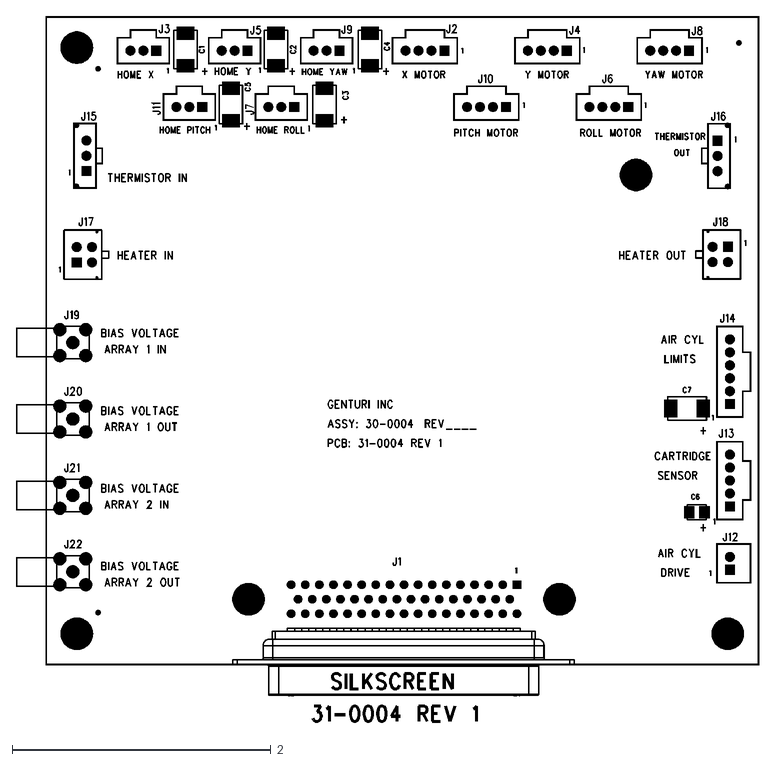
[picture p15: CAD file, 2020-03-02]
MotorInterface(Riddler 30-0004)/PCB/FinalFiles/31-0004 Rev 1_fab/31-0004 Rev 1_AssemblyDrawing.dxf
5.74 x 5.46
