Genturi/NewAlphaElectrical/PCB/FinalFiles/31-0002 Rev 1_fab/31-0002 Rev 1_BottomAssemblyDrawing.dxf

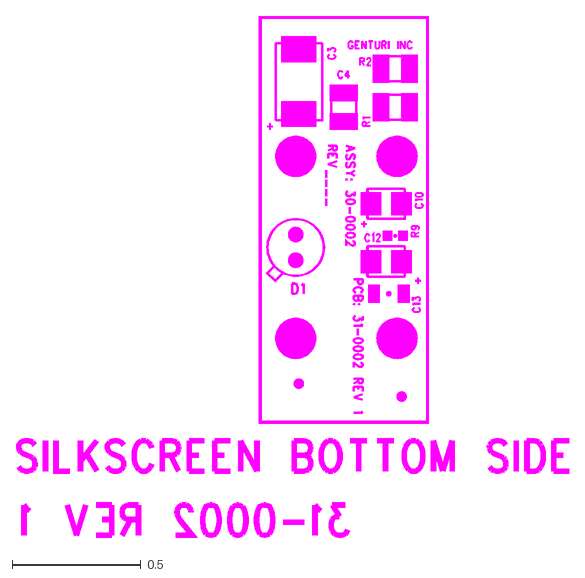
[picture p16: CAD file, 2020-03-02]
PCB/FinalFiles/31-0002 Rev 1_fab/31-0002 Rev 1_BottomAssemblyDrawing.dxf
2.15 x 2.03
