Genturi/NewAlphaElectrical/PCB/FirstPlacement/31-0002 Rev 1_placement/31-0002 Rev 1_BottomAssemblyDrawing.dxf

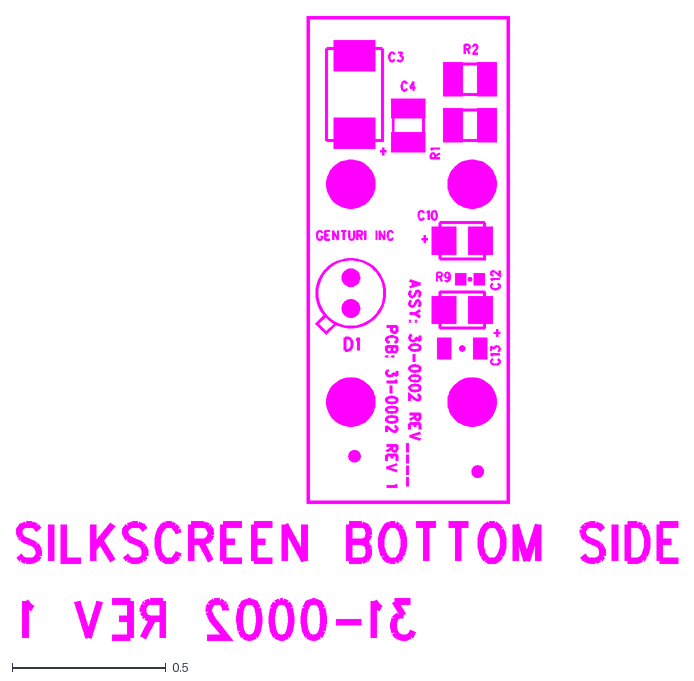
[picture p17: CAD file, 2020-03-02]
PCB/FirstPlacement/31-0002 Rev 1_placement/31-0002 Rev 1_BottomAssemblyDrawing.dxf
2.15 x 2.03
