Genturi/NewAlphaElectrical/TroyInterface(Scaretale 30-0007)/PCB/FinalFiles/31-0007 Rev 1_fab/31-0007 Rev 1_AssemblyDrawing.dxf

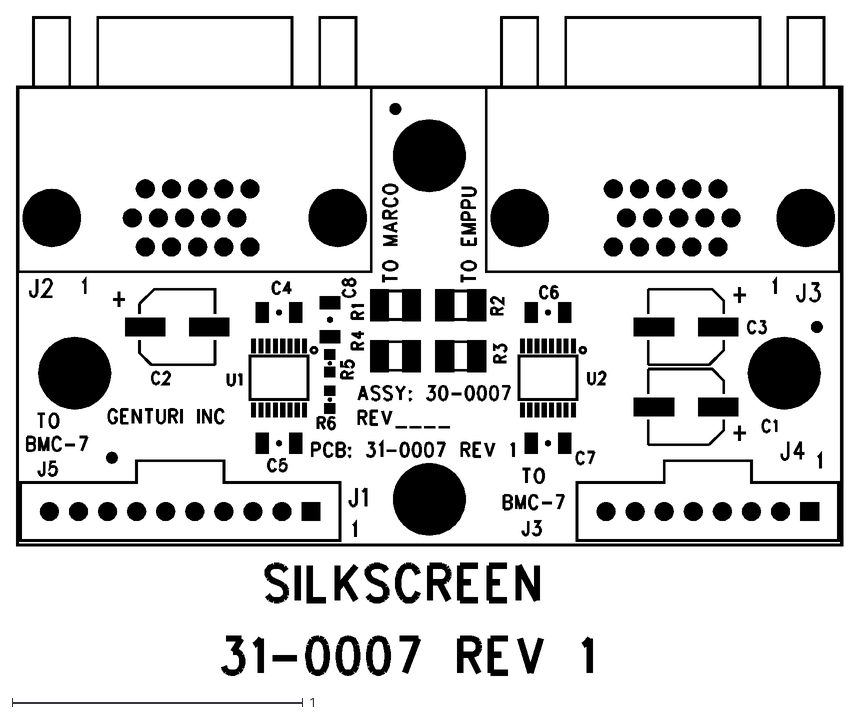
[picture p18: CAD file, 2020-03-02]
TroyInterface(Scaretale 30-0007)/PCB/FinalFiles/31-0007 Rev 1_fab/31-0007 Rev 1_AssemblyDrawing.dxf
2.85 x 2.27
