Genturi/NewAlphaElectrical/PCB/FinalFiles/31-0002 Rev 1_fab/31-0002 Rev 1_TopAssemblyDrawing.dxf

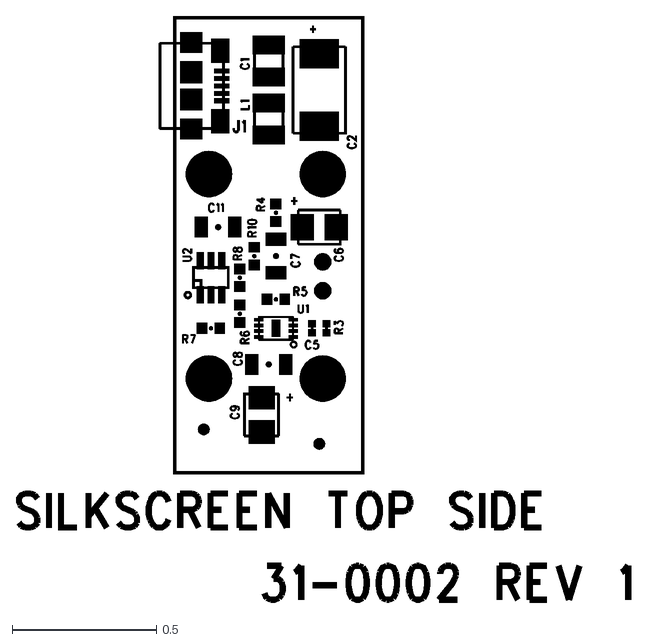
[picture p19: CAD file, 2020-03-02]
PCB/FinalFiles/31-0002 Rev 1_fab/31-0002 Rev 1_TopAssemblyDrawing.dxf
2.13 x 2.03
