Genturi/NewAlphaElectrical/CartridgeBiasInterconnect(Nightquest 30-0009)/Schematic/MechanicalDrawings/31-Cart Interconnect PCB dwg.DXF

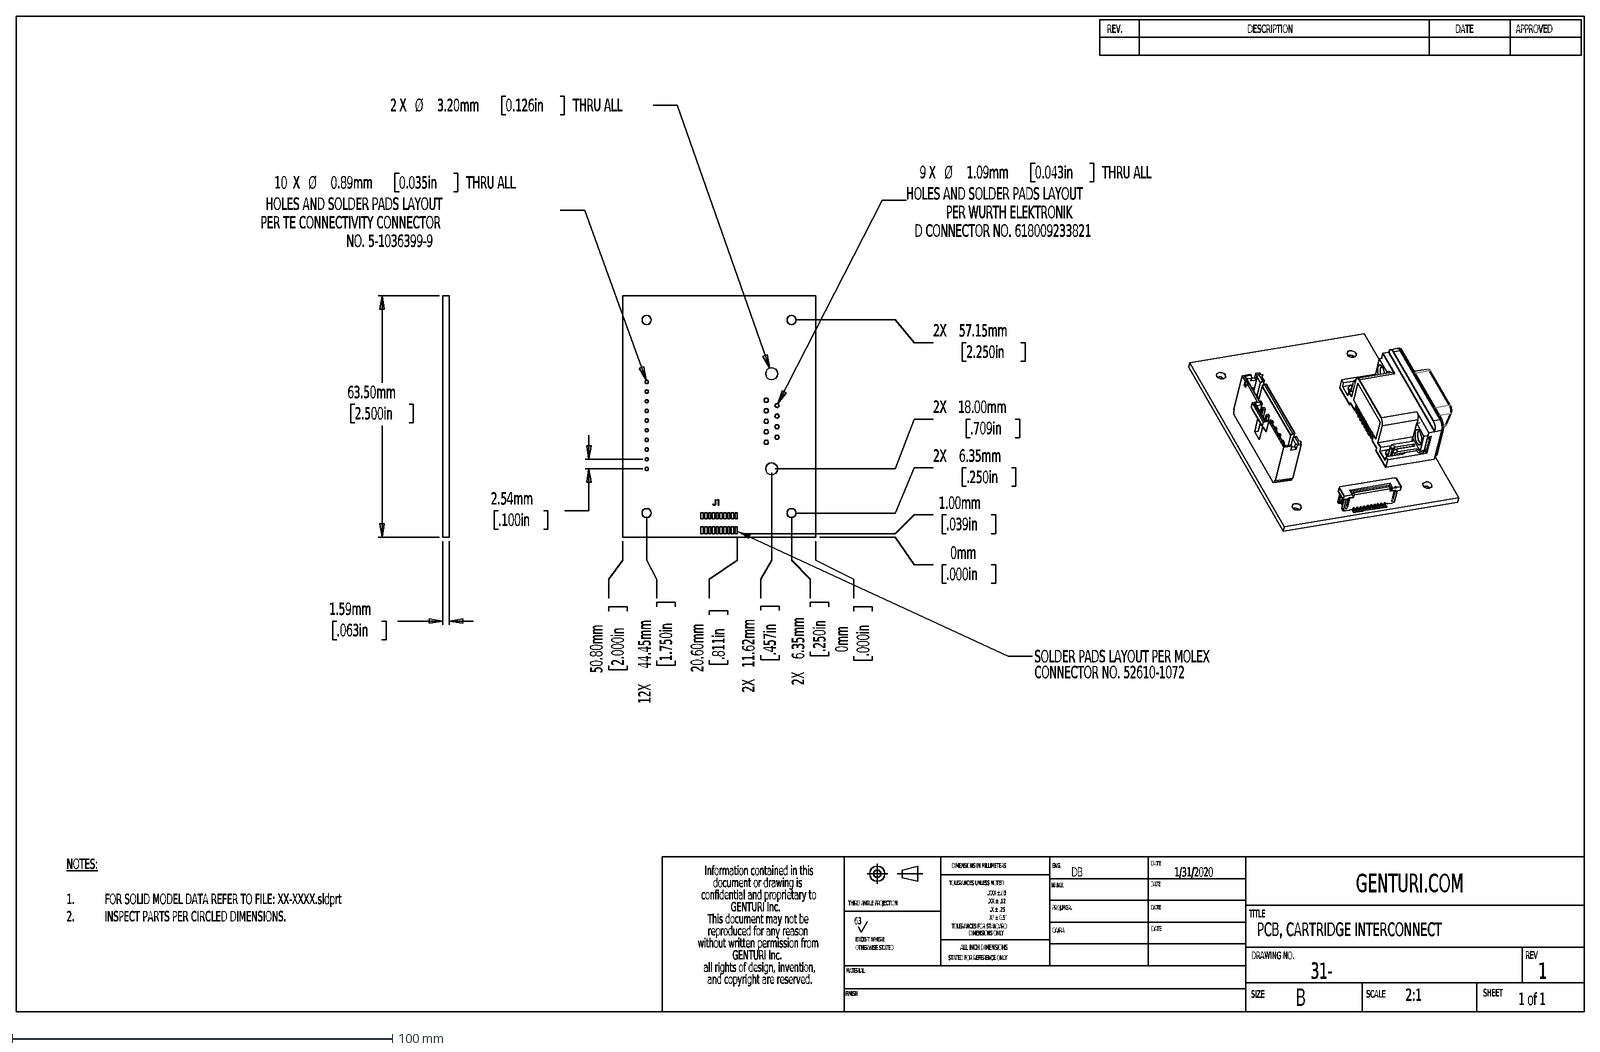
[picture p20: CAD file, 2020-03-02]
CartridgeBiasInterconnect(Nightquest 30-0009)/Schematic/MechanicalDrawings/31-Cart Interconnect PCB dwg.DXF
NOTES:
FOR SOLID MODEL DATA REFER TO FILE: XX-XXXX.sldprt
1.
INSPECT PARTS PER CIRCLED DIMENSIONS.
2.
B
Information contained in this
document or drawing is
confidential and proprietary to
GENTURI Inc.
This document may not be
reproduced for any reason
without written permission from
all rights of design, invention,
and copyright are reserved.
ENG.
MANU.
PROJ.MGR.
MATERIAL
EXCEPT WHERE
OTHERWISE STATED
THIRD ANGLE PROJECTION
63
STATED FOR REFERENCE ONLY
TOLERANCES UNLESS NOTED
TOLERANCES FOR STANDARD
.XXX ±.03
.XX ± .12
.X ± .25
X° ± 0.5°
DATE
DRAWING NO.
SIZE
TITLE
SCALE
SHEET
REV
PCB, CARTRIDGE INTERCONNECT
31-
DB
1/31/2020
ALL INCH DIMENSIONS
2:1
1 of 1
FINISH
QA/RA
1
GENTURI.COM
DIMENSIONS IN MILLIMETERS
DIMENSIONS ONLY
REV.
DESCRIPTION
APPROVED
0mm
.000in
2X
6.35mm
.250in
11.62mm
.457in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
