Genturi/NewAlphaElectrical/CartridgeBiasInterconnect(Nightquest 30-0009)/Schematic/MechanicalDrawings/RevisedMechanicalRequirements/31-0009-2_PART.DXF

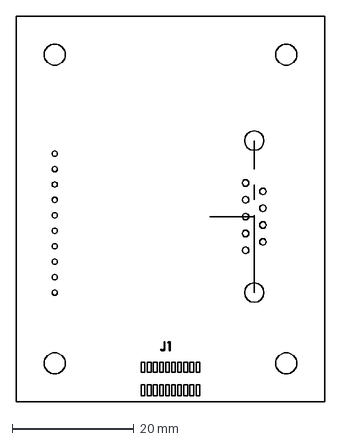
[picture p21: CAD file, 2020-03-02]
CartridgeBiasInterconnect(Nightquest 30-0009)/Schematic/MechanicalDrawings/RevisedMechanicalRequirements/31-0009-2_PART.DXF
50.8 x 63.5 mm
