Genturi/NewAlphaElectrical/CartridgeInterface(Stargazers 30-0001)/Revision2/MechDrawings/31-0001-2 dwg.DXF

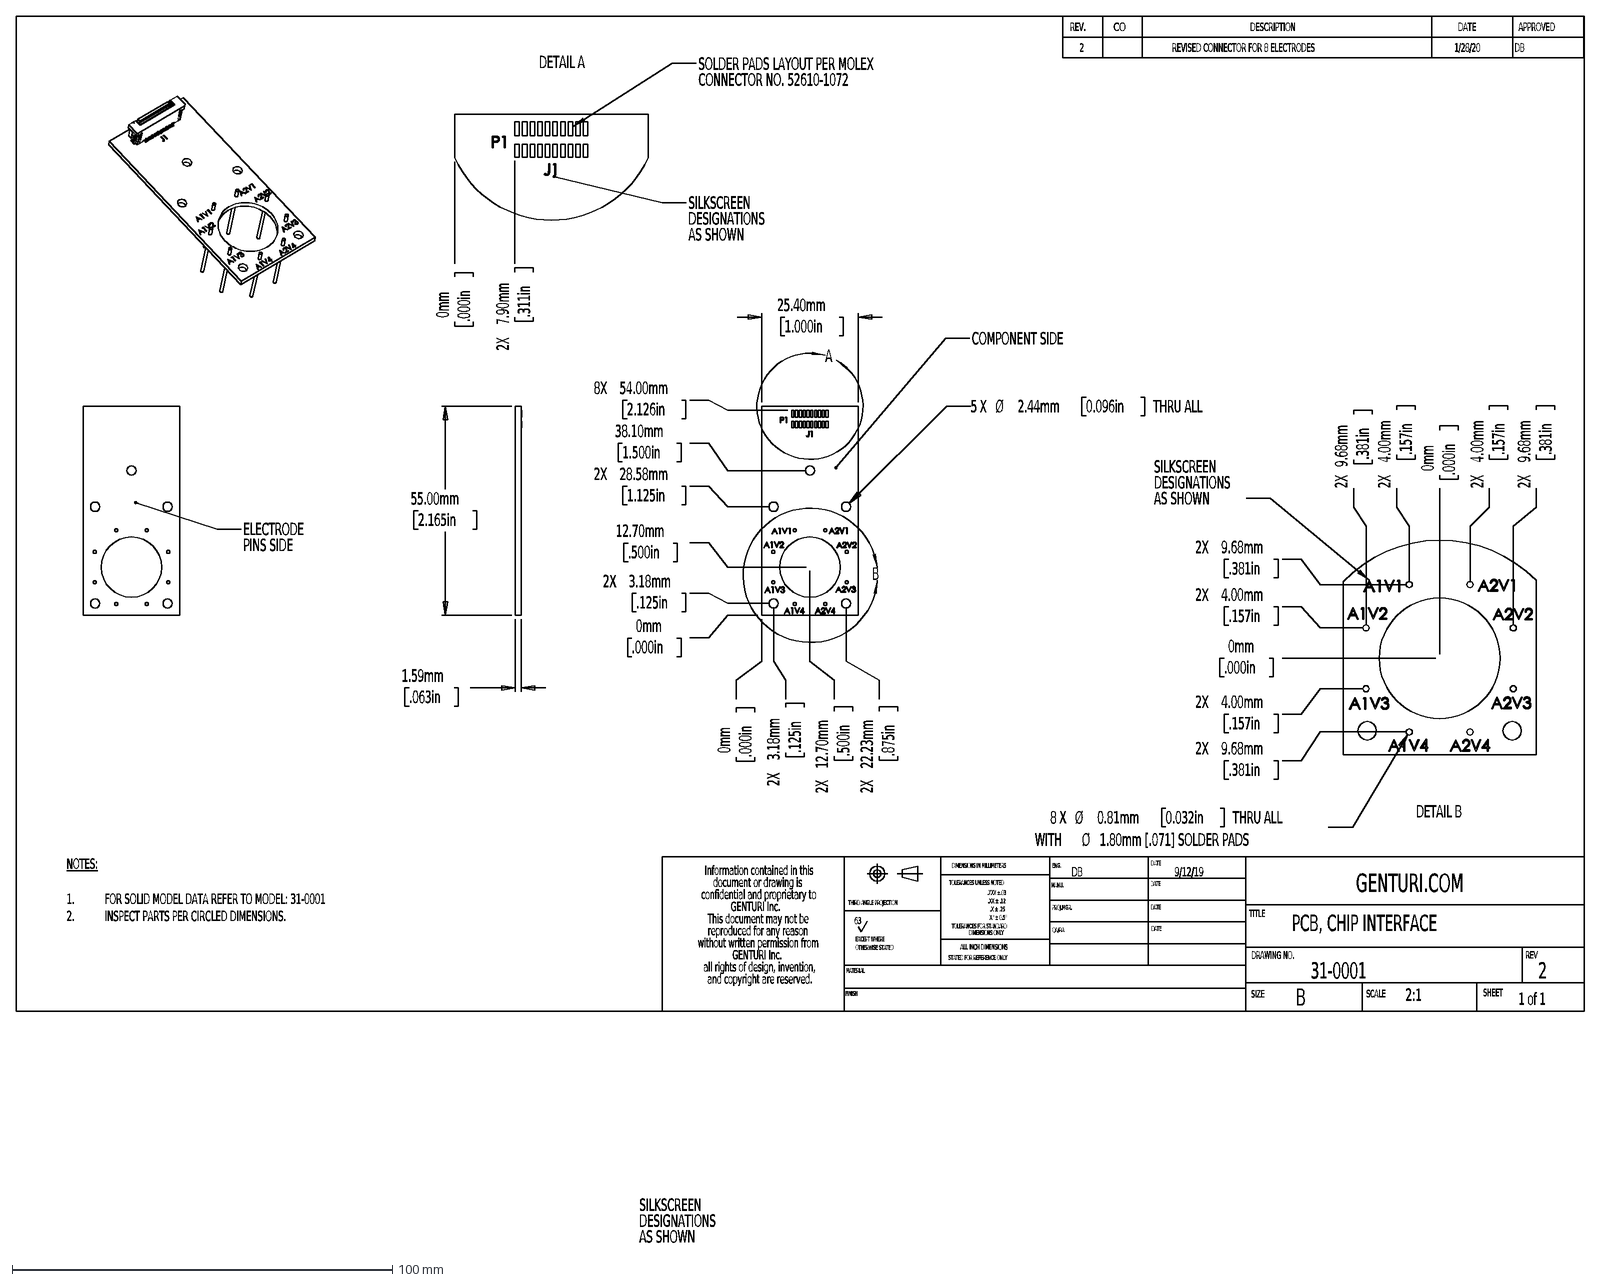
[picture p22: CAD file, 2020-03-02]
CartridgeInterface(Stargazers 30-0001)/Revision2/MechDrawings/31-0001-2 dwg.DXF
NOTES:
FOR SOLID MODEL DATA REFER TO MODEL: 31-0001
1.
INSPECT PARTS PER CIRCLED DIMENSIONS.
2.
SILKSCREEN
DESIGNATIONS
AS SHOWN
B
Information contained in this
document or drawing is
confidential and proprietary to
GENTURI Inc.
This document may not be
reproduced for any reason
without written permission from
all rights of design, invention,
and copyright are reserved.
ENG.
MANU.
PROJ.MGR.
MATERIAL
EXCEPT WHERE
OTHERWISE STATED
THIRD ANGLE PROJECTION
63
STATED FOR REFERENCE ONLY
TOLERANCES UNLESS NOTED
TOLERANCES FOR STANDARD
.XXX ±.03
.XX ± .12
.X ± .25
X° ± 0.5°
DATE
DRAWING NO.
SIZE
TITLE
SCALE
SHEET
REV
PCB, CHIP INTERFACE
31-0001
DB
9/12/19
ALL INCH DIMENSIONS
2:1
1 of 1
FINISH
QA/RA
2
GENTURI.COM
DIMENSIONS IN MILLIMETERS
DIMENSIONS ONLY
REV.
CO
DESCRIPTION
APPROVED
REVISED CONNECTOR FOR 8 ELECTRODES
1/28/20
0mm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
