Genturi/NewAlphaElectrical/EmppuInterface(Moondance 30-0006)/PCB/FinalFiles/31-0006 Rev 1_fab/31-0006 Rev 1_FabricationDrawing.dxf

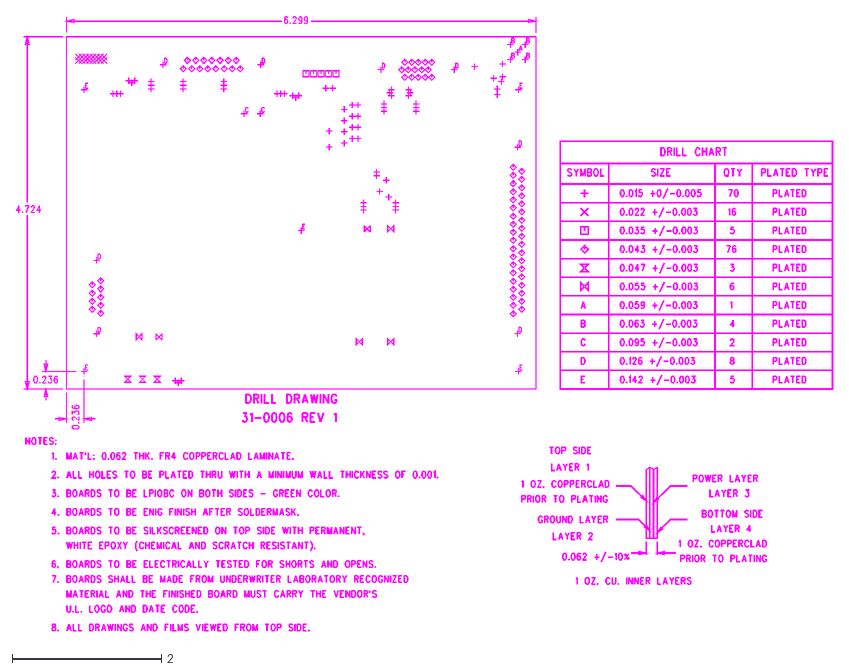
[picture p23: CAD file, 2020-03-02]
EmppuInterface(Moondance 30-0006)/PCB/FinalFiles/31-0006 Rev 1_fab/31-0006 Rev 1_FabricationDrawing.dxf
11.0 x 8.25
