Genturi/NewAlphaElectrical/EmppuInterface(Moondance 30-0006)/PCB/ForMassDesign/Moondance2.DXF

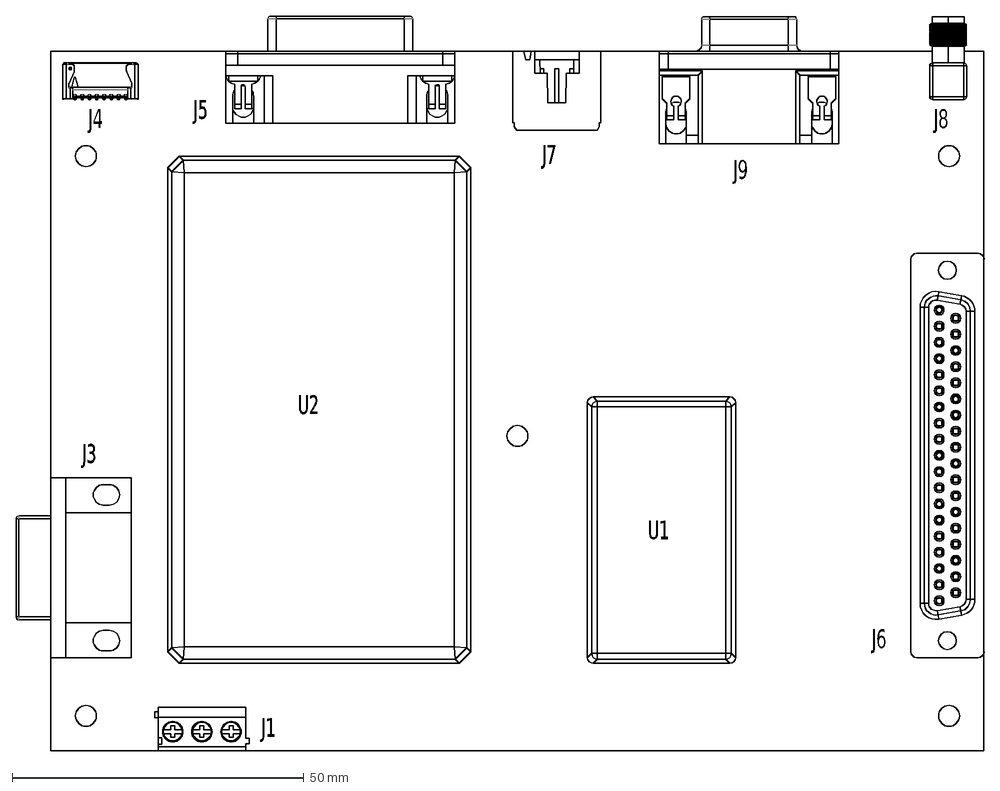
[picture p24: CAD file, 2020-03-02]
EmppuInterface(Moondance 30-0006)/PCB/ForMassDesign/Moondance2.DXF
J3
J1
J6
U2
U1
J8
J9
J7
J5
J4
