Genturi/NewAlphaElectrical/JukkaInterface(Alpenglow 30-0005)/Alpenglow2.DXF

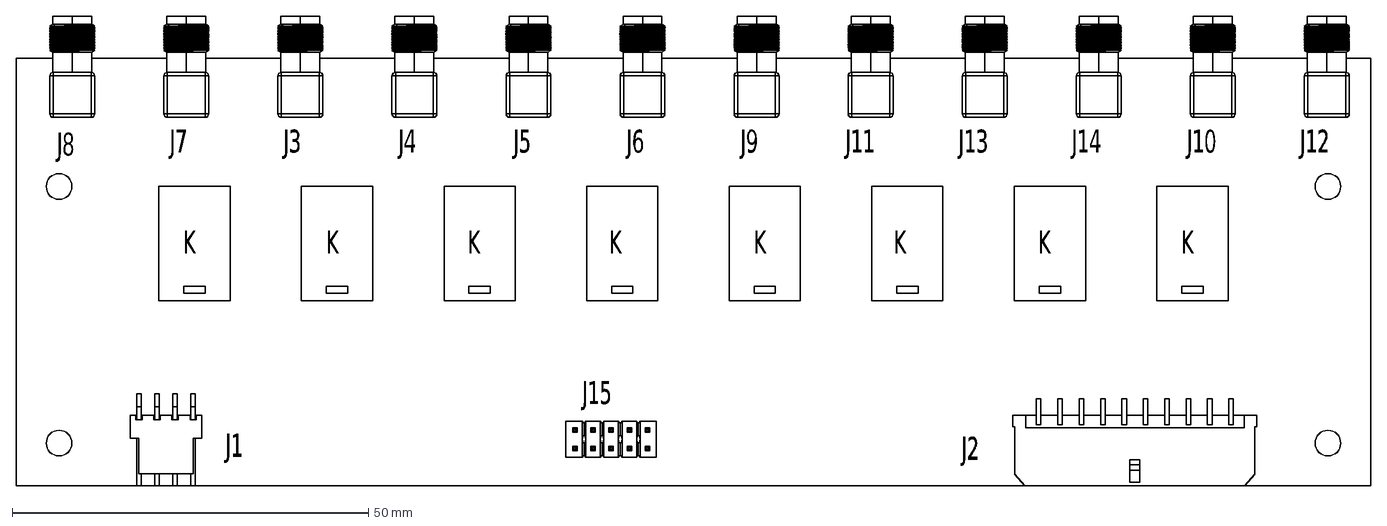
[picture p25: CAD file, 2020-03-02]
JukkaInterface(Alpenglow 30-0005)/Alpenglow2.DXF
K
J1
J15
J2
J8
J7
J3
J4
J5
J6
J9
J11
J13
J14
J10
J12
