Genturi/NewAlphaElectrical/JukkaInterface(Alpenglow 30-0005)/PCB/FinalFiles/31-0005 Rev 1_fab/31-0005 Rev 1_FabricationDrawing.dxf

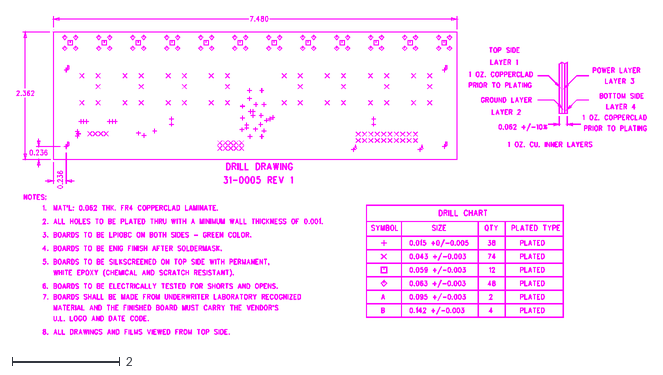
[picture p26: CAD file, 2020-03-02]
JukkaInterface(Alpenglow 30-0005)/PCB/FinalFiles/31-0005 Rev 1_fab/31-0005 Rev 1_FabricationDrawing.dxf
11.7 x 5.91
