Genturi/NewAlphaElectrical/MarcoInterface(Arabesque 30-0003)/PCB/1stPlacement(112219)/31-0003 Rev 1_placement/31-0003 Rev 1_FabricationDrawing.dxf

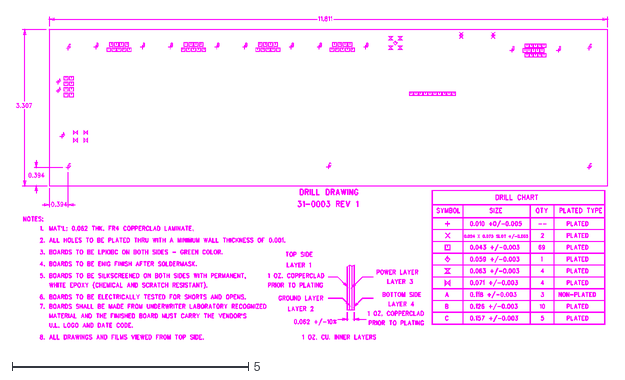
[picture p27: CAD file, 2020-03-02]
MarcoInterface(Arabesque 30-0003)/PCB/1stPlacement(112219)/31-0003 Rev 1_placement/31-0003 Rev 1_FabricationDrawing.dxf
12.5 x 6.84
