Genturi/NewAlphaElectrical/MarcoInterface(Arabesque 30-0003)/PCB/Arabesque.DXF

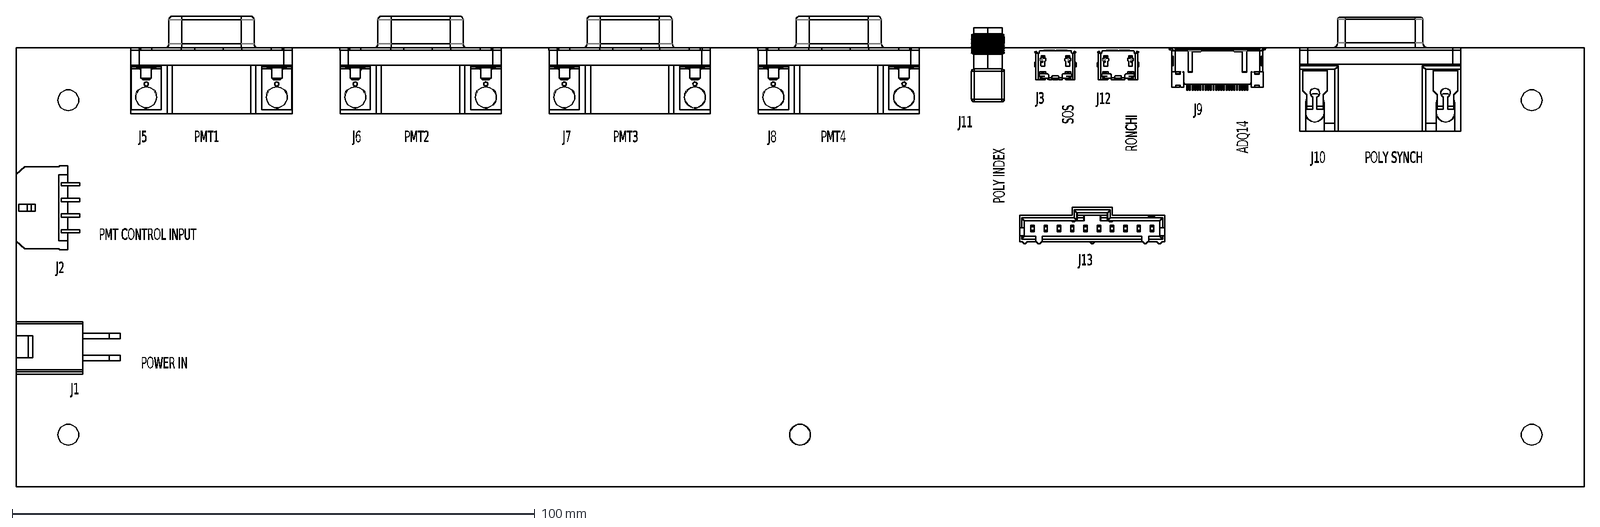
[picture p28: CAD file, 2020-03-02]
MarcoInterface(Arabesque 30-0003)/PCB/Arabesque.DXF
POWER IN
POLY INDEX
J3
PMT CONTROL INPUT
PMT1
PMT2
PMT3
PMT4
SOS
RONCHI
ADQ14
POLY SYNCH
J1
J2
J5
J6
J7
J8
J11
J12
J9
J10
J13
