Genturi/NewAlphaElectrical/MotorInterface(Riddler 30-0004)/PCB/30-0004.DXF

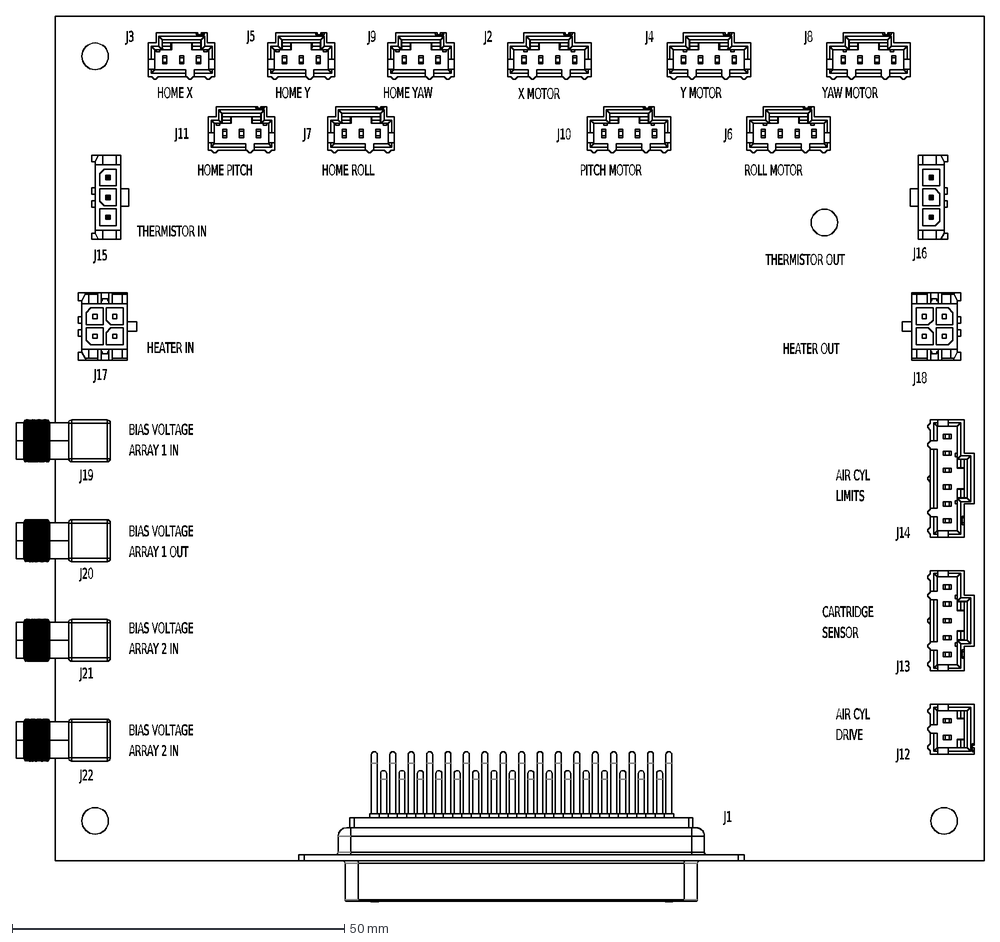
[picture p29: CAD file, 2020-03-02]
MotorInterface(Riddler 30-0004)/PCB/30-0004.DXF
BIAS VOLTAGE
ARRAY 1 IN
ARRAY 1 OUT
ARRAY 2 IN
HEATER OUT
X MOTOR
J1
J3
J9
J2
J4
J8
J11
J7
THERMISTOR IN
HEATER IN
THERMISTOR OUT
AIR CYL
LIMITS
CARTRIDGE
SENSOR
DRIVE
HOME X
HOME Y
HOME YAW
HOME PITCH
HOME ROLL
Y MOTOR
YAW MOTOR
PITCH MOTOR
ROLL MOTOR
J22
J21
J20
J19
J17
J15
J12
J13
J14
J18
J16
J5
J10
J6
