Genturi/NewAlphaElectrical/MotorInterface(Riddler 30-0004)/PCB/FinalFiles/31-0004 Rev 1_fab/31-0004 Rev 1_FabricationDrawing.dxf

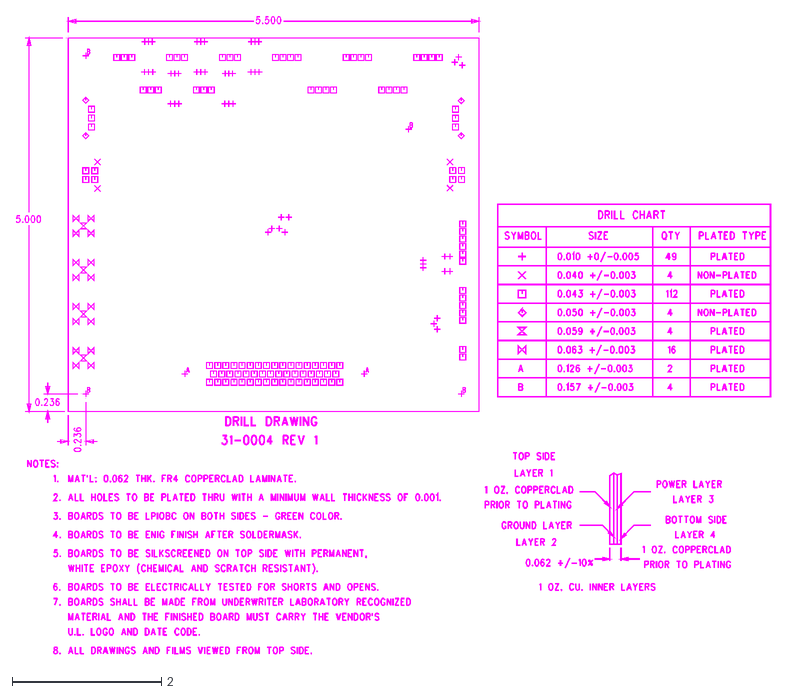
[picture p30: CAD file, 2020-03-02]
MotorInterface(Riddler 30-0004)/PCB/FinalFiles/31-0004 Rev 1_fab/31-0004 Rev 1_FabricationDrawing.dxf
10.1 x 8.54
