Genturi/NewAlphaElectrical/PCB/FinalFiles/31-0002 Rev 1_fab/31-0002 Rev 1_FabricationDrawing.dxf

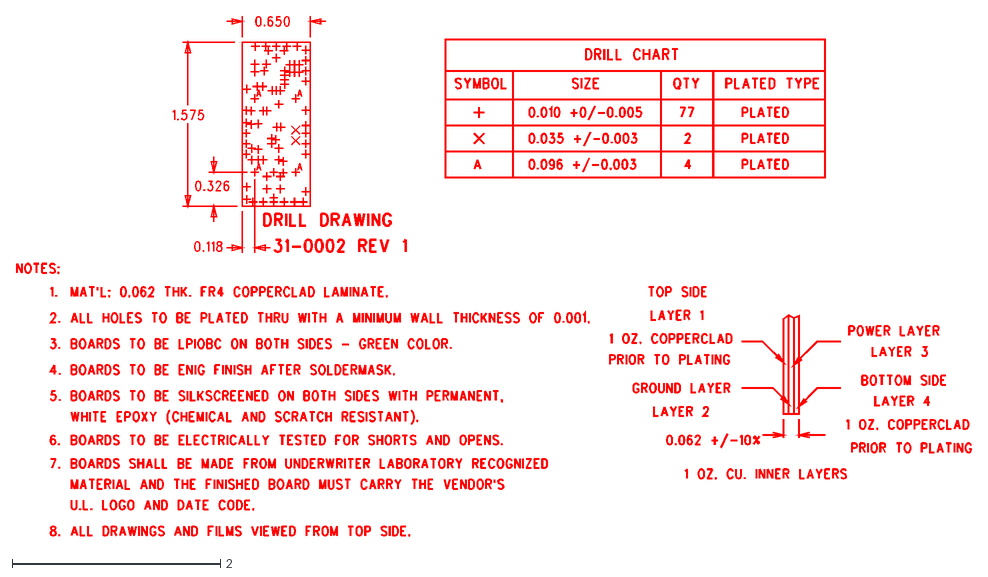
[picture p31: CAD file, 2020-03-02]
PCB/FinalFiles/31-0002 Rev 1_fab/31-0002 Rev 1_FabricationDrawing.dxf
9.19 x 5.01
