Genturi/NewAlphaElectrical/Schematic/PackageForMassDesign/MechanicalDrawings/31-0008-1.DXF

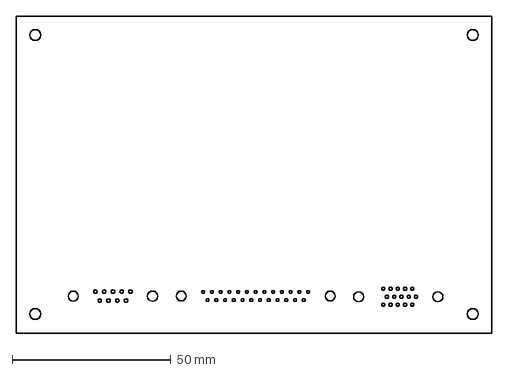
[picture p32: CAD file, 2020-03-02]
Schematic/PackageForMassDesign/MechanicalDrawings/31-0008-1.DXF
150.0 x 100.0 mm
