Genturi/NewAlphaElectrical/TroyInterface(Scaretale 30-0007)/PCB/FinalFiles/31-0007 Rev 1_fab/31-0007 Rev 1_FabricationDrawing.dxf

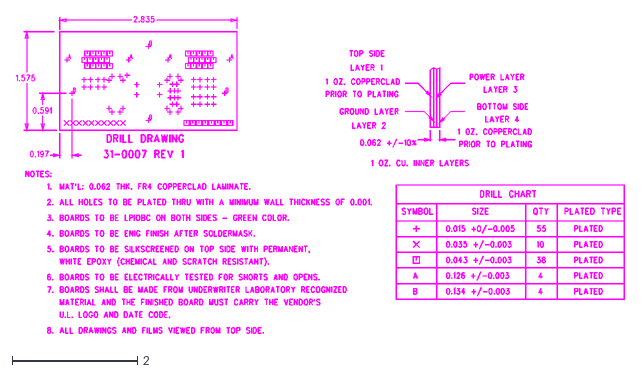
[picture p33: CAD file, 2020-03-02]
TroyInterface(Scaretale 30-0007)/PCB/FinalFiles/31-0007 Rev 1_fab/31-0007 Rev 1_FabricationDrawing.dxf
9.73 x 5.08
