Genturi/NewAlphaElectrical/TroyInterface(Scaretale 30-0007)/PCB/PackageForMassDesign/Scaretale.DXF

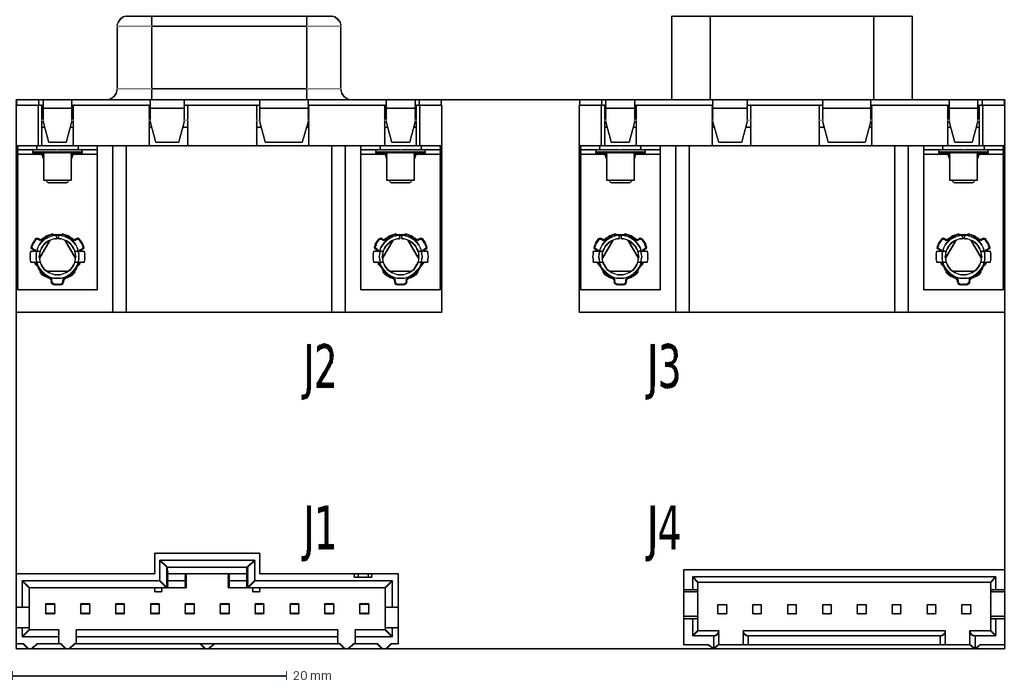
[picture p34: CAD file, 2020-03-02]
TroyInterface(Scaretale 30-0007)/PCB/PackageForMassDesign/Scaretale.DXF
J1
J2
J3
J4
