Genturi/NewAlphaElectrical/TroyInterface(Scaretale 30-0007)/PCB/Scaretale.DXF

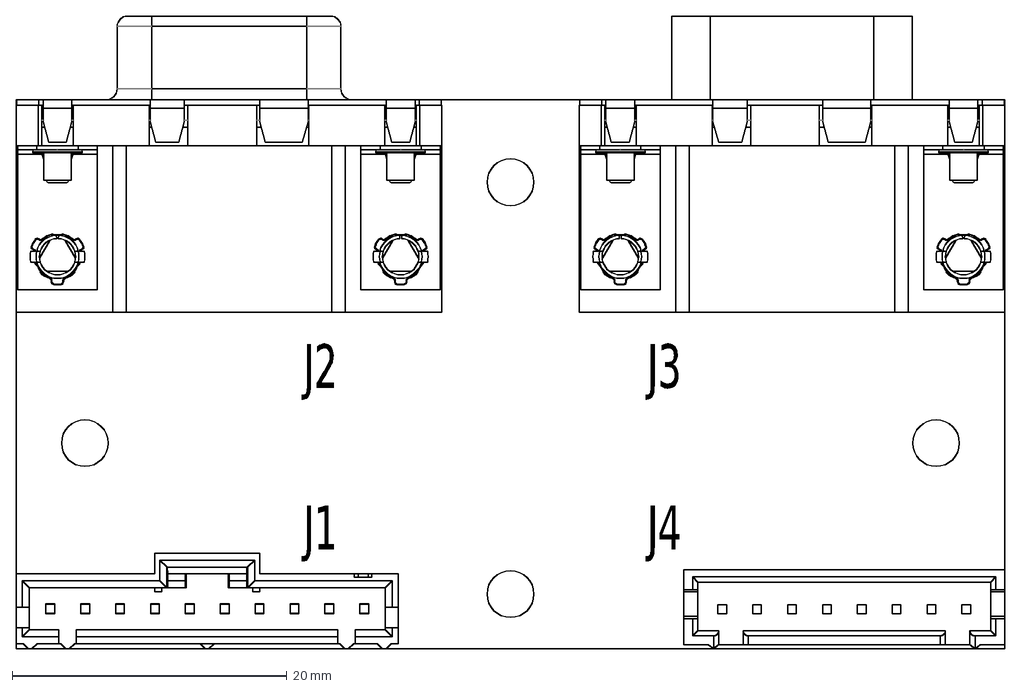
[picture p35: CAD file, 2020-03-02]
TroyInterface(Scaretale 30-0007)/PCB/Scaretale.DXF
J1
J2
J3
J4
