Genturi/NewAlphaElectrical/CartridgeBiasInterconnect(Nightquest 30-0009)/Schematic/MechanicalDrawings/31-Cart Interconnect PCB-prt.DXF

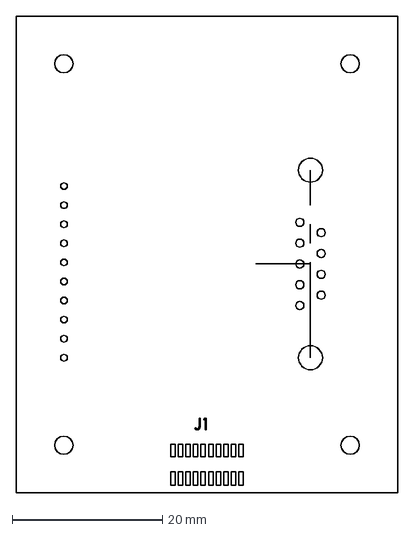
[picture p36: CAD file, 2020-03-02]
CartridgeBiasInterconnect(Nightquest 30-0009)/Schematic/MechanicalDrawings/31-Cart Interconnect PCB-prt.DXF
50.8 x 63.5 mm
