Genturi/NewAlphaElectrical/CartridgeInterface(Stargazers 30-0001)/Revision2/MechDrawings/31-0001-2 prt.DXF

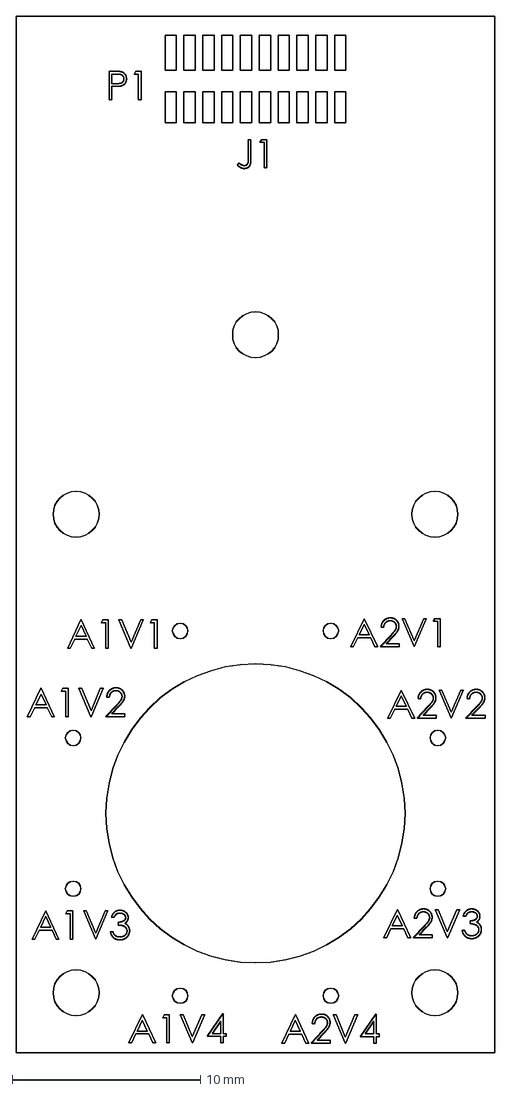
[picture p37: CAD file, 2020-03-02]
CartridgeInterface(Stargazers 30-0001)/Revision2/MechDrawings/31-0001-2 prt.DXF
25.4 x 55.0 mm
