Genturi/NewAlphaElectrical/JukkaInterface(Alpenglow 30-0005)/Alpenglow1.DXF

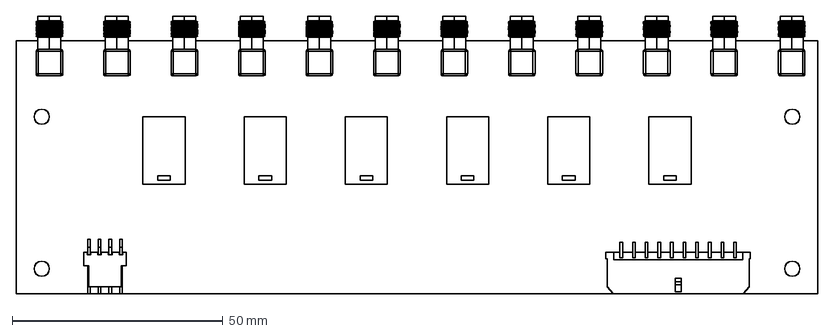
[picture p38: CAD file, 2020-03-02]
JukkaInterface(Alpenglow 30-0005)/Alpenglow1.DXF
190.0 x 65.9 mm
