Genturi/NewAlphaElectrical/MotorInterface(Riddler 30-0004)/PCB/FirstPlacement(112219)/31-0004 Rev 1_placement/31-0004 Rev 1_FabricationDrawing.dxf

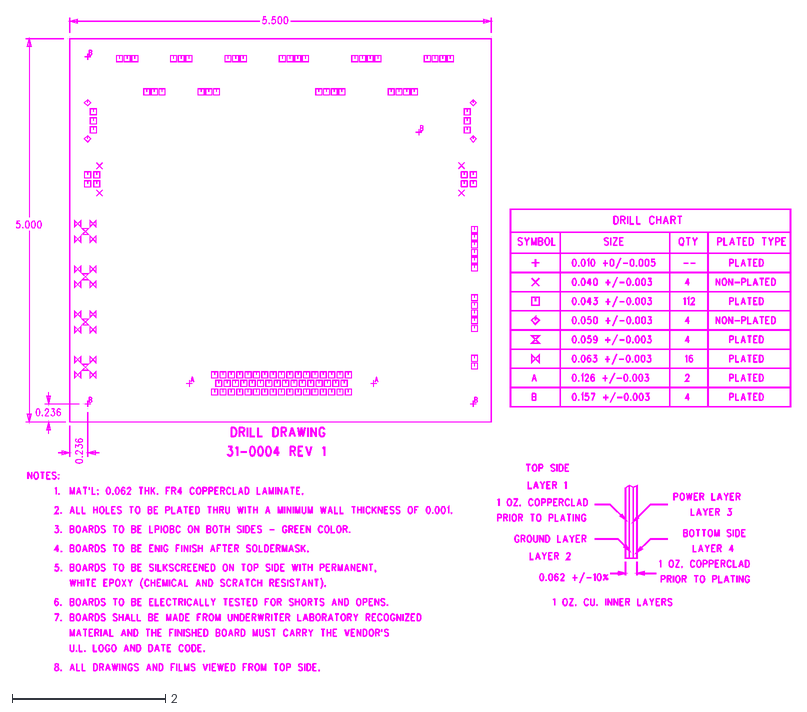
[picture p39: CAD file, 2020-03-02]
MotorInterface(Riddler 30-0004)/PCB/FirstPlacement(112219)/31-0004 Rev 1_placement/31-0004 Rev 1_FabricationDrawing.dxf
10.1 x 8.54
