Genturi/NewAlphaElectrical/PCB/FirstPlacement/31-0002 Rev 1_placement/31-0002 Rev 1_FabricationDrawing.dxf

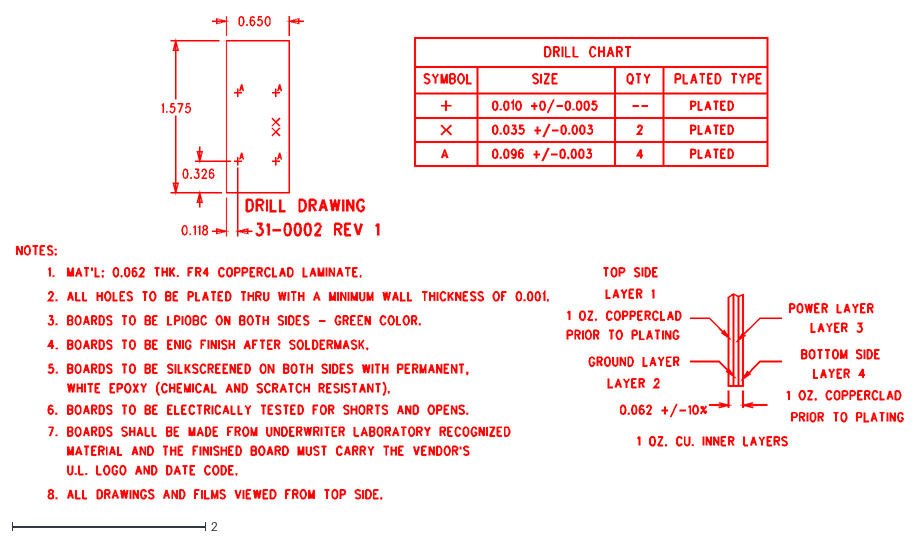
[picture p40: CAD file, 2020-03-02]
PCB/FirstPlacement/31-0002 Rev 1_placement/31-0002 Rev 1_FabricationDrawing.dxf
9.19 x 5.01
