Genturi/NewAlphaElectrical/(list of files, cad)

Other CAD files:
CartridgeInterface(Stargazers 30-0001)/Revision1/PCB/31-0001 Rev 1_fab/ASSEMBLY.DXF
CartridgeInterface(Stargazers 30-0001)/Revision1/PCB/31-0001 Rev 1_fab/DRILL.DXF
