Genturi/NewAlphaElectrical/TroyInterface(Scaretale 30-0007)/PCB/PackageForMassDesign/LayoutInstructionsFor31-0007(Scaretale).docx

Layout instructions for 31-0007 (Scaretale)

Schematic: 33-0007

Assembly: 30-0007

Artwork/Raw PCB: 31-0007

CAD files (PADs): 34-0007

Pallet drawing (if applicable): 32-0007

General board requirements:

PCB material and thickness: 0.062” thick; FR-4; 1-ounce CU clad; ENIG

Rough shape: 40mm X 72mm

Layers: 2

Component placement and routining:

- See the DXF file
