Genturi/NewAlphaElectrical/JukkaInterface(Alpenglow 30-0005)/PCB/PackageForMassDesign(Alpenglow)/LayoutInstructionsFor31-0005(Alpenglow).docx

Layout instructions for 31-0005 (Alpenglow)

Schematic: 33-0005

Assembly: 30-0005

Artwork/Raw PCB: 31-0005

CAD files (PADs): 34-0005

Pallet drawing (if applicable): 32-0005

General board requirements:

PCB material and thickness: 0.062” thick; FR-4; 1-ounce CU clad; ENIG

Rough shape: 190mm X 60mm

Layers: 4

Layer designations:

1: Top components and routes

2: Plane (GND_SIGNAL)

3: Plane (VCC)

4: Bottom components and routes

Component placement and routining:

- See the DXF file
