Genturi/NewAlphaElectrical/EmppuInterface(Moondance 30-0006)/PCB/ForMassDesign/LayoutInstructionsFor31-0006(Moondance).docx

Layout instructions for 31-0006 (Moondance)

Schematic: 33-0006

Assembly: 30-0006

Artwork/Raw PCB: 31-0006

CAD files (PADs): 34-0006

Pallet drawing (if applicable): 32-0006

General board requirements:

PCB material and thickness: 0.062” thick; FR-4; 1-ounce CU clad; ENIG

Rough shape: 160mm X 120mm

Layers: 4

Layer designations:

1: Top components and routes

2: Plane (GND_SIGNAL)

3: Plane (VCC)

4: Bottom components and routes

Component placement and routining:

- See the DXF file
