Genturi/NewAlphaElectrical/PCB/AssemblyDrawing(30-0001)GhostRiver.docx

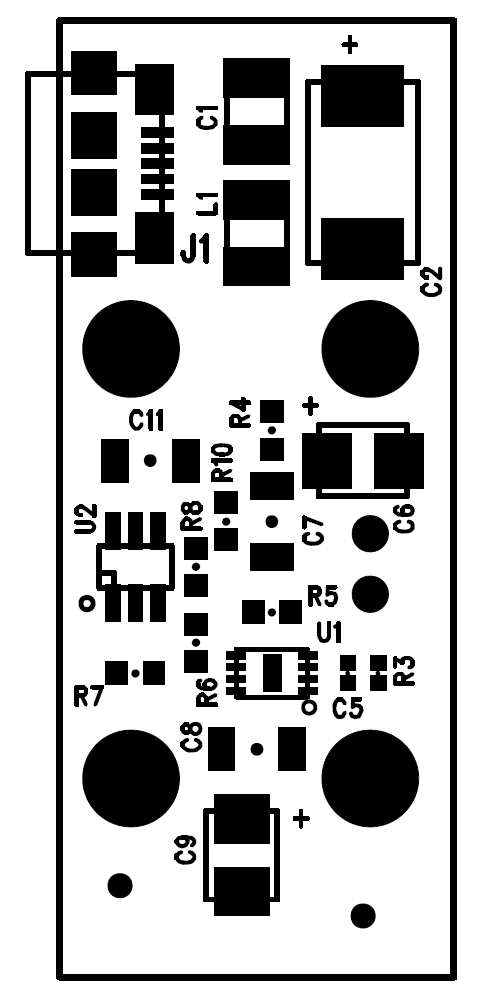
[picture p41: figure]
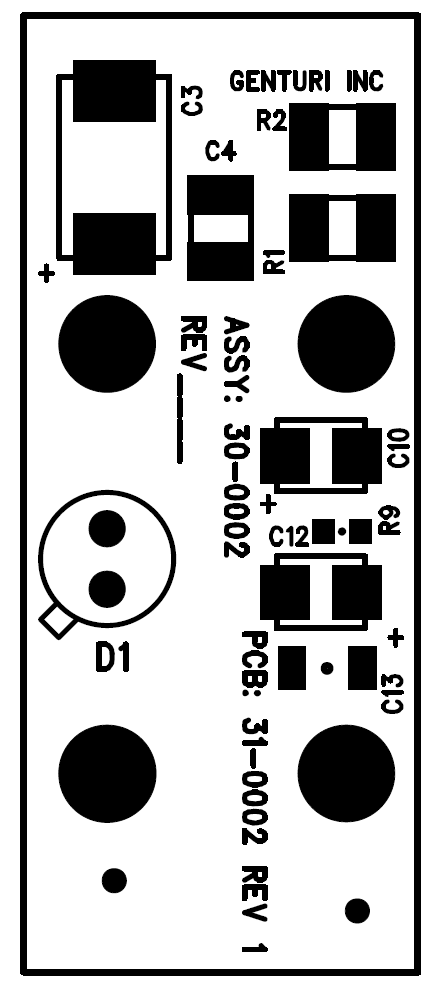
[picture p42: figure]

Bottom Side

Top Side
