Genturi/NewAlphaElectrical/MotorInterface(Riddler 30-0004)/LayoutMockUp(prints close to 1to1).docx

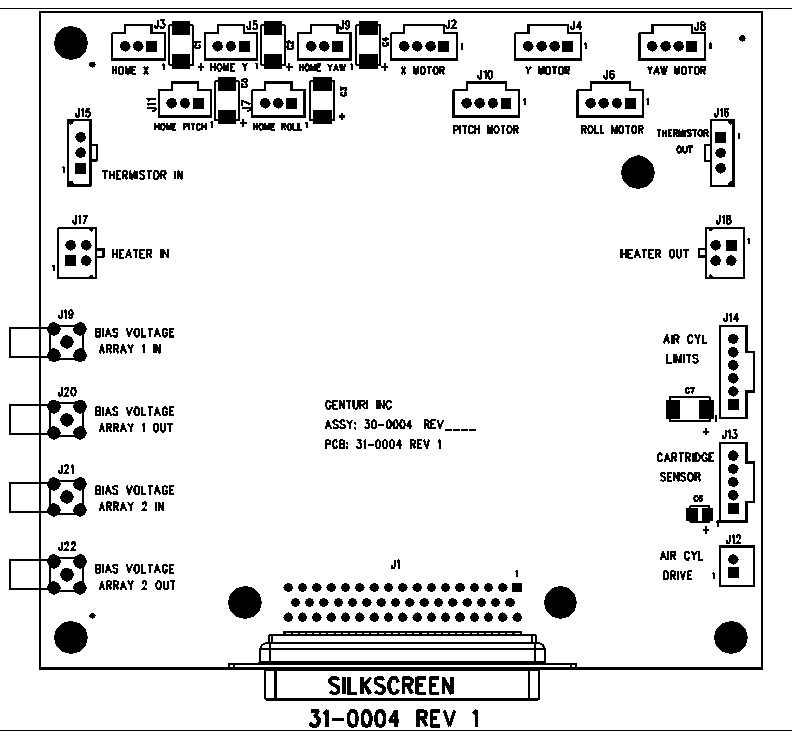
[picture p43: figure]
