Genturi/NewAlphaElectrical/SystemDesign/AlphaSubSystemEmppu_R1p0p0_092319.pdf

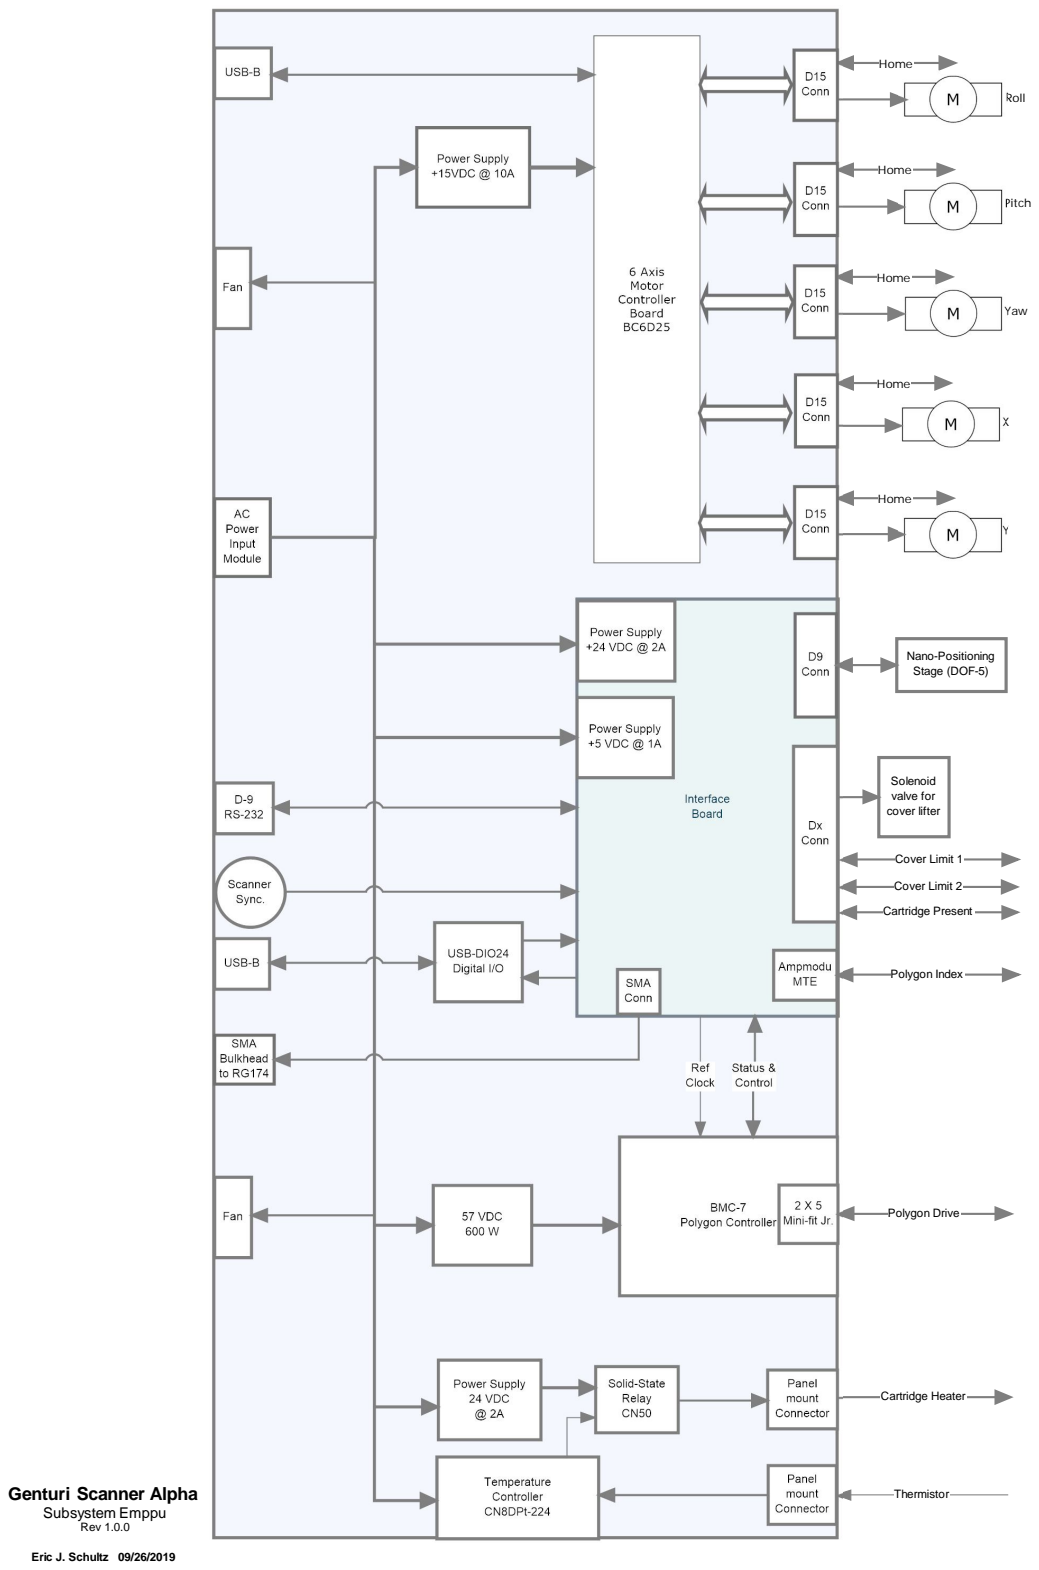
[picture p44: page 1]
Roll; Pitch; Yaw; Home; 6 Axis Motor Controller Board BC6D25; Power Supply +15VDC @ 10A; D15 Conn; D9 Conn; AC Power Input Module; Power Supply +24 VDC @ 2A; USB-B; Nano-Positioning Stage (DOF-5); Solenoid valve for cover lifter; Cover Limit 1; Cover Limit 2; Cartridge Present; Dx Conn; BMC-7; Power Supply +5 VDC @ 1A; Ampmodu; MTE; Polygon Index; Polygon Drive; USB-DIO24 Digital I/O; Status & Control; Ref Clock; Temperature Controller CN8DPt-224; Power Supply 24 VDC @ 2A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

Polygon Controller 57 VDC

Mini-fit Jr.

Genturi Scanner Alpha
Subsystem Emppu
