Genturi/NewAlphaElectrical/SystemDesign/AlphaSubsystemMarco_R1p0p0_092519.pdf

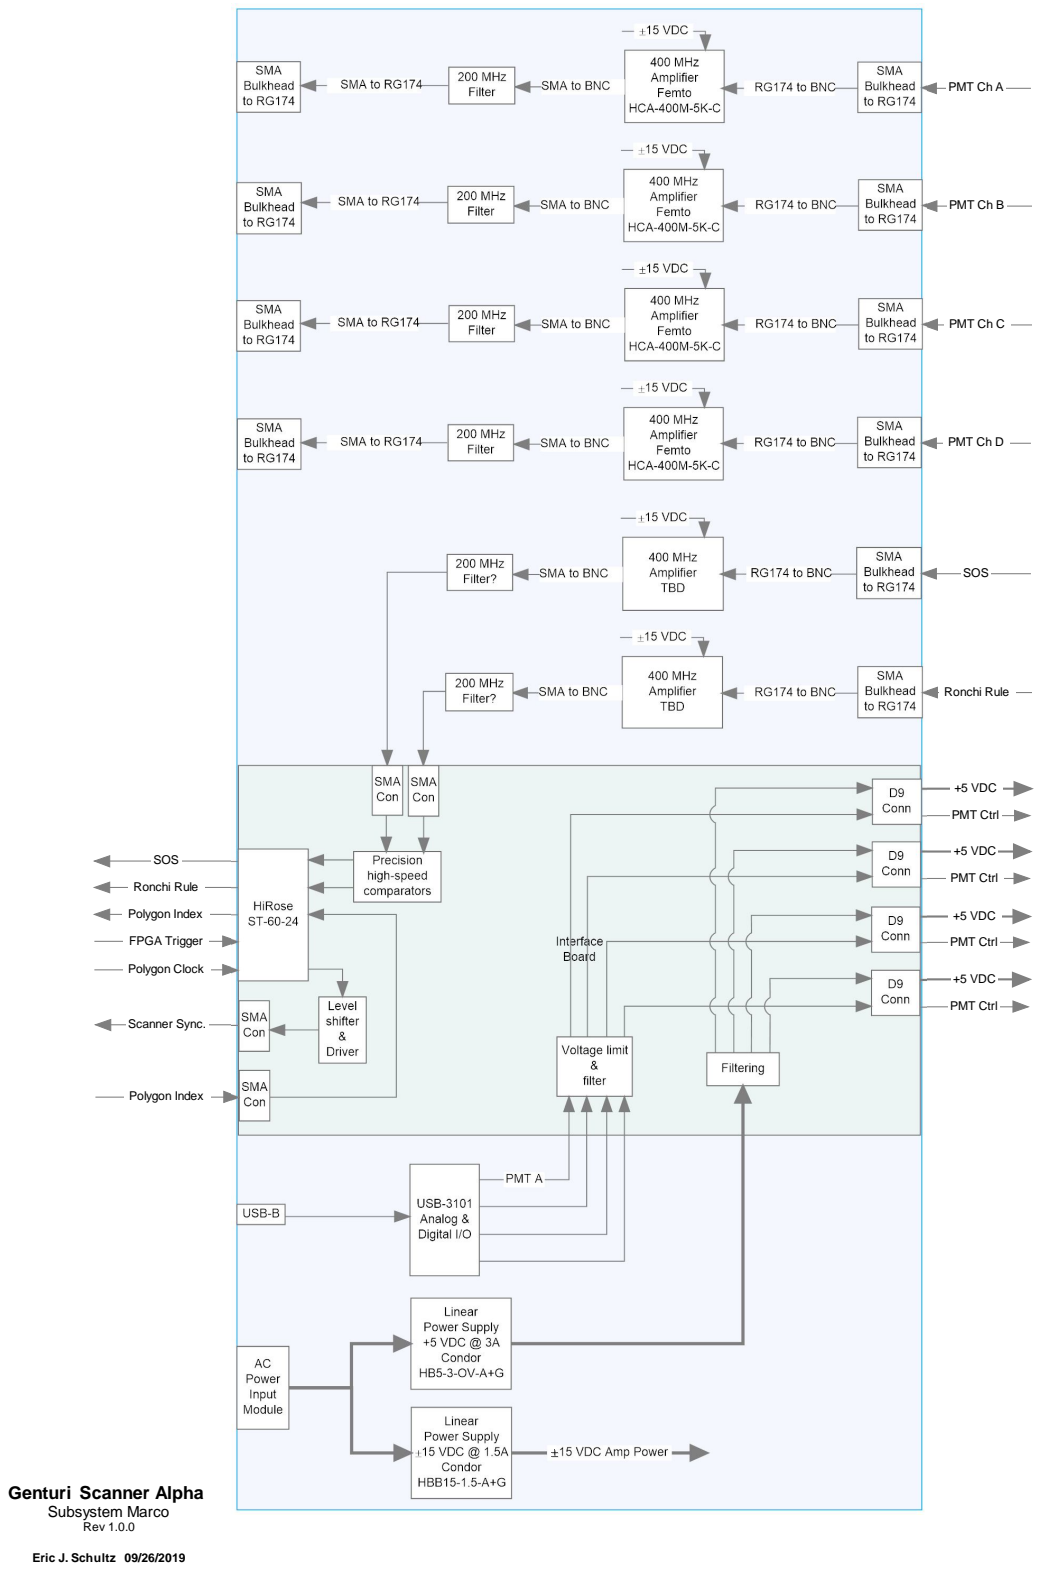
[picture p45: page 1]
USB-3101 Analog & Digital I/O; Linear Power Supply 15 VDC @ 1.5A Condor HBB15-1.5-A+G; Linear Power Supply +5 VDC @ 3A Condor HB5-3-OV-A+G; 400 MHz Amplifier Femto HCA-400M-5K-C; D9 Conn; +5 VDC; PMT Ctrl; SMA Bulkhead to RG174; SMA to BNC; RG174 to BNC; 200 MHz Filter; SMA to RG174; PMT Ch A; 15 VDC; PMT Ch B; PMT Ch C; RG174 to BNC 200 MHz; Filter; PMT Ch D; 400 MHz Amplifier TBD; 200 MHz; Filter?; SOS; Ronchi Rule; SMA Con; HiRose ST-60-24; Polygon Clock; FPGA Trigger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

Con Polygon Index

15 VDC Amp Power

Genturi Scanner Alpha
Subsystem Marco
