Genturi/NewAlphaElectrical/SystemDesign/AlphaSystem(Tuomas)_R1p0p0_092719.pdf

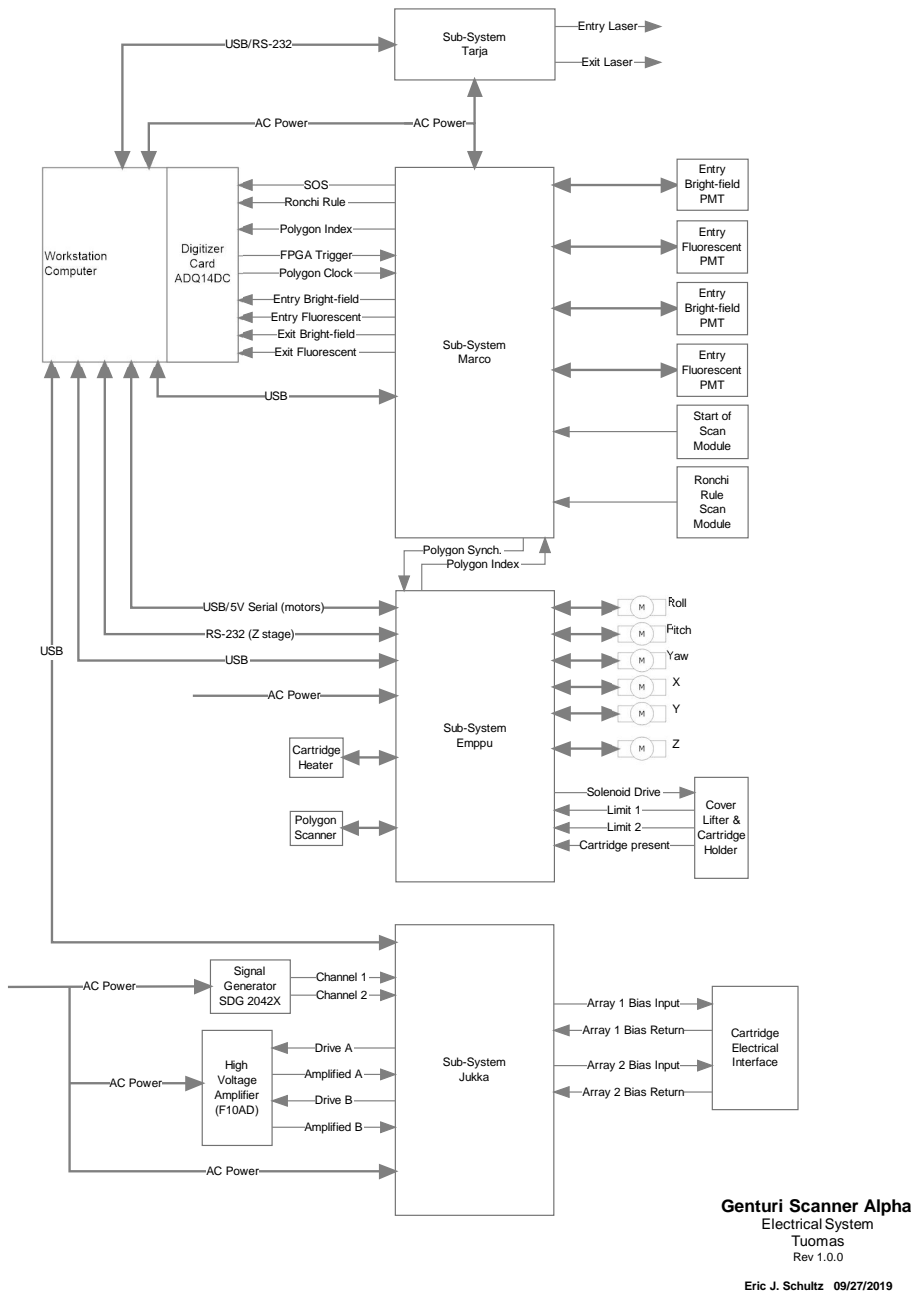
[picture p46: page 1]
Digitizer Card ADQ14DC; Sub-System Marco; Polygon Clock; FPGA Trigger; SOS; Ronchi Rule; Polygon Index; AC Power; Entry Bright-field PMT; Entry Fluorescent PMT; Start of Scan Module; Ronchi Rule Scan Module; Sub-System Tarja; Exit Laser; Entry Laser; USB/RS-232; USB; Sub-System Emppu; RS-232 (Z stage); Roll; Pitch; Yaw; Cartridge Heater; Polygon Scanner; Cover Lifter & Cartridge Holder; Solenoid Drive; Limit 1; Limit 2; Cartridge present; Sub-System Jukka; Signal Generator SDG 2042X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

Entry Bright-field
Entry Fluorescent
Exit Bright-field
Exit Fluorescent

Polygon Synch.

USB/5V Serial (motors)

Array 1 Bias Input

Array 1 Bias Return

Array 2 Bias Input

Array 2 Bias Return

Genturi Scanner Alpha
