Genturi/NewAlphaElectrical/SystemDesign/AlphaSystem(Tuomas)_R1p1p0_101619.pdf

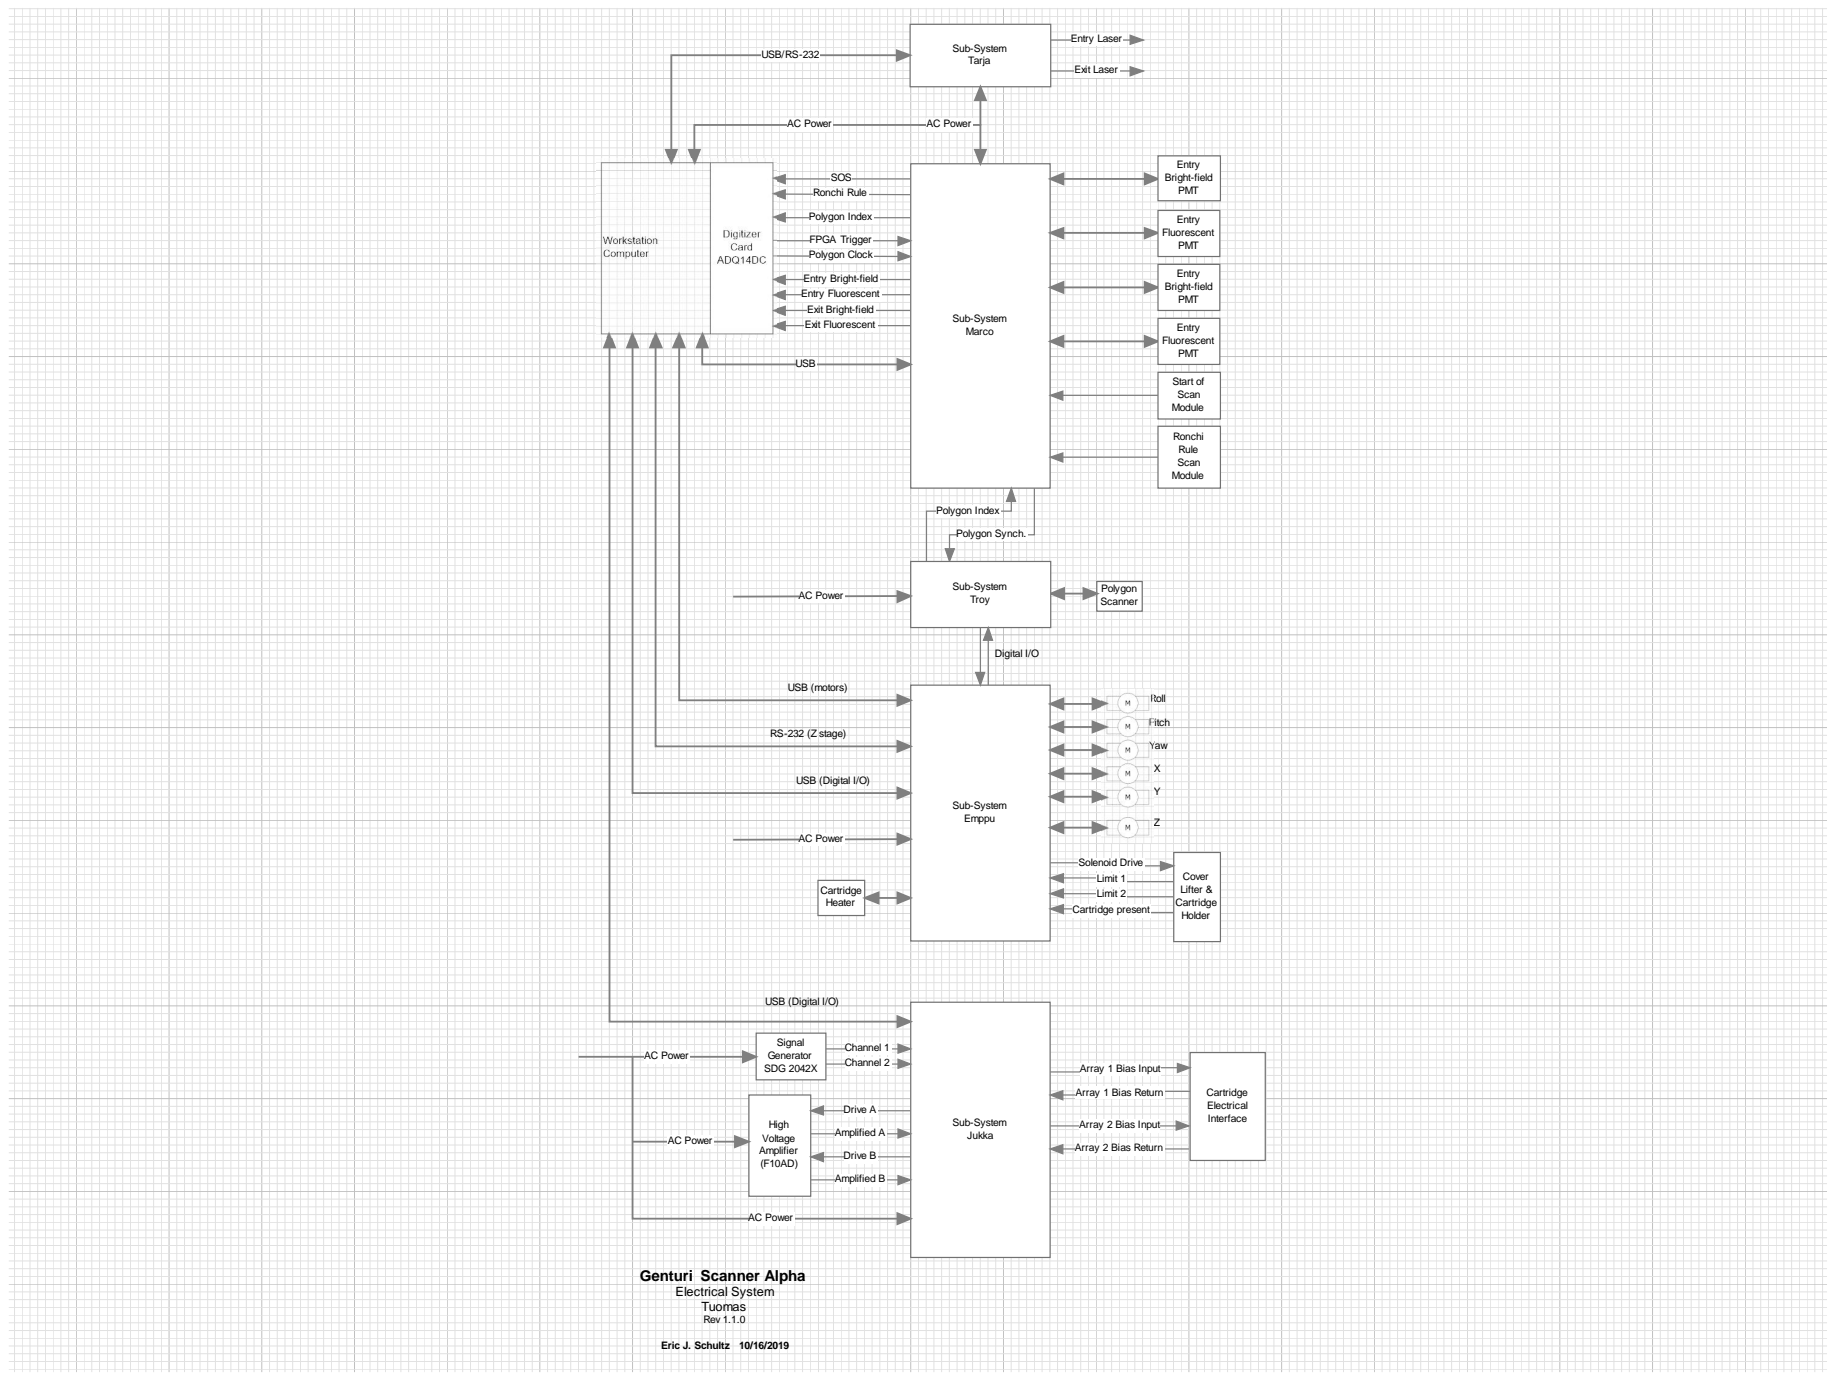
[picture p47: page 1]
Digitizer Card ADQ14DC; Sub-System Marco; Polygon Clock; FPGA; Trigger; SOS; Ronchi; Rule; Polygon Index; Entry; Bright-field; Fluorescent; AC Power; Entry Bright-field PMT; Entry Fluorescent PMT; Start of Scan Module; Ronchi Rule Scan Module; Sub-System Tarja; Exit Laser; Laser; USB/RS-232; USB; Sub-System Emppu; Polygon Synch.; Roll; Pitch; Yaw; Cartridge Heater; Polygon Scanner; Cover; Lifter; Cartridge Holder; Solenoid Drive; Limit 1; Limit 2; Cartridge present; Sub-System Jukka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

Exit Bright-field
Exit Fluorescent

Troy AC Power
