Genturi/NewAlphaElectrical/Schematic/30-0008(Amaranth)_R1_020720_0950.pdf

# Power Input

# Power Supply Diagnostic

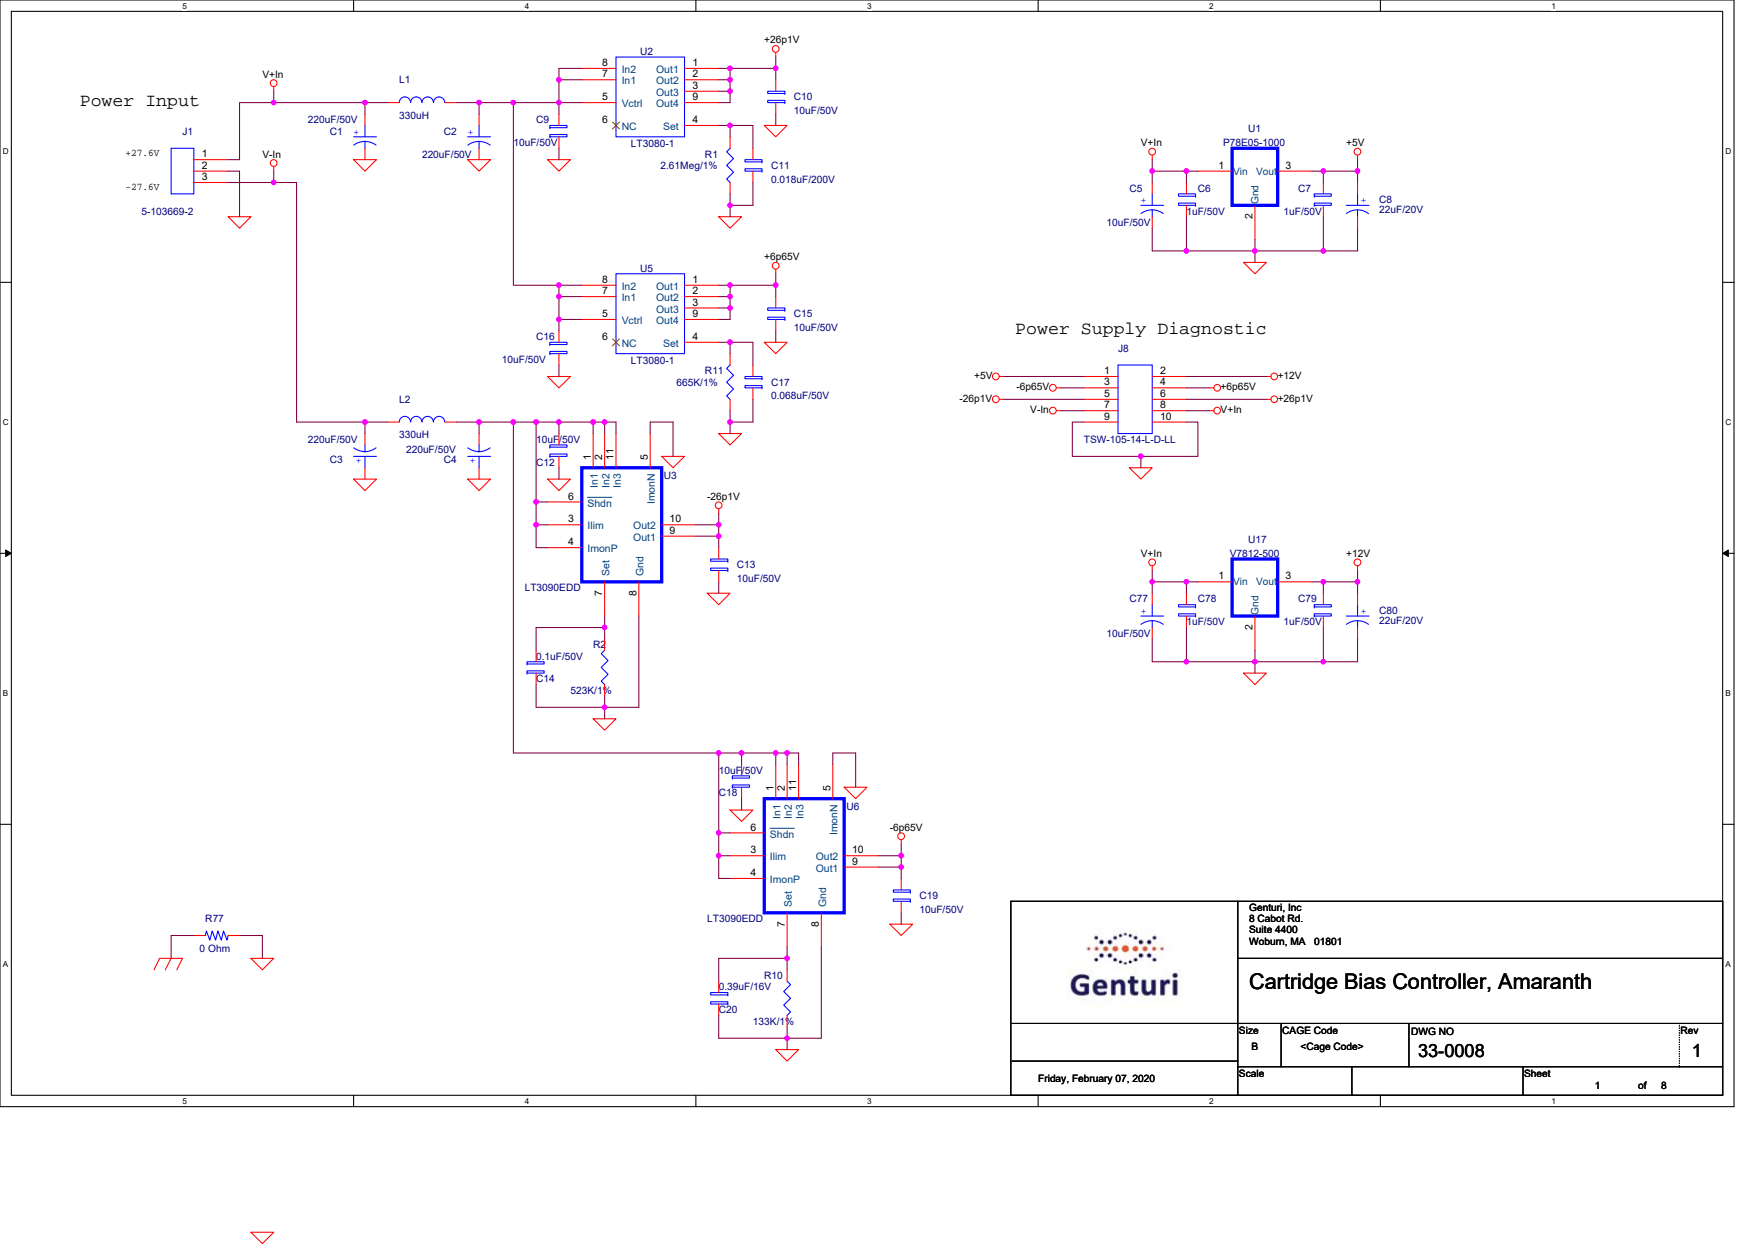
[picture p48: page 1]

Genturi, Inc
8 Cabot Rd.
Suite 4400
Woburn, MA 01801
Cartridge Bias Controller, Amaranth

# Cartridge Interface Port

# Digital I/O

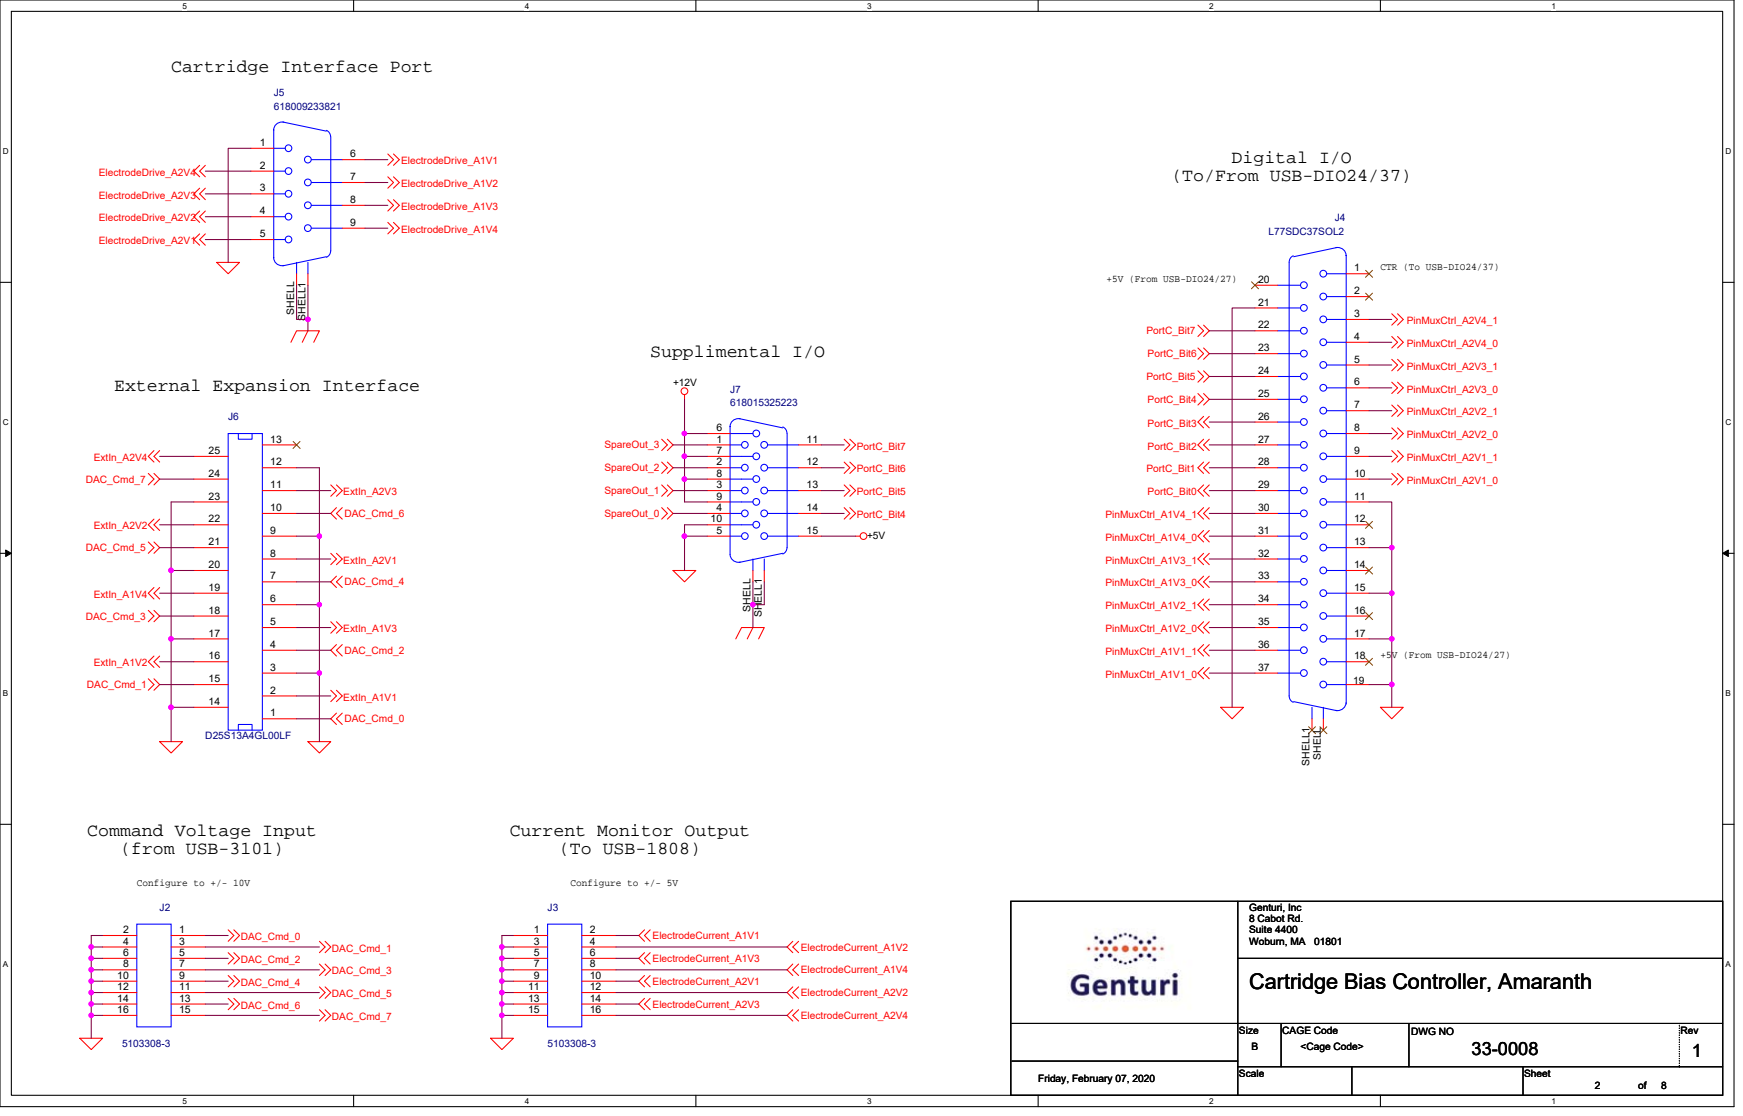
[picture p49: page 2]
Configure to +/- 10V; Configure to +/- 5V; +5V (From USB-DIO24/27); Supplimental I/O; ElectrodeDrive_A2V4; ElectrodeDrive_A2V3; ElectrodeDrive_A2V2; ElectrodeDrive_A2V1; ElectrodeDrive_A1V1; ElectrodeDrive_A1V2; ElectrodeDrive_A1V3; ElectrodeDrive_A1V4; DAC_Cmd_0; ElectrodeCurrent_A1V1; DAC_Cmd_1; ElectrodeCurrent_A1V2; DAC_Cmd_2; ElectrodeCurrent_A1V3; DAC_Cmd_3; ElectrodeCurrent_A1V4; DAC_Cmd_4; ElectrodeCurrent_A2V1; DAC_Cmd_5; ElectrodeCurrent_A2V2; DAC_Cmd_6; ElectrodeCurrent_A2V3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

(To/From USB-DIO24/37)

CTR (To USB-DIO24/37)

External Expansion Interface

Command Voltage Input
(from USB-3101)

Current Monitor Output
(To USB-1808)

Genturi, Inc
8 Cabot Rd.
Suite 4400
Woburn, MA 01801
Cartridge Bias Controller, Amaranth

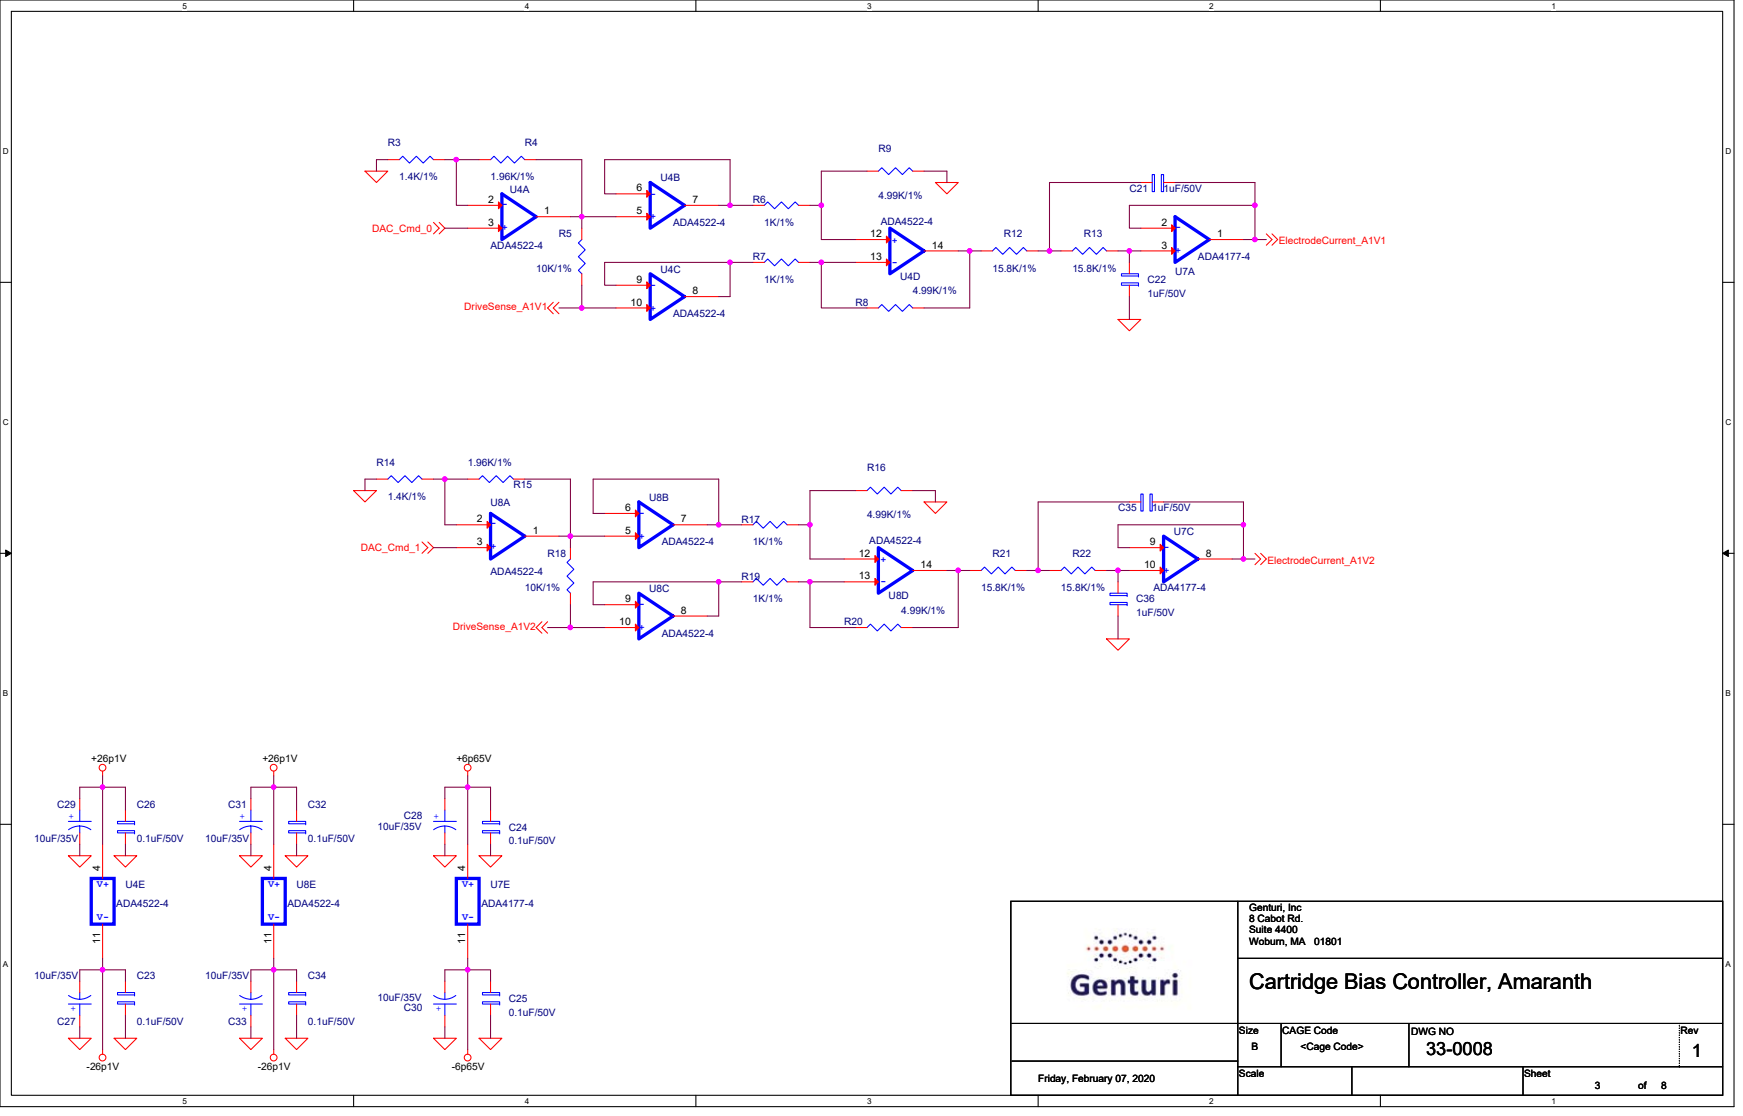
[picture p50: page 3]

Genturi, Inc
8 Cabot Rd.
Suite 4400
Woburn, MA 01801
Cartridge Bias Controller, Amaranth

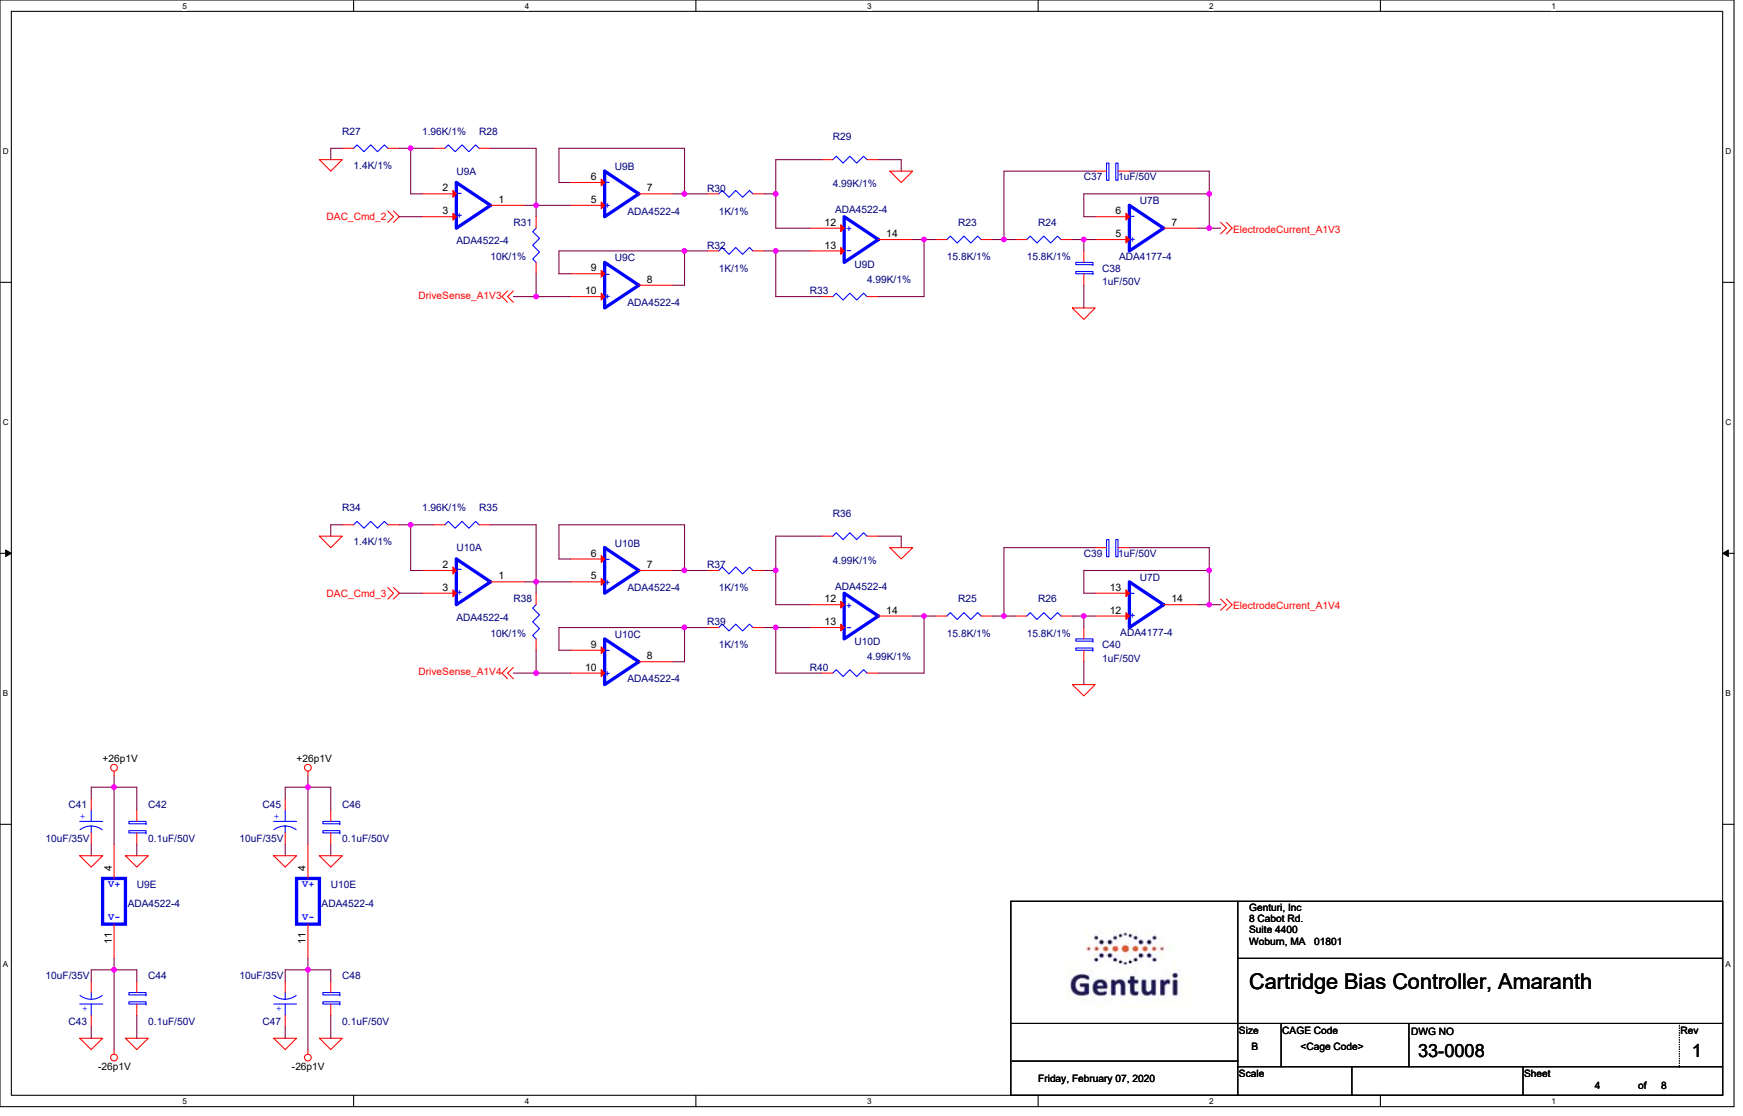
[picture p51: page 4]

Genturi, Inc
8 Cabot Rd.
Suite 4400
Woburn, MA 01801
Cartridge Bias Controller, Amaranth

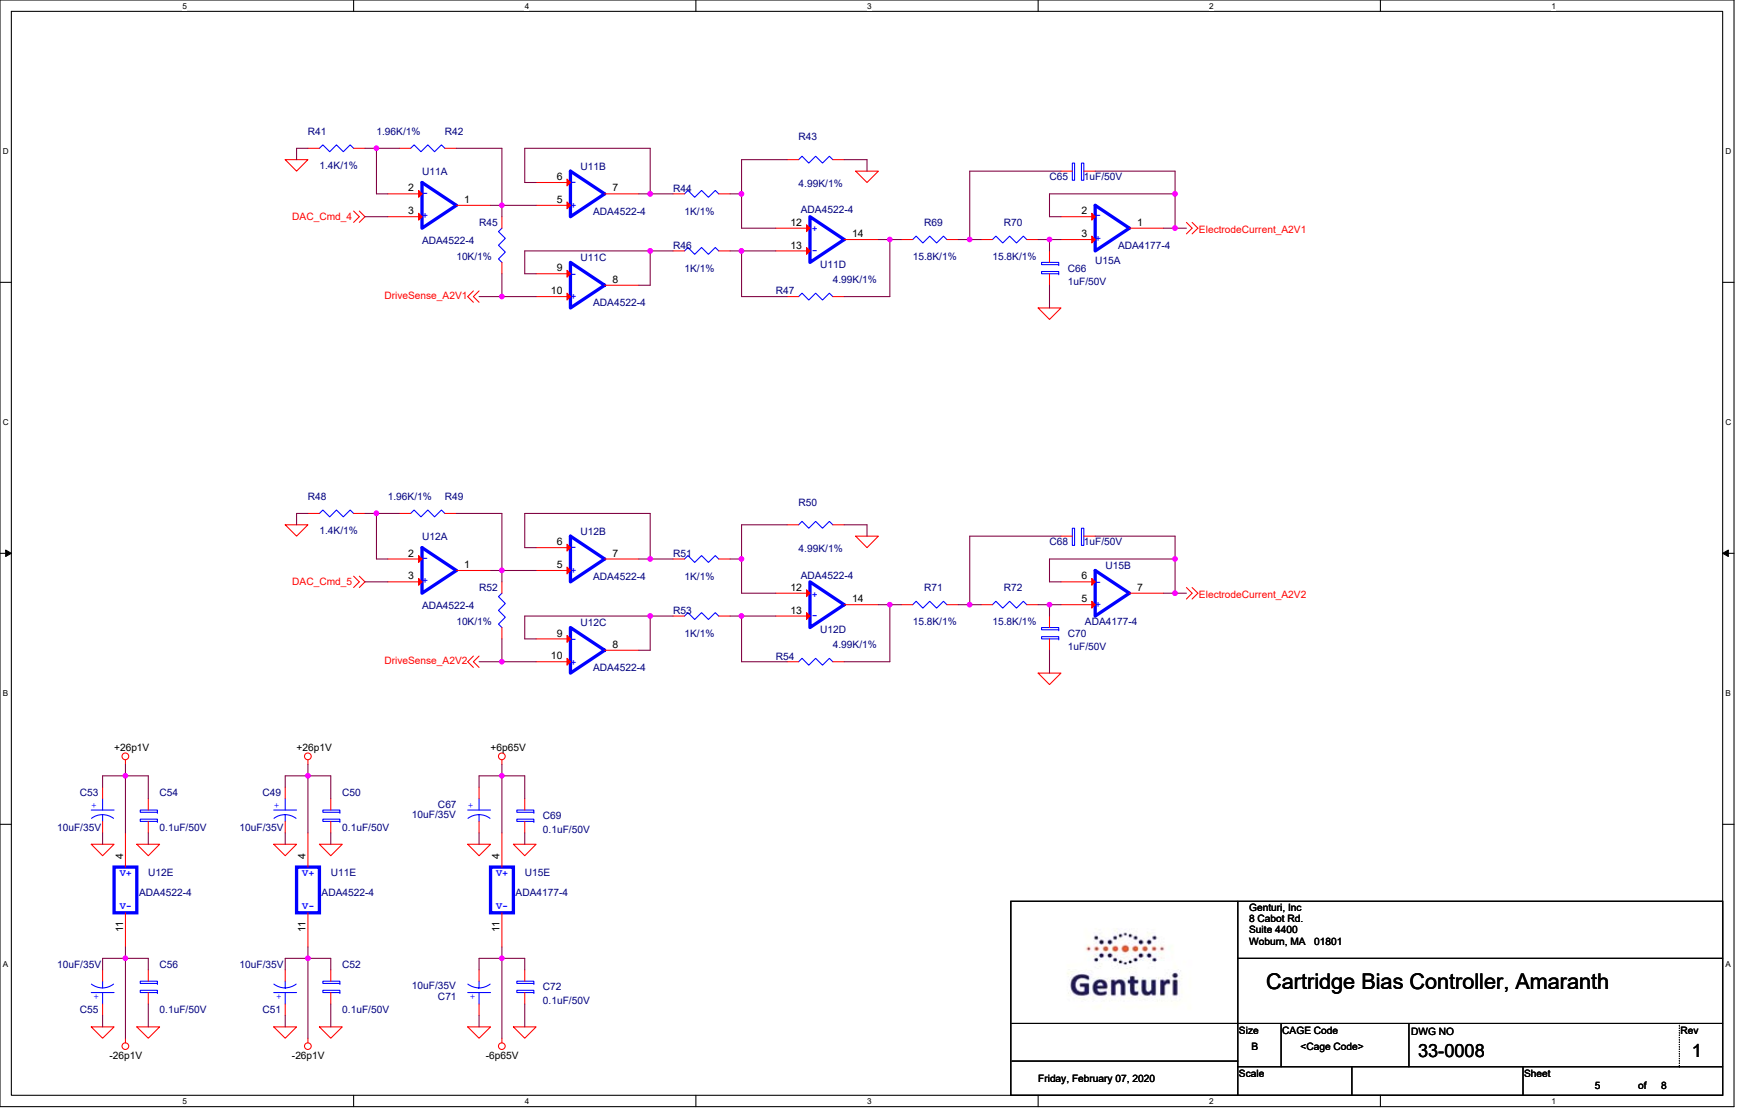
[picture p52: page 5]

Genturi, Inc
8 Cabot Rd.
Suite 4400
Woburn, MA 01801
Cartridge Bias Controller, Amaranth

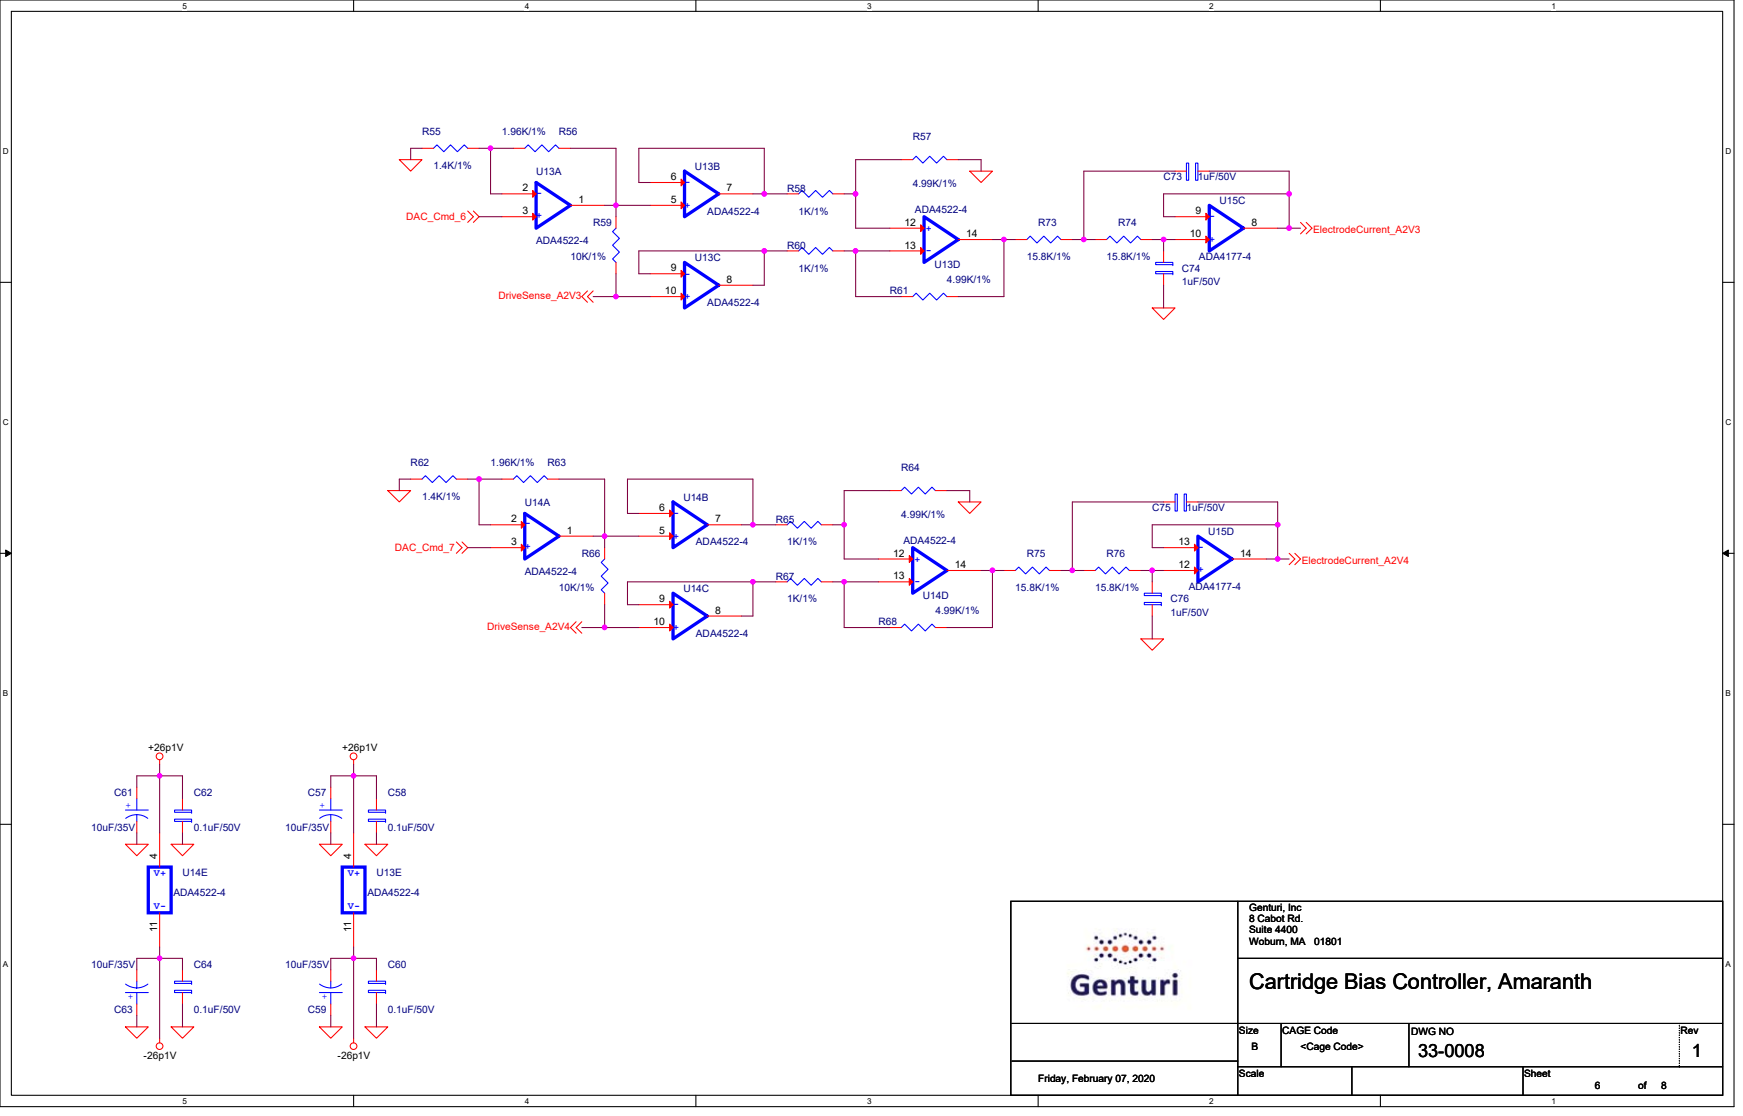
[picture p53: page 6]

Genturi, Inc
8 Cabot Rd.
Suite 4400
Woburn, MA 01801
Cartridge Bias Controller, Amaranth

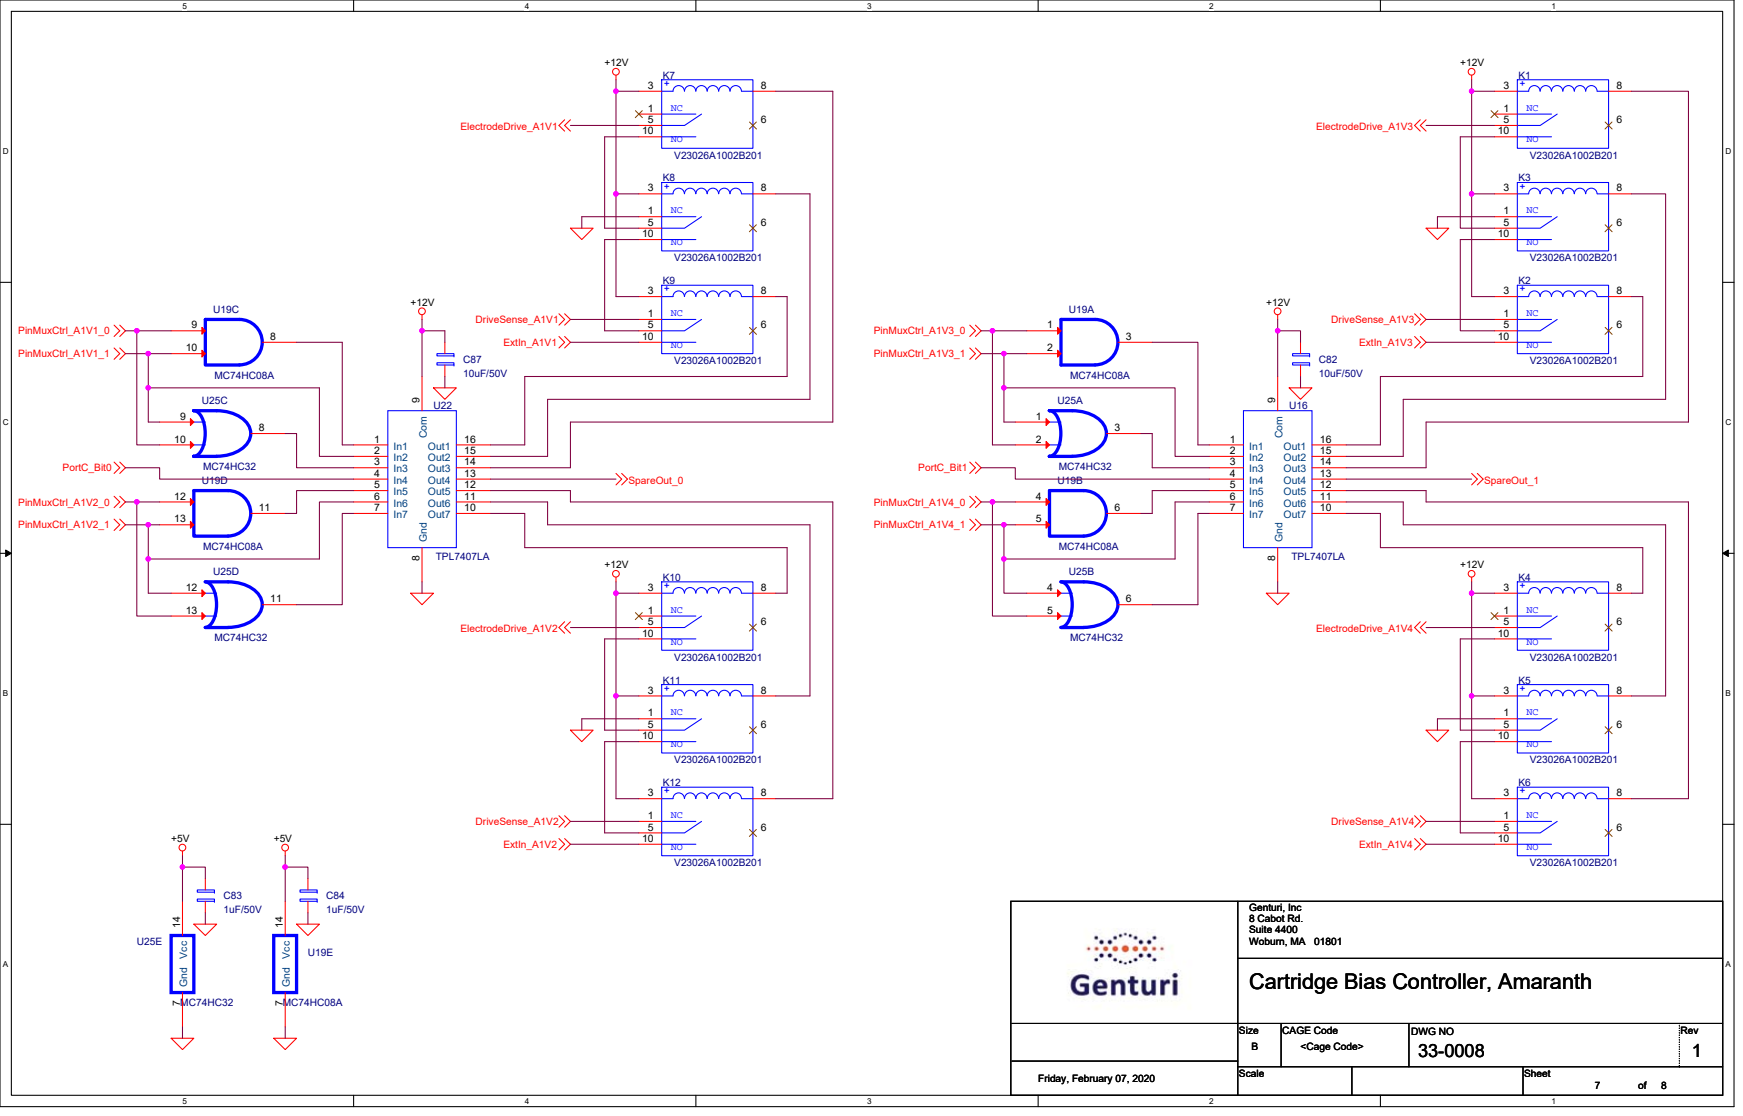
[picture p54: page 7]

Genturi, Inc
8 Cabot Rd.
Suite 4400
Woburn, MA 01801
Cartridge Bias Controller, Amaranth

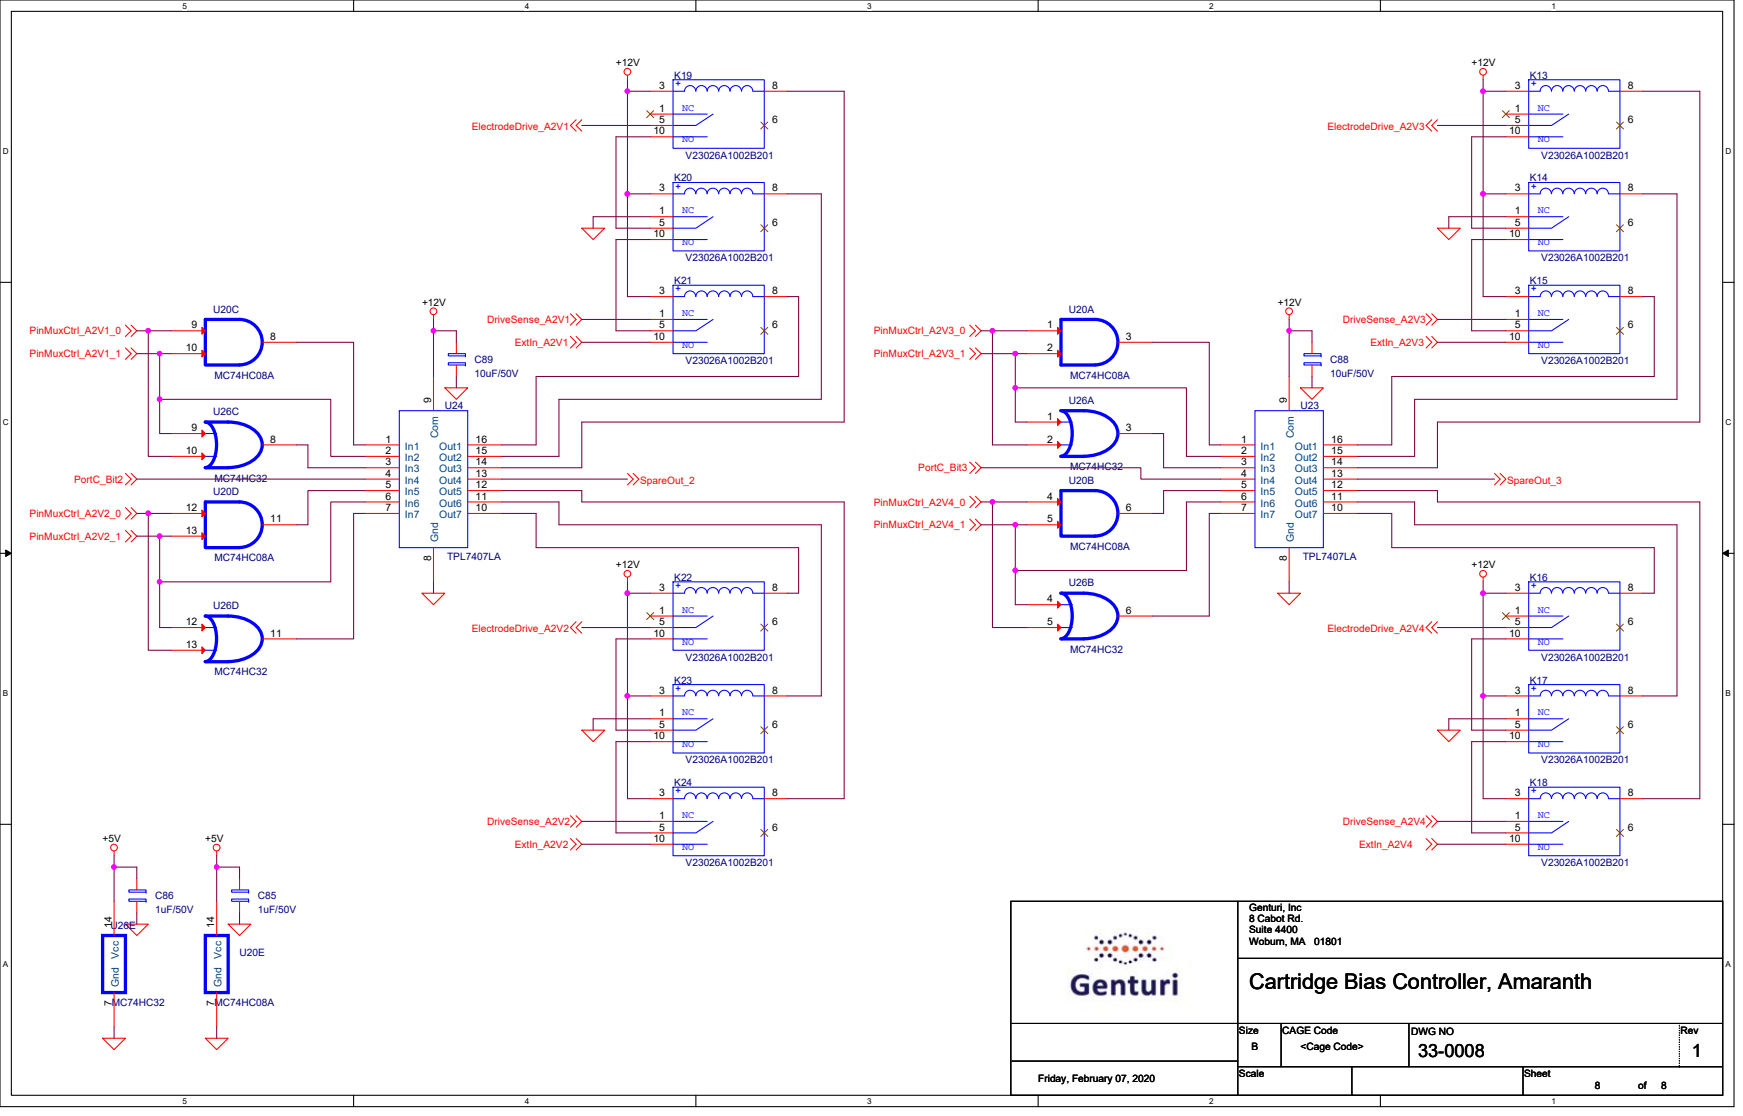
[picture p55: page 8]

Genturi, Inc
8 Cabot Rd.
Suite 4400
Woburn, MA 01801
Cartridge Bias Controller, Amaranth
