Genturi/NewAlphaElectrical/MotorInterface(Riddler 30-0004)/Schematic/motorinterfaceboard(riddler).pdf

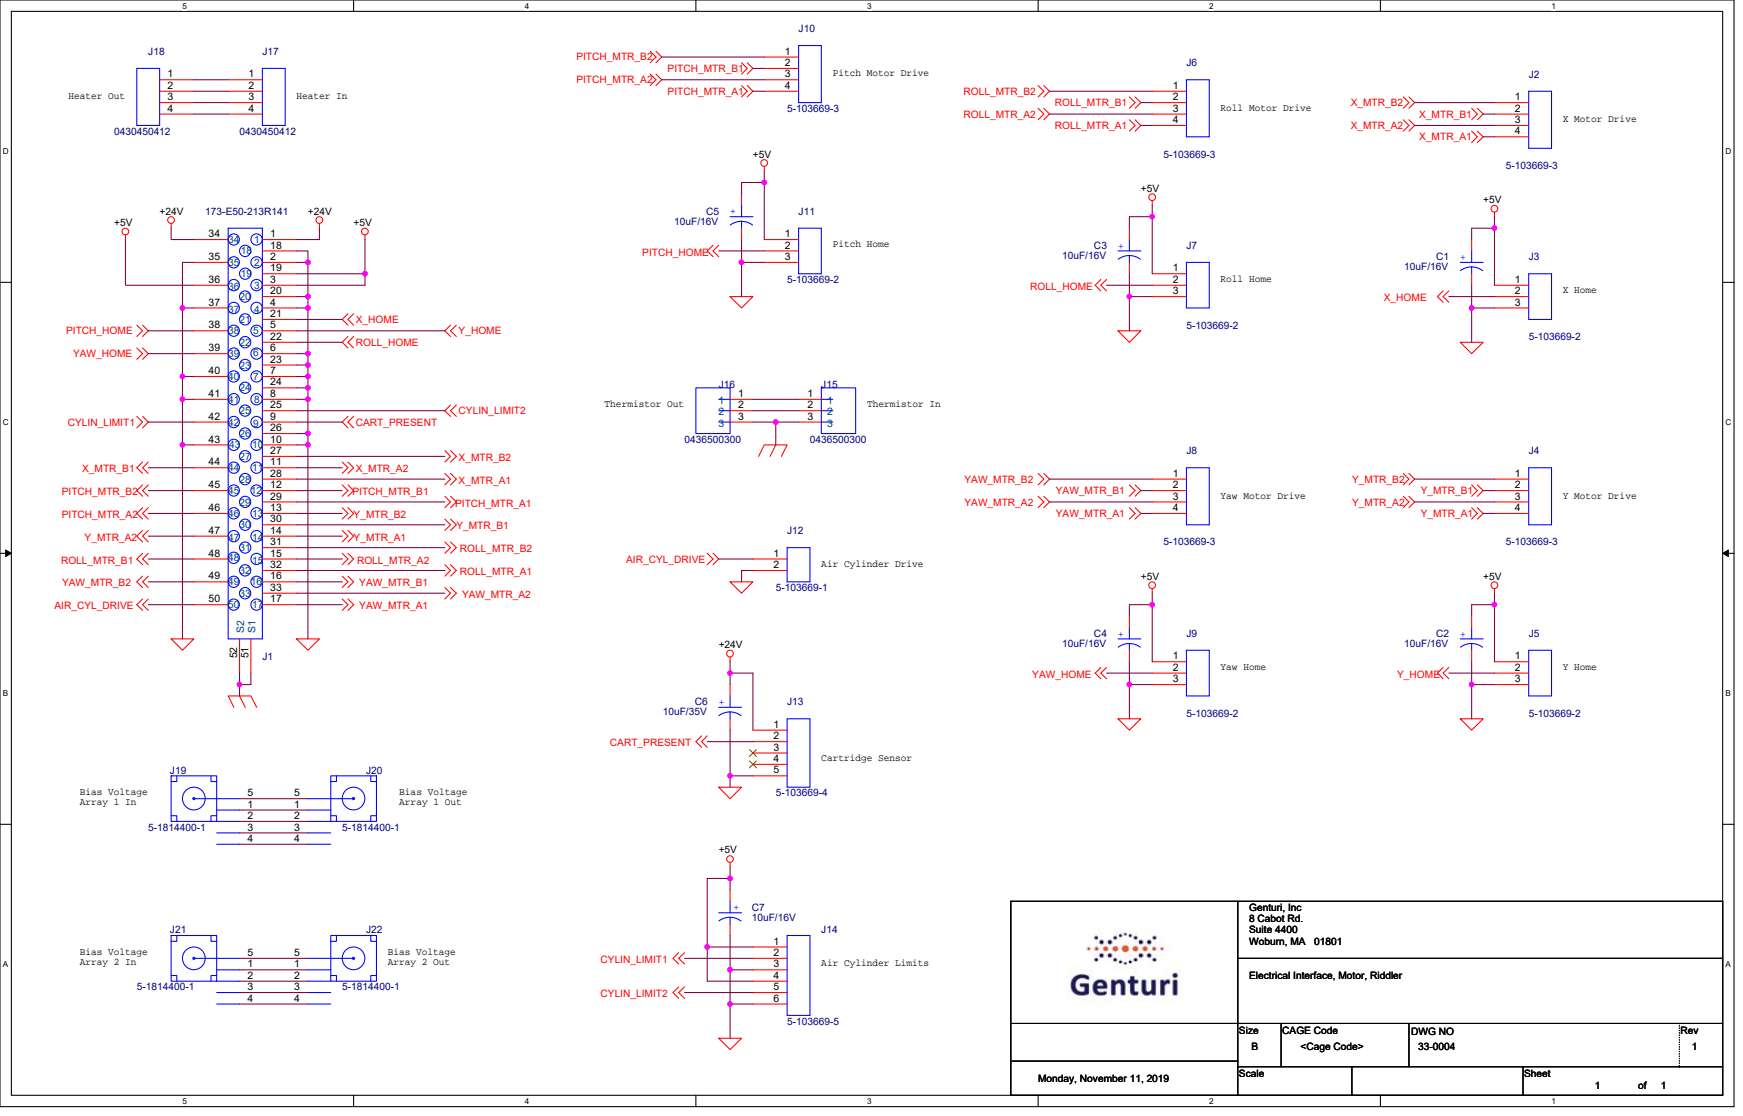
[picture p56: page 1]

Electrical Interface, Motor, Riddler
