Genturi/NewAlphaElectrical/Schematic/PartSpecs/D25S13A4GL00LF.pdf

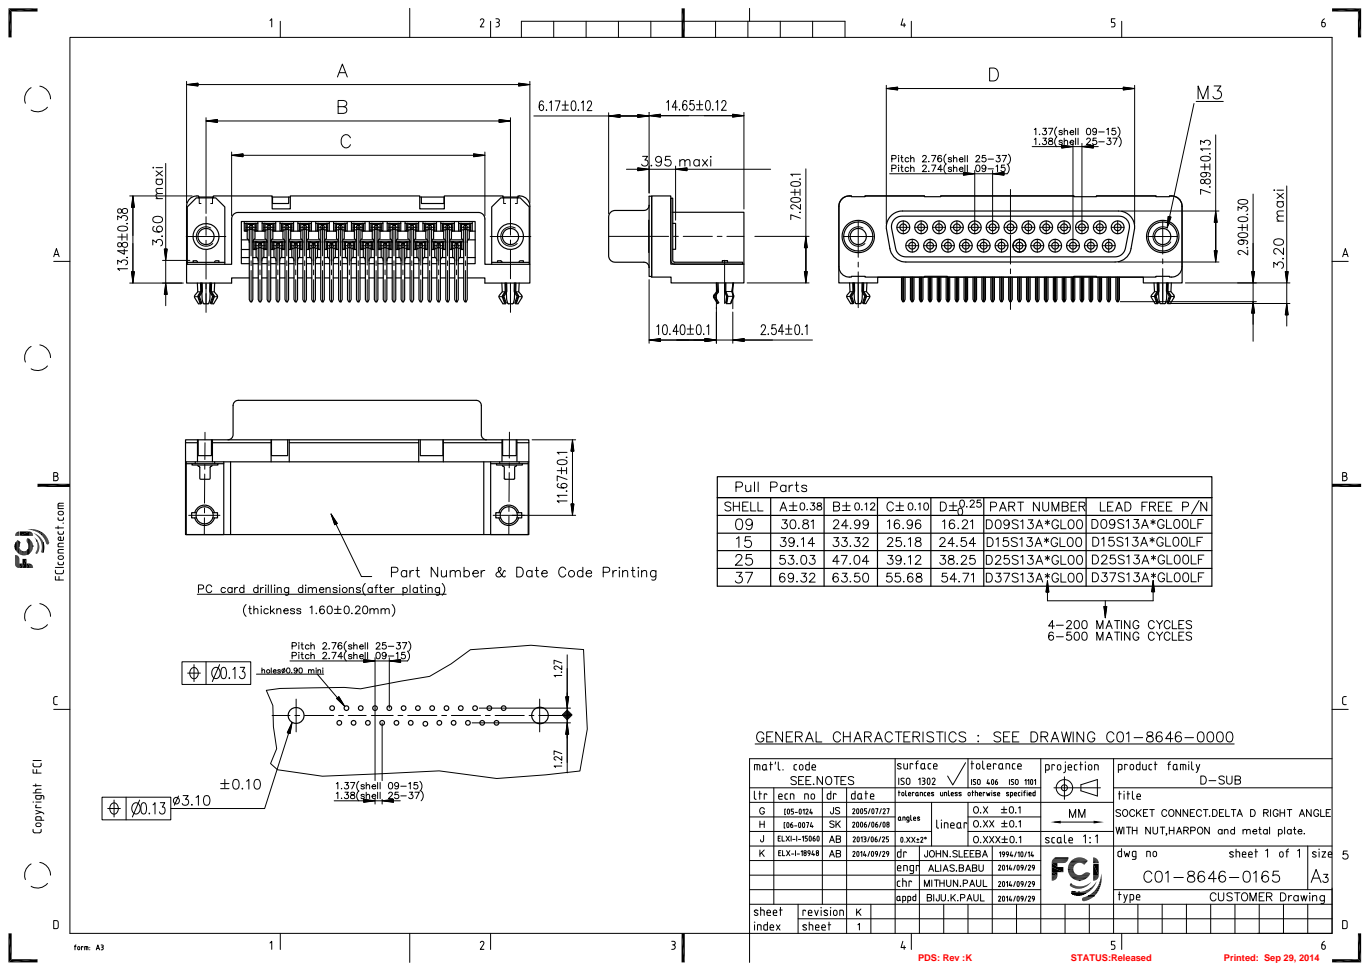
[picture p57: page 1]
PDS: Rev :K; STATUS:Released; Printed: Sep 29, 2014
