Genturi/NewAlphaElectrical/SystemDesign/AlphaSystem(Tuomas)_R1p2p0_102119.pdf

# Digitizer Card

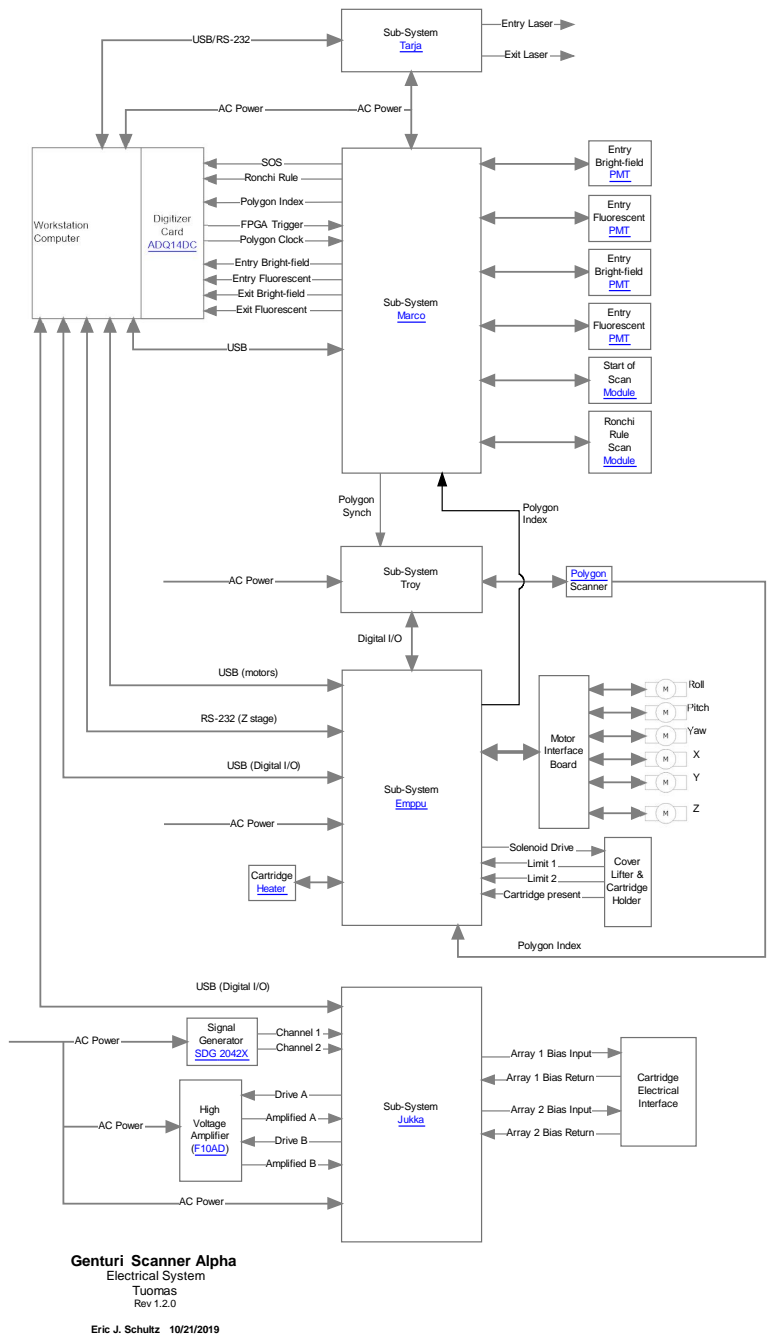
[picture p58: page 1]
c:\f0000000000000000000000000000.pdf c:\f0000000000000000000000000000.pdf c:\f0000000000000000000000000000.pdf c:\f0000000000000000000000000000.pdf; c:\f01010101010101.pdf c:\f01010101010101.pdf c:\f01010101010101.pdf c:\f01010101010101.pdf; c:\f020202020.pdf c:\f020202020.pdf c:\f020202020.pdf c:\f020202020.pdf; c:\f0303030303030303030303030303.pdf c:\f0303030303030303030303030303.pdf c:\f0303030303030303030303030303.pdf c:\f0303030303030303030303030303.pdf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

https://www.spdevices.com/products/hardware/14-bit-digitizers/adq14
ADQ14DC (https://www.spdevices.com/products/hardware/14-bit-digitizers/adq14)

Entry Bright-field
Entry Fluorescent
Exit Bright-field
Exit Fluorescent

Troy AC Power

Solenoid Drive

Array 1 Bias Input

Array 1 Bias Return

Array 2 Bias Input

Array 2 Bias Return

Genturi Scanner Alpha
