Genturi/NewAlphaElectrical/Schematic/GHOST-RIVER.pdf

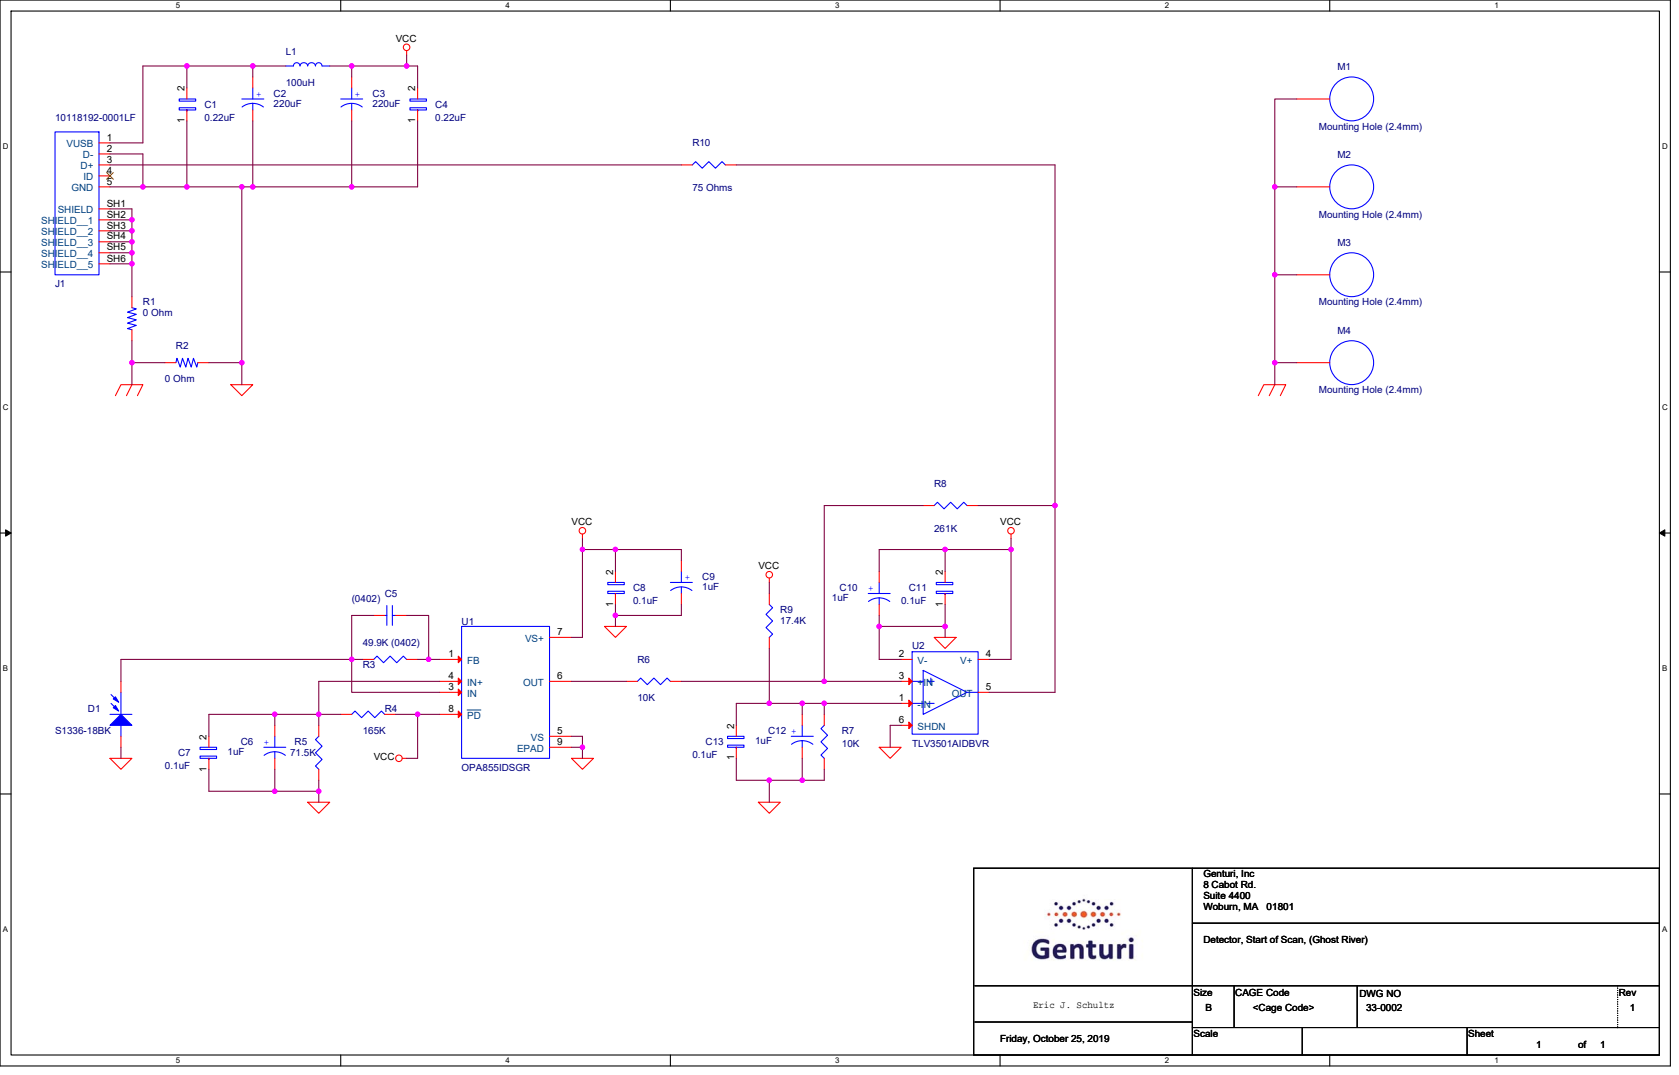
[picture p59: page 1]

Detector, Start of Scan, (Ghost River)
