Genturi/NewAlphaElectrical/TroyInterface(Scaretale 30-0007)/Schematic/33-0007(scaretale).pdf

# To BMC-7

J5

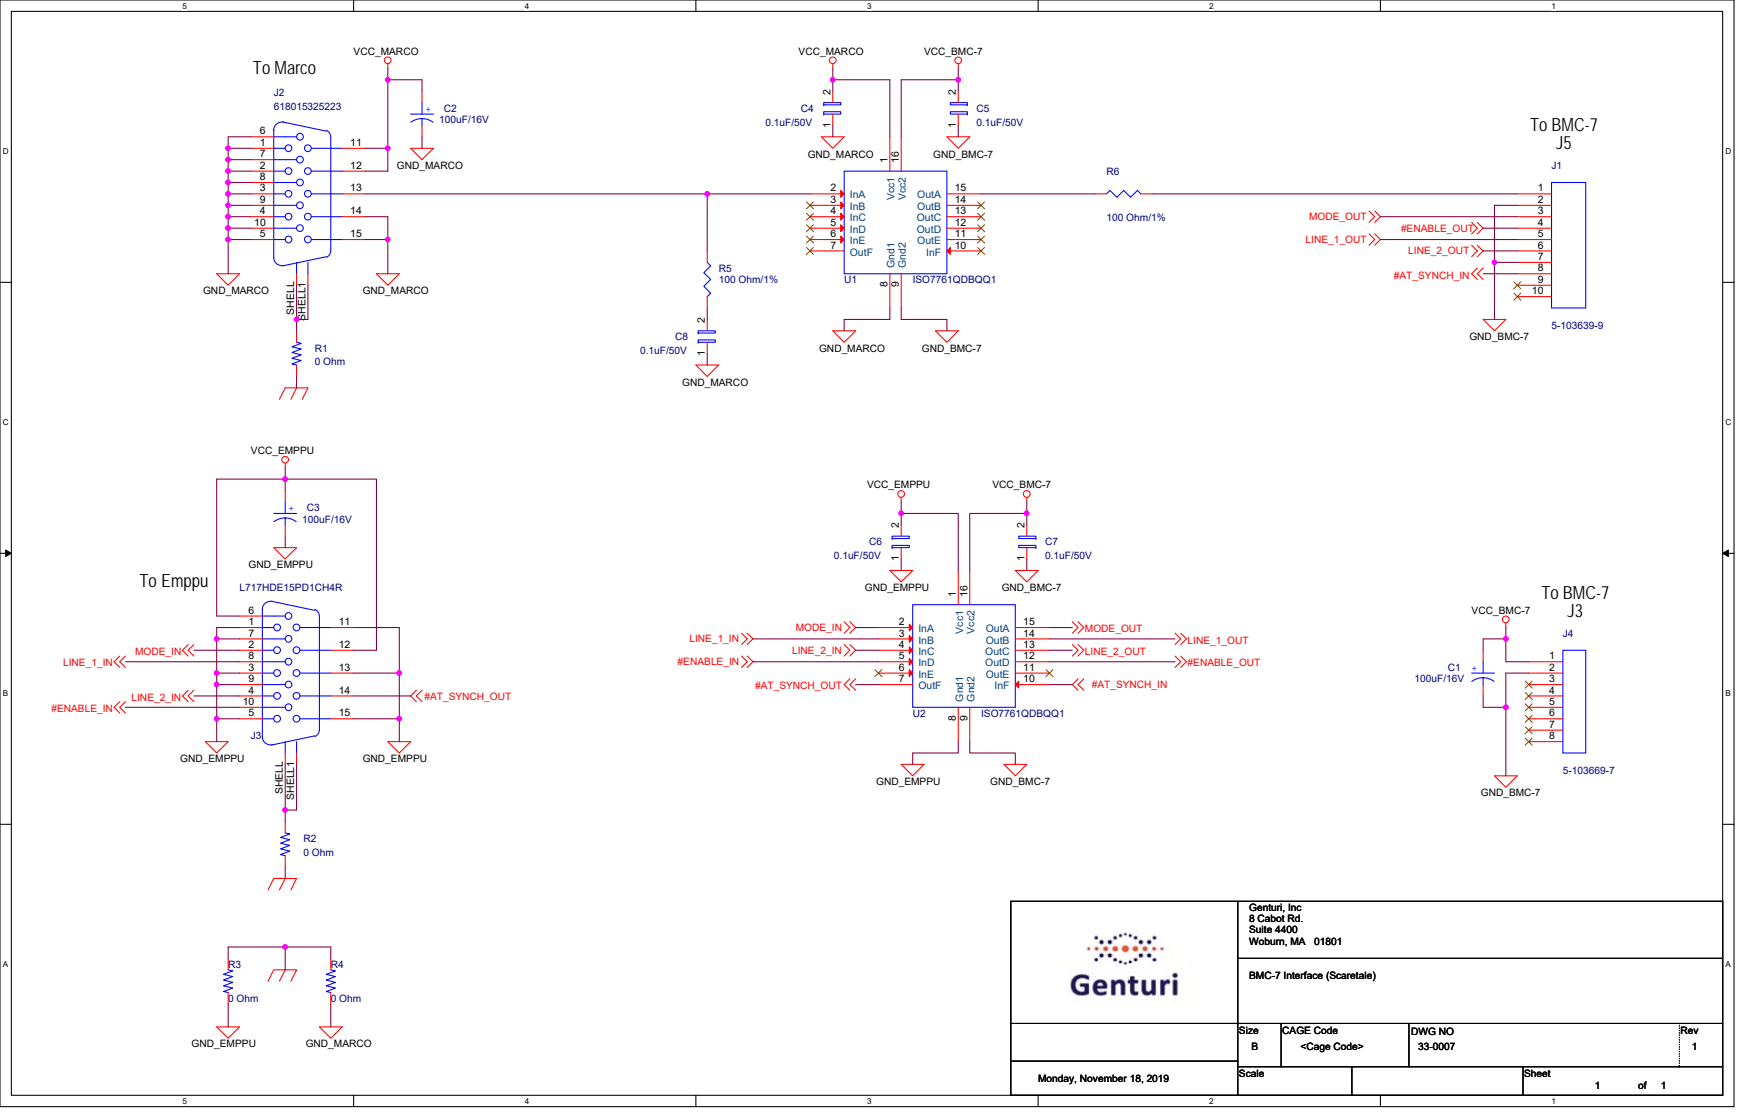
[picture p60: page 1]
