Genturi/NewAlphaElectrical/MotorInterface(Riddler 30-0004)/ConnectedComponents/Molex_0436500315.pdf

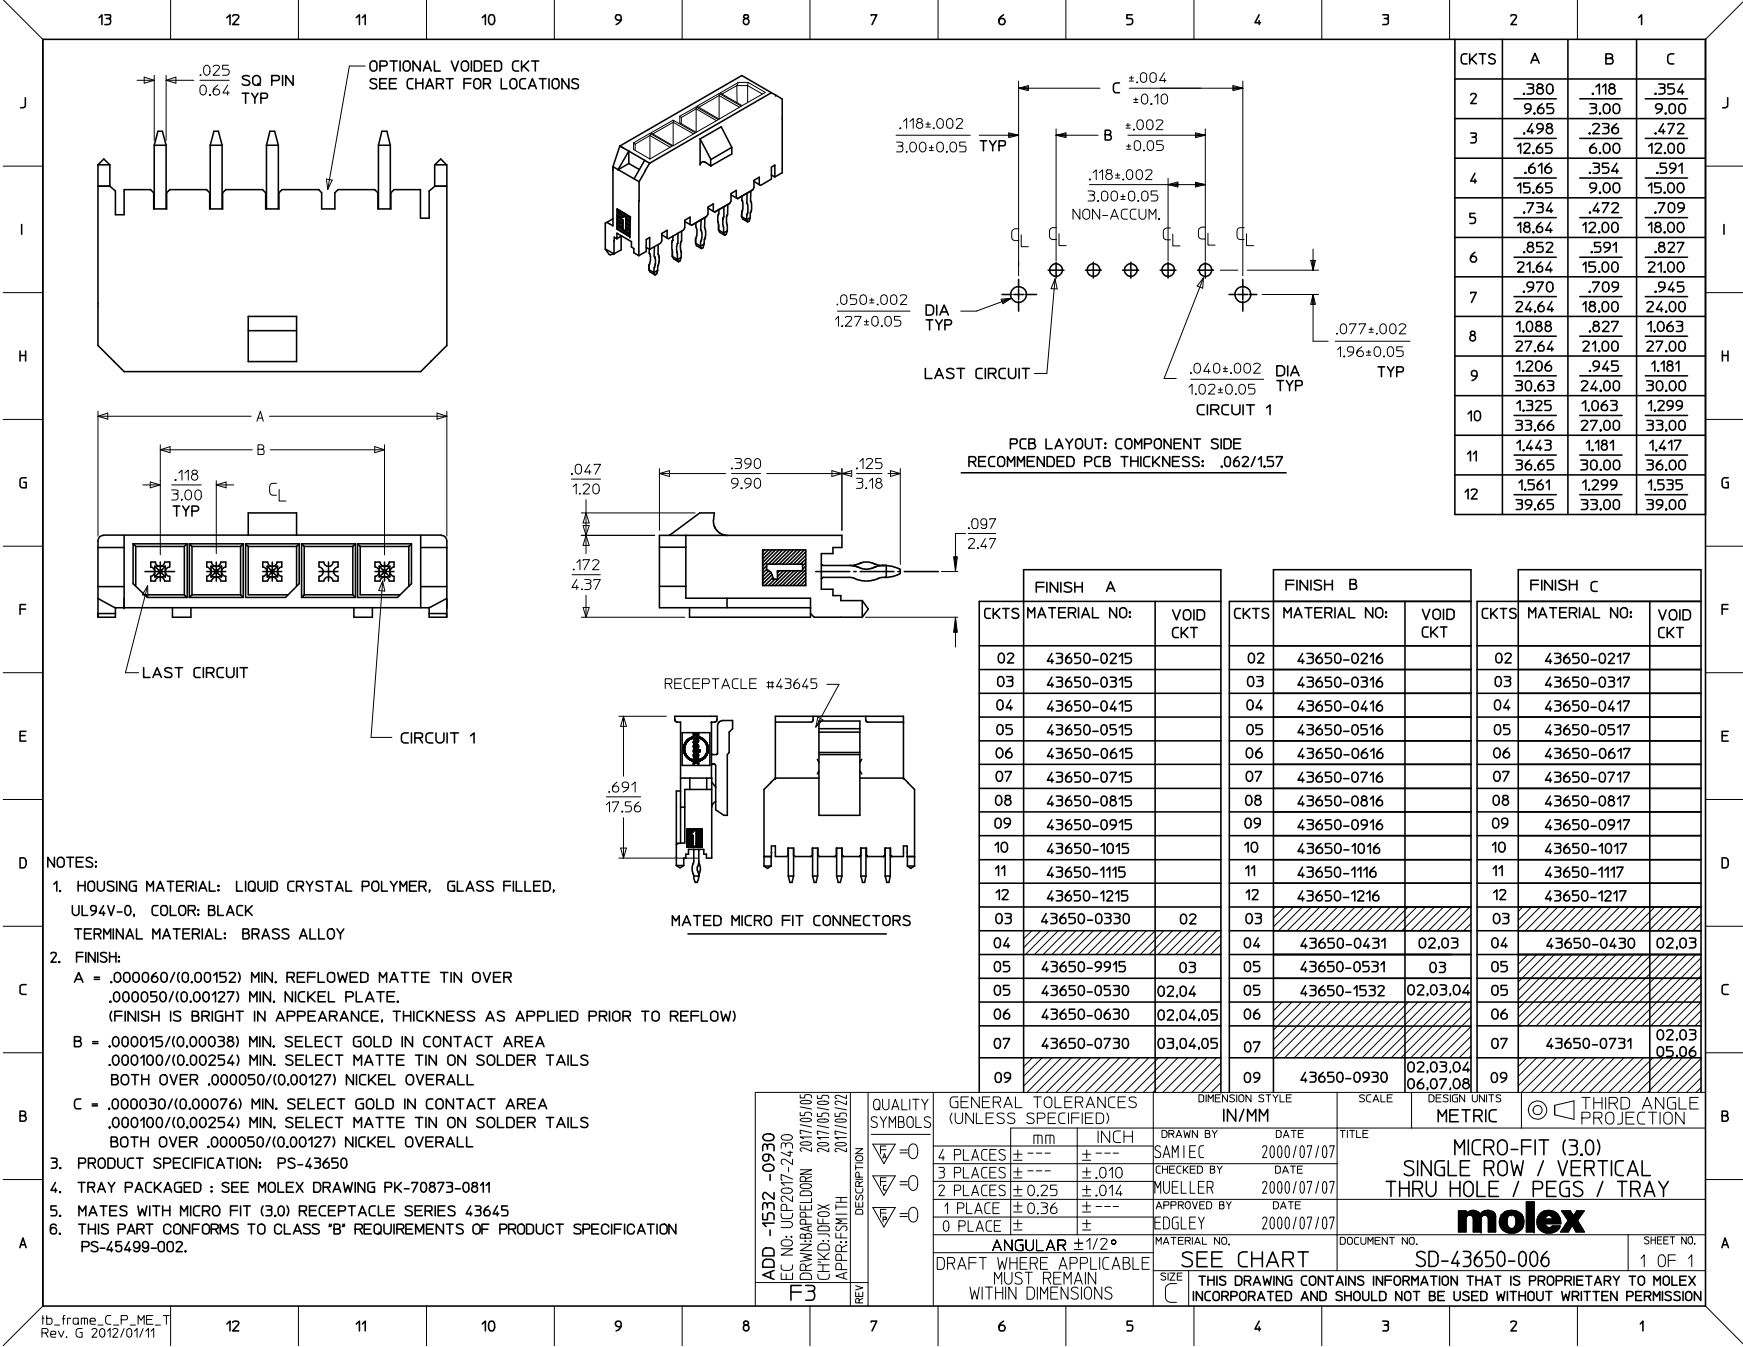
[picture p61: page 1]
