Genturi/NewAlphaElectrical/MotorInterface(Riddler 30-0004)/SpecSheets/NorComp_173-E50-213R141.pdf

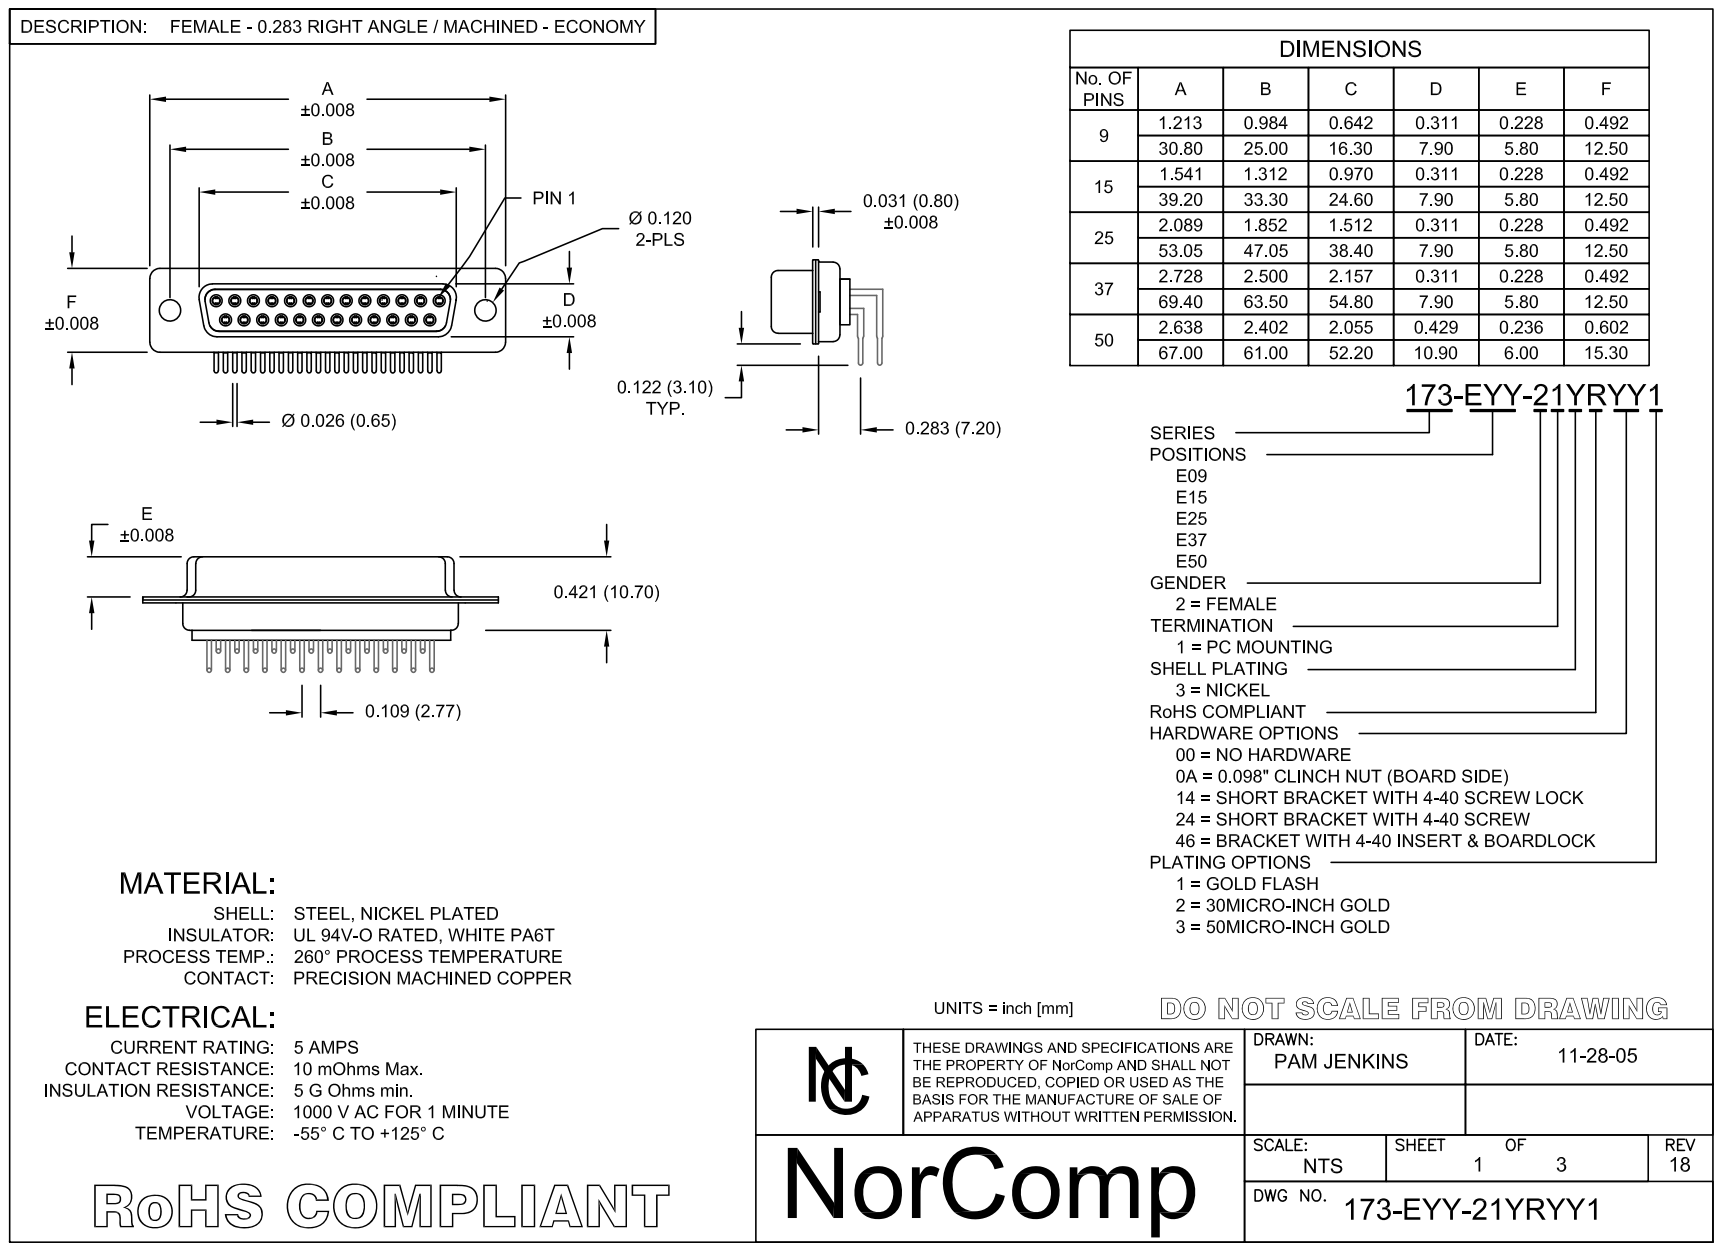
[picture p62: page 1]

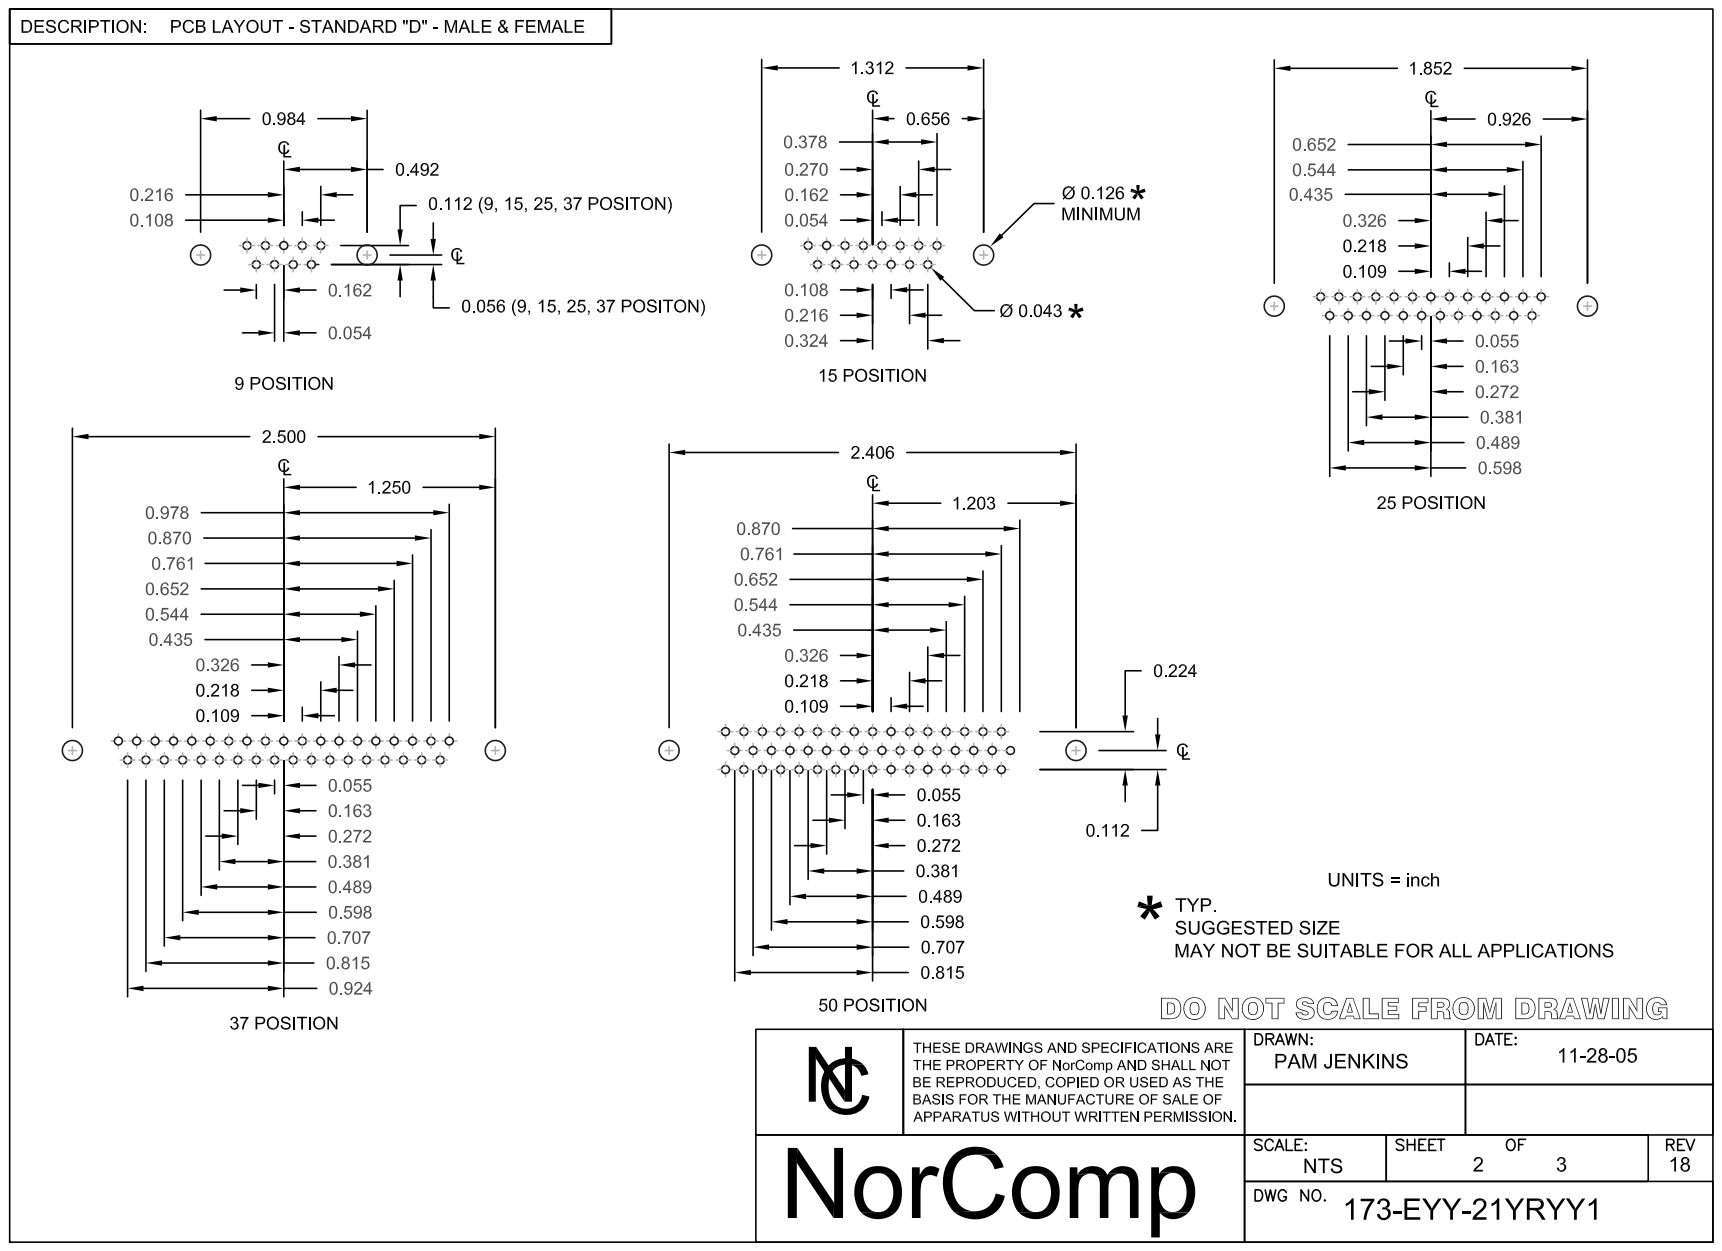
[picture p63: page 2]

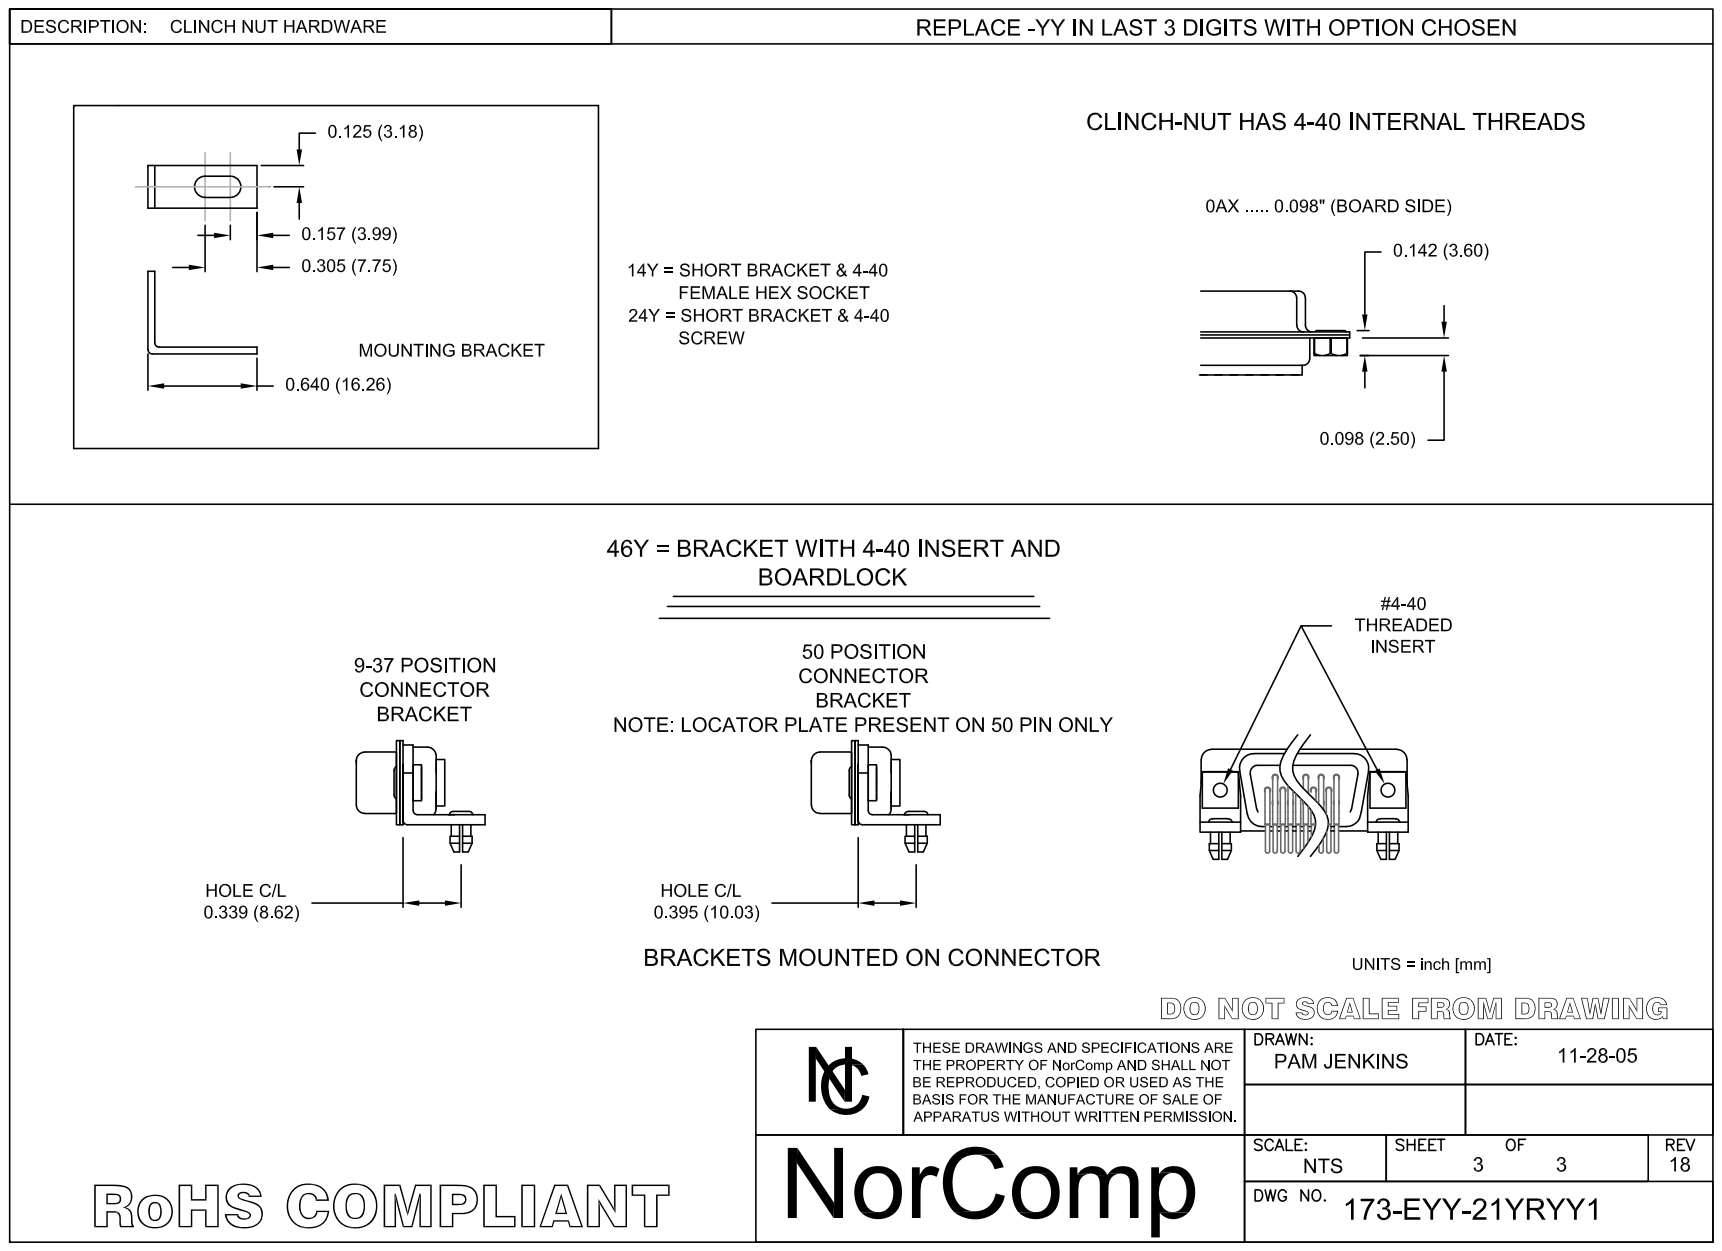
[picture p64: page 3]
