Genturi/NewAlphaElectrical/MarcoInterface(Arabesque 30-0003)/Schematic/arabesque.pdf

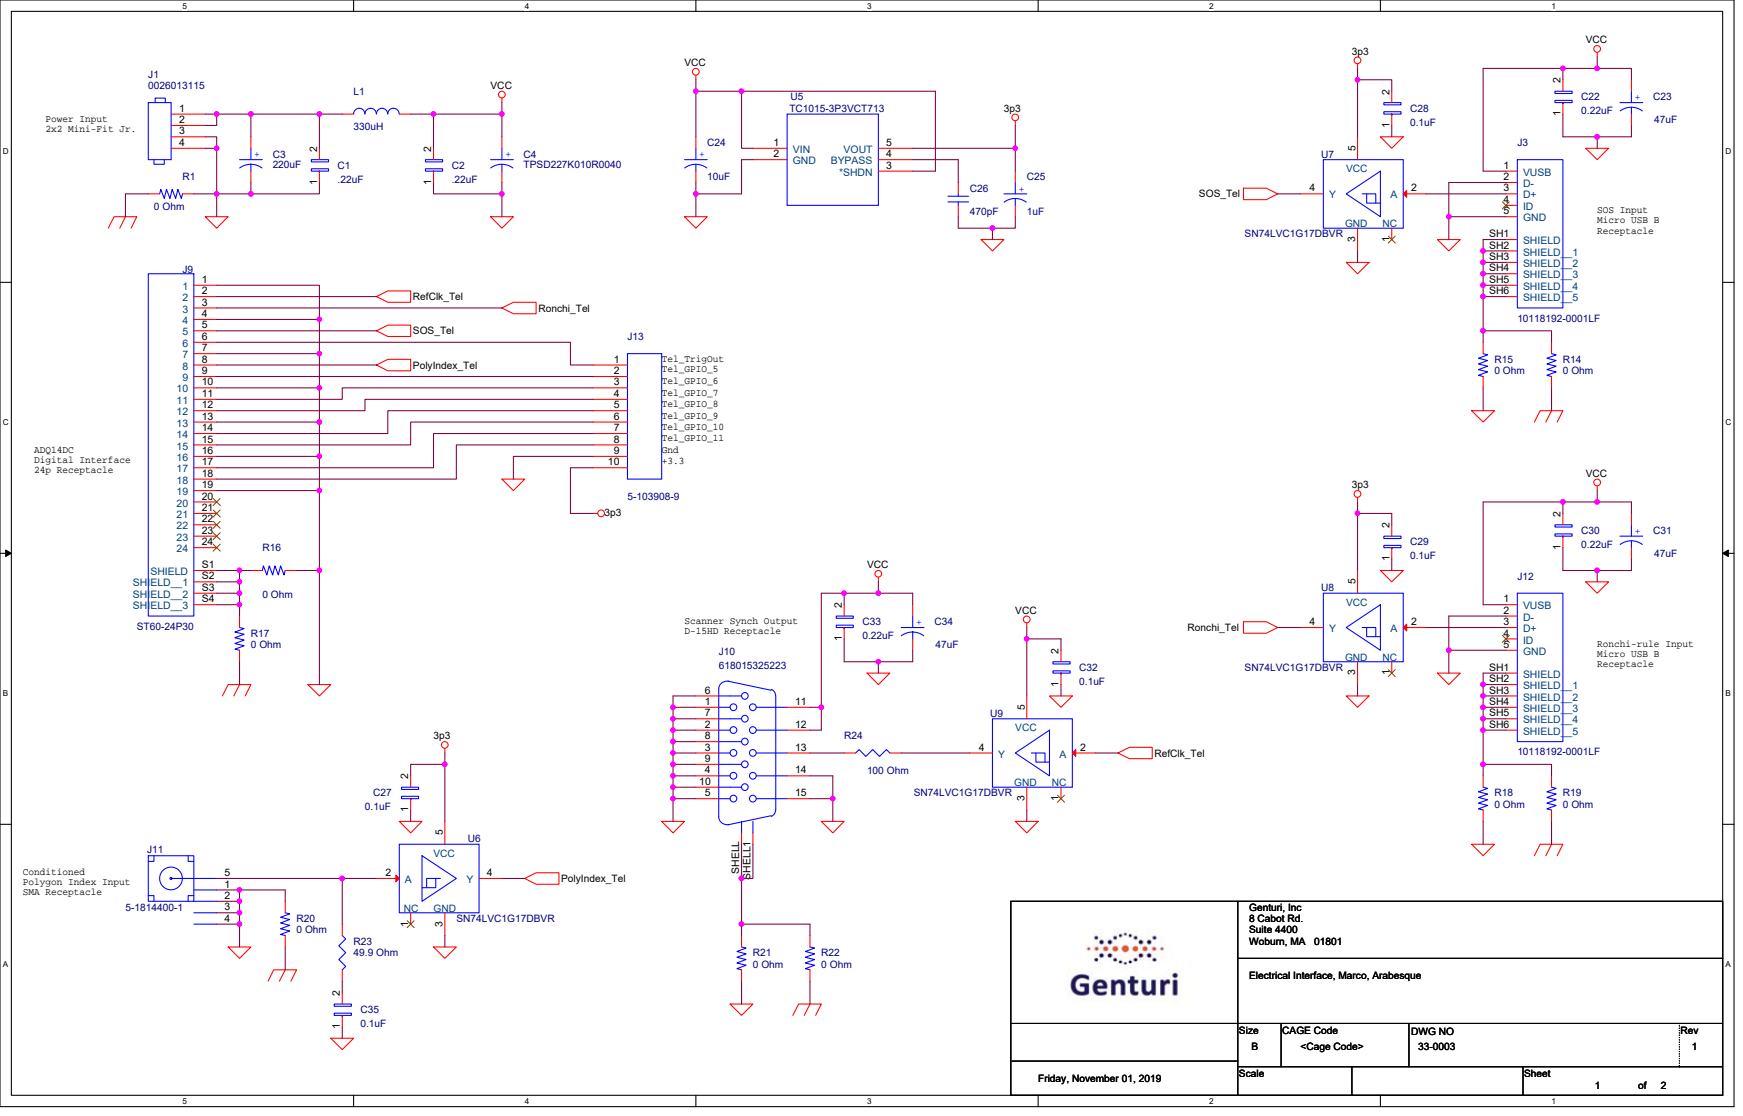
[picture p65: page 1]

Electrical Interface, Marco, Arabesque

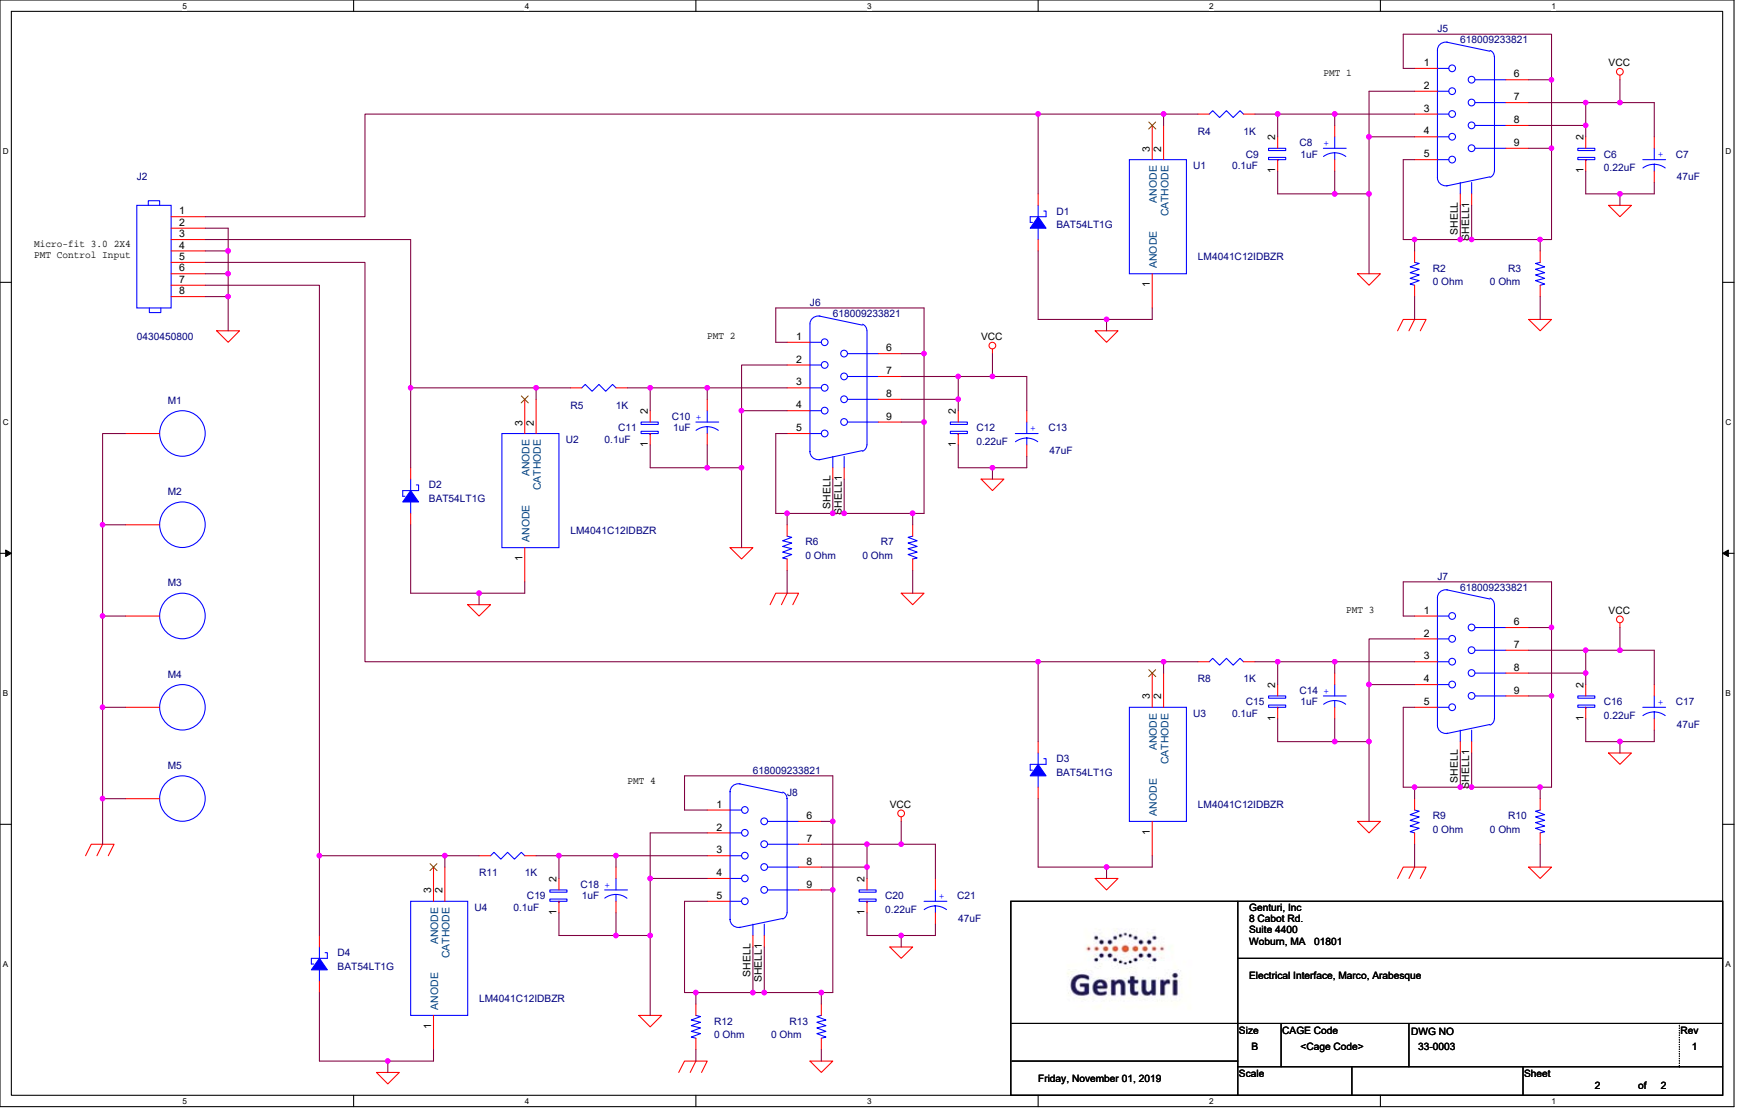
[picture p66: page 2]

Electrical Interface, Marco, Arabesque
