Genturi/NewAlphaElectrical/Simulations/JukkaRev2_Model1A(011720).asc

J1: pjf
R1: res; 20K
R2: res; 20K
R3: res; 10K
R4: res; 85Meg
R5: res; 10K
R6: res; 10K
U1: ADA4522
U2: ADA4522
V1: battery; +24; Rser=0.1
V2: battery; +24; Rser=0.1
V3: battery; 10
V4: battery; 10
Named nets: 0, Vcc, Vee, CmdVoltagePlus, CmdVoltageMinus, Current, StimulusVoltage
.tran 0 1 .001
