Genturi/NewAlphaElectrical/Simulations/JukkaRev2_Model2A(012220).asc

R1: res; 10K
R2: res; 10K
R3: res; 10K
R4: res; 85Meg
U2: ADA4522-1
V1: battery; +27.5; Rser=0.1
V2: battery; +27.5; Rser=0.1
V3: battery; 10
V4: battery; 10
Named nets: 0, Vcc, Vee, CmdVoltagePlus, CmdVoltageMinus, StimulusVoltage, OH, OL
.tran 0 1 .001
