Genturi/NewAlphaElectrical/Simulations/JukkaRev2_Model2A(020720).asc

C1: cap; 1µ
C2: cap; 1µ
C3: cap; 1µ
C4: cap; 1µ
R1: res; 1.96K
R2: res; 1.4K
R3: res; 10K
R4: res; 85Meg
R5: res; 1.96K
R6: res; 1.4K
R7: res; 10K
R8: res; 1K
R9: res; 5K
R10: res; 5K
R11: res; 1K
R12: res; 1K
R13: res; 5K
R14: res; 5K
R15: res; 1K
R16: res; 15.8K
R17: res; 15.8K
R18: res; 15.8K
R19: res; 15.8K
U1: ADA4522-1
U2: ADA4522-1
U3: ADA4522-1
U4: ADA4522-1
U5: ADA4522-1
U6: ADA4522-1
U7: ADA4522-1
U8: ADA4522-1
U9: ADA4177-1
U10: ADA4177-1
V1: battery; +26.1; Rser=0.1
V2: battery; +26.15; Rser=0.1
V3: battery; 10
V4: battery; 10; Rser=0
V5: battery; +6.65; Rser=0.1
V6: battery; +6.65; Rser=0.1
Named nets: 0, Vcc, Vee, CmdVoltagePlus, CmdVoltageMinus, StimulusVoltage, OutPlus, OutMinus, Vrr, Vqq
.op 0 1 .001 startup
