Genturi/NewAlphaElectrical/Simulations/JukkaRev2_Model2B(012220).asc

R1: res; 2K
R2: res; 2K
R3: res; 10K
R4: res; 85Meg
U1: ADA4522-1
U2: ADA4522-1
U4: ADA4522-1
V1: battery; +27.5; Rser=0
V2: battery; +27.5; Rser=0
V3: battery; 10
V4: battery; 10
Named nets: 0, Vcc, Vee, CmdVoltagePlus, CmdVoltageMinus, StimulusVoltage, OutHigh, OutLow
.tran 0 1 .001
