Genturi/NewAlphaElectrical/Simulations/JukkaRev2_Model2C(012220).asc

R1: res; 2K
R2: res; 2K
R3: res; 10K
R4: res; 85Meg
R8: res; 1K
R9: res; 5K
R10: res; 5K
R11: res; 1K
U1: ADA4522-1
U2: ADA4522-1
U3: ADA4522-1
U4: ADA4522-1
V1: battery; +24; Rser=0.1
V2: battery; +24; Rser=0.1
V3: battery; 10
V4: battery; 10
Named nets: 0, Vcc, Vee, CmdVoltagePlus, CmdVoltageMinus, StimulusVoltage, Out
.tran 0 1 .001
