Genturi/NewAlphaElectrical/Simulations/JukkaRev2_Model2D(012220).asc

R1: res; 2K
R2: res; 2K
R3: res; 10K
R4: res; 85Meg
R5: res; 2K
R6: res; 2K
R7: res; 10K
R8: res; 1K
R9: res; 5K
R10: res; 5K
R11: res; 1K
R12: res; 1K
R13: res; 5K
R14: res; 5K
R15: res; 1K
U1: ADA4522-1
U2: ADA4522-1
U3: ADA4522-1
U4: ADA4522-1
U5: ADA4522-1
U6: ADA4522-1
U7: ADA4522-1
U8: ADA4522-1
V1: battery; +27.5; Rser=0.1
V2: battery; +27.5; Rser=0.1
V3: battery; 12.5
V4: battery; 12.5
Named nets: 0, Vcc, Vee, CmdVoltagePlus, CmdVoltageMinus, StimulusVoltage, OutPlus, OutMinus
.tran 0 1 .001
