Genturi/NewAlphaElectrical/Simulations/JukkaRev2_Model2F(012220).asc

C1: polcap; 5.6µ; V=63 Irms=370m Rser=0.38 Lser=0
C2: cap; 0.1µ
C3: polcap; 5.6µ; V=63 Irms=370m Rser=0.38 Lser=0
C4: polcap; 5.6µ; V=63 Irms=370m Rser=0.38 Lser=0
C5: polcap; 5.6µ; V=63 Irms=370m Rser=0.38 Lser=0
C6: cap; .018µ
R1: res; 2K
R2: res; 2K
R3: res; 10K
R4: res; 85Meg
R5: res; 2K
R6: res; 2K
R7: res; 10K
R8: res; 1K
R9: res; 5K
R10: res; 5K
R11: res; 1K
R12: res; 1K
R13: res; 5K
R14: res; 5K
R15: res; 1K
R16: res; 10K
R17: res; 10K
R18: res; 10K
R19: res; 10K
R20: res; 523K
R22: res; 2.61Meg
U1: ADA4522-1
U2: ADA4522-1
U3: ADA4522-1
U4: ADA4522-1
U5: ADA4522-1
U6: ADA4522-1
U7: ADA4522-1
U8: ADA4522-1
U9: LT3090
U10: LT3080-1
V1: battery; 27.6
V2: battery; 27.6
V3: battery; 2
V4: battery; 2
Named nets: 0, Plus27p6, Minus27p6, Vcc, CmdVoltagePlus, CmdVoltageMinus, Vee, OutPlus, OutMinus
.tran 0 2 0 startup
