Genturi/NewAlphaElectrical/Simulations/JukkaRev2_VReg1A(012720).asc

C1: polcap; 56µ; V=63 Irms=370m Rser=0.38 Lser=0 mfg="Panasonic" pn="ECA1JFQ560" type="Al electrolytic"
C2: cap; 0.1µ
C3: polcap; 56µ; V=63 Irms=370m Rser=0.38 Lser=0 mfg="Panasonic" pn="ECA1JFQ560" type="Al electrolytic"
R1: res; 5K
R20: res; 523
U9: LT3090
V1: battery; +27.5; Rser=0.1
V2: battery; +27.6; Rser=0.1
V3: battery; 5
V4: battery; 5
Named nets: 0, Vcc, Minus27p6, CmdVoltagePlus, CmdVoltageMinus, Vee
.tran 1
