Genturi/NewAlphaElectrical/Simulations/JukkaRev2_VReg1B(012720).asc

C1: polcap; 10µ; V=63 Irms=370m Rser=0.38 Lser=0
C2: cap; .1µ
C3: polcap; 5.6µ; V=63 Irms=370m Rser=0.38 Lser=0
C4: polcap; 56µ; V=63 Irms=370m Rser=0.38 Lser=0 mfg="Panasonic" pn="ECA1JFQ560" type="Al electrolytic"
C5: polcap; 5.6µ; V=63 Irms=370m Rser=0.38 Lser=0
C6: cap; .018µ
C7: polcap; 56µ; V=63 Irms=370m Rser=0.38 Lser=0
C8: polcap; 5.6µ; V=63 Irms=370m Rser=0.38 Lser=0
C9: polcap; 56µ; V=63 Irms=370m Rser=0.38 Lser=0 mfg="Panasonic" pn="ECA1JFQ560" type="Al electrolytic"
C10: polcap; 5.6µ; V=63 Irms=370m Rser=0.38 Lser=0
C11: cap; .1µ
C12: cap; .018µ
R1: res; 5K
R2: res; 523K
R3: res; 5K
R4: res; 2.61Meg
R5: res; 5K
R20: res; 523K
R21: res; 5K
R22: res; 2.61Meg
U1: LT3090
U2: LT3080-1
U9: LT3090
U10: LT3080-1
V1: battery; 27.6
V2: battery; 27.6
Named nets: 0, Plus27p6, Minus27p6, Vee, Vcc
.tran 0 1 .000 startup
.tran 0 1 .000 startup
