Genturi/NewAlphaElectrical/Simulations/JukkaRev2_VReg2A(012720).asc

C1: polcap; 10µ; V=63 Irms=370m Rser=0.38 Lser=0
C2: cap; .1µ
C3: polcap; 10µ; V=63 Irms=370m Rser=0.38 Lser=0
C4: polcap; 10µ; V=63 Irms=370m Rser=0.38 Lser=0
C5: polcap; 10µ; V=63 Irms=370m Rser=0.38 Lser=0
C6: cap; .018µ
C7: polcap; 10µ; V=63 Irms=370m Rser=0.38 Lser=0
C8: polcap; 10µ; V=63 Irms=370m Rser=0.38 Lser=0
C9: polcap; 10µ; V=63 Irms=370m Rser=0.38 Lser=0
C10: polcap; 10µ; V=63 Irms=370m Rser=0.38 Lser=0
C11: cap; .39µ
C12: cap; .068µ
R1: res; 10K
R2: res; 133K
R3: res; 10K
R4: res; 665k
R5: res; 5K
R20: res; 523K
R21: res; 10K
R22: res; 2.61Meg
U1: LT3090
U2: LT3080-1
U9: LT3090
U10: LT3080-1
V1: battery; 27.6
V2: battery; 27.6
Named nets: 0, Plus27p6, Minus27p6, Vee1, Vcc1, Vee2, Vcc2
.op 0 1 .000 startup
