Genturi/NewAlphaElectrical/(list of files, drawings)

Other design files:
CartridgeBiasInterconnect(Nightquest 30-0009)/Schematic/33-0009(NIGHTQUEST)R1.DSN
CartridgeBiasInterconnect(Nightquest 30-0009)/Schematic/33-0009(nightquest)r1.opj
CartridgeBiasInterconnect(Nightquest 30-0009)/Schematic/FirstCheckPlots(020720)/31-0009 Rev 1_check.pcb
CartridgeInterface(Stargazers 30-0001)/Revision1/PCB/34-0001 Rev 1_pcb/31-0001 Rev 1.pcb
CartridgeInterface(Stargazers 30-0001)/Revision1/STARGAZERS.DSN
CartridgeInterface(Stargazers 30-0001)/Revision1/stargazers.opj
CartridgeInterface(Stargazers 30-0001)/Revision2/FirstCheckPlots(020720)/31-0001 Rev 2_check.pcb
CartridgeInterface(Stargazers 30-0001)/Revision2/STARGAZERS.DSN
CartridgeInterface(Stargazers 30-0001)/Revision2/stargazers.opj
EmppuInterface(Moondance 30-0006)/PCB/FinalFiles/31-0006 Rev 1_pcb/31-0006 Rev 1.pcb
EmppuInterface(Moondance 30-0006)/PCB/FirstPlacement/31-0006_placement.pcb
JukkaInterface(Alpenglow 30-0005)/PCB/FinalFiles/31-0005 Rev 1_pcb/31-0005 Rev 1.pcb
JukkaInterface(Alpenglow 30-0005)/PCB/FirstPlacement/31-0005_placement.pcb
JukkaInterface(Alpenglow 30-0005)/PCB/RoutingCheck/31-0005 Rev 1_routing.pcb
JukkaInterface(Alpenglow 30-0005)/Schematic/ALPENGLOW.DSN
JukkaInterface(Alpenglow 30-0005)/Schematic/Alpenglow.opj
MarcoInterface(Arabesque 30-0003)/PCB/1stPlacement(112219)/31-0003 Rev 1_placement/31-0003 Rev 1.pcb
MarcoInterface(Arabesque 30-0003)/PCB/RoutingCheck(112619)/31-0003 Rev 1_routing.pcb
MarcoInterface(Arabesque 30-0003)/Schematic/ARABESQUE.DSN
MarcoInterface(Arabesque 30-0003)/Schematic/Arabesque.opj
MotorInterface(Riddler 30-0004)/PCB/FinalFiles/31-0004 Rev 1_pcb/31-0004 Rev 1.pcb
MotorInterface(Riddler 30-0004)/PCB/FirstPlacement(112219)/31-0004 Rev 1_placement/31-0004 Rev 1.pcb
MotorInterface(Riddler 30-0004)/PCB/RoutingCheck(112619)/31-0004 Rev 1_routing.pcb
MotorInterface(Riddler 30-0004)/Schematic/MOTORINTERFACEBOARD(RIDDLER).DSN
MotorInterface(Riddler 30-0004)/Schematic/MotorInterfaceBoard(Riddler).opj
PCB/FinalFiles/31-0002 Rev 1_pcb/31-0002 Rev 1.pcb
PCB/FirstPlacement/31-0002 Rev 1_placement/31-0002 Rev 1_placement.pcb
Schematic/30-0008(AMARANTH).DSN
Schematic/30-0008(Amaranth).opj
Schematic/GHOST-RIVER.DSN
Schematic/Ghost-River.opj
Schematic/PackageForMassDesign/1stPlacement/31-0008_placement.pcb
TroyInterface(Scaretale 30-0007)/PCB/FirstPlacement/31-0007_placement.pcb
TroyInterface(Scaretale 30-0007)/PCB/RoutingCheck/31-0007 Rev 1_routing.pcb
TroyInterface(Scaretale 30-0007)/Schematic/33-0007(SCARETALE).DSN
TroyInterface(Scaretale 30-0007)/Schematic/33-0007(Scaretale).opj
